khw1566/ARD/docs/3d-models.md

# ARD 3D 모델 자료 안내

[프로젝트 소개로 돌아가기](../README.md)

## 먼저 열 자료

- **조립·형상 확인:** [ARD_Model_v2.stl](<../영상제작용 CAD파일/ARD_Model_v2.stl>)
- **Inventor 편집:** [ARD_Model_v2.iam](../ARD_Model_v2.iam), 관련 부품은 [ARD_hardware](../ARD_hardware)에 보관
- **전체 조립 이미지:** [완전 조립품](<../영상제작용 CAD파일/완전 조립품.png>)
- **기구학 설명:** [README의 3D 모델링과 기계 구조](../README.md#3d-모델링과-기계-구조)

STL의 단위는 사용자가 확인한 **mm**입니다. STL에는 단위 메타데이터가 없으므로 가져오기 설정에서 mm를 지정합니다. 전체 조립 STL은 391,246개 삼각형으로 이루어지며 좌표축별 외곽 크기는 약 502.47 × 440.00 × 594.50 mm입니다.

`.iam`은 Inventor 조립체이며 참조하는 `.ipt`·하위 `.iam`이 필요할 수 있습니다. 현재 자료는 독립 실행이 보장된 Pack and Go 패키지가 아니므로 참조 누락 시 저장소 안의 부품 경로를 지정합니다. STL은 형상 교환용 메쉬로, 원래의 피처 이력·조립 구속조건·재질 정보를 모두 보존하지 않습니다.

## 전체 구조와 레일

| 파일 | 확인할 내용 |
|---|---|
| [전체 조립 STL](<../영상제작용 CAD파일/ARD_Model_v2.stl>) | 카메라 지지대·플레이트·구동부·레일·분류함 배치 |
| [박스 제거](<../영상제작용 CAD파일/박스제거.stl>) | 분류함을 제외한 기계 구조 |
| [비전캠 제거 모델](<../영상제작용 CAD파일/비전캠 제거 모델.stl>) | 카메라 구조를 제외한 분류장치 |
| [비전 캠 장치](<../영상제작용 CAD파일/비전 캠 장치.stl>) | 카메라 측 별도 구조 |
| [상부 이송 구조](<../영상제작용 CAD파일/상부이송구조.stl>) | 레일 위에서 이동하는 분류 구조 |
| [하부 이송 구조](<../영상제작용 CAD파일/하부이송구조.stl>) | 하부 레일·지지 구조 |
| [베벨기어 구조 제외 모델](<../영상제작용 CAD파일/베벨기어 구조가 제거된 나머지 부분들.stl>) | 중앙 차동 구동부 주변 구조 |

## 차동 베벨기어

| 파일 | 확인할 내용 |
|---|---|
| [베벨기어 조립체](<../영상제작용 CAD파일/베벨기어 조립체.stl>) | 중앙 기어의 조립 관계 |
| [베벨기어만](<../영상제작용 CAD파일/베벨기어만.stl>) | 기어 구조 형상 |
| [베벨기어와 플레이트](<../영상제작용 CAD파일/베벨 기어 및 플레이트.stl>) | 출력 기어와 플레이트의 연결 |
| [구동축·베벨기어·접시](<../영상제작용 CAD파일/구동축 베벨기어와 접시만.stl>) | 축에서 플레이트까지의 형상 |
| [중심 십자 조인트](<../영상제작용 CAD파일/베벨기어 중심 십자조인.stl>) | 기울임을 따르는 중앙 지지부 |
| [양측 베벨기어](<../영상제작용 CAD파일/양측 베벨기어만.stl>) | 마주 보는 두 입력 기어 |
| [A측 베벨기어](<../영상제작용 CAD파일/한방향 베벨기어만(A).stl>) | 입력 A측 형상 |
| [B측 베벨기어](<../영상제작용 CAD파일/한방향 베벨기어만(B).stl>) | 입력 B측 형상 |
| [단일 베벨기어](<../영상제작용 CAD파일/단일 베벨기어.stl>) | 개별 기어 형상 |
| [상단부](<../영상제작용 CAD파일/베벨기어 상단부.stl>) | 상부 기어 형상 |
| [하단부](<../영상제작용 CAD파일/베벨기어 하단부.stl>) | 하부 기어 형상 |

기구학 리그는 십자 조인트가 캐리어의 기울임을 따르고, 플레이트 출력부는 그 안에서 별도로 선회하도록 구성했습니다. 메쉬를 합쳐 볼 때는 이 부품들의 원래 좌표를 유지해야 조립 위치가 맞습니다. 서로 겹치는 범위의 내보내기 파일도 있으므로 모든 STL을 동시에 불러오면 중복 형상이 생길 수 있습니다.

## 유성감속기

| 파일 | 확인할 내용 |
|---|---|
| [유성기어 감속기](<../영상제작용 CAD파일/유성기어 감속기.stl>) | 감속기 전체 형상 |
| [커버·베어링 제거](<../영상제작용 CAD파일/커버와 베어링이 제거된 감속기.stl>) | 내부 기어와 캐리어 배치 |
| [조립품에서 가져온 감속기](<../영상제작용 CAD파일/조립품에서 가져온 원점유지 감속기.stl>) | 전체 조립 좌표를 유지한 감속기 |

잇수 16/16/48, 링 고정·태양 입력·캐리어 출력에서 감속비는 4:1입니다. STL 자체에는 운동 관계가 들어 있지 않습니다. 브라우저 시각화의 운동 계산은 [planetary_rig.js](../output/ard-cg/planetary_rig.js)와 [differential_rig.js](../output/ard-cg/differential_rig.js)에 분리돼 있습니다.

## 도면 이미지와 단면

| 자료 | 용도 |
|---|---|
| [평면도](<../영상제작용 CAD파일/평면도.png>) | 레일과 분류함 배치 확인 |
| [좌측면도](<../영상제작용 CAD파일/좌측면도.png>) | 측면 높이·구조 확인 |
| [조립품 측면도](<../영상제작용 CAD파일/조립품 측면도.png>) | 전체 측면 배치 |
| [측면 상세](<../영상제작용 CAD파일/조립품 측면도 상세.png>) | 양측 감속기와 중앙 조인트 확인 |
| [전도 자세](<../영상제작용 CAD파일/전도 과정 작동모습.png>) | 플레이트 기울임 자세 확인 |
| [CAD 기반 단면 시각화](../output/ard-cg/cinematic_section.jpg) | 감속기에서 차동부로 이어지는 전달 경로 |

브라우저에서 보는 방법은 [README의 실행 안내](../README.md#cad-기반-3d-시각화)를 따릅니다. CG의 색·단면·화살표는 설명을 위한 시각화이며 제조 도면의 재질·가공 지시가 아닙니다. 실제 제작 공차, 기어 접촉, 부품 간 간섭과 하중 검증은 별도 확인 대상입니다.
