khw1566/ARD/output/ard-cg/제작현황_기구학_추가자료.md

# AI기반 자동화 분류장치 — CG 제작 현황

2026-10-26. 사용자 지정 CAD는 `ARD_Model_v2.iam`이며, 제공 STL 단위는 mm로 확인됐다. CG 2분 15초를 먼저 제작한 뒤, 최신 요청으로 자기소개와 제공 실물 시연을 연결한 3분 발표 영상까지 출력했다.

## 결과물

- **최신 v2:** `final/ARD_FullPresentation_1080p_v2.mp4`, 180초·1080p/30fps. 재생: http://127.0.0.1:5187/review_v2.html . 화면 자막을 나레이션의 표기형 대본으로 통일하고 임베디드 자막은 제거했다. PC 모니터의 이메일·채팅 화면을 가리고 크레딧은 마무리에 한 번만 표시한다.
- 종이색 정보판·IBM Plex 서체로 개편하고 영어 키커·페이지 카운터·진행 바·리더선을 제거했다. 레일 30mm 이송 → 선회 → 기울임 → 중립 → 레일 복귀를 분리했다. 기존의 4:1 감속비와 차동 관계는 보존했다. 자세한 기록은 `HANDOFF.md` 상단과 `results/261026_발표영상_v2_피드백반영.md`를 읽는다.

- 새 미리보기: http://127.0.0.1:5187/cinematic.html
- 유성기어 자전·공전: http://127.0.0.1:5187/cinematic.html?t=38&still=1
- 차동 기어 확대: http://127.0.0.1:5187/cinematic.html?t=68&still=1
- 135초·15장면 CG 타임라인. 감속기 설명은 27–57초의 30초다. myTTS 합성 목소리·BGM·효과음이 들어간 `final/ARD_CG_MyVoice_1080p.mp4`를 별도 보존한다. CG 실제 음성 대본은 `CG_개인TTS대본_v4.txt`다.
- 최신 전체 결과: `final/ARD_FullPresentation_1080p.mp4`, 180초·1080p·30fps. 소개 13초, 기존 CG 8–129초 구간 121초, 보정 실물 42.267초, 마무리 3.733초다. 재생 페이지는 http://127.0.0.1:5187/review_full.html 이다.
- 실물만의 결과: `final/ARD_LiveDemo_Stabilized_1080p.mp4`, 약 42.3초. 자막은 손·터치 화면·중앙 기어를 가리지 않는 상단에 표시했다. 소개 및 실물 설명은 같은 로컬 myTTS 모델로 추가 합성했다.
- 흔들림 보정은 FFmpeg vidstab 2회 처리와 고정 확대 약 1.8%를 적용했다. 고정 배경 추적에서 좌우 이동 경로의 미세 흔들림 RMS는 약 49.9% 감소했다. 회전 흔들림은 비슷한 수준으로 남아 있으므로 완전한 고정 시점으로 설명하지 않는다.
- 두 완성본 모두 전체 디코딩, 프레임 수, 해상도, 음량, 한국어 자막 시간, 원본 해시 검사를 통과했다. `final/presentation_quality_report.json`에 수치를 보존한다. 원본 영상은 변경하지 않았다. 자세한 편집 기록은 `results/261026_실물영상_보정_자기소개_통합.md`를 읽는다.
- 완성 영상 재생: http://127.0.0.1:5187/review.html
- 장면 선택 메뉴로 각 장면의 설명 자세를 확인할 수 있다. 재생하면 각 입력각과 출력 자세가 시간에 따라 변한다.
- 원본 CAD·STL·펌웨어는 수정하지 않았다. 별도의 미리보기용 메쉬와 코드를 `output/ard-cg`에 작성했다.
- 빌드·펌웨어 실행 없이 STL 분석, 일반 JavaScript와 브라우저 렌더링으로 작업했다.

## 이번 스타일 수정

### 2026-10-26 후속: 중앙 십자 조인트 분리

사용자가 십자 조인트까지 출력부와 통으로 회전하는 문제를 제보했다. 새로 제공된 `베벨기어 중심 십자조인.stl`, `베벨기어 상단부.stl`, `베벨기어 하단부.stl`을 기존 조립체의 면과 정확히 대조해 중앙 조인트·상부 출력·하부 기어를 분리했다. 연결된 메쉬 섬의 위치만으로 구동 부품을 추정하던 방식은 사용하지 않는다.

- 중앙 십자 조인트: 4,646면. 캐리어에 고정되어 `R_X(φ)` 기울임만 따른다.
- 상부 출력: 21,102면. 캐리어 안에서 `R_Y(ψ)` 선회하며 플레이트도 함께 선회한다.
- 하부 기어: 21,102면. 캐리어 안에서 `R_Y(-ψ)`로 회전한다.
- A/B 입력: 각 21,904면. 기존 조립체의 입력축 면을 유지한다. 별도 A/B STL은 치형의 초기 위상이 달라 직접 섞지 않는다.
- 다섯 부품의 합은 기존 조립체 90,658면 전체와 일치하며 중복 면은 없다. 원본 CAD/STL을 수정하지 않았다.

구조는 `root → carrier(기울임) → cross / output(선회) → plate`이며, `bottom`도 carrier의 자식이다. `differential_rig.js`를 실제 장면과 Node 검사에서 함께 사용한다. 검사 명령은 `node output/ard-cg/verify_differential.cjs`이며 C/C++ 컴파일이나 앱 빌드를 하지 않는다. 유성감속기의 감속비는 아래 후속 답변으로 확인됐으며, 베벨 축 부호·기어 접촉에 관한 미확정 사항은 유지한다.

### 2026-10-26 후속: 유성감속 설명과 카메라 개편

사용자가 태양기어 16 / 행성기어 16 / 링기어 48, 링 고정, 태양 입력, 캐리어 출력을 직접 확인했다. 감속비는 `i = 1 + 48/16 = 4`다. 기존 감속기 단일 정적 메쉬를 실제 CAD의 12개 역할 묶음으로 분리하고, 태양기어·행성기어 자전·캐리어 공전을 각자 구동한다. 원본 80,230면의 좌표·면과 초기 치형 위상은 보존한다.

- 27–34초: 부품 분해 사선 구도, 색상·지시선으로 고정/입력/출력 식별.
- 34–43초: 축 정면 고정 구도, 자전 표시점과 공전 궤적으로 두 운동 구분.
- 43–51초: 같은 정면 구도에서 입력·출력 회전수와 바늘을 함께 비교.
- 51–57초: 사선 출력축 구도로 전환하고 입력 4.00회전·출력 1.00회전 및 감속식 표시.
- A/B 단독은 같은 고정 시점, 선회는 상부 고정 시점, 기울임은 낮은 측면 고정 시점으로 변경했다. 도입부 크레인, 시스템/레일 트래킹, 복합 입력의 짧은 사선 이동을 구분하고 반복적인 장면별 후진 줌을 없앴다.
- 시스템 역할·동력 경로·십자 조인트·분류 순서를 별도 보조 패널과 단계 강조로 보강했다. 점·궤적·캐리어 연결선은 설명용 오버레이다.

`node output/ard-cg/verify_planetary.cjs`는 실제 STL 면 보존과 10개 운동 사례, 15개 장면에 걸친 541개 시간 표본의 유한한 카메라·자세 값을 검사한다. 이 시간 표본 검사는 렌더링 프레임 검사가 아니다. 브라우저에서는 15개 장면의 대표 시점을 별도로 확인했다. 실제 치합·백래시·효율·하중은 미검증이다.

사용자는 Blue Paw Print에서 배경·재질·단면 표현을 참고하되 그대로 따라 하지 말라고 지정했다. 참고 채널과 `Inside the King Tiger`의 공개 재생 화면을 확인했다. 이번 구성은 장치에 맞춘 별도의 스튜디오 배경, 조명, 금속·수지 재질과 입력축 색상 체계를 사용한다. 참고 영상의 모델·텍스처·로고·음원은 가져오지 않았다.

- 밝은 문서형 화면을 대신해 깊이가 보이는 스튜디오 바닥·배경과 따뜻한 주광·차가운 보조광을 적용했다.
- 브러시드 금속, 수지 표면의 절차적 질감, 표면 반사와 그림자를 추가했다.
- STL 곡면의 음영을 보완하되 기어 치형과 테두리의 날카로운 경계는 유지했다. 실제 삼각형의 위치·크기는 바꾸지 않았다.
- 외피 단면으로 감속기·차동 기어를 드러내고, 기어 맞물림을 확대하는 구도로 전환한다.
- 외피를 절단한 면에는 별도의 단면 해칭을 적용한다. 내부 기어는 절단하지 않아 입력·출력의 맞물림을 계속 볼 수 있다.
- 모터 A 입력 계열은 황동색, B 입력 계열은 청색으로 구분한다. 설명을 위한 색상이며 실물 재질·색상의 측정 결과는 아니다.
- 기어 상세 설명 때에는 접시를 숨겼다가 카메라를 뒤로 빼며 다시 표시한다. 내부 전달과 최종 자세를 이어서 볼 수 있다.
- 원형 접시는 회전해도 외형이 같아 보일 수 있어, 확대 장면에 선회 방향을 보여주는 설명용 화살표를 겹쳐 표시한다. CAD에 실제 부품을 추가한 것은 아니다.

## 새 CG 구성

| 시간 | 장면 | 설명 |
|---|---|---|
| 0:00–0:08 | 전체 장치 | 크레인 구도, 장치 도입 |
| 0:08–0:17 | 시스템 역할 | 카메라 → PC 분석 → DriveMCU → 모터 |
| 0:17–0:27 | 외피 단면 | 고정 사선 시점에서 전달 경로 노출 |
| 0:27–0:34 | 감속기 네 요소 | 분해도, 입력·고정·출력 구분 |
| 0:34–0:43 | 자전과 공전 | 정면 고정, 표시점과 공전 궤적 |
| 0:43–0:51 | 입력·출력 비교 | 바늘과 회전수 계기로 4:1 비교 |
| 0:51–0:57 | 감속비 | 입력 네 바퀴·출력 한 바퀴, 감속식 |
| 0:57–1:04 | 차동 기구 확대 | 십자 조인트와 출력축의 역할 |
| 1:04–1:13 | A만 구동 | 동일한 고정 시점에서 선회·기울임 확인 |
| 1:13–1:22 | B만 구동 | A 단독과 같은 고정 시점에서 부호 비교 |
| 1:22–1:32 | 같은 입력 | 상부 시점에서 선회 확인 |
| 1:32–1:42 | 반대 입력 | 낮은 측면 시점에서 기울임 확인 |
| 1:42–1:55 | 복합 입력 | 목표 자세에서 입력각 계산 |
| 1:55–2:09 | 레일과 선별 순서 | 이송·선회·전도·복귀 |
| 2:09–2:15 | 전체 장치 복귀 | 실제 시연에 이어 붙일 전환 장면 |

## 기구학 모델의 정의

현재 PC 코드의 `gearAngleX = yawAngle + rollAngle`, `gearAngleY = yawAngle - rollAngle` 관계와 CAD의 마주 보는 입력축 구조를 기준으로 한다.

- `θA`, `θB`: 모터 각도. 실물 축의 양의 방향을 확인해 같은 제어 기준으로 정규화한다.
- `iA`, `iB`: 각 감속기의 입력각/출력각 비.
- `a = θA / iA`, `b = θB / iB`: 감속 후 베벨 입력축의 정규화된 각도.
- `ψ`: 플레이트의 자기 축 주위 선회각.
- `φ`: 공통 입력축 주위 기울임각.

동일한 베벨기어비를 갖는 이상적인 기구 모델은 다음과 같다.

```text
ψ = (a + b) / 2
φ = (a - b) / 2

역기구학:
a = ψ + φ
b = ψ - φ

모터 목표각:
θA = iA × (ψ + φ)
θB = iB × (ψ - φ)
```

| 정규화된 입력 | 출력 |
|---|---|
| a=q, b=0 | ψ=q/2, φ=q/2 |
| a=0, b=q | ψ=q/2, φ=-q/2 |
| a=q, b=q | ψ=q, φ=0 |
| a=q, b=-q | ψ=0, φ=q |

두 모터는 마주 보므로 각 모터를 정면에서 보았을 때의 시계·반시계 방향을 단순히 ‘같은 방향’이라고 부르지 않는다. 영상의 A/B 입력은 정규화된 제어 부호를 뜻한다. 현재 CG의 고정 좌표 X는 입력축, Y는 중립 상태의 출력축이다. 출력 자세는 입력축 기울임 뒤 출력축 자체 선회를 표현하는 `R_X(φ) R_Y(ψ)`로 구성했다.

시각화는 강체·동일 베벨기어비·이상적인 전달을 가정한다. 유성감속기의 4:1 구성은 사용자 확인값이며, 실제 설치된 베벨 축 부호, 치형의 접촉·백래시·하중·탈조는 이번 미리보기로 검증하지 않았다. 애니메이션의 예시 각도를 실제 운전 범위나 측정 성능으로 주장하지 않는다.

## 첨부 자료 확인과 활용

- 전체 조립품·박스 제거·비전캠 제거·상하부 이송부 STL을 확인했다.
- 추가된 `한방향 베벨기어만(A).stl`, `한방향 베벨기어만(B).stl`, `양측 베벨기어만.stl`, `구동축 베벨기어와 접시만.stl`로 입력·출력 부품의 역할을 확인했다.
- 기존 전체 조립 상태와 좌표·면이 일치하는 메쉬를 분리해 A/B 입력, 출력축·중앙 연결부, 반대편 기어, 접시를 각각 구동한다. 별도 내보내기 사이에 미세한 자세 차이가 있어 한 조립 상태의 면 집합을 기준으로 맞췄다.
- `조립품에서 가져온 원점유지 감속기.stl`이 추가된 것을 확인했다. 별도 유성기어 감속기 파일은 원점이 달라 전체 조립체에 그대로 중복 배치하지 않는다.
- 감속기 참고 영상 두 개와 `리니어 스크류 구동.mp4`의 재생 정보와 프레임을 확인했다. 이들은 구조 참고 자료이며 완성 영상에 그대로 삽입한 촬영본은 아니다.
- 상세 목록·경계 좌표·파일 유효성은 `cad_inventory.json`, 영상 정보는 `video_inventory.json`에 기록했다.

## 추가로 필요한 정보

추가 CAD는 지금 바로 필요하지 않다. 다음 정보가 있으면 기구학 설명의 실제 축 부호·수치를 확정할 수 있다.

1. **모터 방향 확인:** A만 양의 명령, B만 양의 명령, 두 축 같은 부호, 두 축 반대 부호일 때 플레이트가 움직이는 방향. 짧은 CAD 구동 영상이나 화살표를 그린 그림으로도 충분하다.
2. **베벨기어비:** 유성감속기의 잇수 16/16/48과 4:1 구성은 확인 완료. 차동 베벨기어의 잇수·기어비와 각 축 설치 부호는 추가 확인 대상이다.
3. **개인 TTS:** 로컬 myTTS 모델로 15컷의 합성과 음량·길이 맞춤을 완료했다. 발음과 편집 수정 시 최신 v4 대본 및 `narration/manifest.json`을 기준으로 한다.

## 설치된 제작 스킬

- `remotion-best-practices`: Remotion 제작사 공식 스킬. https://github.com/remotion-dev/skills
- `3dmodel`: 3D 메쉬·재질·분해도·단면·화면 검수를 위한 스킬. https://github.com/fletcherholt/3dmodel-skill

설치 경로와 확인 해시는 `skill_install_manifest.json`에 있다. 이번 미리보기는 프로젝트의 빌드 금지 지침을 지키기 위해 별도 앱 빌드가 필요 없는 JavaScript로 구성했다.

## 로컬 미리보기 다시 열기

서버가 종료된 경우 프로젝트 폴더에서 다음 명령으로 미리보기를 열 수 있다. 이 명령은 빌드나 장치 제어를 하지 않는다.

```powershell
python output/ard-cg/prepare_cad.py
python output/ard-cg/serve.py
```

주소: http://127.0.0.1:5187/cinematic.html

참고 원본: https://www.youtube.com/@BluePawPrint / https://www.youtube.com/watch?v=vCgdYHatDqw
