khw1566/ARD/results/260914_AwardWinning_Comparison_Report.md

# 작년 수상작 심층 분석 및 중간보고서 개선 전략 비교 보고서
작성일자: 2026-09-14
작성자: 김형우

## 1. 개요 및 분석 배경
대한기계학회 전국학생설계경진대회 최종보고서 작성을 위해, 전년도(제15회) 대학부 주요 수상작 3편의 구성 및 서술 방식을 정밀 분석하였다. 이를 현행 작성된 중간보고서(`중간보고서_울과대 그린머신_김형우.pdf`)와 비교하여 최종보고서 양식(규격) 충족 여부, 기술적 완성도, 정량적 데이터 검증 측면에서의 개선점을 도출하였다.

## 2. 작년 수상작 3편의 핵심 특징 분석

### 2.1 수상작 기본 개요
- **대학-01 (30쪽)**: `3D 프린팅 서포트 감축을 위한 다층적 지지 시스템`
  - 특징: 래칫(Ratchet) 메커니즘 기반 기구학적 설계와 Fusion 360 타당성 평가, 서포트 절감량(%) 정량 비교.
- **대학-02 (57쪽)**: `그리핑-반전 메커니즘 기반 컵라면 용기 전처리 및 자동 분류 시스템`
  - 특징: 베벨 기어/유성 기어 유닛 기반 기구학적 수식 전개, 전단응력 계산 및 Ansys 구조 해석, 3단계 송풍 세척 정량 실험, 용기 크기별(Small/Middle/Big) 분류 테스트.
- **대학-03 (27쪽)**: `엣지 AI 기반 유아용 카시트 시스템 개발: 상지 이탈 감지 및 스마트 제어`
  - 특징: 선행 특허 정밀 비교표(Table), 로드셀 하네스 응력 해석(FEA), 경계조건($2828\text{ N}$) 기반 안전계수 도출, AI 모델 파이프라인(YuNet + MobileFaceNet) 학습 곡선 및 재현율($97\%$) 제시.

### 2.2 공통적으로 나타나는 수상작의 5대 핵심 강점
1. **철저한 선행 특허 및 기존 제품 조사 (Patent Survey & Differentiation)**:
   - 단순히 시장 상황을 언급하는 것에 그치지 않고, `특허 출원/등록 번호`, `기존 해결책의 물리적 한계`, `본 설계의 기술적 회피 및 독창성`을 표(Table)로 명확히 대조.
2. **이론적 기구학 수식 전개와 CAE 구조해석의 유기적 결합**:
   - 모터 선정 토크 수식($\tau_{req} \le \tau_{out}$), 전단응력 수식, 운동방정식 등 기계공학적 수식을 체계적으로 유도.
   - Ansys 또는 Fusion 360을 활용한 Von-Mises 응력 분포, 변위량(Deformation), 안전율(Safety Factor) 해석 데이터를 컬러 컨투어로 제시.
3. **정량적 실험 설계 및 성능 지표(KPI) 입증**:
   - 실험군과 대조군을 설정하고, 반복 측정 오차율, 분류 성공률, 반응 속도(ms)를 표와 그래프로 제시.
4. **엄격한 학술대회 규격 준수**:
   - 캡션 표기 원칙(모든 `Table`, `Figure` 캡션은 완전한 영문 작성).
   - 참고문헌 상첨자 인용($^{(1)}$, $^{(2\sim4)}$) 표기.
5. **경제성 및 상용화 타당성 분석**:
   - 시제품 제작 단가(BOM: Bill of Materials) 분석 및 기존 상용 장비 대비 원가 절감 효과 기술.

---

## 3. 현행 중간보고서 현황 및 한계점 분석

| 평가 항목 | 현행 중간보고서 수준 | 취약점 및 개선 필요 사항 |
| :--- | :--- | :--- |
| **분량 및 구조** | 총 21쪽 (본문 내용 압축적) | 수상작 대비 상세 기구 도면, 분해 조립도, 부품 리스트의 서술 비중 부족 |
| **선행 특허 분석** | 2개 상용 제품(Fig 1, 2) 단순 인용 | 키프리스(KIPRIS) 기반 유사 특허 번호 명시 및 세부 청구항 비교 분석 부재 |
| **기구학 및 구조해석** | 차동 베벨 기어 토크 기본 수식 기재 | 유한요소해석(FEA) 응력/변형 해석 데이터 부재, 기어 치형 접촉 강도 해석 미비 |
| **소프트웨어/AI 서술** | Gemini 멀티모달 개념적 설명 위주 | 실제 5개 MCU 분산 네트워크, UDP 분할 패킷 구조, Three.js 트윈 등 고도화된 기술 미반영 |
| **실험 및 검증** | 완성 시제품 사진 및 동작 결과 부재 | 크기/재질별(PET, 캔, 유리 등) 정량적 분류 성공률, 인식 지연시간(Latency) 데이터 부재 |
| **양식 규격 준수** | 일부 국문/영문 혼용 캡션 존재 | 최종보고서 필수 요건인 영문 캡션(Fig. / Table) 통일화 및 상첨자 인용 보완 필요 |

---

## 4. 최종보고서 작성을 위한 핵심 개선 전략

### 4.1 1단계: 선행 기술 및 특허 조사 보강 (설계핵심내용 2.1)
- 국내외 자동 분리수거 및 그리핑 특허 3~4건을 조사하여 `Table 1. Patent survey and technological differentiation` 작성.
- 기존 바코드/광학 센서 방식 대비 멀티모달 AI(Gemini)와 차동 턴테이블의 경제성/범용성 우위 부각.

### 4.2 2단계: 기구학 수식 전개 및 CAE 구조 해석 데이터 탑재 (설계핵심내용 2.2~2.3)
- **차동 베벨 기어 기구학 전개**:
  - 두 모터의 각속도($\omega_1, \omega_2$)에 따른 디스크의 합성 틸트 각속도($\dot{\theta}_{roll}$) 및 요 각속도($\dot{\theta}_{yaw}$) 수식화.
- **구조 안정성 유한요소해석(FEA)**:
  - 폐기물 최대 적재 하중($1.5\text{ kg}$) 조건에서 메인 프레임 및 베벨 기어 축의 최대 휨 응력과 안전율 도출.

### 4.3 3단계: 임베디드 분산 제어 및 3D 디지털 트윈 체계 전면 수록 (설계핵심내용 2.4)
- 요약파일에 정리된 5대 MCU(ImageSender, Drive, HMI, Control, Robot3Axis) 펌웨어 아키텍처와 TCP/UDP/SSE 통신 파이프라인 수록.
- Three.js WebGL 기반 디지털 트윈 텔레포테이션 기술을 수록하여 소프트웨어 완성도 극대화.

### 4.4 4단계: 정량적 실험 결과 및 토의 체계화 (3. 결과 및 토의)
- **객체 인식 및 분류 실험**:
  - 알루미늄 캔, 투명 페트, 찌그러진 캔, 종이 등 비정형 물체에 대한 인식 성공률($\%$) 및 추론 시간(ms) 데이터 표 수록.
- **위치 추적 및 제어 정밀도**:
  - A-GPS(AssistNow) 적용 전/후의 위성 수신 시간(TTFF) 비교 그래프(수 분 $\rightarrow$ 수십 초 단축).
- **제작 비용 및 경제성 분석**:
  - 시스템 제작 원가표(BOM) 및 상용 장비 대비 도입 비용 비교.

### 4.5 5단계: 양식 가이드라인 100% 준수
- 모든 그림/표 캡션을 완전한 영문 표기(`Fig. X. ...`, `Table X. ...`)로 전환.
- 본문 참고문헌 인용 표기 상첨자화($^{(1)}$, $^{(2\sim4)}$) 적용.
