khw1566/ARD/results/260914_Report_Execution_Plan.md

# 보고서 작성 종합 실행 계획서
작성일자: 2026-09-14
작성자: Antigravity

## 1. 개요
본 계획서는 경진대회 및 학술대회 제출용 최종 보고서 작성을 위해 수립된 8단계 순환 및 점검 프로세스 가이드라인입니다.

## 2. 세부 단계별 실행 계획

### 1단계: 내부 기술 자료 및 데이터 정리
- **목적:** 하드웨어, 제어 펌웨어, PC 관제 소프트웨어(Three.js 디지털 트윈 등)의 핵심 스펙과 구현 내용 취합
- **주요 작업:**
  - `대한기계학술회 보고서/요약파일/` 내 모듈별 기술 문서(펌웨어, 3축 제어, 3D 디지털 트윈 등) 데이터 검토 및 정량 수치 정리
  - 시스템 구성도 블록도, 회로도, 실측 계측 데이터 셋 확보

### 2단계: 보고서 공식 양식 및 기수상작 분석 학습
- **목적:** 평가 기준, 필수 목차, 수상작 서술 패턴 및 시각화 기법 벤치마킹
- **주요 작업:**
  - 대회 지정 서식(페이지 제한, 폰트, 여백 규정 등) 준수 항목 파악
  - 기존 기수상작 비교 보고서([260914_AwardWinning_Comparison_Report.md](file:///c:/Users/khw/Desktop/ARD_v1/results/260914_AwardWinning_Comparison_Report.md)) 내용 반영 및 논리 전개 패턴 차용

### 3단계: 특허 선행기술 조사 및 기술적 차별성 정리
- **목적:** 독창성 증명 및 선행 특허 대비 개선점 명확화
- **주요 작업:**
  - 기존 특허 분석 보고서([260914_Patent_Analysis_and_Differentiation.md](file:///c:/Users/khw/Desktop/ARD_v1/results/260914_Patent_Analysis_and_Differentiation.md)) 데이터 검증
  - 기존 특허들의 구조적/제어적 한계점 대비 본 프로젝트 시스템의 우위 요소(정밀도, 비용, 관제 효율성 등) 비교표 구체화

### 4단계: 보고서 목차 및 초안 프레임워크 작성
- **목적:** 보고서의 전체 뼈대 구성 및 시각화 배치 계획 수립
- **주요 작업:**
  - 대목차/중목차/소목차 구조 확정
  - 시각 자료 배치 레이아웃 정의 (회로도, 블록도, 3D 디지털 트윈 화면 캡처, 그래프, 실물 사진 등 위치 결정)
  - 본문 각 장별 핵심 서술 방향 가이드라인 수립

### 5단계: 세부 내용 작성(사용자) 및 실시간 피드백·교정(에이전트)
- **목적:** 초안 완성도 제고 및 논리적 완결성 확보
- **주요 작업:**
  - 사용자의 목차별 세부 내용 기술
  - 에이전트의 실시간 기술 검토: 문맥 매끄러움, 학술적/기술적 표현 교정, 용어 표준화, 논리적 비약 구간 보강 제시

### 6단계: 중간 점검 및 결손 데이터/자료 보완
- **목적:** 누락된 실험 결과치, 도면, 결함 데이터 파악 및 추가 작성
- **주요 작업:**
  - 정량적 성능 지표(오차율, 응답속도, 처리량 등) 누락 여부 확인
  - 추가 필요한 다이어그램 및 보충 설명 보완

### 7단계: 4단계 피드백 루프(목차 및 프레임워크 재조정)
- **목적:** 작성된 실 데이터를 바탕으로 전체 문서 흐름과 이미지 재배치
- **주요 작업:**
  - 서술 분량 밸런스 점검 및 목차/소제목 재편
  - 강조해야 할 핵심 성과와 도식의 위치 재최적화

### 8단계: 최종 점검 및 완성
- **목적:** 최종 제출용 문서 결함 제거 및 제출 형태 확정
- **주요 작업:**
  - 규격 준수 여부(페이지 수, 도표 캡션 번호, 참고문헌 양식 등) 확인
  - 오탈자, 단위 표기 오류, 정렬 상태 최종 검수
  - 최종본 산출물 패키징

## 3. 진행 현황 체크리스트
- [ ] 1. 자료 정리
- [ ] 2. 보고서 양식 및 작년 수상작 학습
- [ ] 3. 특허 관련 자료조사 및 비교점 정리
- [ ] 4. 보고서 목차 및 초안틀 작성(이미지 삽입 결정)
- [ ] 5. 보고서 세부작성(사용자) 및 피드백/교정(에이전트)
- [ ] 6. 점검 및 부족한 자료 작성
- [ ] 7. 목차/틀 재보완(루프)
- [ ] 8. 최종 점검 및 완성
