khw1566/ARD/AGENT_HANDOFF.md

# 에이전트 인수인계 — ARD 작업 환경 이전

작성일: 2026-10-26, 한국 시간 기준.

## 먼저 지킬 사항

1. 루트 `AGENTS.md`를 먼저 읽는다. **에이전트는 펌웨어·앱·시뮬레이터·C/C++ 호스트 테스트를 빌드하지 않는다.** 다른 스크립트나 에이전트로 우회하지 않는다. 필요한 빌드 명령은 사용자에게 주고 사용자가 반환한 결과를 진단한다.
2. 현재 작업은 **AI기반 자동화 분류장치의 기술 원리 설명 CG 제작**이다. 그리퍼·3축 로봇은 이번 영상에 사용하지 않는다.
3. 이전 시 사용자는 **“문제가 있는데 일단 작업환경을 옮길 것”**이라고 했다. 2026-10-26 후속 작업에서 **십자 조인트가 별도 부품으로 분리되지 않아 출력부와 함께 선회하는 문제**로 확인됐다. 제공된 추가 STL로 분리하고 캐리어 기울임과 출력축 선회를 나눴다. 아래 CG를 최종 승인·완성·실물 검증된 결과로 취급하지 않는다. 후속 변경은 `results/261026_CG_십자조인트_분리수정.md`를 읽는다.
4. 이 스냅샷에는 다른 작업에서 진행한 펌웨어·PC·기구 CAD 변경도 포함한다. 영상 작업 중 에이전트가 만든 변경으로 혼동하거나 임의로 되돌리지 않는다.
5. 최신 사용자 작업 정책: 일반 파일·코드·로컬 설정 작업은 사전 확인 없이 수행한다. 프로덕션·외부 배포, 극단적 대규모 병합·대량 삭제에는 확인을 받는다. 시스템의 도구 권한 절차와 위 빌드 금지는 계속 적용한다.
6. 후속 피드백으로 반복적인 카메라와 부족한 감속기 설명을 보강했다. 사용자가 **태양/행성/링 잇수 16/16/48, 링 고정, 태양 입력, 캐리어 출력**을 확인했다. 현재 CG는 **135초·15장면**, 감속기 설명은 **27–57초의 30초**다. 상세 내용은 `results/261026_CG_유성감속원리_카메라개편.md`를 읽는다.
7. 이후 사용자가 `C:\Users\work\Desktop\myTTS`의 학습 음성으로 영상 제작을 요청하고 **“빌드 허용할게”**라고 직접 승인했다. 이 대화에서는 기존 빌드 금지보다 해당 최신 승인이 우선한다. 로컬 myTTS 합성·브라우저 프레임 렌더·FFmpeg 인코딩을 수행했다. 최신 음성 대본은 v4, 실제 MP4는 `output/ard-cg/final/ARD_CG_MyVoice_1080p.mp4`다. 개인 음성·다운로드 음원·영상 중간 결과와 최종 출력은 Git 제외 경로에 보존한다.
8. 최신 요청으로 `영상제작용 CAD파일/20261026_195051.mp4`의 흔들림을 보정하고 사용자 목소리 설명·한국어 자막을 넣었다. **현재 최신 완성본은 `output/ard-cg/final/ARD_FullPresentation_1080p.mp4`(정확히 180초)**다. 자기소개 13초 → 기존 CG 8–129초 구간 121초 → 실물 42.267초 → 마무리 3.733초로 연결했다. 실물만의 완성본은 `ARD_LiveDemo_Stabilized_1080p.mp4`다. `/review_full.html`에서 두 영상을 재생한다. 상세 기록은 `results/261026_실물영상_보정_자기소개_통합.md`를 읽는다. 원본 촬영본과 기존 135초 CG는 보존했다.
9. 이후 사용자가 `output/ard-cg/HANDOFF.md`의 새 피드백 작업을 이어 달라고 요청했다. 현재 최신 결과는 **`output/ard-cg/final/ARD_FullPresentation_1080p_v2.mp4`**이며 `/review_v2.html`에서 재생한다. 자막 중복·문장 불일치, 모니터 개인정보 노출, 중복 크레딧, 레일/자세 동시 동작, 템플릿형 화면 요소를 수정했다. v1을 덮어쓰지 않았다. 최신 세부 인수인계는 위 HANDOFF.md 상단 PC 완료 기록과 `results/261026_발표영상_v2_피드백반영.md`가 우선한다.

## 저장소와 이전 범위

- 원격: `https://github.com/khw1566/ARD`.
- 작업 브랜치: **`ard-v1`**. `main`으로 변경하거나 강제 푸시하지 않는다.
- 이전 시작 시 HEAD: `715f720`. 원격 추적 브랜치보다 3개 앞선 커밋이 있었다. 이번 이전 커밋과 함께 `origin/ard-v1`에 보존한다.
- `ARD_Model_v2.iam`이 사용자가 지정한 기준 조립체다.
- `영상제작용 CAD파일/`에는 사용자가 추가한 STL·PNG·MP4 원본을 포함한다. 현재 확인한 원본 묶음은 약 119 MiB이며 개별 파일은 GitHub 100 MiB 제한보다 작다. 원본 CAD를 재생성 가능한 중간 결과물로 취급하지 않는다.

### 기존 경량화·비공개 제외 규칙 유지

`ARD_software/`, `ARD/`, `tmp/`, `build/`, `managed_components/`, `OldVersions/`, `AIP/`, Python 캐시, 로컬 설정·비밀값, 다운로드 음원 등은 기존 `.gitignore`에 따라 제외한다. `git add -f`로 포함하지 않는다.

- `ARD_MAIN/.remote-access/`: 비밀번호·세션 키·터널 인증 등. 원격 접속 구성은 `ARD_MAIN/REMOTE_ACCESS.md`를 읽고 새 환경에서 별도 설정한다. 인증 파일·비밀값은 GitHub로 이전하지 않는다.
- `.env*`, `ARD_MAIN/backend/board_settings.json`: 새 환경에서 별도 복원·설정해야 한다.
- `.vscode/`, `.vs/`, `.playwright-cli/`, `output/playwright/`: 개인 도구 상태·캐시.
- `output/ard-cg/assets/`: 원본 STL에서 자동으로 생성하는 중간 메쉬.
- `output/ard-cg/preview_*.png`, `output/ard-cg/video_[0-9]_*.png`: 이전 시안·영상 프레임 검사 이미지.

CG 코드·대본·기구학 문서·기록 JSON·최신 JPG 검수 이미지·Three.js 의존 파일은 보존한다. 이 과정에서 로컬 제외 파일을 삭제하지 않았다. 기존에 스테이징돼 있던 변경도 스냅샷에 보존하며, 임의의 기능 정리는 하지 않았다.

## 사용자의 영상 요구 사항

- 정식 이름: **AI기반 자동화 분류장치**.
- 전체 목표 3분. CG 2분~2분 30초, 나머지 실제 작동. 최신 결과는 **자기소개 13초 + CG 121초 + 실물 42.267초 + 마무리 3.733초**로 총 180초다.
- 초기 CG 우선 제작 이후 사용자가 제공한 촬영본을 합쳤다. 개인 TTS는 사용자가 제작한 엔진·음원을 사용한다. 기존 135초 CG는 별도 보존하며, 최신 전체 발표 영상과 혼동하지 않는다.
- 비전 카메라 분석 결과를 PC가 받아 **DriveMCU로 분류**한다. 그리퍼는 없다.
- 초기의 밝은 문서·제품 소개형 화면을 사용자가 “투박하다”고 평가했다.
- **Blue Paw Print를 참고**하되 완전히 따라 하지 않는다. 사용자가 강조한 것은 **배경·텍스처·단면 활용**이다. 참고 영상의 로고·모델·텍스처·음원은 복사하지 않았다.
- 특히 **차동 베벨기어를 확대**해 각 모터 입력축 제어가 플레이트의 선회·기울임으로 어떻게 이어지는지 기구학적으로 설명해야 한다.

## 현재 CG의 주요 파일

| 경로 | 역할 |
|---|---|
| `output/ard-cg/cinematic.html` | 현재 135초·15장면 미리보기 진입점 |
| `output/ard-cg/cinematic.js` | STL 로더, 재질·조명·단면, 기구학 리그, 카메라·타임라인 |
| `output/ard-cg/differential_rig.js` | 중앙 십자 조인트의 기울임과 상하 기어 선회를 분리하는 공통 리그 |
| `output/ard-cg/verify_differential.cjs` | CAD 면 분할과 8개 자세·십자 조인트의 선회 독립성 검사. 빌드 없음 |
| `output/ard-cg/planetary_rig.js` | 고정 링·태양 입력·캐리어 출력의 실제 CAD 리그와 4:1 이상적 운동 |
| `output/ard-cg/planetary_inventory.json` | 80,230면의 역할 분리, 기준 좌표, 사용자 확인 잇수와 연결 구성 |
| `output/ard-cg/cinematic_plan.js` | 15개 장면의 시간·기구 자세·고정 시점·크레인·트래킹 카메라 계획 |
| `output/ard-cg/verify_planetary.cjs` | CAD 보존, 기어 운동식, 541개 시간 표본의 카메라·자세 수치 검사. 빌드 없음 |
| `output/ard-cg/cinematic.css` | 자막·제목·각도 표시·재생 컨트롤 |
| `output/ard-cg/prepare_cad.py` | STL 유효성·경계 검사, 면 집합 비교와 연결 요소 분리, 미리보기 메쉬 생성 |
| `output/ard-cg/serve.py` | 로컬 전용 정적 서버. 기본 `127.0.0.1:5187` |
| `output/ard-cg/requirements.txt` | 메쉬 처리용 NumPy 의존성 |
| `output/ard-cg/vendor/three.min.js` | Three.js r160. 제외된 `tmp/` 대신 이 파일을 사용 |
| `output/ard-cg/vendor/LICENSE.threejs.txt` | Three.js MIT 라이선스 |
| `output/ard-cg/제작현황_기구학_추가자료.md` | 타임라인, 기구학 정의, 자료 상태, 미확정 사항 |
| `output/ard-cg/CG_개인TTS대본_v4.txt` | 현재 실제 합성에 사용한 15장면 대본. v3는 이전 초안, v2는 이전 12장면 기록 |
| `output/ard-cg/final/ARD_CG_MyVoice_1080p.mp4` | myTTS 목소리·음악·효과음을 포함한 135초 1080p/30fps CG. 로컬 Git 제외 결과 |
| `output/ard-cg/final/quality_report.json` | 최종 디코딩·프레임 수·해상도·음량 검사 결과 |
| `output/ard-cg/review.html` | 완성 MP4 로컬 재생 화면 |
| `output/ard-cg/review_full.html` | 최신 3분 전체 발표 및 보정된 실물 시연 재생 화면 |
| `output/ard-cg/make_presentation.py` | 소개·기존 CG·실물 시연 조립, 자막 및 음원 믹싱 |
| `output/ard-cg/verify_presentation.py` | 두 완성본의 전체 디코딩·프레임·음량·자막 시간·원본 해시 검사 |
| `output/ard-cg/final/presentation_quality_report.json` | 180초 5400프레임 및 실물 시연 1268프레임 검사 결과 |
| `output/ard-cg/cad_inventory.json` | 원본 STL 17개 검사 결과. 단위 mm는 사용자 확인 |
| `output/ard-cg/video_inventory.json` | 감속기 참고 영상 2개와 리니어 스크류 영상 정보 |
| `output/ard-cg/cinematic_*.jpg` | 이전 PC에서 검수한 화면. 진단 시 실제 실행 화면과 비교 |
| `results/261026_ARD_3분영상_컷구성_대본.md` | 초기 전체 3분 기획. 현재 CG는 제작현황 문서와 v4 TTS가 우선 |

**주의:** `output/ard-cg/index.html`은 예전 36초 시안이다. 루트 URL만 열고 최신 영상으로 착각하지 말고 `/cinematic.html`을 연다. `verify_preview.cjs`도 이 예전 시안을 검사하는 보조 도구다.

## 새 환경에서 CG 복원

Python 3.10 이상과 WebGL이 가능한 브라우저를 사용한다. Python 3.12에서 작업했다. 저장소 루트에서 실행한다.

```powershell
python -m pip install --only-binary=:all: -r output/ard-cg/requirements.txt
python output/ard-cg/prepare_cad.py
python output/ard-cg/serve.py
```

첫 명령은 사전 빌드된 NumPy 패키지만 허용한다. 호환 패키지가 없으면 소스 컴파일로 우회하지 않는다. 뒤의 두 명령은 Python 스크립트 실행이며 앱·펌웨어 빌드를 하지 않는다.

- 전체: `http://127.0.0.1:5187/cinematic.html`
- 유성기어 자전·공전: `http://127.0.0.1:5187/cinematic.html?t=38&still=1`
- 4:1 감속비: `http://127.0.0.1:5187/cinematic.html?t=54&still=1`
- 차동 베벨기어 확대: `http://127.0.0.1:5187/cinematic.html?t=68&still=1`
- 새 환경에서는 기존 PC의 서버 프로세스·포트·브라우저 탭이 이어지지 않는다.
- `assets/`가 없다는 오류가 나오면 원본 `영상제작용 CAD파일/`이 있는지 확인하고 `prepare_cad.py`를 실행한다.
- Three.js는 저장소에 포함해 네트워크 없이 불러온다. 의존 파일의 해시는 `vendor/README.md`에 있다.
- 선택적인 Node 검수 스크립트는 `playwright` 모듈이 필요하다. 모듈이 다른 위치에 있으면 `ARD_PLAYWRIGHT_MODULE`로 경로를 지정할 수 있다. 이 도구들은 일반 미리보기 실행에 필요하지 않다.
- 기존 `제작현황_기구학_추가자료.md`의 과거 `C:/Users/khw/.cache/...` 명령은 이전 PC 기록이다. 새 환경에서는 위의 일반 `python` 명령을 사용한다.

## 기구학 구현과 아직 확인하지 않은 점

현재 PC 코드의 합·차 관계와 동일 베벨기어비를 갖는 이상적 강체 모델을 사용한다.

```text
a = θA / iA
b = θB / iB
선회 ψ = (a + b) / 2
기울임 φ = (a - b) / 2

역변환: a = ψ + φ, b = ψ - φ
```

여기서 a·b는 **감속 후 베벨 입력축 각도**이며 마주 보는 모터의 부호를 정규화했다. 두 모터를 각자 정면에서 볼 때의 시계·반시계 방향을 무조건 같은 의미로 취급하면 안 된다. 각도는 실제 운전 제한이나 실측 성능이 아니다.

- CAD 좌표의 공통 입력축: X. 중립 상태의 출력축: Y.
- 리그 피벗: 약 `(-217.8659, 83.9029, 88.32)` mm.
- A/B 입력 회전은 각각 `+a`, `-b`를 공통 X축에 적용한다.
- 출력 자세는 `R_X(φ) R_Y(ψ)`, 반대편 베벨기어는 `R_X(φ) R_Y(-ψ)`로 표현한다.
- 원형 접시의 선회를 보이게 하는 황색 화살표는 설명용 오버레이다.
- 플레이트를 숨겨 내부를 확대한 뒤 다시 표시한다. A 단독·B 단독·같은 입력·반대 입력·복합 입력의 다섯 단계를 확인한다.
- 유성감속기의 **16/16/48, 링 고정, 태양 입력, 캐리어 출력과 4:1 감속비**는 후속 사용자 답변으로 확인됐다. **베벨기어 잇수·기어비, 설치된 각 축의 양의 회전 방향**은 여전히 미확정이다. PC·펌웨어의 스텝 변환 상수까지 이번 CG에서 검증하거나 수정한 것은 아니다.
- 기어 접촉·백래시·하중·탈조·실제 분류 성공은 검증하지 않았다. 장치 제어 API와 CG를 연결하지 않는다.
- PC의 3D 상태는 스텝 기반 상태 표시이며, 실제 엔코더 피드백으로 설명하지 않는다. 자동 선별이 ToF 폐루프 보정을 사용한다고 설명하지 않는다.

## 현재까지 수행한 확인

- 원본 STL 17개의 바이너리 크기와 유한 좌표 확인.
- 기존 조립체에서 면 집합을 비교해 원본을 수정하지 않고 메쉬 분리.
- JavaScript 구문 확인, 주요 장면 브라우저 검수. 최신 단면 장면에서 외피 절단면 해칭 확인.
- 브라우저 실행 오류 기록이 비어 있는 것을 확인.
- 후속 작업에서 기존 135초 CG와 최신 180초 전체 발표 영상을 출력하고 전체 디코딩·프레임 수·음량을 검사했다. 최신 결과는 `final/presentation_quality_report.json`과 후속 보고서가 우선한다. 실물 영상은 제공된 수동 조작 시연이며, 자동 분류 성공·하중·엔코더 피드백을 검증한 것은 아니다.

사용자가 제보한 십자 조인트 문제는 후속 수정에서 다루었다. 기존 검수 기록만으로 전체 영상에 문제가 없다고 결론 내리지 않는다.

## 함께 이전하는 기존 개발 변경

이번 CG 대화 이전부터 다른 작업에서 수정된 다음 내용을 보존한다. 이 인수인계 작업에서 해당 펌웨어를 빌드하지 않았다.

- JC1060: Wi-Fi 진단·MAC/DHCP 관련 소스, 게임패드 제거, 마이크 상태·시간 동기화·터치 조이스틱, 스크롤 제거·카메라 전체 이미지 배치.
- PC: 원격 접속 게이트웨이, JC1060 명령 경로·시각 동기화, 관련 Python 검사 소스.
- 기구 CAD: `ARD_Model_v2.iam`, 감속기 조립체, M4 스탠드, 레일 부품 이동·수정.
- 자세한 범위와 미검증 항목은 `results/261026_JC1060_*.md`, `ARD_MAIN/REMOTE_ACCESS.md`와 커밋 차이를 읽는다. 보고서의 과거 테스트 결과를 이번 이전 작업에서 재실행한 결과로 주장하지 않는다.
- 기존 스테이징에 포함돼 있던 `ard_network(1).h`도 보존했다. 실제 API 헤더는 `ard_network.h`이며 중복 파일의 정리는 별도 작업으로 판단한다.

### JC1060 포함 여부 재확인

사용자가 이전 중에 JC1060 펌웨어 포함 여부를 별도로 확인해 달라고 요청했다. 최신 `main/`·`components/ard_net/` 소스, `sdkconfig.defaults`, `dependencies.lock`, `build.ps1`, 검사 소스와 관련 보고서는 Git에 포함한다. 최근 구동 탭 개편·비선형 조이스틱 보고서도 함께 보존한다. `c6_firmware/network_adapter.bin`은 기존부터 추적하는 C6 보조 펌웨어다.

로컬에서 발견한 앱 바이너리의 기록은 다음과 같다. 파일과 ESP 앱 설명자를 읽었으며 빌드는 실행하지 않았다.

| 제외된 로컬 바이너리 | 파일 수정 시각 | 포함된 버전 |
|---|---|---|
| `build/ard_jc1060p470c.bin` | 2026-10-26 15:48:08 | `715f720-dirty`, ESP-IDF v5.5.5 |
| `build/wifi_debug/ard_jc1060p470c.bin` | 2026-10-26 13:31:22 | `715f720-dirty`, ESP-IDF v5.5.5 |

`main/ui.cpp`는 16:50:15까지 수정돼 위 바이너리보다 새롭다. 따라서 이 바이너리를 최신 소스와 일치하는 배포본이라고 보장하지 않고 `build/` 제외를 유지한다. 사용자가 별도 최신 배포 묶음을 제공하면 그 경로와 생성 정보를 확인해 별도 보존한다. 새 환경에서 최신 소스로 펌웨어를 만들 때에도 빌드는 사용자가 직접 수행한다.

## 스킬 이전

이전 PC에 `remotion-best-practices`와 `3dmodel`을 설치했다. 사용자 전역 스킬 폴더는 Git에 포함하지 않는다. 새 환경에 없으면 `skill-installer`로 다음 원본에서 설치한다.

- `remotion-dev/skills`, 경로 `skills/remotion-best-practices`.
- `fletcherholt/3dmodel-skill`, 경로 `.`, 설치 이름 `3dmodel`.

기존 설치 기록은 `output/ard-cg/skill_install_manifest.json`에 있다. 기록의 절대 경로는 이전 PC의 위치이지 새 환경의 필수 경로가 아니다. 현재 미리보기는 Remotion 앱이 아니라 빌드 없이 실행하는 JavaScript다. 빌드 금지 지침을 무시하고 Remotion 앱 빌드나 렌더 래퍼를 시작하지 않는다.

## 이번 이전 작업의 점검

- 최신 원격 상태를 가져온 뒤 기존 미푸시 커밋 3개와 현재 스냅샷을 같은 브랜치에 보존하도록 준비했다.
- 커밋 대상에 기존 비공개·경량화 제외 폴더, Visual Studio 캐시, 재생성 메쉬·검수 프레임이 포함되지 않았는지 확인했다.
- 개별 파일의 GitHub 100 MiB 제한을 점검했다. 이번 신규·변경 파일 중 최대 크기는 약 18.7 MiB다.
- 신규·변경 텍스트에서 주요 API 키·개인키·토큰 패턴을 점검했으며 일치 항목은 없었다. 모든 형태의 비밀값을 보장하는 검사는 아니다.
- `git diff --cached --check` 통과. 메쉬 생성기·서버의 Python 구문을 확인했다.
- 새 서버 코드를 별도 임시 포트에서 불러와 `/vendor/three.min.js`, `/cinematic.html`의 HTTP 200 응답과 의존 파일 해시를 확인했다.
- **앱·펌웨어·C/C++ 빌드와 실물 검증은 실행하지 않았다.**
