khw1566/ARD/ARD_hardware/RA_Project/RA_v1 ([1차]).pdf

setPageBoxes("Crop", 0, 0, [0,2000,2000,0]);

제목부품 번호 | RA_v1 리비전 설계자 | work 엔지니어

이 문서의 정보 및/또는 자료는 해당 작성자의 자산이며 작성자의 제한을 받는 정보 및/또는 자료입니다. 이러한 정보는 서면 허가 없이 사용, 복제, 게시하거나 다른 사람 에게 공개할 수 없습니다. 또한 문서에 명시된 항목을 제조하는 용도로만 사용되어야 합니다.
