khw1566/ARD/ARD_hardware/ARD_Model_v1/1/a/설계 1/시나리오 1/thumbnail.jpg

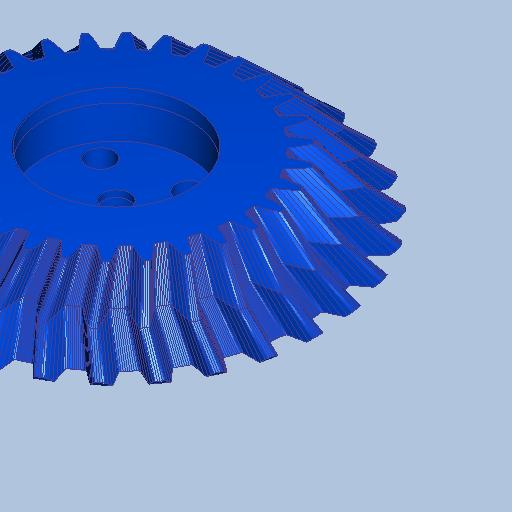
ARD_hardware/ARD_Model_v1/1/a/설계 1/시나리오 1/thumbnail.jpg
