khw1566/ARD/ARD_hardware/ARD_Model_v1/gif와 영상/녹음 2026-03-19 173838.gif

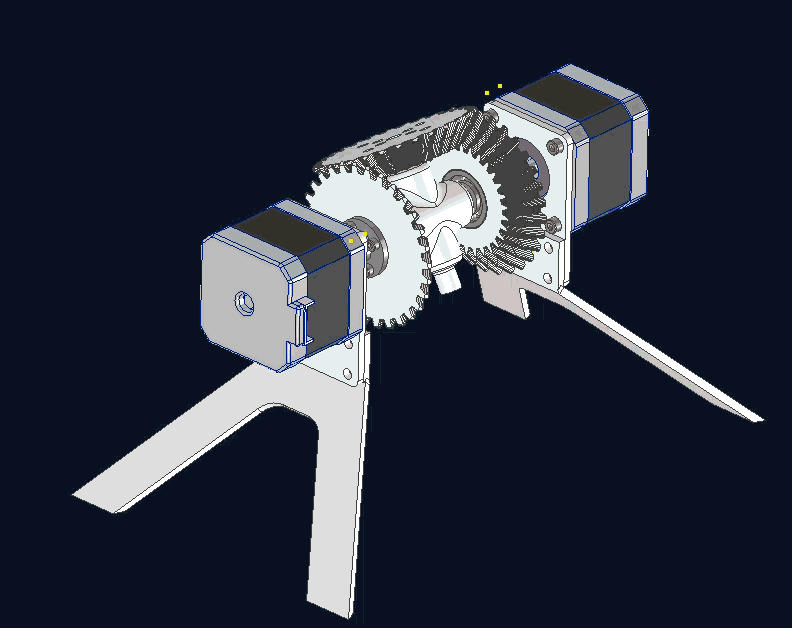
ARD_hardware/ARD_Model_v1/gif와 영상/녹음 2026-03-19 173838.gif
