khw1566/ARD/ARD_hardware/PL121248Drive_v1/스크린샷 2026-03-28 165627.png

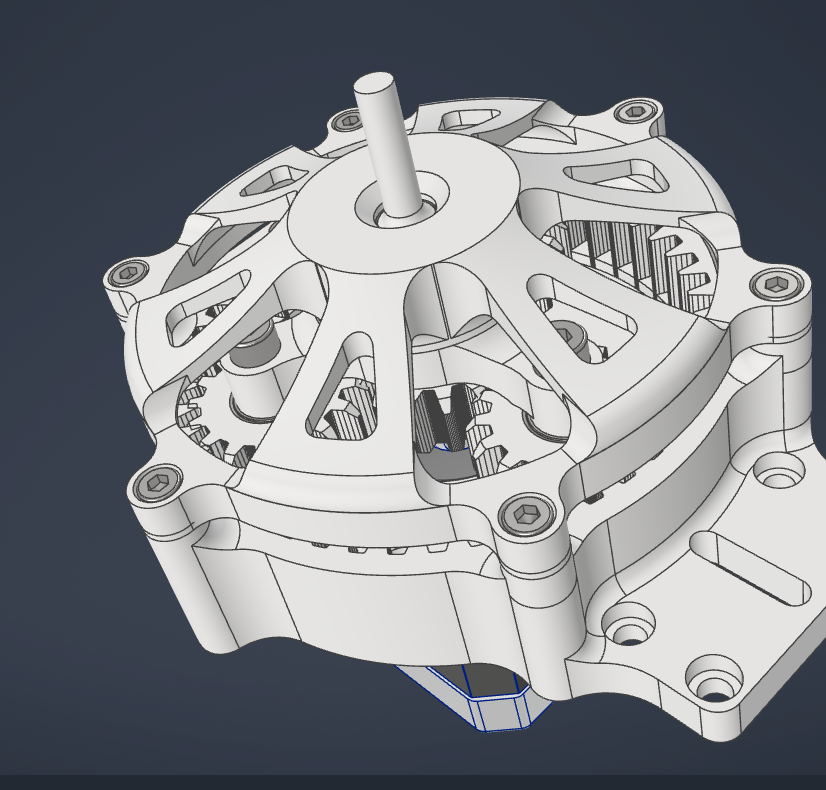
ARD_hardware/PL121248Drive_v1/스크린샷 2026-03-28 165627.png
