khw1566/ARD/ARD_hardware/PL121248m2Drive_v2/pl_v2_page-0001.jpg

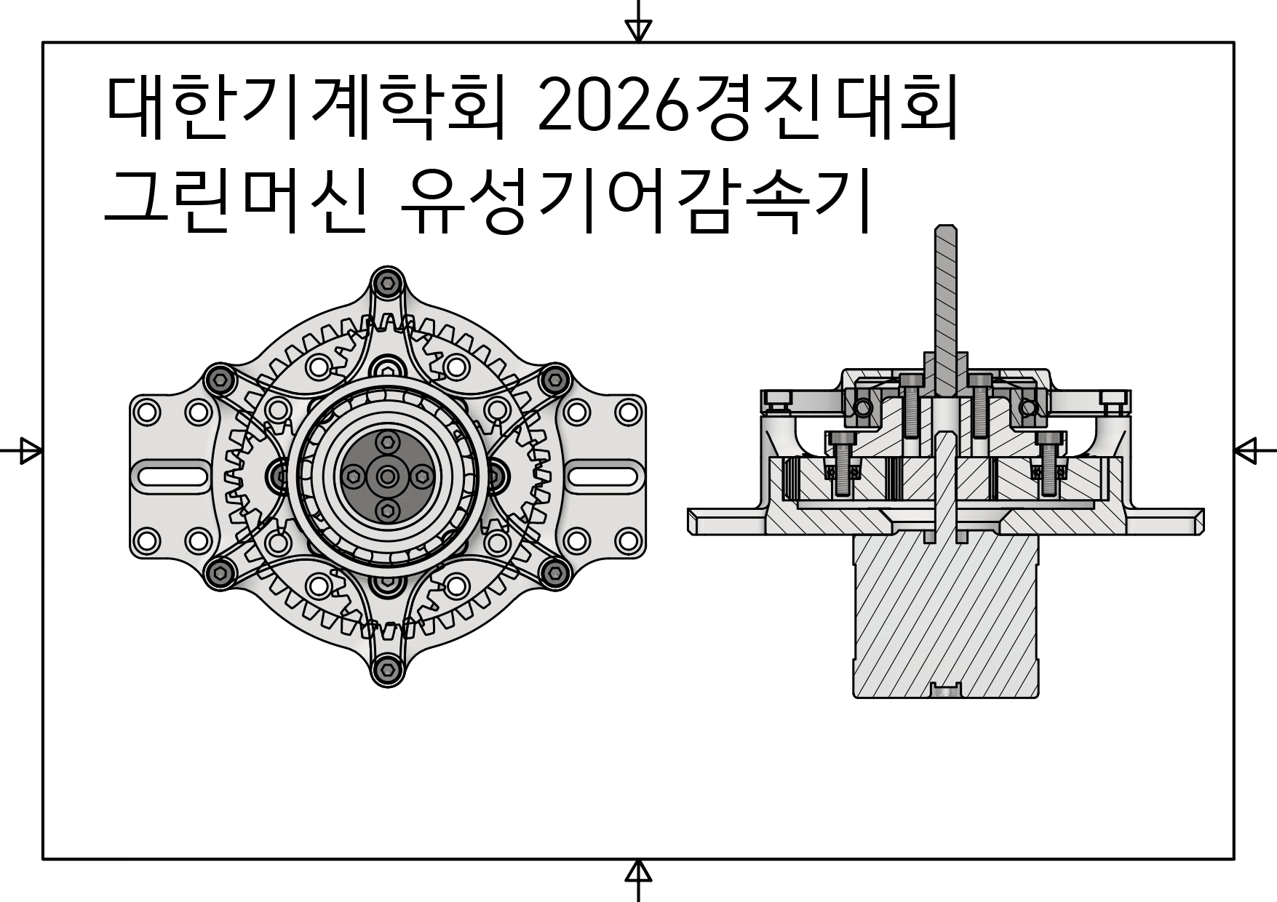
ARD_hardware/PL121248m2Drive_v2/pl_v2_page-0001.jpg
