khw1566/ARD/ARD_hardware/PneumaticGripper_v2/PneumaticGripper_v1-1.png

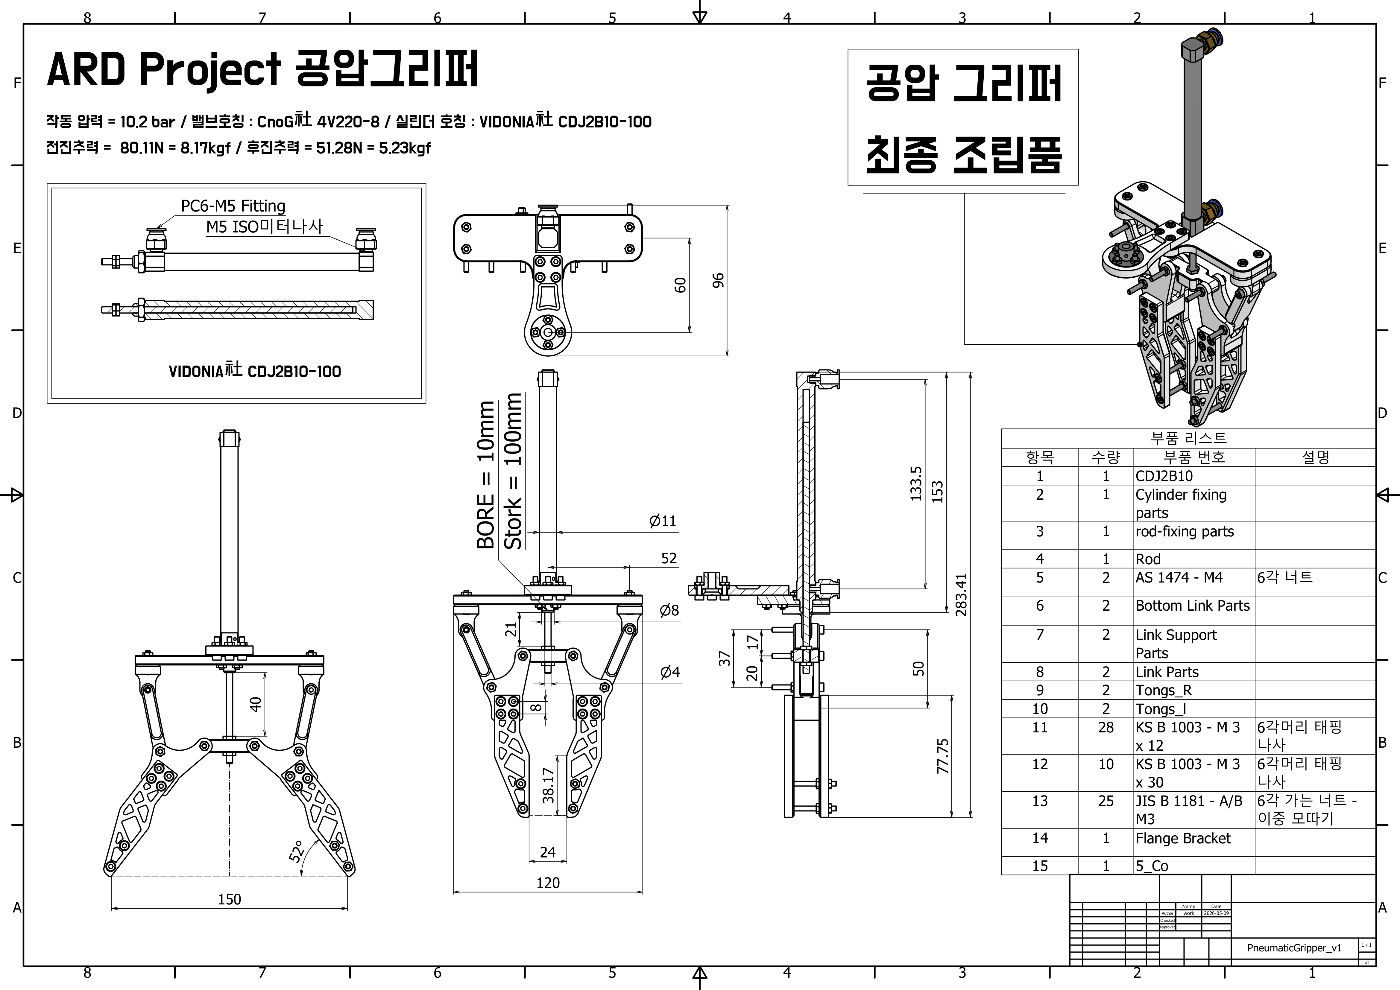
ARD_hardware/PneumaticGripper_v2/PneumaticGripper_v1-1.png
