khw1566/ARD/ARD_hardware/RA_Project/RA_v1.png

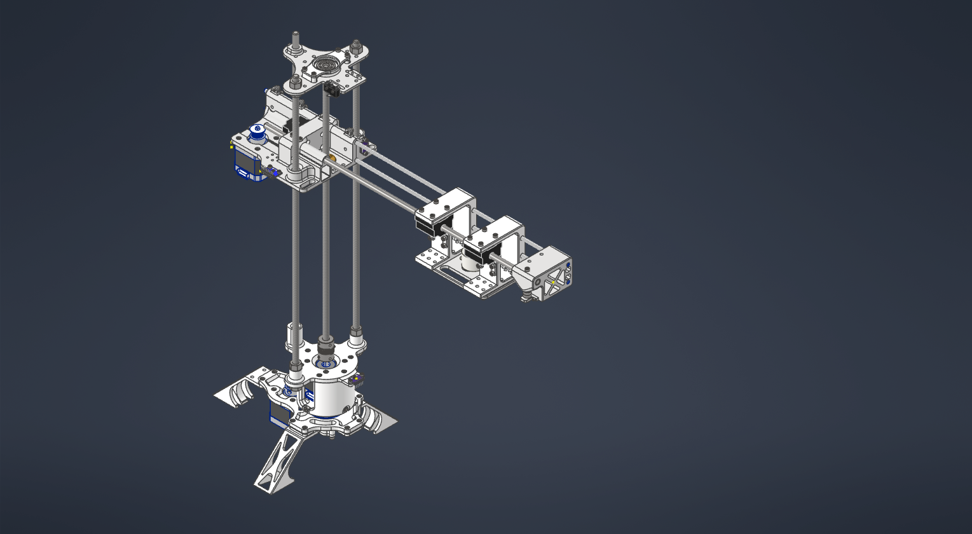
ARD_hardware/RA_Project/RA_v1.png
