khw1566/ARD/output/ard-cg/cinematic_section.jpg

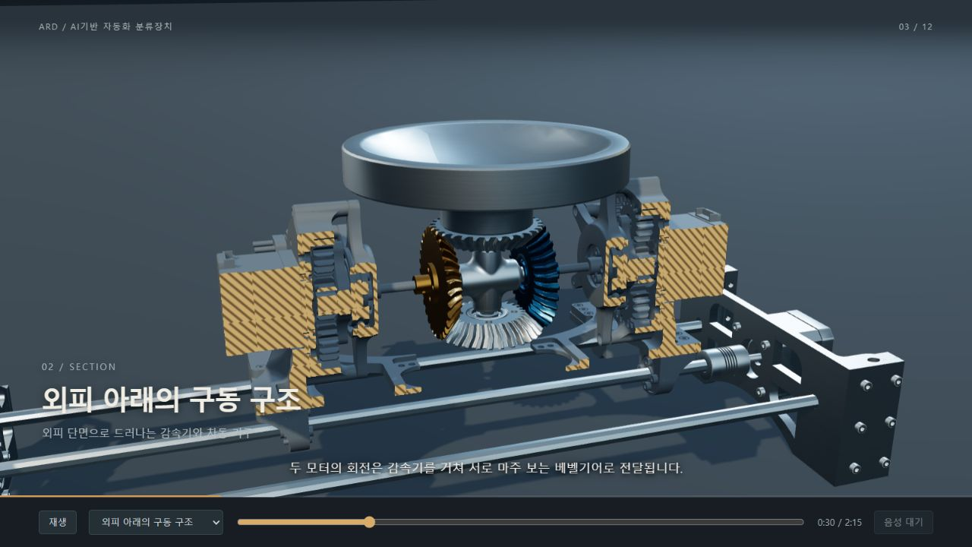
output/ard-cg/cinematic_section.jpg
