khw1566/ARD/output/ard-cg/cinematic_tilt.jpg

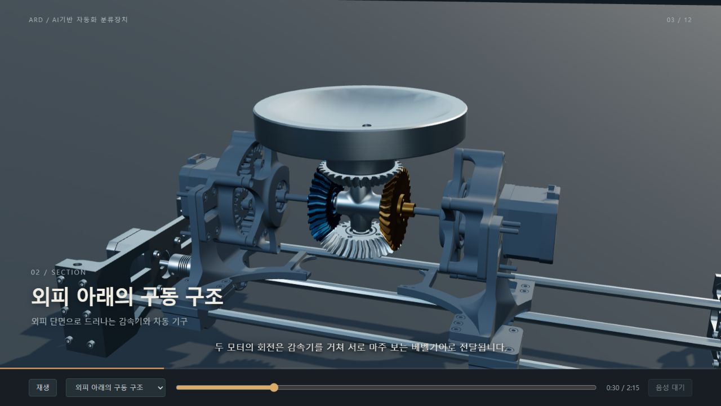
output/ard-cg/cinematic_tilt.jpg
