khw1566/ARD/output/ard-cg/cinematic_yaw.jpg

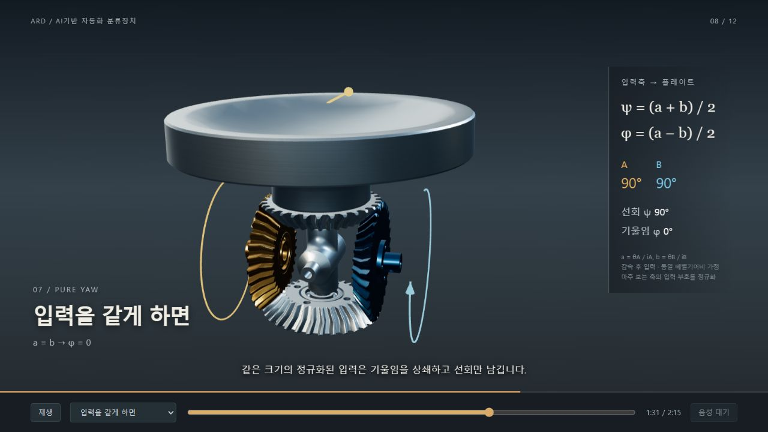
output/ard-cg/cinematic_yaw.jpg
