khw1566/ARD/output/ard-cg/final/ARD_FullPresentation_1080p_contact.jpg

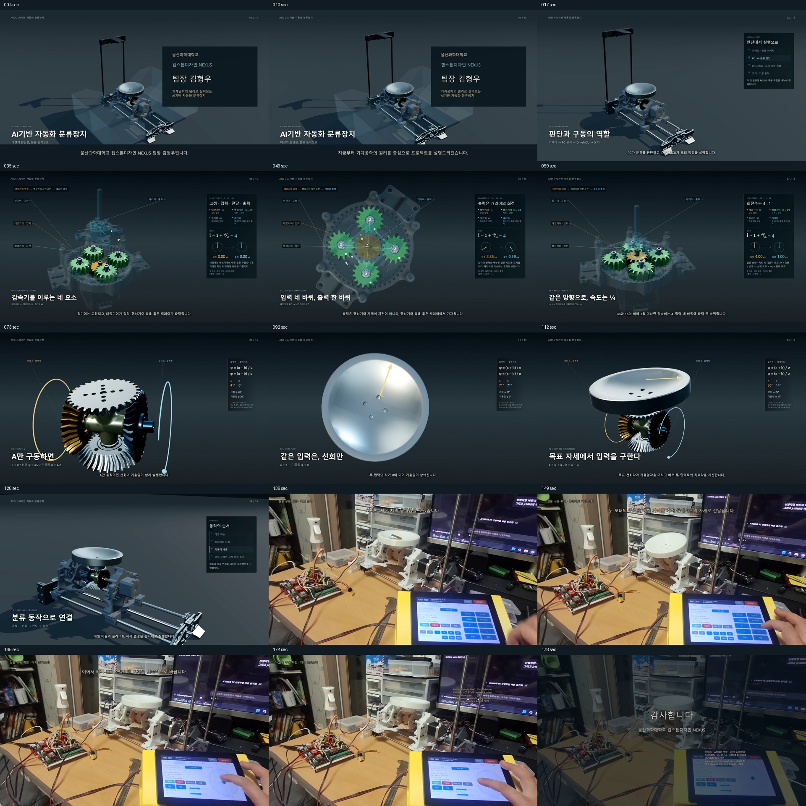
output/ard-cg/final/ARD_FullPresentation_1080p_contact.jpg
