khw1566/ARD/output/ard-cg/final/ARD_FullPresentation_1080p_v2_contact.jpg

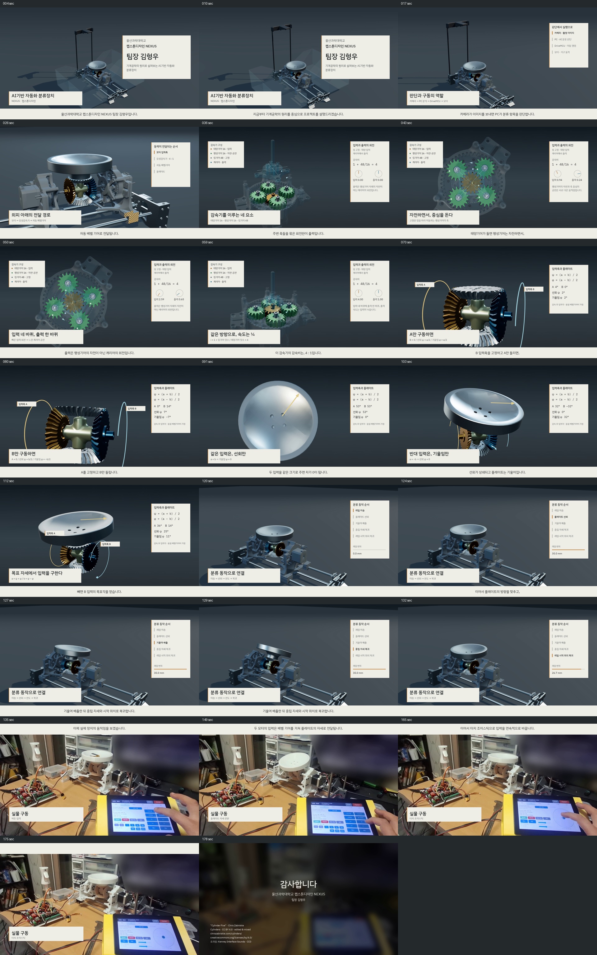
output/ard-cg/final/ARD_FullPresentation_1080p_v2_contact.jpg
