khw1566/ARD/output/ard-cg/final/ARD_LiveDemo_Stabilized_1080p_contact.jpg

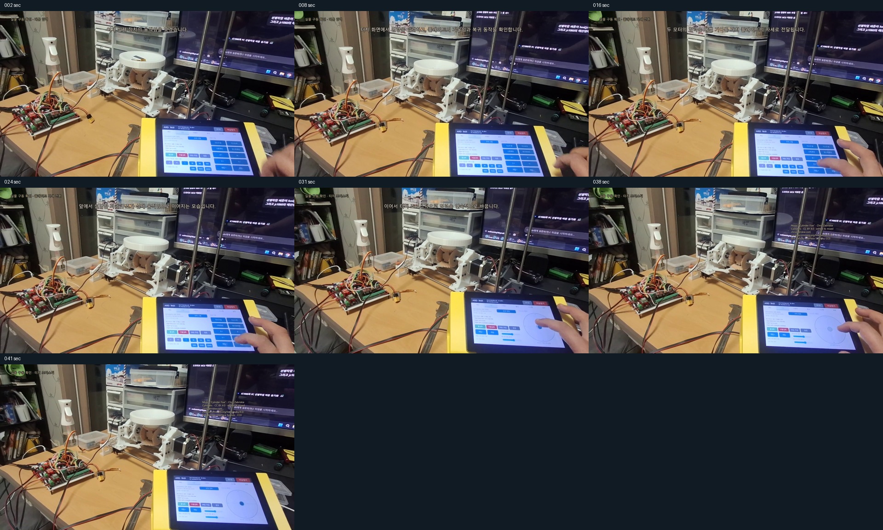
output/ard-cg/final/ARD_LiveDemo_Stabilized_1080p_contact.jpg
