khw1566/ARD/output/ard-cg/final/contact_sheet.jpg

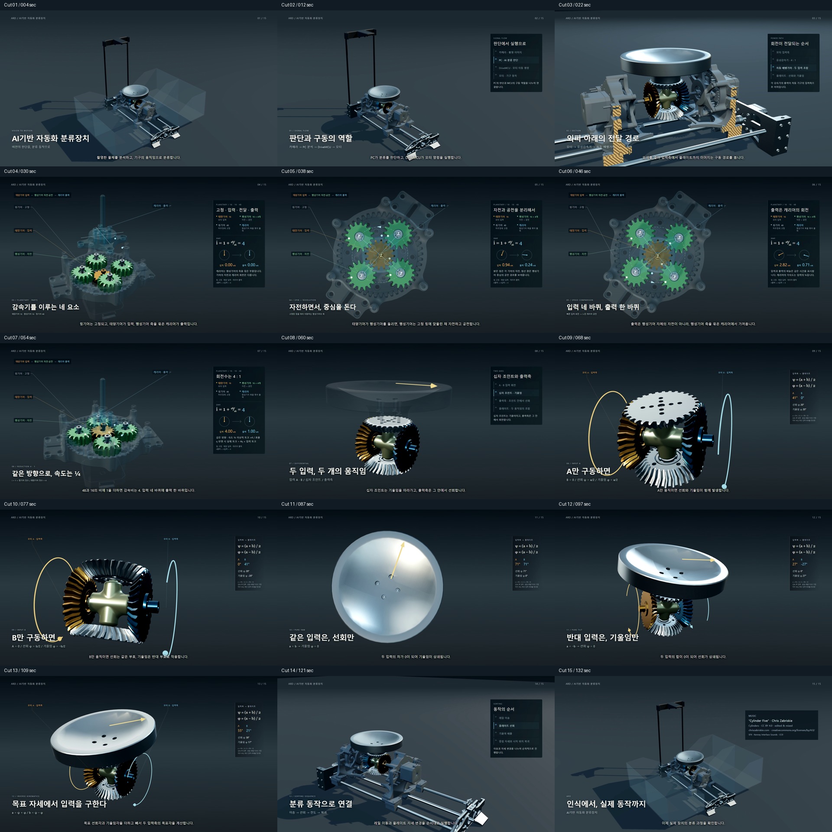
output/ard-cg/final/contact_sheet.jpg
