khw1566/ARD/output/ard-cg/final/live_poster.jpg

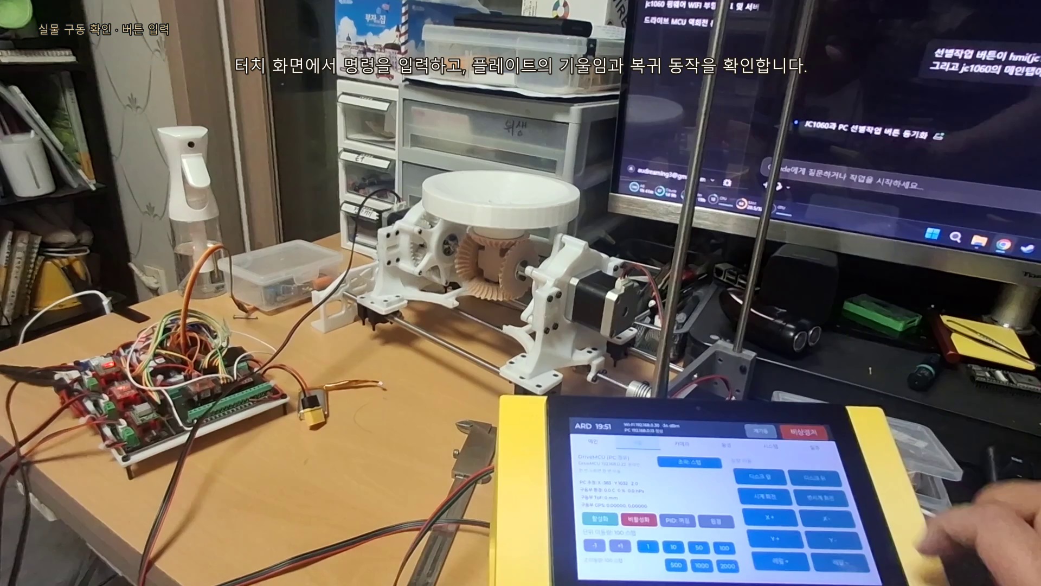
output/ard-cg/final/live_poster.jpg
