khw1566/ARD/output/ard-cg/final/live_v2_poster.jpg

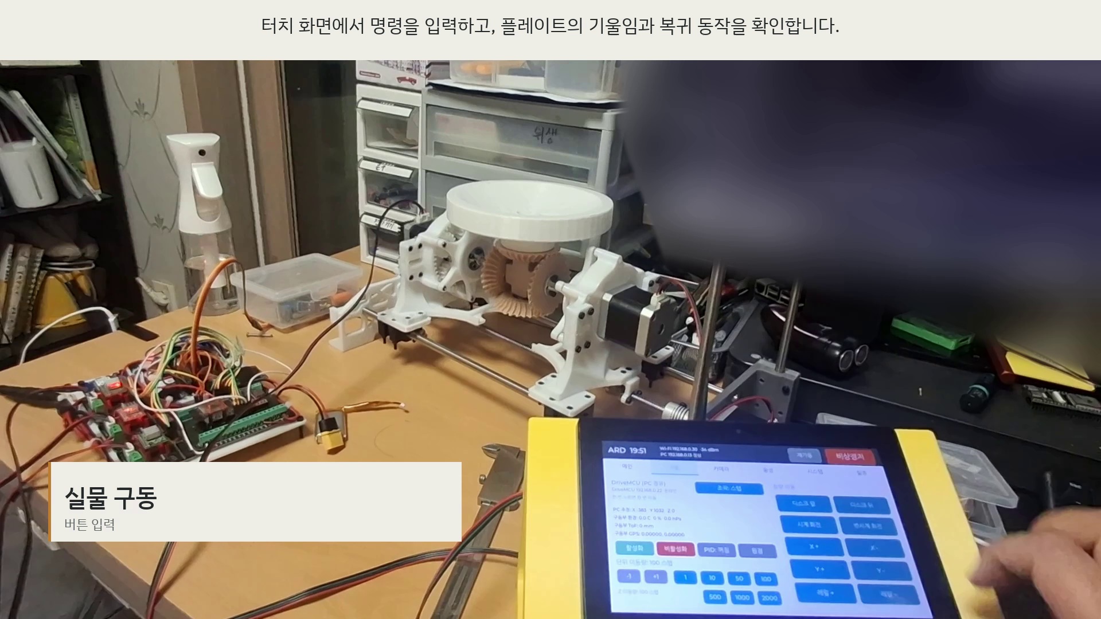
output/ard-cg/final/live_v2_poster.jpg
