khw1566/ARD/output/ard-cg/final/poster.jpg

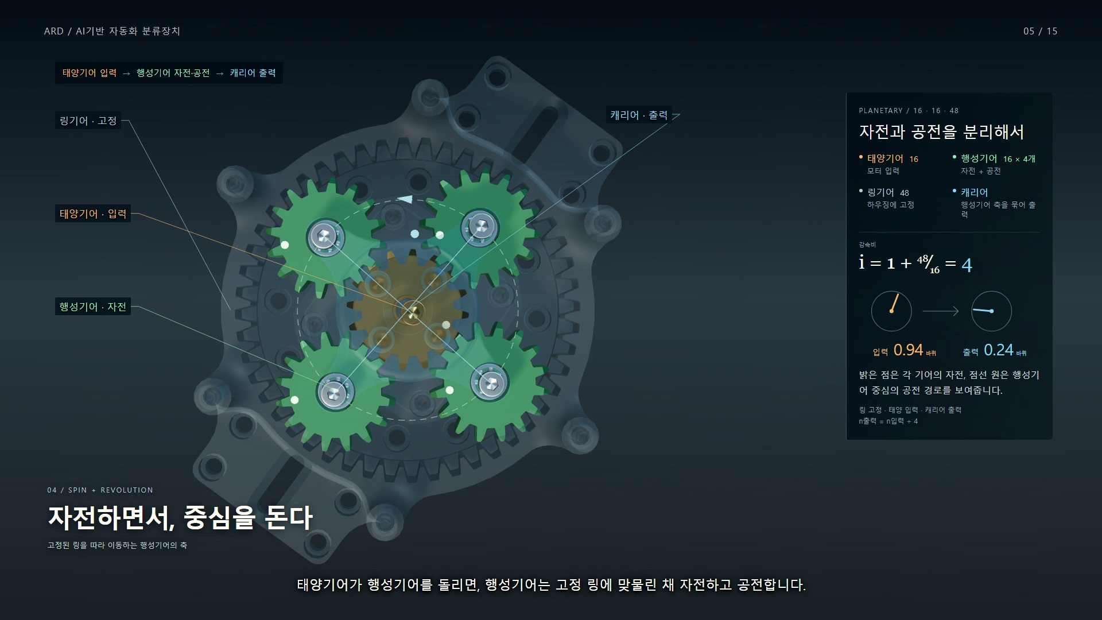
output/ard-cg/final/poster.jpg
