khw1566/ARD/output/ard-cg/final/presentation_poster.jpg

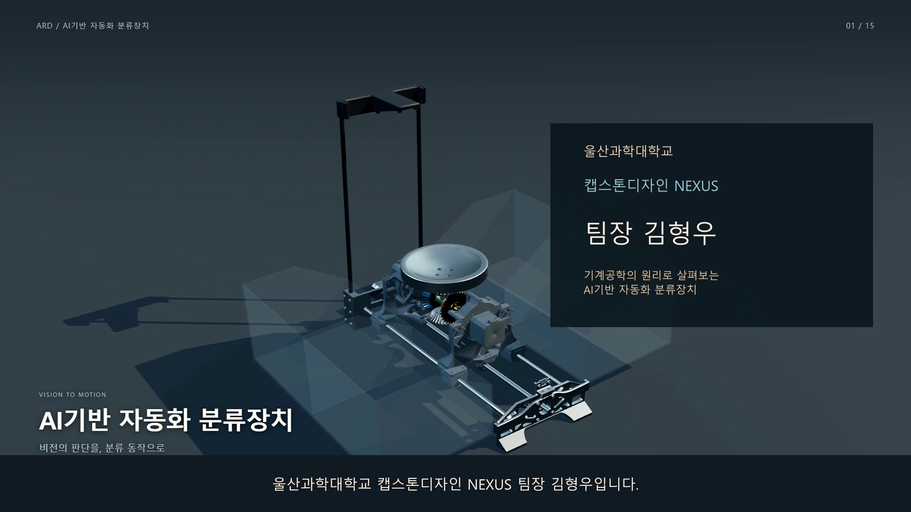
output/ard-cg/final/presentation_poster.jpg
