khw1566/ARD/output/pdf/ard_system_2p/page_02.png

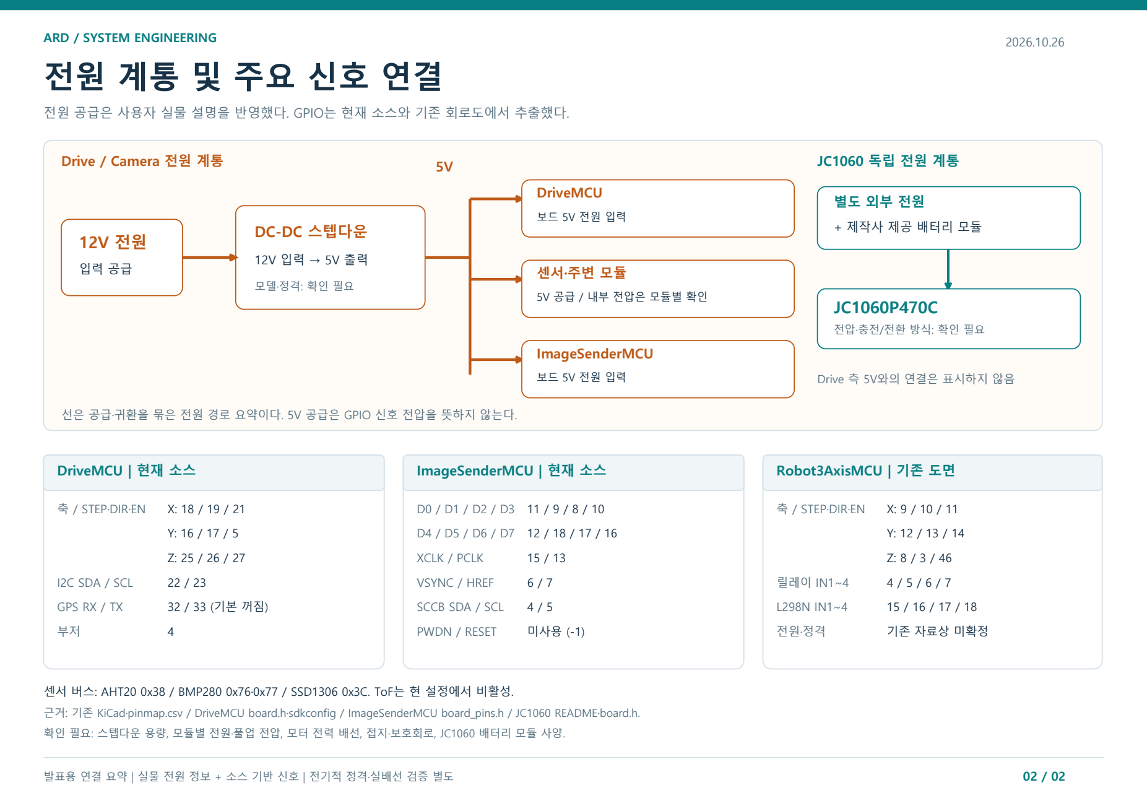
output/pdf/ard_system_2p/page_02.png
