khw1566/ARD/output/screensaver_preview/contact_sheet.png

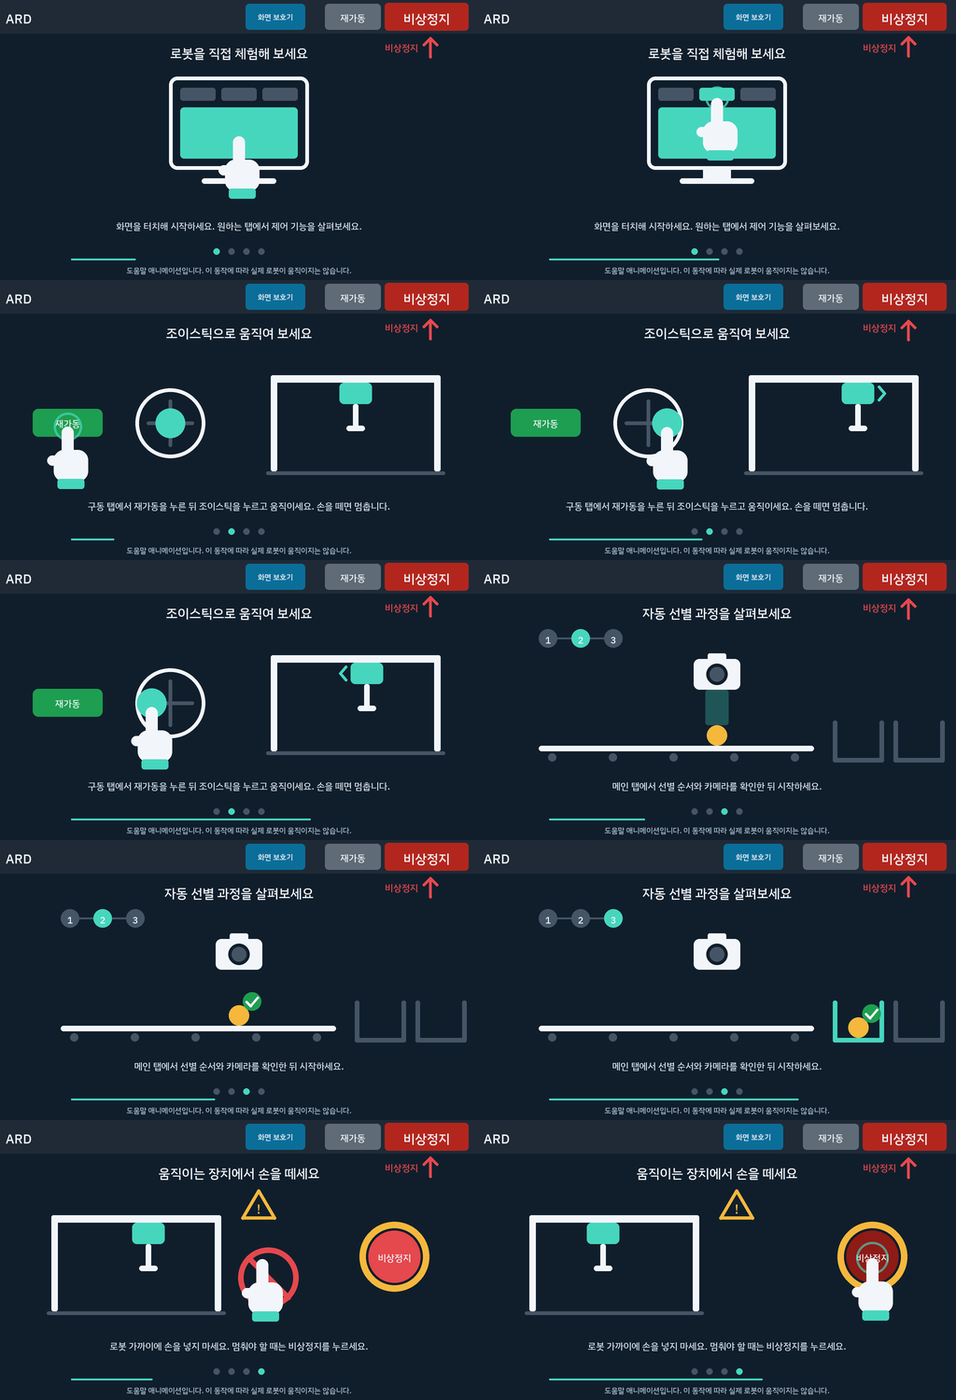
output/screensaver_preview/contact_sheet.png
