khw1566/ARD/output/screensaver_preview/screensaver_preview.gif

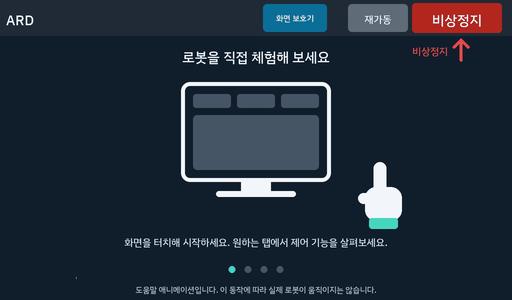
output/screensaver_preview/screensaver_preview.gif
