khw1566/ARD/영상제작용 CAD파일/전도 과정 작동모습.png

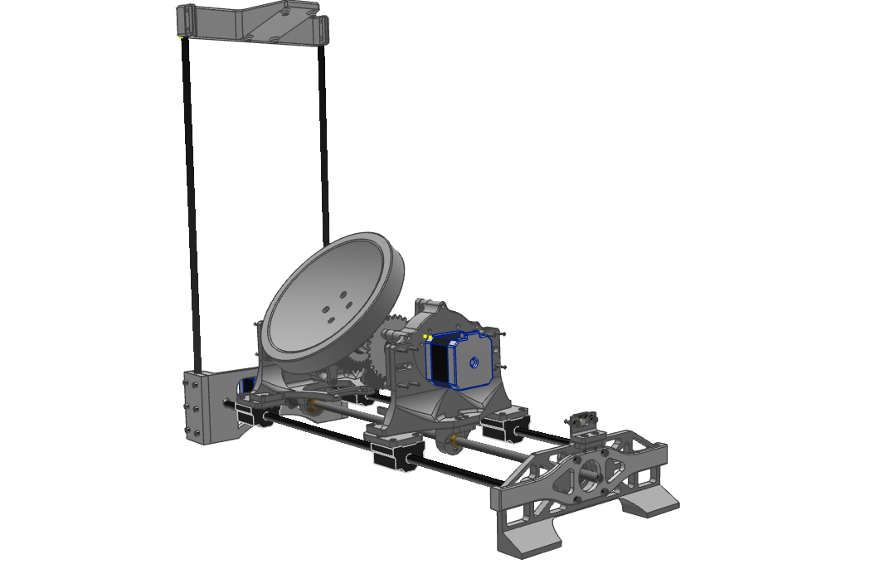
영상제작용 CAD파일/전도 과정 작동모습.png
