khw1566/ARD/영상제작용 CAD파일/평면도.png

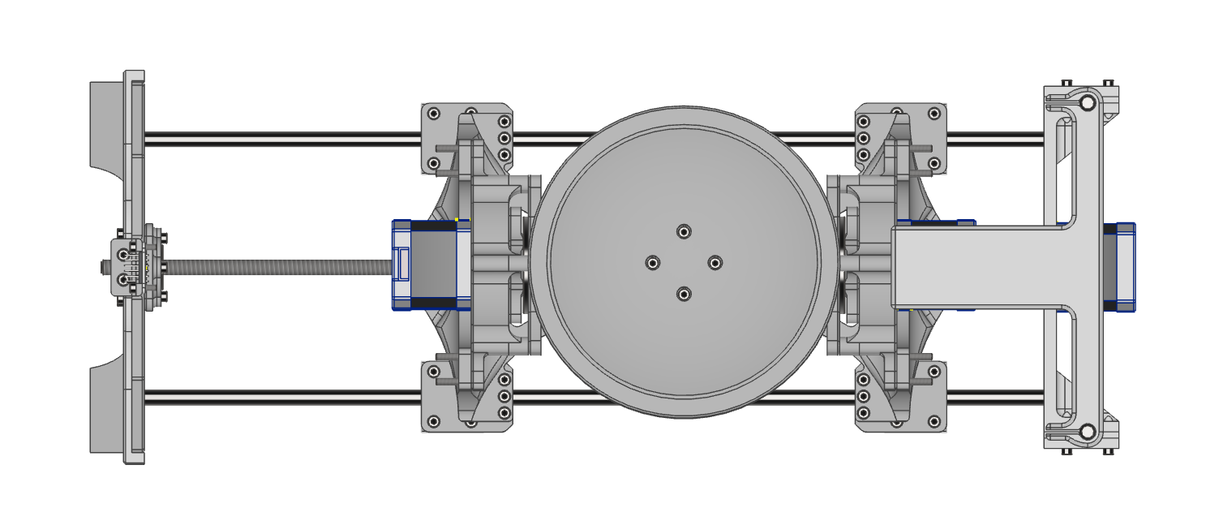
영상제작용 CAD파일/평면도.png
