khw1566/ARD/ARD_hardware/TRCR_Project/BaseDATA/사이클로이드 감속기 엑셀문서.xlsx

Sheet: 메인
호칭 품명 | 이름 | 수량 | 단위갯수 | 배수 | 상세정보1 | 상세정보2
스텐 볼 | S6 베어링용 스텐볼 | 16 | 4 | 4 | 6파이 | 디스크-하우징간 마찰을 방지하고 편심운동을 보조
출력롤러 핀 | M3-50 롤러핀 | 10 | 10 | 1 | M3-25/M3-50 | 1차 시제품상 회전하지 아니하며 결속되어 정회전
대구경 베어링(출력축) | ABEC-6706ZZ | 2 | 2 | 1 | 30*42*7
대구경 베어링(입력축1) | ABEC-6705ZZ | 2 | 2 | 1 | 20*32*7
대구경 베어링(입력축2) | ABEC-6705ZZ | 2 | 2 | 1 | 20*32*7
입력 편심축 지지 핀 | M2-100 | 4 | 2 | 2 | 절단예정
출력축 축 | M5-XXX | 1 | 1 | 1 | 절단예정
입력축 동력전달 플랜지 | M5-220플랜지 | 2 | 1 | 2 | M3미터나사 체결
출력품 호칭 | 이름 | 수량 | 크기 | 상세정보
디스크 1상(120) | DISK-1P | 1 |  | 120도의 위상을 가지는 편심운동하는 디스크
디스크 2상(240) | DISK-2P | 1 |  | 240도의 위상을 가지는 편심운동하는 디스크
디스크 3상(360) | DISK-3P | 1 |  | 360도의 위상을 가지는 편심운동하는 디스크
편심축 1상(120) | SHAFT-1P | 2 |  | 입력축으로 동력을 받아 120도의 위상을 출력하는 편심축
편심축 1상(240) | SHAFT-2P | 2 |  | 입력축으로 동력을 받아 240도의 위상을 출력하는 편심축
편심축 1상(360) | SHAFT-3P | 2 |  | 입력축으로 동력을 받아 360도의 위상을 출력하는 편심축
입력축 커버링 | INPUT-COVER | 2 |  | 입력축의 동력을 전달하는 플랜지겸 커플러
하우징 상 | HOUSING-U | 1 |  | 노출형태의 디스크로 제작, 입력축의 동력분배장치가 있어야함
하우징 하 | HOUSING-D | 1 |  | 상부과 거의 동일
출력축-롤러핀 홀더 상 | OUTPUT-U | 1 |  | 핀을 결속시키며 출력축과 체결되어있는 원형모양의 홀더
출력축-롤러핀 홀더 하 | OUTPUT-D | 1 |  | 상동하나, 플랜지구조 대신 베어링 지지구조를 포함하여야함

Sheet: 사이클로이드
R | 18.5 | 각도 | 라디안 | x좌표 | y좌표
E | 1 | 0 | 0 | 15.5 | 0 | 18.5 | 0
Rr | 2 | 1 | 0.01745329252 | 16.32313509 | -1.637562682 | 18.49718236 | 0.3228695191
N | 16 | 2 | 0.03490658504 | 16.57690977 | -1.809353087 | 18.4887303 | 0.645640689
인벤터 복붙용수식 |  | 3 | 0.05235987756 | 16.64629691 | -1.854859184 | 18.47464639 | 0.9682151905
X축 수식 | (18.5 * cos(t * 1 rad) - 2 * cos(t * 1 rad + atan(sin(-15 * t * 1 rad) / ((18.5 / (1 * 16)) - cos(-15 * t * 1 rad)))) - 1 * cos(16 * t * 1 rad)) * 1 mm | 4 | 0.06981317008 | 16.70039769 | -1.897591427 | 18.45493493 | 1.290494764
Y축 수식 | (-18.5 * sin(t * 1 rad) + 2 * sin(t * 1 rad + atan(sin(-15 * t * 1 rad) / ((18.5 / (1 * 16)) - cos(-15 * t * 1 rad)))) + 1 * sin(16 * t * 1 rad)) * 1 mm | 5 | 0.0872664626 | 16.77212328 | -1.968560874 | 18.42960191 | 1.612381241
tmin | 0 | 6 | 0.1047197551 | 16.86198906 | -2.082268555 | 18.39865506 | 1.93377657
tmax | 2*PI | 7 | 0.1221730476 | 16.95975518 | -2.245238929 | 18.36210381 | 2.254582853
하이포사이클로이드 곡선 |  | 8 | 0.1396263402 | 17.05155637 | -2.457736644 | 18.31995927 | 2.574702368
X축 수식 | (18.5 * cos(t * 1 rad) - 1 * cos(16 * t * 1 rad) + 2 * (18.5 * cos(t * 1 rad) + 16 * cos(16 * t * 1 rad)) / sqrt(598.25 + 592 * cos(17 * t * 1 rad))) * 1 mm | 9 | 0.1570796327 | 17.12337926 | -2.714586889 | 18.2722343 | 2.894037603
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
 |  | 353 | 6.16101226 | 16.95975518 | 2.245238929 | 18.36210381 | -2.254582853
 |  | 354 | 6.178465552 | 16.86198906 | 2.082268555 | 18.39865506 | -1.93377657
 |  | 355 | 6.195918845 | 16.77212328 | 1.968560874 | 18.42960191 | -1.612381241
 |  | 356 | 6.213372137 | 16.70039769 | 1.897591427 | 18.45493493 | -1.290494764
 |  | 357 | 6.23082543 | 16.64629691 | 1.854859184 | 18.47464639 | -0.9682151905
 |  | 358 | 6.248278722 | 16.57690977 | 1.809353087 | 18.4887303 | -0.645640689
 |  | 359 | 6.265732015 | 16.32313509 | 1.637562682 | 18.49718236 | -0.3228695191
 |  | 360 | 6.283185307 | 15.5 | 1.386783483e-13 | 18.5 | -4.533049283e-15

Sheet: 다이어프램 펌프
호칭 품명 | 이름 | 수량 | 단위갯수 | 배수 | 상세정보1
동력축 고정 베어링 |  | 2
수직운동 링크 베어링 |  | 2
편심운동 동력전달 베어링 |  | 2
다이어프램 |  | 2
체크밸브 |  | 4 |  |  | 입력배관, 출력배관 2개씩 필요
동력입력 타이밍 벨트 풀리 |  | 1
샤프트
출력품 호칭 | 이름 | 수량 | 크기 | 상세정보
하우징 상 |  | 1
하우징 하 |  | 1
다이어 프램 고정 부 |  | 2
축 고정부 상 |  | 1
축 고정부 하 |  | 1
편심운동 전달축1 |  | 1
편심운동 전달축2 |  | 1
편심운동 전달링크 |  | 2
수직운동 변환 홀더 |  | 2
수직운동 전달 링크 |  | 2

Sheet: 치형연구
0 | 0 | = $r_h * SIN(A10) - $e * SIN($B * A10) | = $r_h * COS(A10) - $e * COS($B * A10) | = $r_h * COS(A10) - $e * $B * COS($B * A10) | = -$r_h * SIN(A10) + $e * $B * SIN($B * A10) | 0.1570796327 | = B10 + $r_p * (E10 / F10) | = C10 - $r_p * (D10 / F10) | Zp | 10
1 | 0.01745329252 |  |  |  |  |  |  |  | Zg | 9
2 | 0.03490658504 |  |  |  |  |  |  |  | rh | 24
3 | 0.05235987756 |  |  |  |  |  |  |  | rp | 1.5
4 | 0.06981317008 |  |  |  |  |  |  |  | x | 0.2
5 | 0.0872664626
6 | 0.1047197551
7 | 0.1221730476
8 | 0.1396263402
9 | 0.1570796327
10 | 0.1745329252
11 | 0.1919862177
12 | 0.2094395102
13 | 0.2268928028
14 | 0.2443460953
15 | 0.2617993878
16 | 0.2792526803
17 | 0.2967059728
18 | 0.3141592654
19 | 0.3316125579
20 | 0.3490658504
21 | 0.3665191429
22 | 0.3839724354
23 | 0.401425728
24 | 0.4188790205
25 | 0.436332313
26 | 0.4537856055
27 | 0.471238898
28 | 0.4886921906
29 | 0.5061454831
30 | 0.5235987756
31 | 0.5410520681
32 | 0.5585053606
33 | 0.5759586532
34 | 0.5934119457
35 | 0.6108652382
36 | 0.6283185307
37 | 0.6457718232
38 | 0.6632251158
39 | 0.6806784083
40 | 0.6981317008
41 | 0.7155849933
42 | 0.7330382858
43 | 0.7504915784
44 | 0.7679448709
45 | 0.7853981634
46 | 0.8028514559
47 | 0.8203047484
48 | 0.837758041
49 | 0.8552113335
50 | 0.872664626
51 | 0.8901179185
52 | 0.907571211
53 | 0.9250245036
54 | 0.9424777961
55 | 0.9599310886
56 | 0.9773843811
57 | 0.9948376736
58 | 1.012290966
59 | 1.029744259
60 | 1.047197551
61 | 1.064650844
62 | 1.082104136
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
300 | 5.235987756
301 | 5.253441049
302 | 5.270894341
303 | 5.288347634
304 | 5.305800926
305 | 5.323254219
306 | 5.340707511
307 | 5.358160804
308 | 5.375614096
309 | 5.393067389
310 | 5.410520681
311 | 5.427973974
312 | 5.445427266
313 | 5.462880559
314 | 5.480333851
315 | 5.497787144
316 | 5.515240436
317 | 5.532693729
318 | 5.550147021
319 | 5.567600314
320 | 5.585053606
321 | 5.602506899
322 | 5.619960191
323 | 5.637413484
324 | 5.654866776
325 | 5.672320069
326 | 5.689773362
327 | 5.707226654
328 | 5.724679947
329 | 5.742133239
330 | 5.759586532
331 | 5.777039824
332 | 5.794493117
333 | 5.811946409
334 | 5.829399702
335 | 5.846852994
336 | 5.864306287
337 | 5.881759579
338 | 5.899212872
339 | 5.916666164
340 | 5.934119457
341 | 5.951572749
342 | 5.969026042
343 | 5.986479334
344 | 6.003932627
345 | 6.021385919
346 | 6.038839212
347 | 6.056292504
348 | 6.073745797
349 | 6.091199089
350 | 6.108652382
351 | 6.126105675
352 | 6.143558967
353 | 6.16101226
354 | 6.178465552
355 | 6.195918845
356 | 6.213372137
357 | 6.23082543
358 | 6.248278722
359 | 6.265732015
360 | 6.283185307

Sheet: 에피,하이포
R | 10 | t | radian | x_e | y_e | x_h | y_h
r | 2 | 0 | 0 | 10 | 0 | 10 | 0 | 10 | 0
d | 2 | 1 | 0.01745329252 | 10.00912855 | 0.0003719507121 | 9.993909662 | 0.00010630401 | 9.998476952 | 0.1745240644
 |  | 2 | 0.03490658504 | 10.03639472 | 0.002970578794 | 9.975662754 | 0.0008497716999 | 9.99390827 | 0.348994967
 |  | 3 | 0.05235987756 | 10.08144138 | 0.009997486165 | 9.94533148 | 0.002864268308 | 9.986295348 | 0.5233595624
 |  | 4 | 0.06981317008 | 10.14367769 | 0.02360439878 | 9.903035794 | 0.006777078319 | 9.975640503 | 0.6975647374
 |  | 5 | 0.0872664626 | 10.22228557 | 0.04586891297 | 9.848942826 | 0.01320565533 | 9.961946981 | 0.8715574275
 |  | 6 | 0.1047197551 | 10.31622876 | 0.07877105463 | 9.783266078 | 0.02275441999 | 9.945218954 | 1.045284633
 |  | 7 | 0.1221730476 | 10.42426417 | 0.1241709081 | 9.706264399 | 0.03601162167 | 9.925461516 | 1.218693434
 |  | 8 | 0.1396263402 | 10.54495561 | 0.1837875606 | 9.618240742 | 0.05354627921 | 9.902680687 | 1.39173101
 |  | 9 | 0.1570796327 | 10.67668958 | 0.2591795917 | 9.519540714 | 0.07590521574 | 9.876883406 | 1.56434465
 |  | 10 | 0.1745329252 | 10.81769304 | 0.3517273244 | 9.41055091 | 0.103610202 | 9.84807753 | 1.736481777
 |  | 11 | 0.1919862177 | 10.96605292 | 0.4626170292 | 9.291697068 | 0.1371552221 | 9.816271834 | 1.908089954
 |  | 12 | 0.2094395102 | 11.11973722 | 0.5928272572 | 9.163442019 | 0.1770038756 | 9.781476007 | 2.079116908
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
 |  | 359 | 6.265732015 | 10.00912855 | -0.0003719507121 | 9.993909662 | -0.00010630401 | 9.998476952 | -0.1745240644
 |  | 360 | 6.283185307 | 10 | 0 | 10 | 0 | 10 | -2.45029691e-15

Sheet: 기계요소
기계요소 제고 정리리스트
분류 | 이름 | 수량 | 길이 | 높이/두께 | 내경 | 외경
플랜지 | 5mm샤프트 플랜지 | 5 |  | 10 | 5

Sheet: Sheet3
*기계요소분류 데이터 | *전자부품분류테이터
볼트
너트
와셔
베어링
핀
샤프트
타이밍벨트
플랜지
