khw1566/ARD/ARD_hardware/ARD_Model_v1/1/B.stl

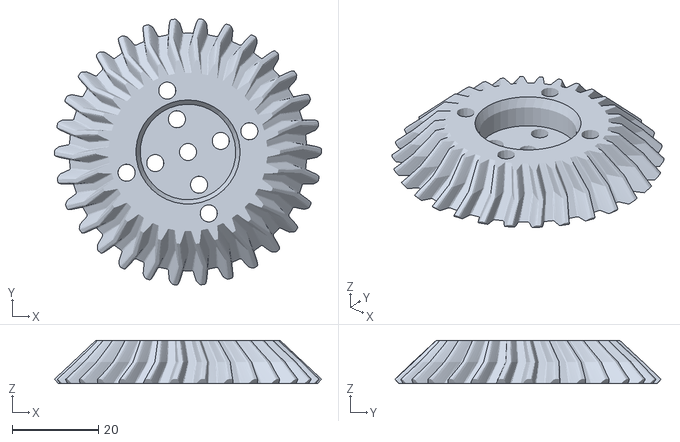
[picture p34: CAD file, 2026-10-17]
ARD_hardware/ARD_Model_v1/1/B.stl
61.8 x 61.6 x 10.0
