khw1566/ARD/ARD_hardware/ARD_Model_v1/coupler/c2.stl

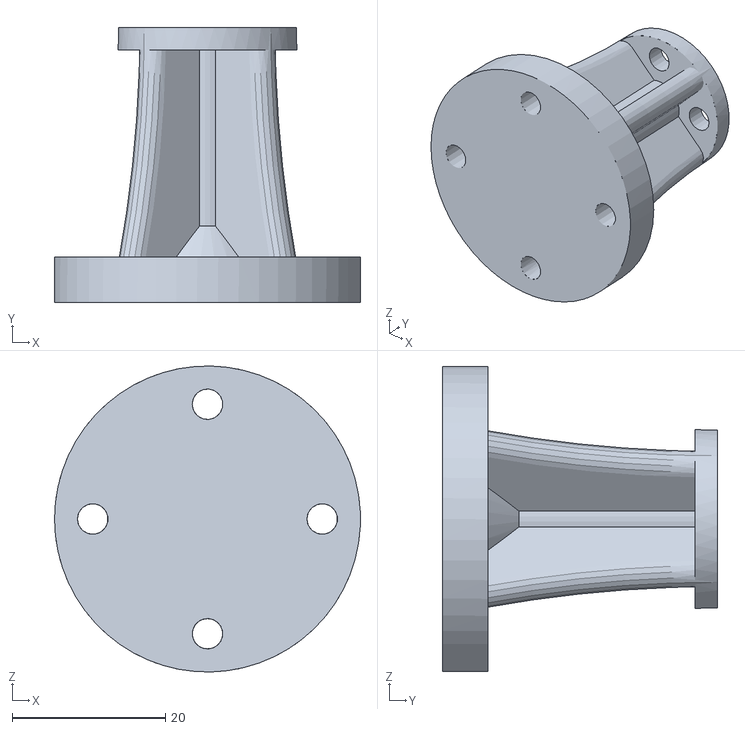
[picture p35: CAD file, 2026-10-17]
ARD_hardware/ARD_Model_v1/coupler/c2.stl
40.0 x 36.0 x 40.0
