khw1566/ARD/ARD_hardware/ARD_Model_v1/M/a.stl

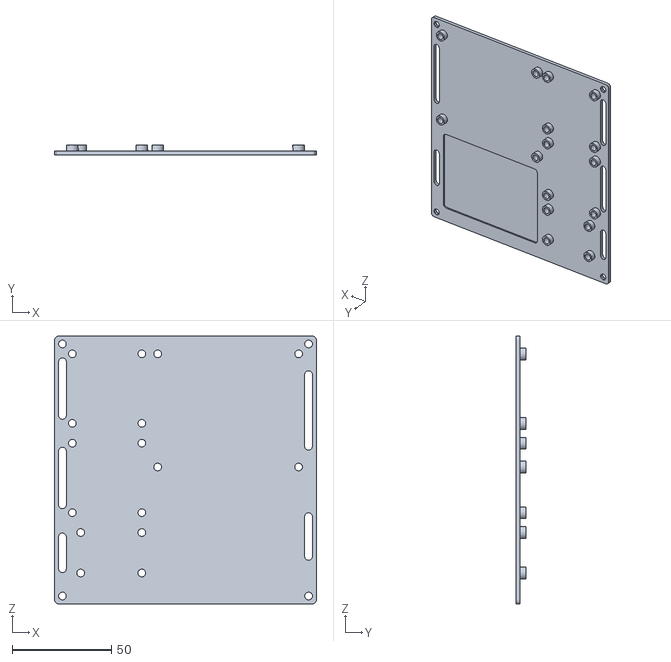
[picture p36: CAD file, 2026-10-17]
ARD_hardware/ARD_Model_v1/M/a.stl
132.0 x 5.00 x 135.0
