khw1566/ARD/ARD_hardware/ARD_Model_v1/RALI1.stl

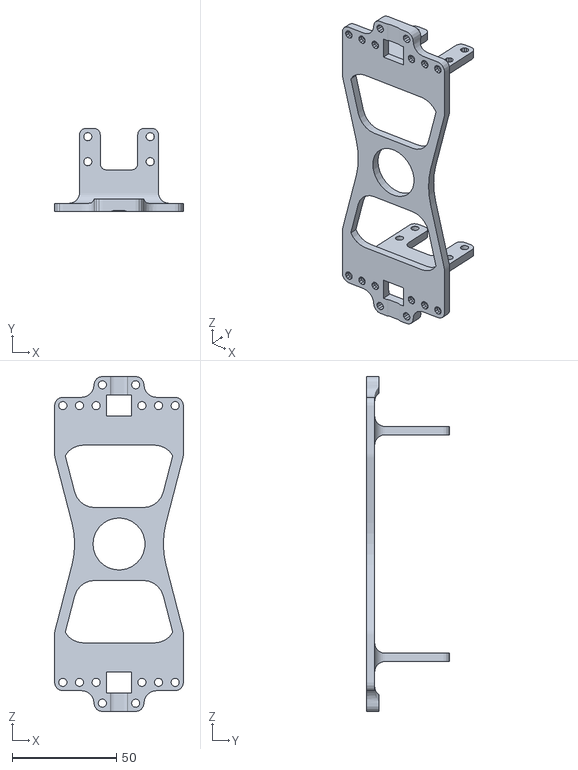
[picture p37: CAD file, 2026-10-17]
ARD_hardware/ARD_Model_v1/RALI1.stl
62.0 x 40.0 x 161.0
