khw1566/ARD/ARD_hardware/Control Box_v1/top.stl

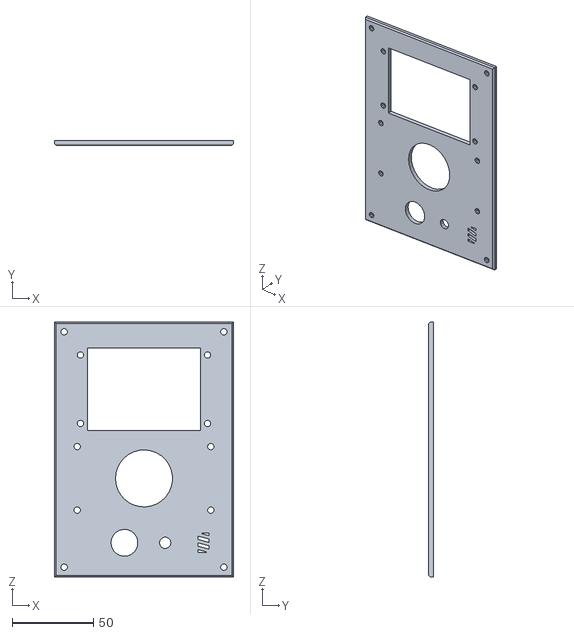
[picture p38: CAD file, 2026-10-17]
ARD_hardware/Control Box_v1/top.stl
110.0 x 3.00 x 156.5
