khw1566/ARD/ARD_hardware/CY300208M4_v1/hou.stl

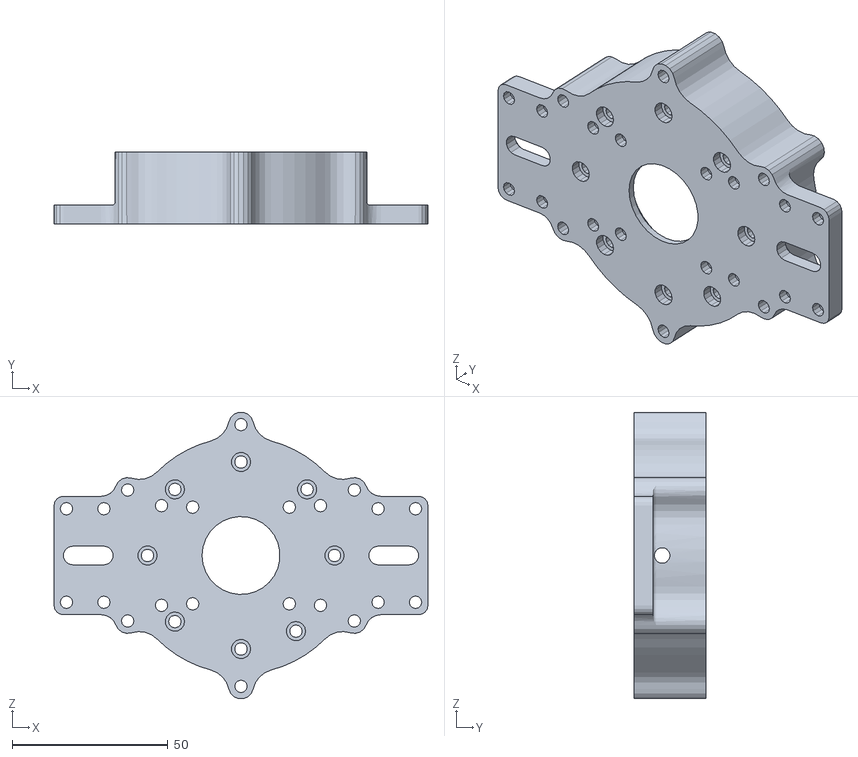
[picture p39: CAD file, 2026-10-17]
ARD_hardware/CY300208M4_v1/hou.stl
120.0 x 23.0 x 91.8
