khw1566/ARD/ARD_hardware/CY300210_v1/s1_v2.stl

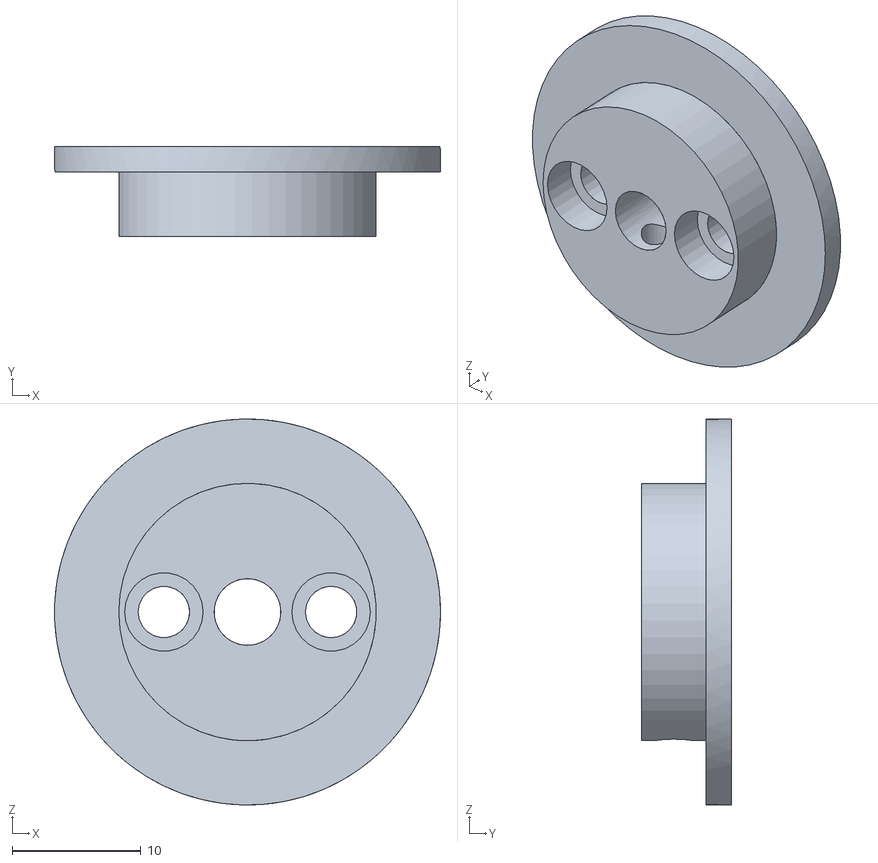
[picture p40: CAD file, 2026-10-17]
ARD_hardware/CY300210_v1/s1_v2.stl
30.0 x 7.00 x 30.0
