khw1566/ARD/ARD_hardware/CY300210M4_v1/s2.stl

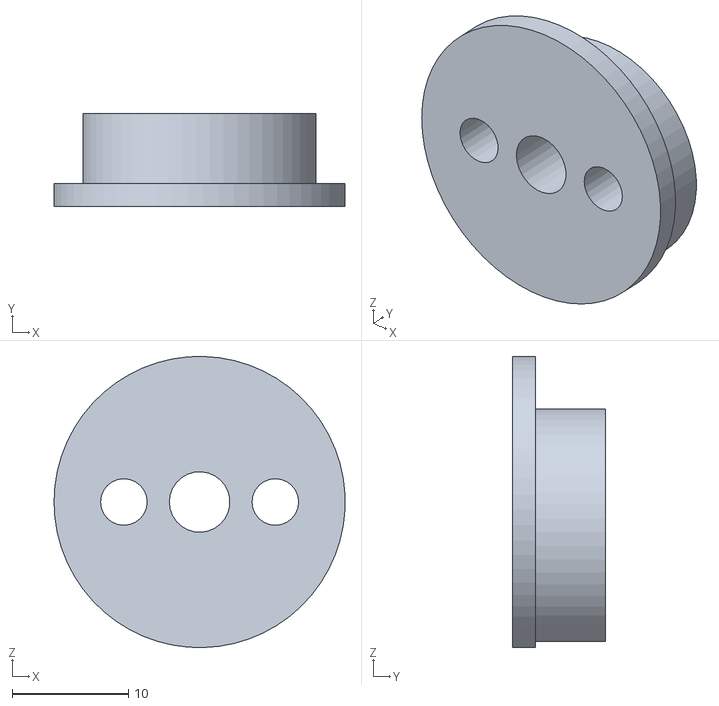
[picture p41: CAD file, 2026-10-17]
ARD_hardware/CY300210M4_v1/s2.stl
25.0 x 8.00 x 25.0
