khw1566/ARD/ARD_hardware/HMI_v1/bor.stl

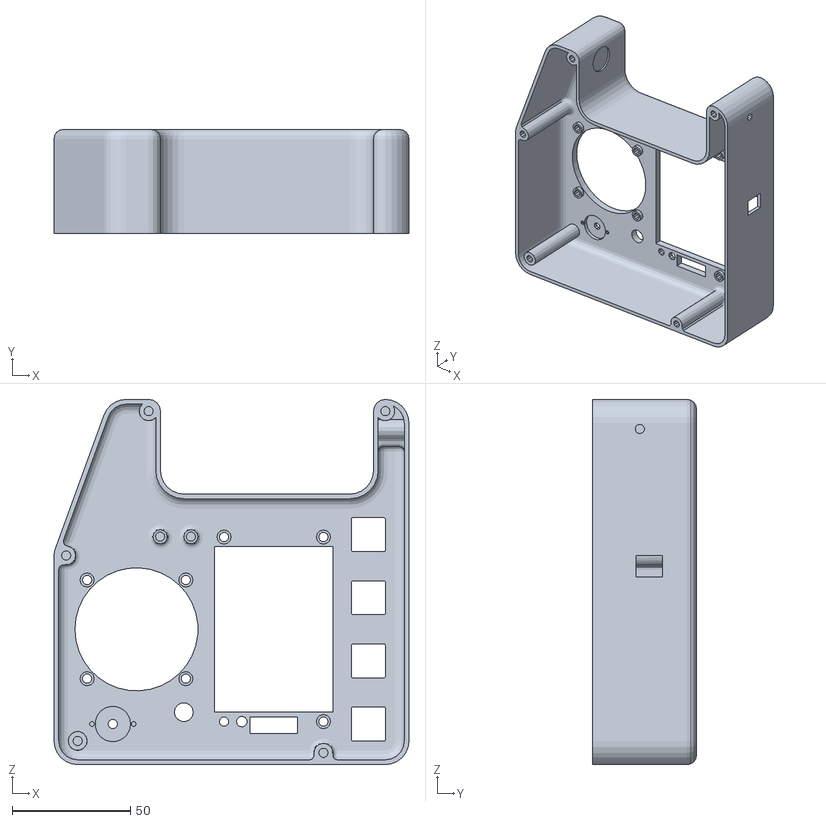
[picture p42: CAD file, 2026-10-17]
ARD_hardware/HMI_v1/bor.stl
150.0 x 44.0 x 154.3
