khw1566/ARD/ARD_hardware/PL121248Drive_v1/R2-v2.stl

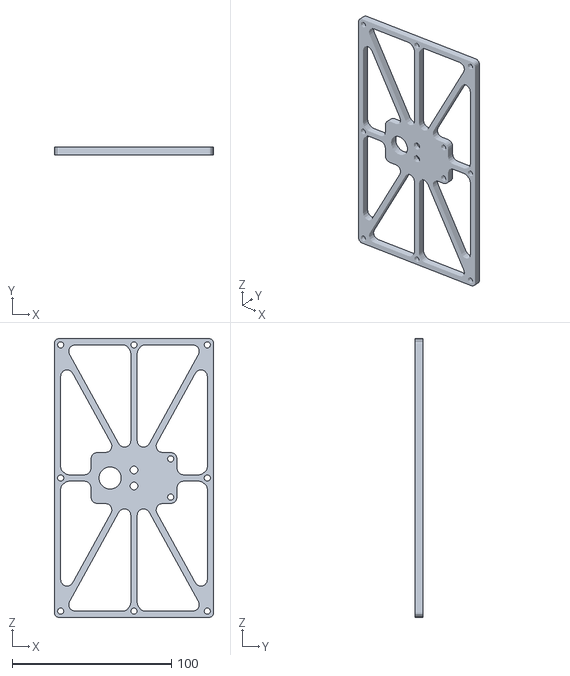
[picture p44: CAD file, 2026-10-17]
ARD_hardware/PL121248Drive_v1/R2-v2.stl
100.0 x 5.00 x 175.0
