khw1566/ARD/ARD_hardware/PL121248m2Drive_v2/roter.stl

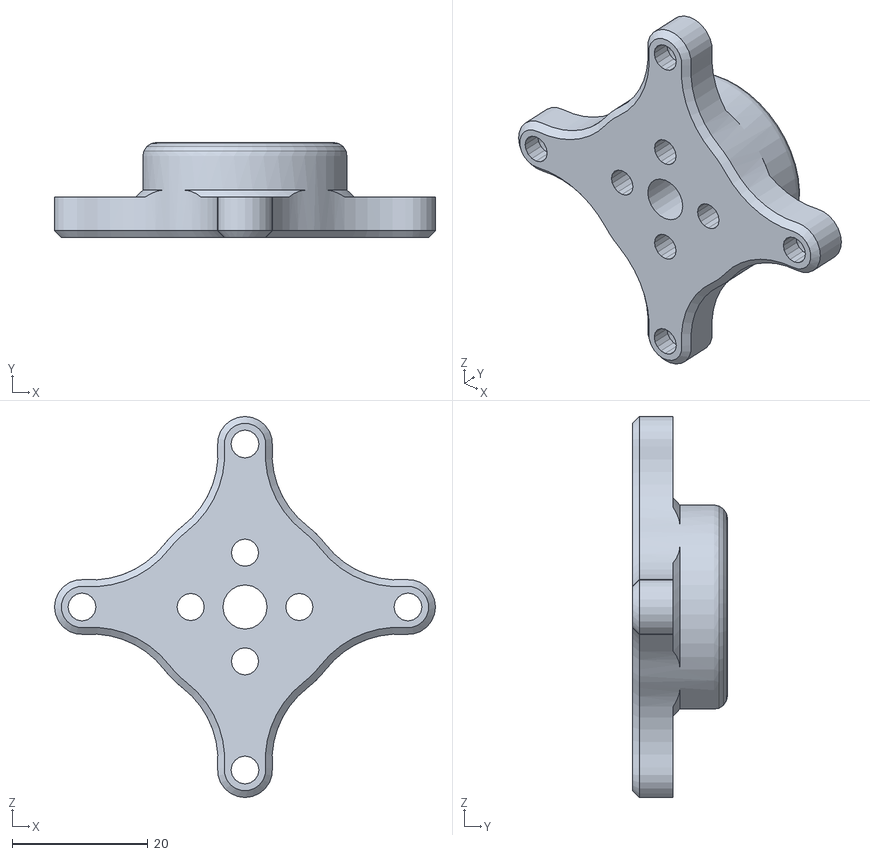
[picture p45: CAD file, 2026-10-17]
ARD_hardware/PL121248m2Drive_v2/roter.stl
56.1 x 14.0 x 56.1
