khw1566/ARD/ARD_hardware/PneumaticGripper_v2/rod-fixing parts.stl

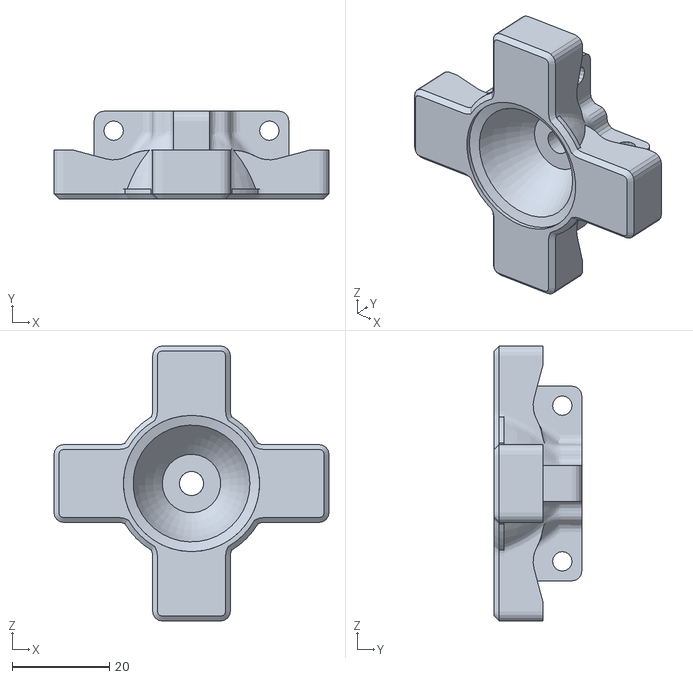
[picture p46: CAD file, 2026-10-17]
ARD_hardware/PneumaticGripper_v2/rod-fixing parts.stl
56.5 x 18.0 x 56.5
