khw1566/ARD/ARD_hardware/PneumaticGripper_v2/TONGS SE/O-RING_L.stl

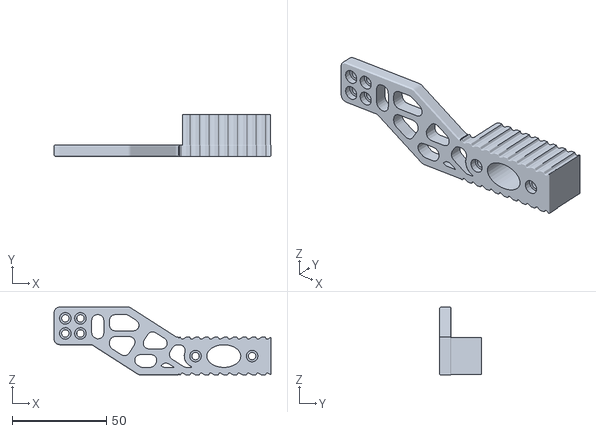
[picture p47: CAD file, 2026-10-17]
ARD_hardware/PneumaticGripper_v2/TONGS SE/O-RING_L.stl
115.0 x 22.0 x 36.0
