khw1566/ARD/ARD_hardware/RA_Project/clap/Tongs_L.stl

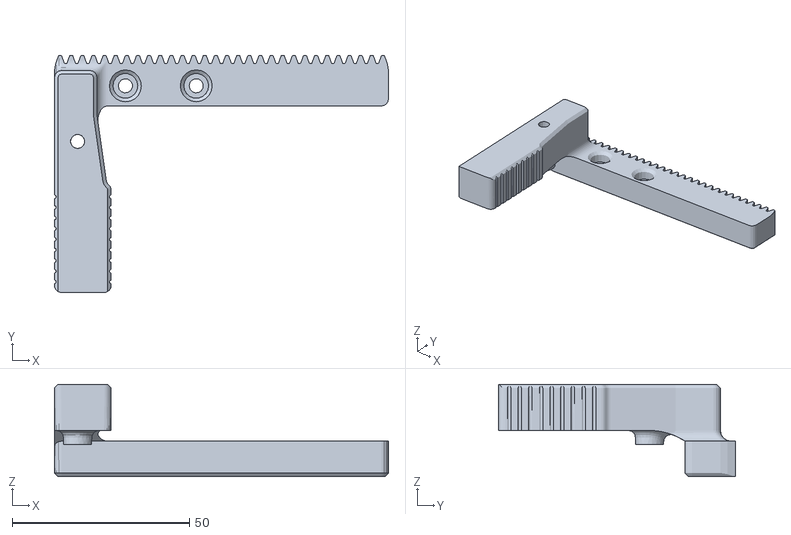
[picture p48: CAD file, 2026-10-17]
ARD_hardware/RA_Project/clap/Tongs_L.stl
94.2 x 66.9 x 26.0
