khw1566/ARD/ARD_hardware/RA_Project/Head/GT2 Timing Belt Fixation.stl

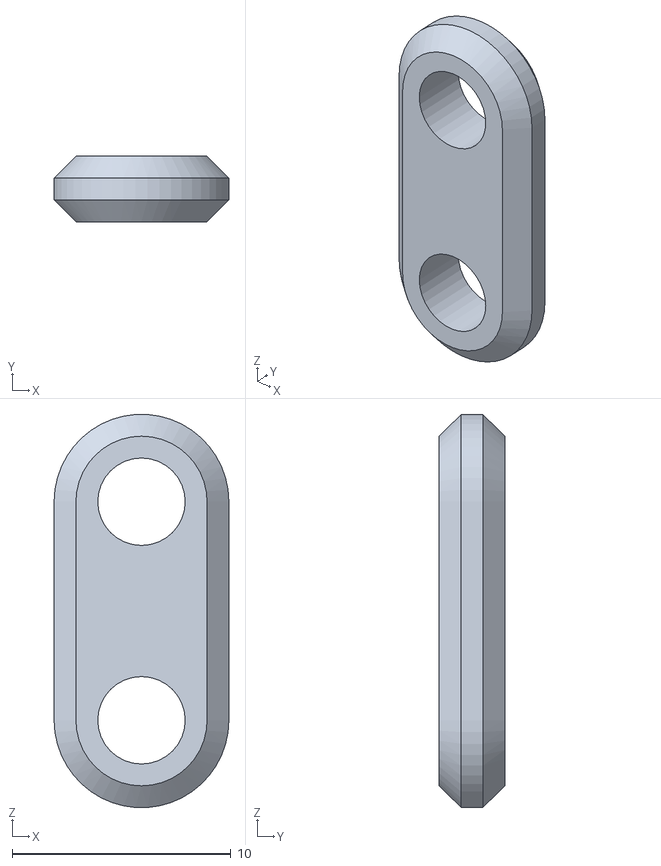
[picture p49: CAD file, 2026-10-17]
ARD_hardware/RA_Project/Head/GT2 Timing Belt Fixation.stl
8.00 x 3.00 x 18.0
