khw1566/ARD/ARD_hardware/RA_Project/Substrate/TOP Board.stl

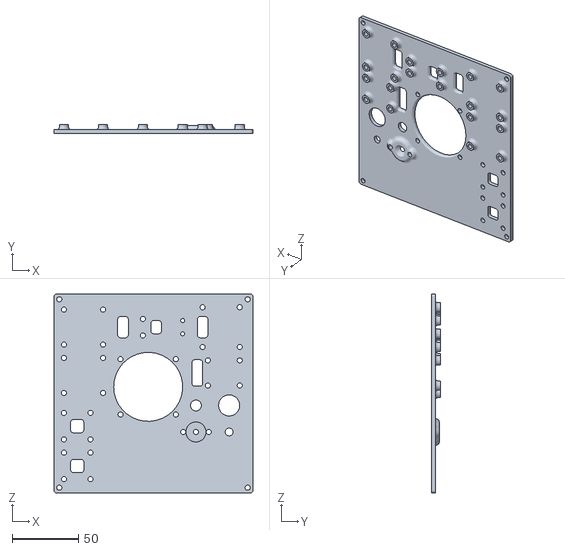
[picture p50: CAD file, 2026-10-17]
ARD_hardware/RA_Project/Substrate/TOP Board.stl
150.0 x 7.00 x 150.0
