khw1566/ARD/ARD_hardware/RA_Project/Y-axis - pulley support plate.stl

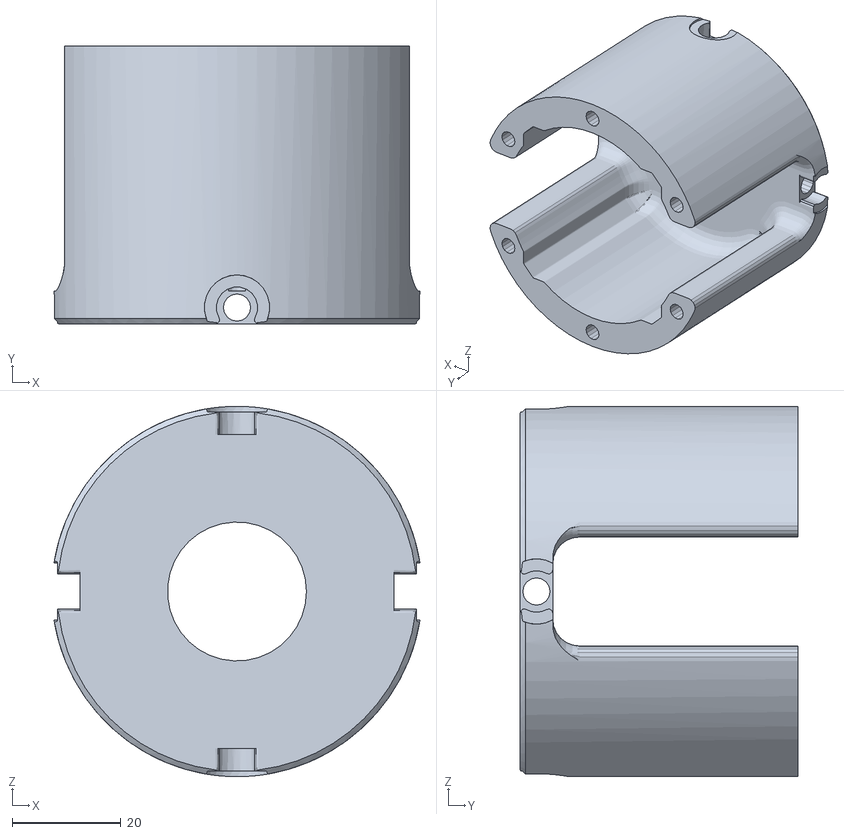
[picture p51: CAD file, 2026-10-17]
ARD_hardware/RA_Project/Y-axis - pulley support plate.stl
67.2 x 51.0 x 68.0
