khw1566/ARD/ARD_hardware/RA_Project/Z-axis mover parts/Z-axis mover 2.stl

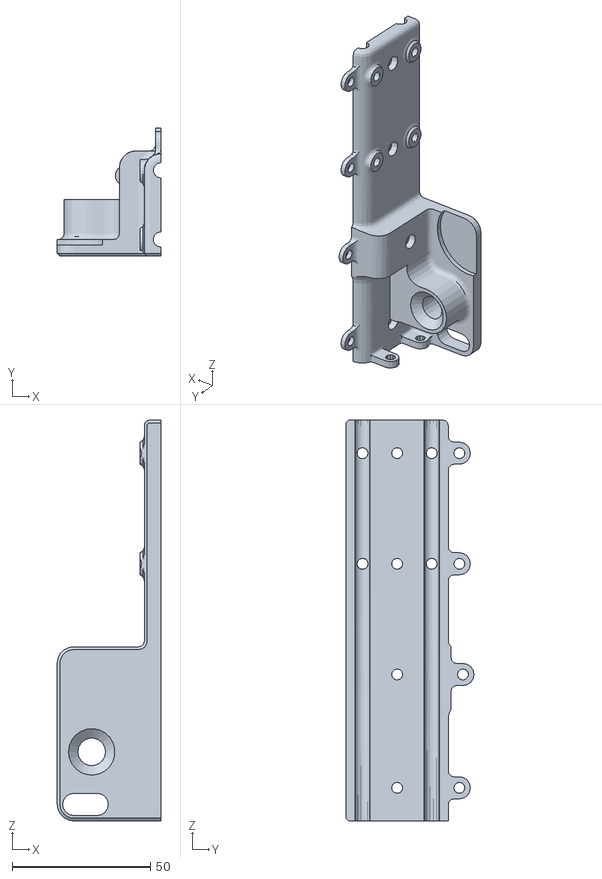
[picture p52: CAD file, 2026-10-17]
ARD_hardware/RA_Project/Z-axis mover parts/Z-axis mover 2.stl
37.5 x 46.3 x 145.0
