khw1566/ARD/ARD_hardware/Rali_v2/stand118_v3.stl

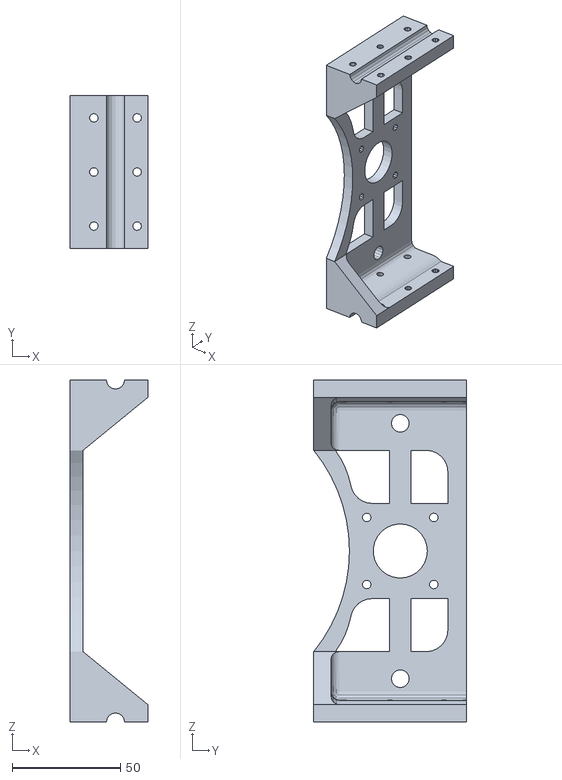
[picture p53: CAD file, 2026-10-26]
ARD_hardware/Rali_v2/stand118_v3.stl
36.0 x 70.5 x 158.0
