khw1566/ARD/ARD_hardware/SCARA_v1/Front-Wheel Bracket.stl

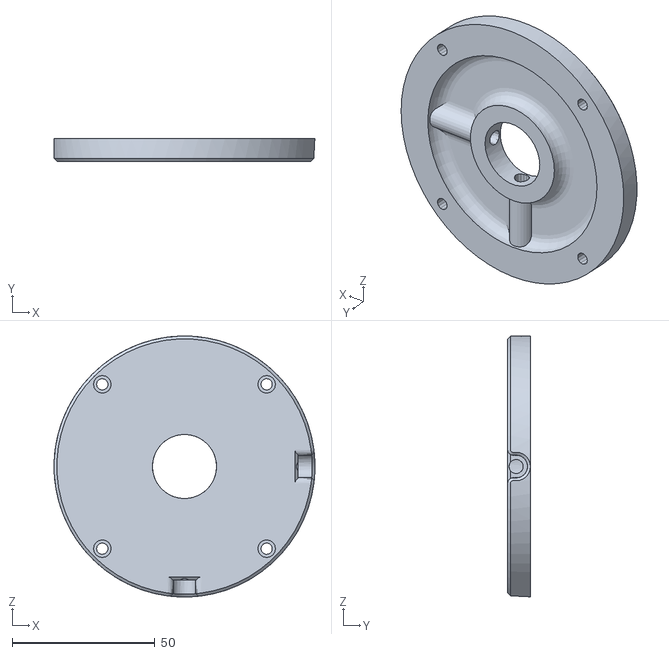
[picture p54: CAD file, 2026-10-17]
ARD_hardware/SCARA_v1/Front-Wheel Bracket.stl
91.5 x 8.00 x 91.5
