khw1566/ARD/ARD_hardware/TRCR_Project/TRCRv1/disk_v4/dick3_v3.stl

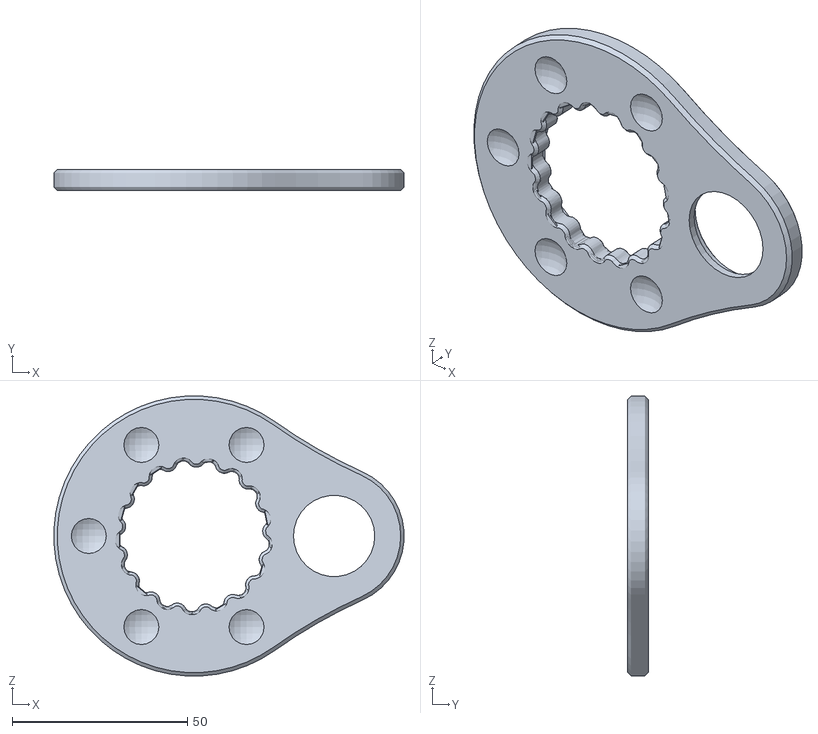
[picture p55: CAD file, 2026-10-17]
ARD_hardware/TRCR_Project/TRCRv1/disk_v4/dick3_v3.stl
99.9 x 6.00 x 79.9
