khw1566/ARD/ARD_hardware/TRCR_Project/TRCRv1/s3.stl

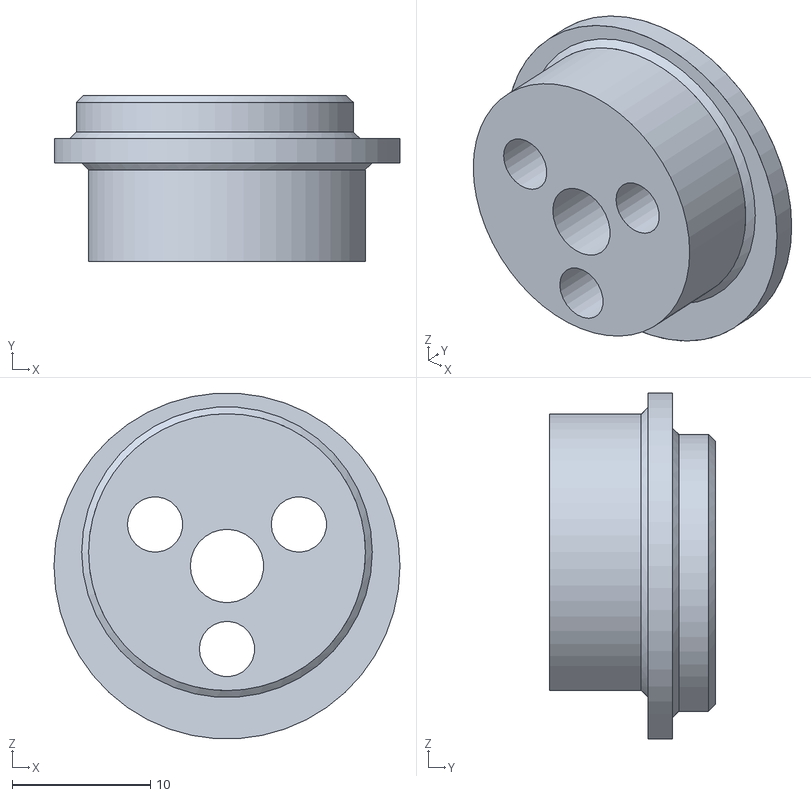
[picture p56: CAD file, 2026-10-17]
ARD_hardware/TRCR_Project/TRCRv1/s3.stl
25.0 x 12.0 x 25.0
