khw1566/ARD/영상제작용 CAD파일/베벨기어 구조가 제거된 나머지 부분들.stl

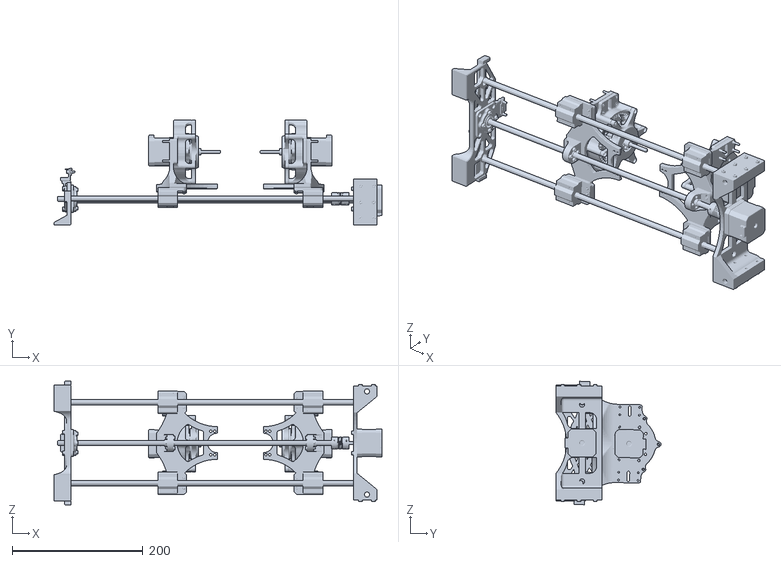
[picture p57: CAD file, 2026-10-26]
영상제작용 CAD파일/베벨기어 구조가 제거된 나머지 부분들.stl
502.5 x 160.9 x 189.3
