khw1566/ARD/ARD_hardware/ARD_Model_v1/1/A.stl

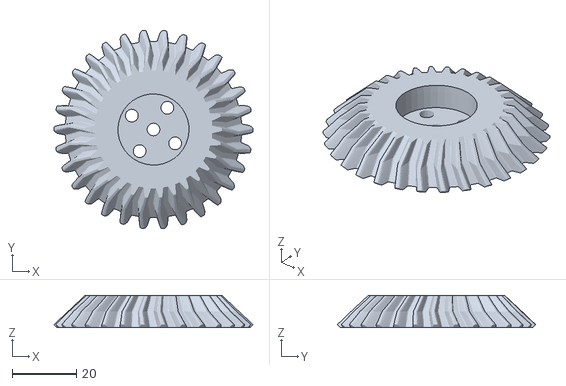
[picture p58: CAD file, 2026-10-17]
ARD_hardware/ARD_Model_v1/1/A.stl
61.9 x 61.7 x 10.0
