khw1566/ARD/ARD_hardware/ARD_Model_v1/coupler/c1ipt.stl

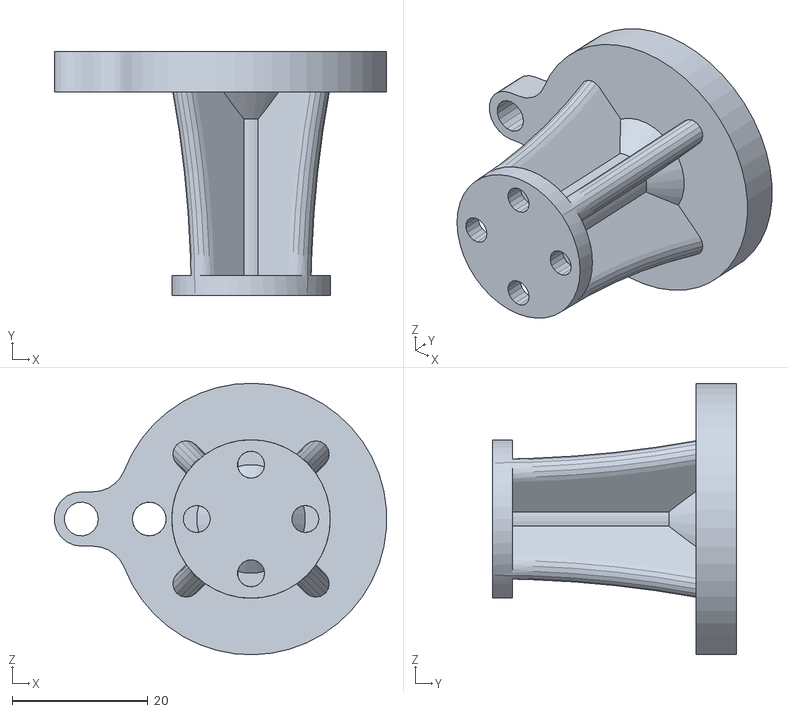
[picture p59: CAD file, 2026-10-17]
ARD_hardware/ARD_Model_v1/coupler/c1ipt.stl
48.9 x 36.0 x 40.0
