khw1566/ARD/ARD_hardware/ARD_Model_v1/e1.stl

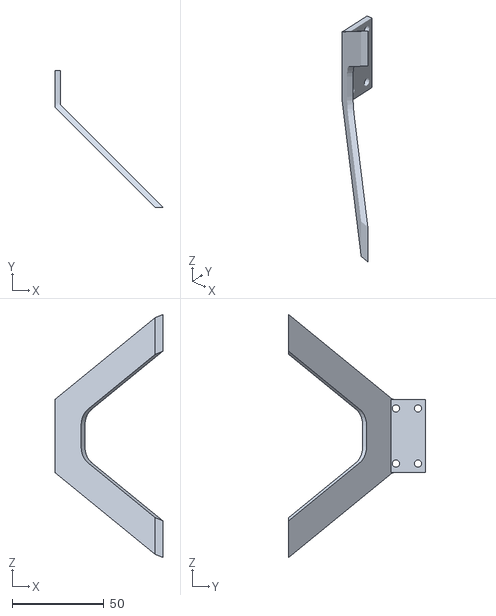
[picture p60: CAD file, 2026-10-17]
ARD_hardware/ARD_Model_v1/e1.stl
58.7 x 74.4 x 132.4
