khw1566/ARD/ARD_hardware/Control Box_v1/side.stl

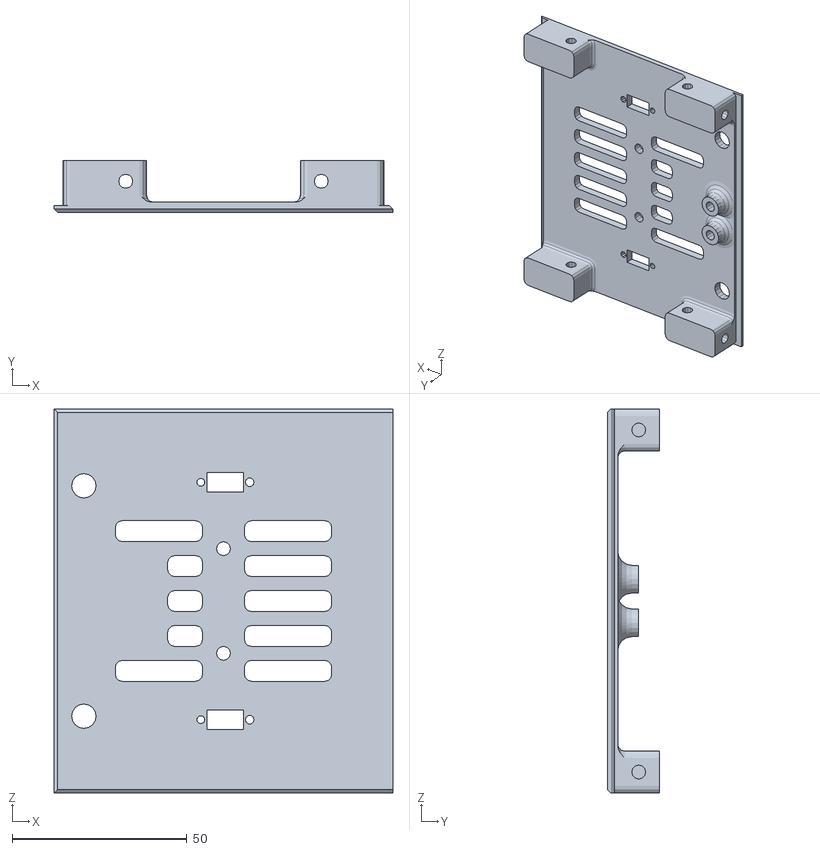
[picture p61: CAD file, 2026-10-17]
ARD_hardware/Control Box_v1/side.stl
97.0 x 15.0 x 110.0
