khw1566/ARD/ARD_hardware/CY300210_v1/s1.stl

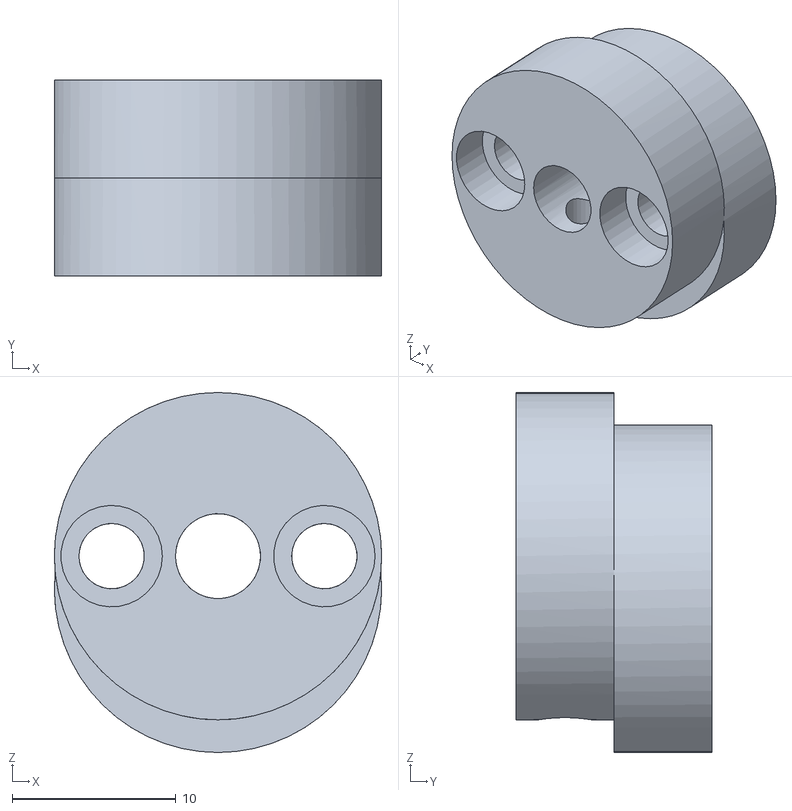
[picture p63: CAD file, 2026-10-17]
ARD_hardware/CY300210_v1/s1.stl
20.0 x 12.0 x 22.0
