khw1566/ARD/ARD_hardware/CY300210M4_v1/gear.stl

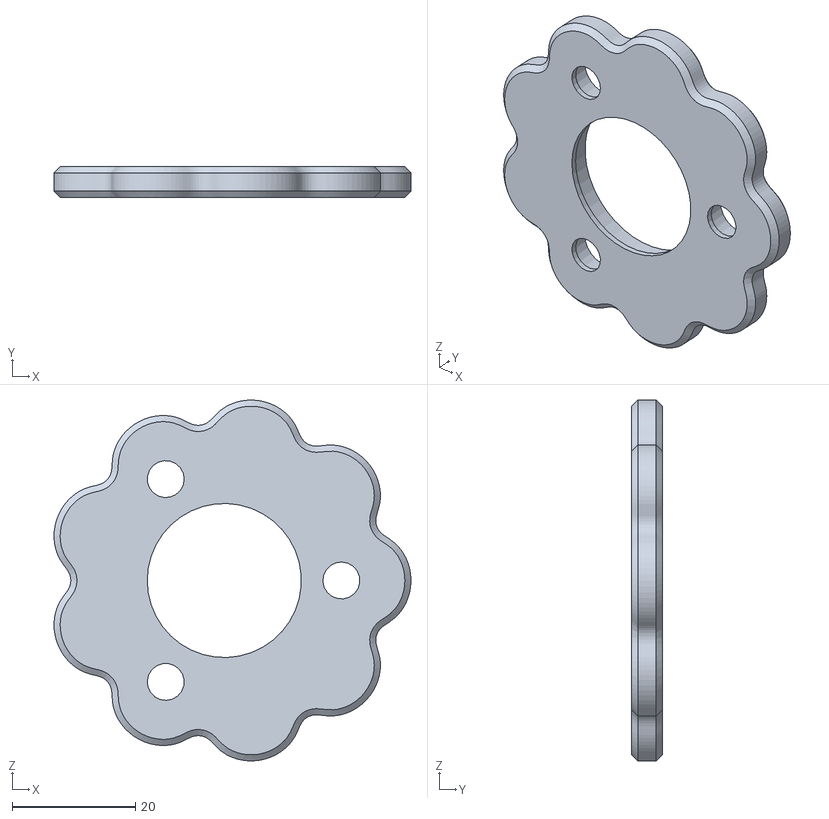
[picture p64: CAD file, 2026-10-17]
ARD_hardware/CY300210M4_v1/gear.stl
57.9 x 5.00 x 58.5
