khw1566/ARD/ARD_hardware/CY300210M8_v1/casing.stl

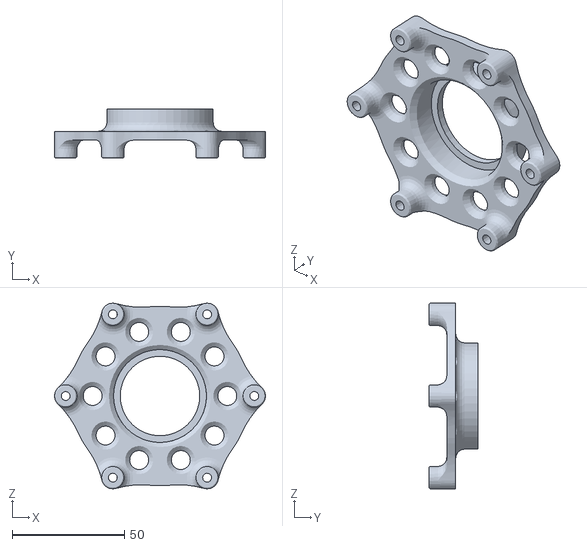
[picture p65: CAD file, 2026-10-17]
ARD_hardware/CY300210M8_v1/casing.stl
94.0 x 22.0 x 82.7
