khw1566/ARD/ARD_hardware/M4 stand/m4 stand.stl

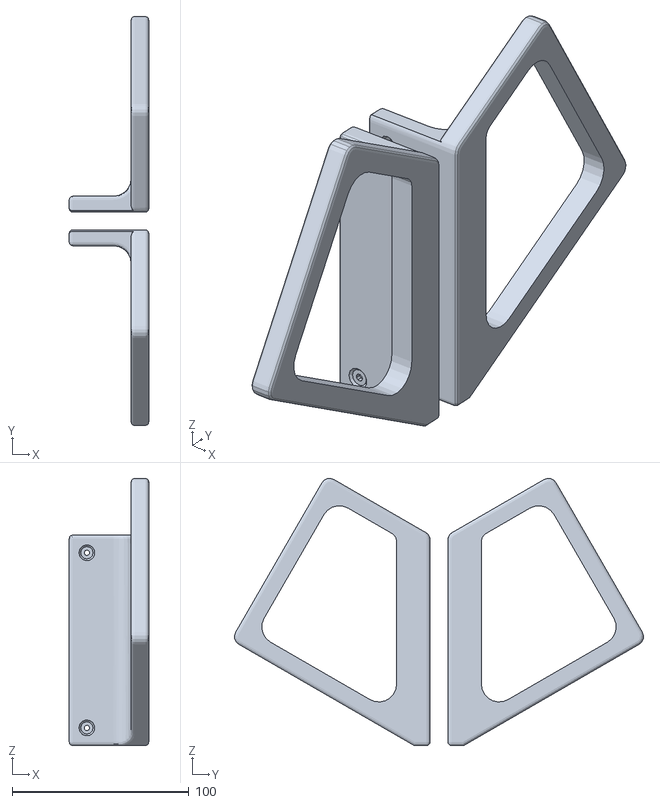
[picture p66: CAD file, 2026-10-26]
ARD_hardware/M4 stand/m4 stand.stl
45.0 x 231.2 x 151.0
