khw1566/ARD/ARD_hardware/PL121248Drive_v1/pl_v1.stl

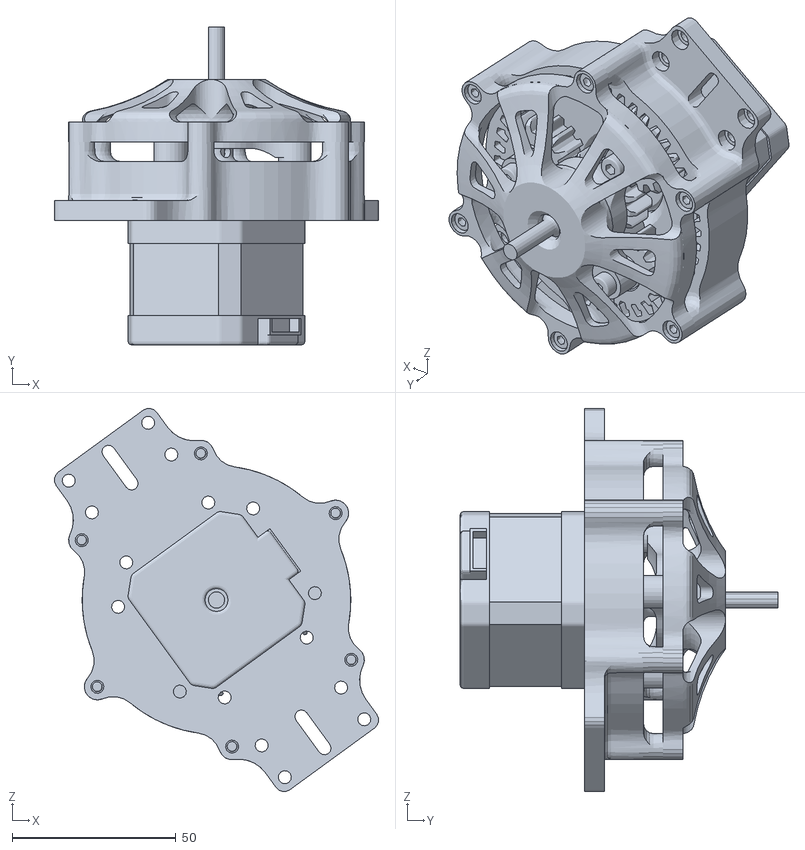
[picture p67: CAD file, 2026-10-17]
ARD_hardware/PL121248Drive_v1/pl_v1.stl
98.9 x 97.0 x 116.9
