khw1566/ARD/ARD_hardware/PL121248m2Drive_v2/pl_v2.stl

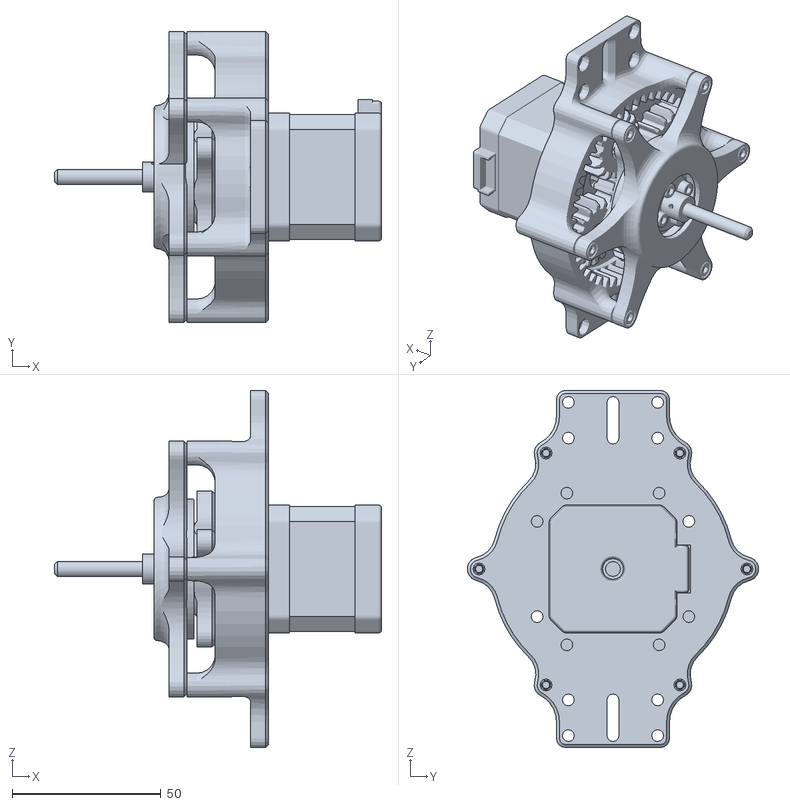
[picture p68: CAD file, 2026-10-17]
ARD_hardware/PL121248m2Drive_v2/pl_v2.stl
110.0 x 97.9 x 120.0
