khw1566/ARD/ARD_hardware/PneumaticGripper_v2/PneumaticGripper_v2.stl

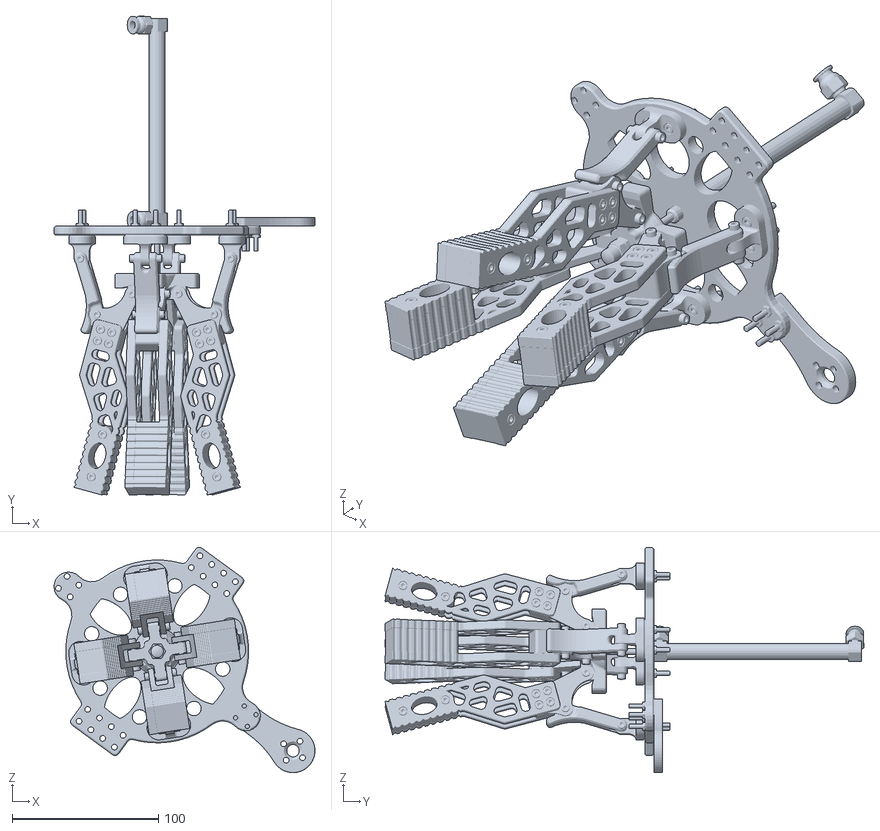
[picture p69: CAD file, 2026-10-17]
ARD_hardware/PneumaticGripper_v2/PneumaticGripper_v2.stl
178.4 x 327.0 x 154.0
