khw1566/ARD/ARD_hardware/PneumaticGripper_v2/TONGS SE/O-RING_R.stl

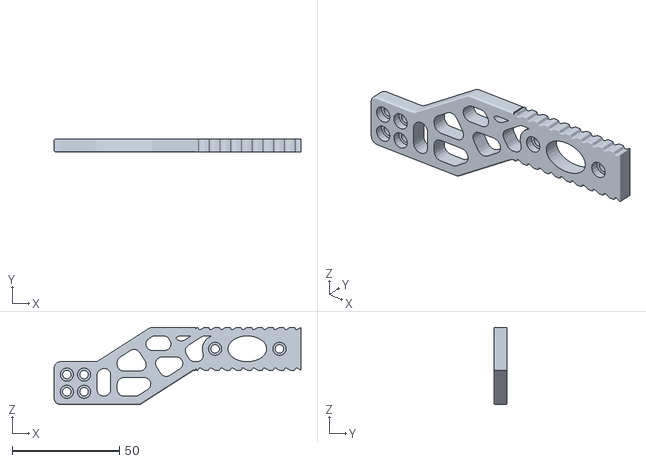
[picture p70: CAD file, 2026-10-17]
ARD_hardware/PneumaticGripper_v2/TONGS SE/O-RING_R.stl
115.0 x 6.00 x 36.0
