khw1566/ARD/ARD_hardware/RA_Project/clap/weight gasket.stl

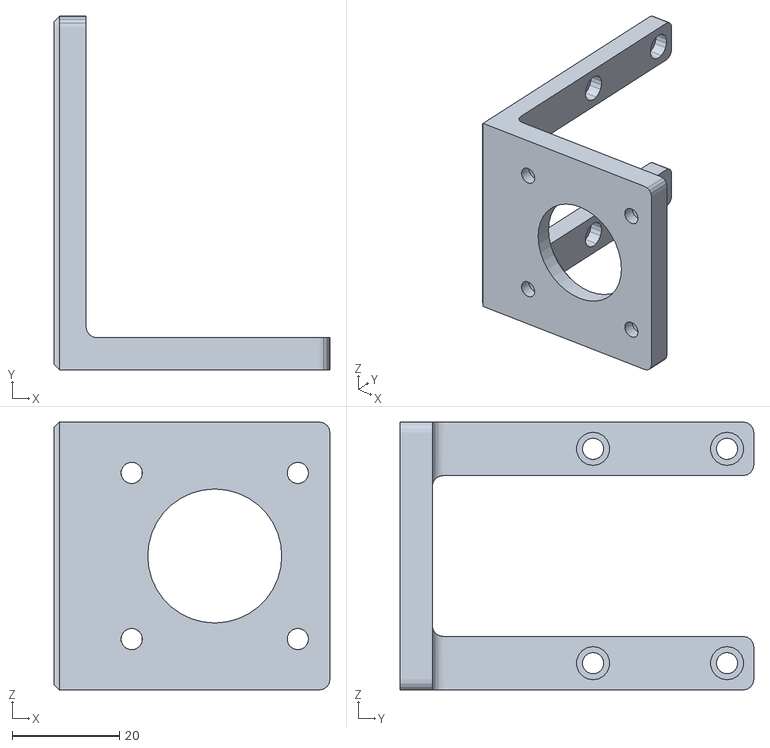
[picture p71: CAD file, 2026-10-17]
ARD_hardware/RA_Project/clap/weight gasket.stl
51.5 x 66.0 x 50.0
