khw1566/ARD/ARD_hardware/RA_Project/Head/Head connection and motor stator.stl

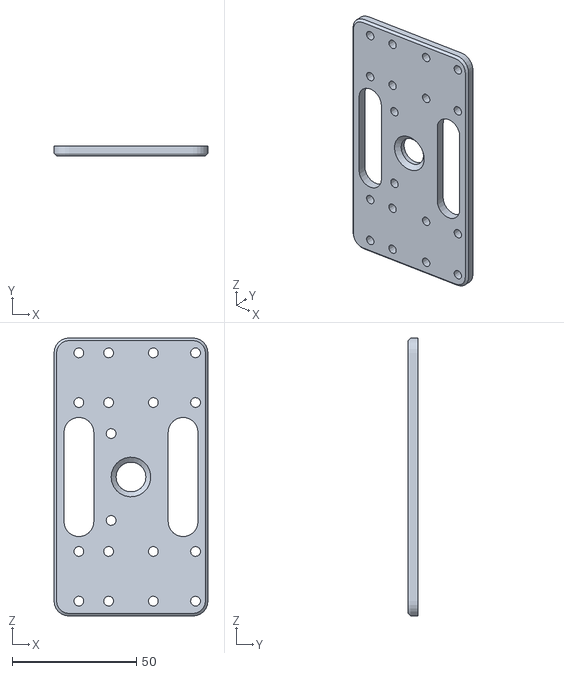
[picture p72: CAD file, 2026-10-17]
ARD_hardware/RA_Project/Head/Head connection and motor stator.stl
62.0 x 4.00 x 112.0
