khw1566/ARD/ARD_hardware/RA_Project/Substrate/Power board.stl

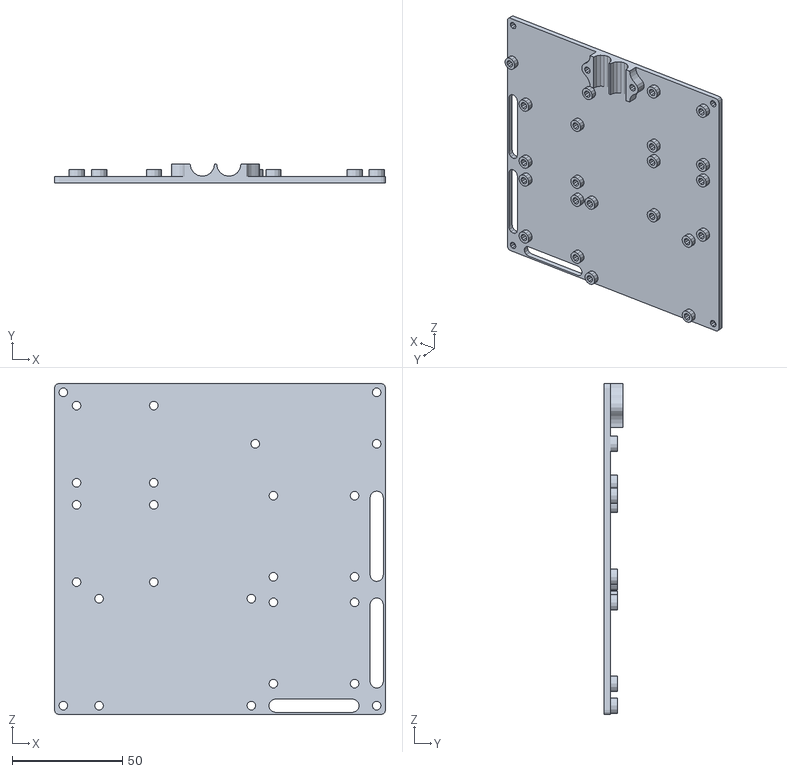
[picture p73: CAD file, 2026-10-17]
ARD_hardware/RA_Project/Substrate/Power board.stl
150.0 x 8.50 x 150.0
