khw1566/ARD/ARD_hardware/RA_Project/Support fixing.stl

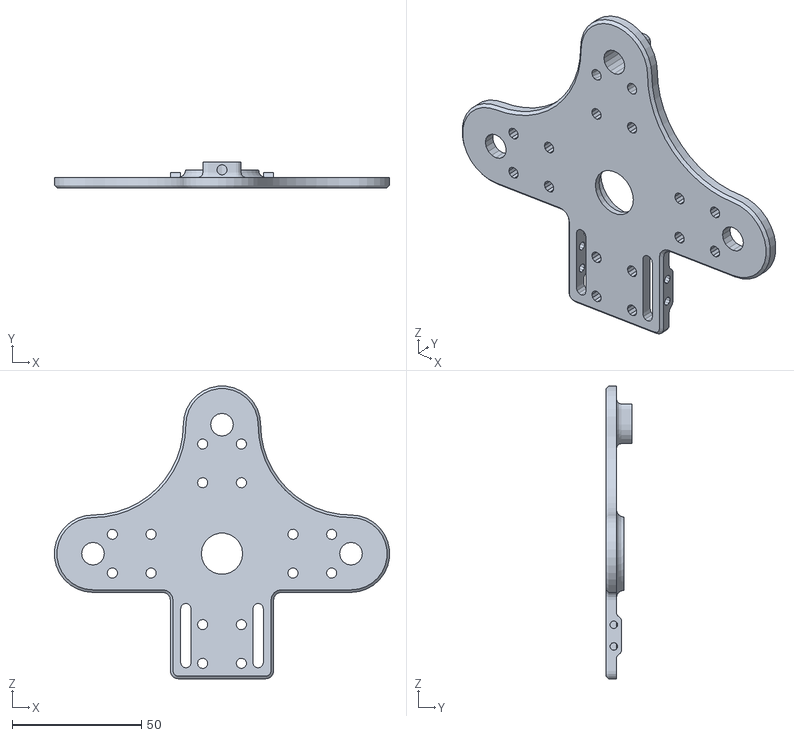
[picture p74: CAD file, 2026-10-17]
ARD_hardware/RA_Project/Support fixing.stl
129.8 x 10.0 x 113.4
