khw1566/ARD/ARD_hardware/RA_Project/Z-axis mover parts/Z-axis mover 1.stl

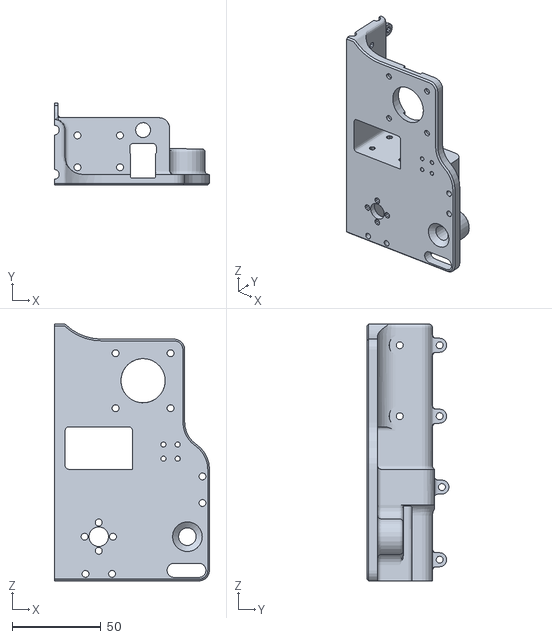
[picture p75: CAD file, 2026-10-17]
ARD_hardware/RA_Project/Z-axis mover parts/Z-axis mover 1.stl
87.5 x 46.3 x 145.0
