khw1566/ARD/영상제작용 CAD파일/베벨기어 하단부.stl

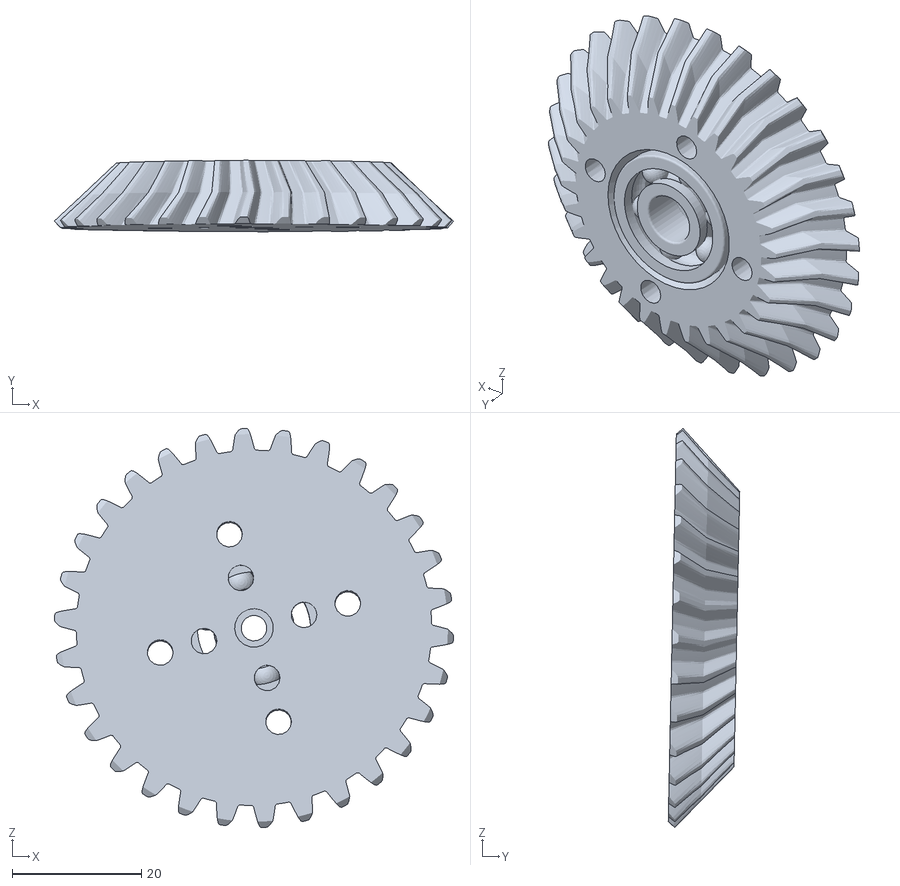
[picture p77: CAD file, 2026-10-26]
영상제작용 CAD파일/베벨기어 하단부.stl
61.7 x 11.1 x 61.8
