khw1566/ARD/ARD_hardware/ARD_Model_v1/0402.stl

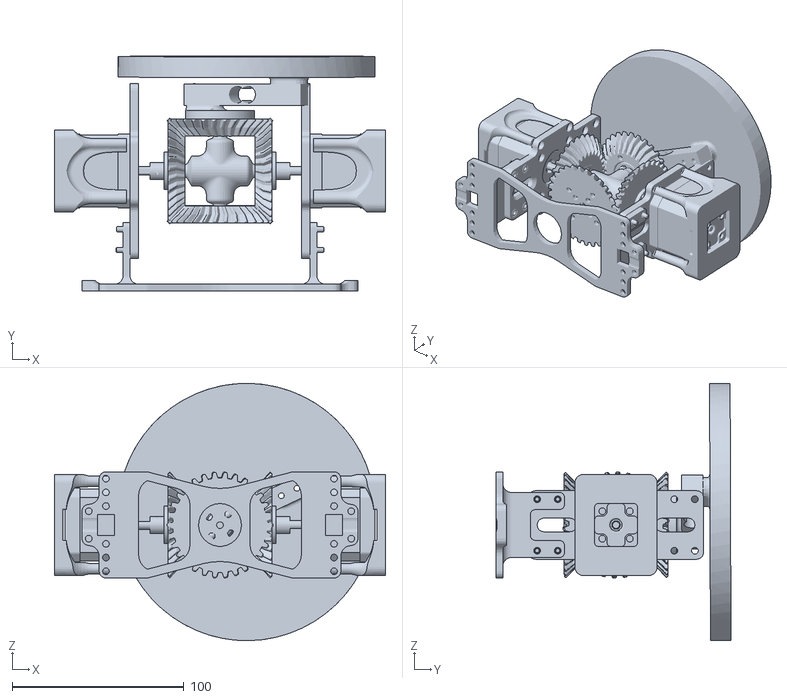
[picture p78: CAD file, 2026-10-17]
ARD_hardware/ARD_Model_v1/0402.stl
193.0 x 137.0 x 150.0
