khw1566/ARD/ARD_hardware/ARD_Model_v1/1/B_v2.stl

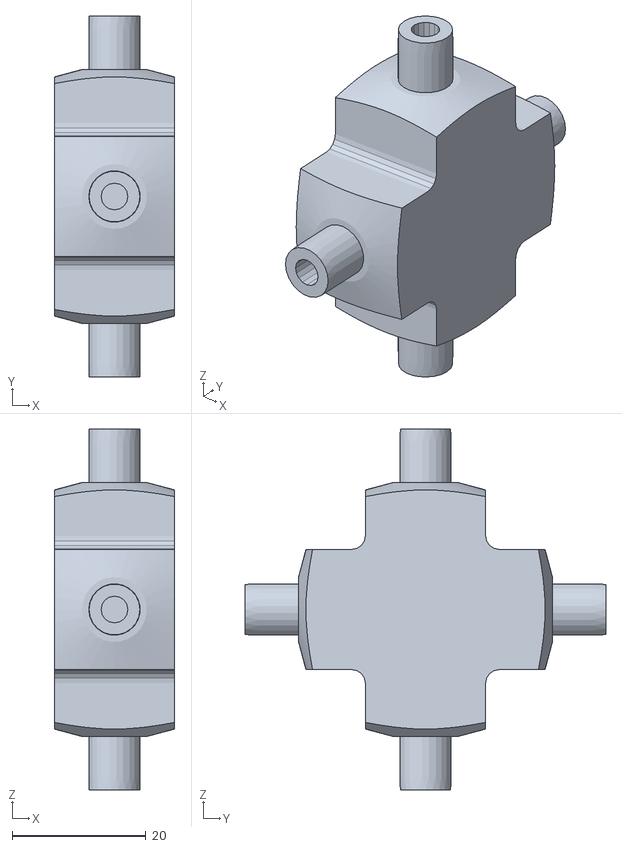
[picture p79: CAD file, 2026-10-17]
ARD_hardware/ARD_Model_v1/1/B_v2.stl
18.0 x 54.0 x 54.0
