khw1566/ARD/ARD_hardware/Control Box_v1/BACK.stl

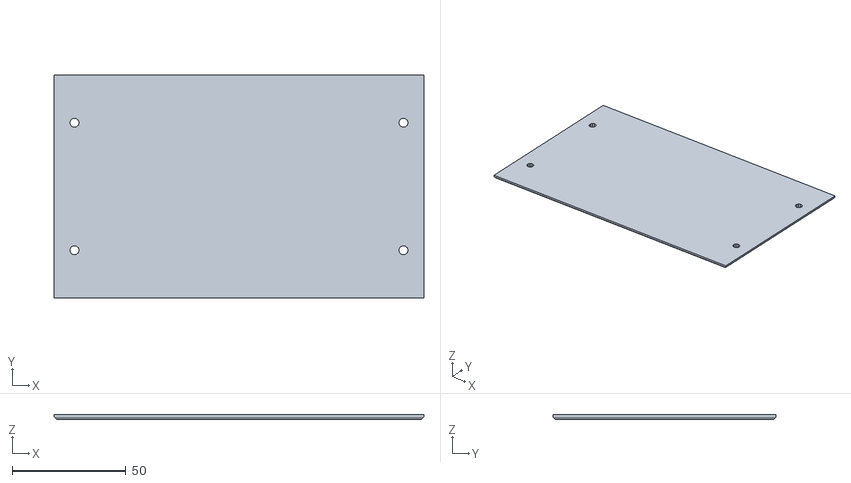
[picture p80: CAD file, 2026-10-17]
ARD_hardware/Control Box_v1/BACK.stl
162.5 x 98.0 x 2.00
