khw1566/ARD/ARD_hardware/CY300208M4_v1/disk.stl

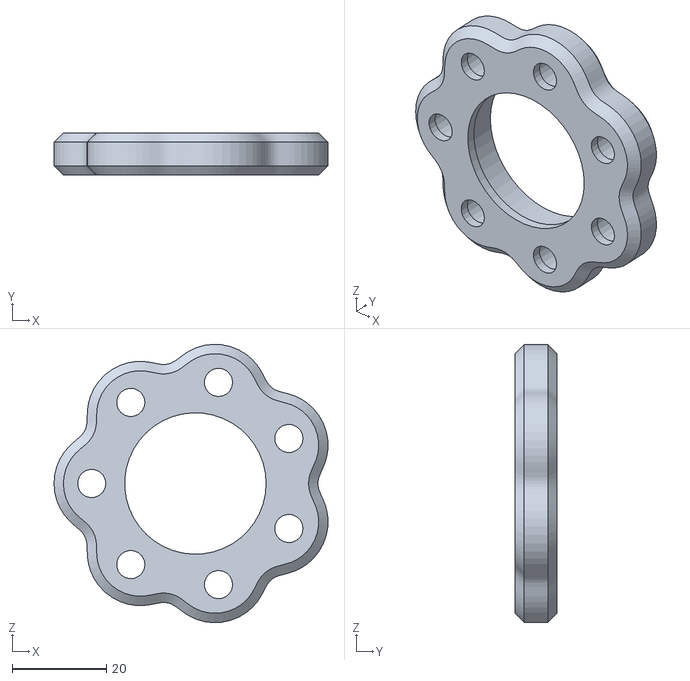
[picture p81: CAD file, 2026-10-17]
ARD_hardware/CY300208M4_v1/disk.stl
58.1 x 9.00 x 59.0
