khw1566/ARD/ARD_hardware/CY300210M4_v1/s2_v2.stl

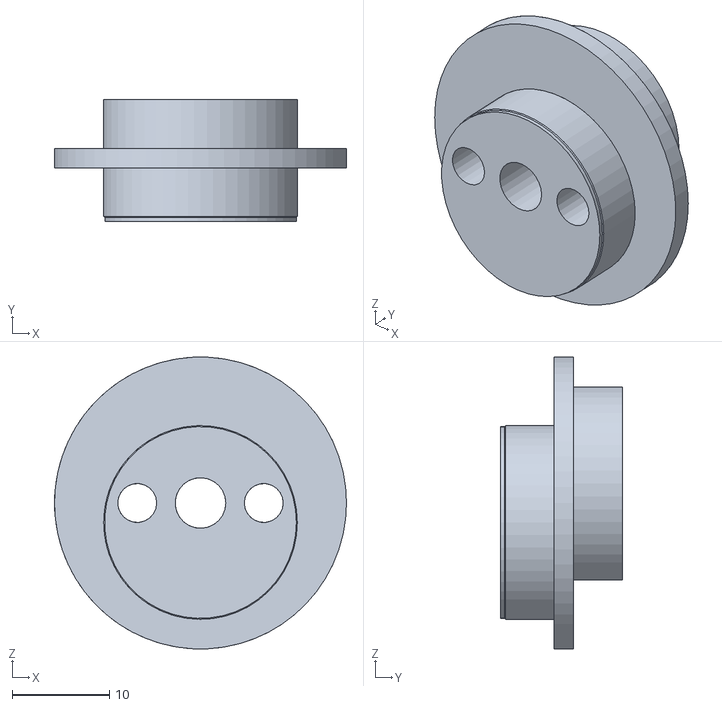
[picture p82: CAD file, 2026-10-17]
ARD_hardware/CY300210M4_v1/s2_v2.stl
30.0 x 12.5 x 30.0
