khw1566/ARD/ARD_hardware/CY300210M8_v1/roter.stl

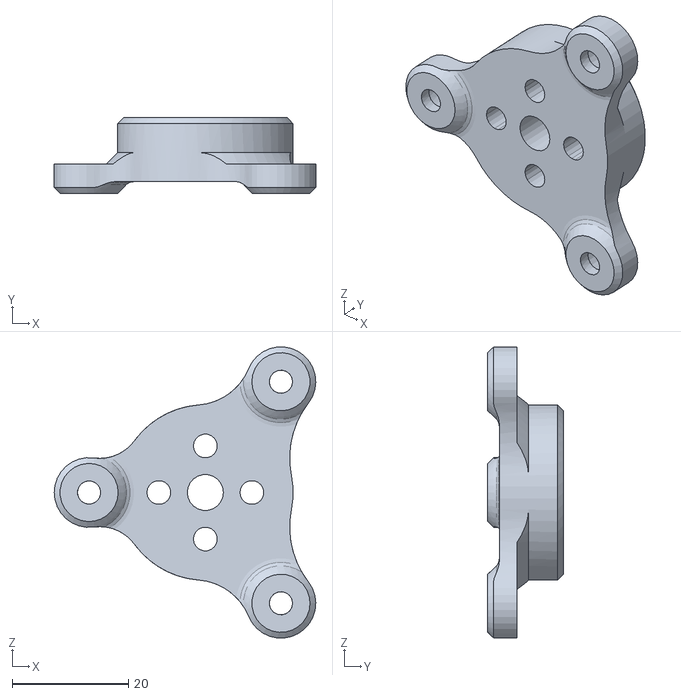
[picture p83: CAD file, 2026-10-17]
ARD_hardware/CY300210M8_v1/roter.stl
45.0 x 13.0 x 50.0
