khw1566/ARD/ARD_hardware/M4 stand/육망성 볼트.stl

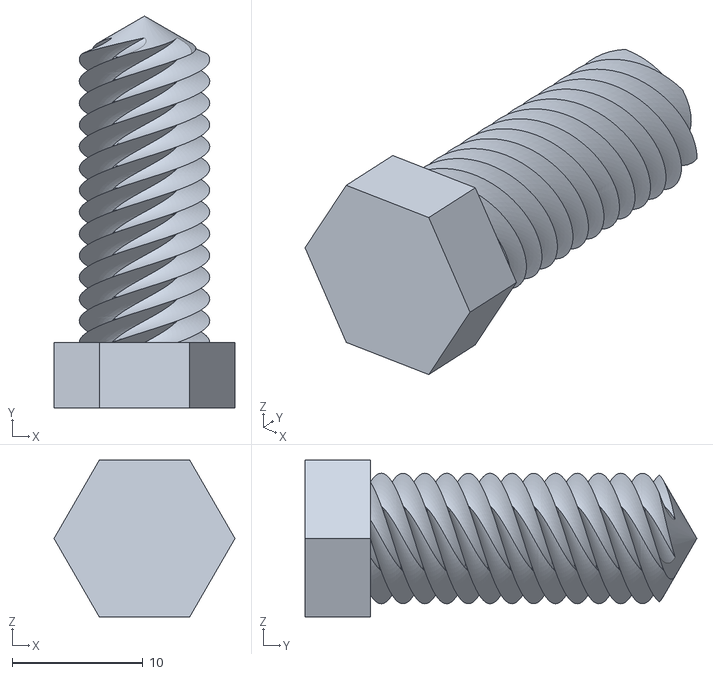
[picture p84: CAD file, 2026-10-26]
ARD_hardware/M4 stand/육망성 볼트.stl
13.9 x 30.0 x 12.0
