khw1566/ARD/ARD_hardware/PL121248Drive_v1/case.stl

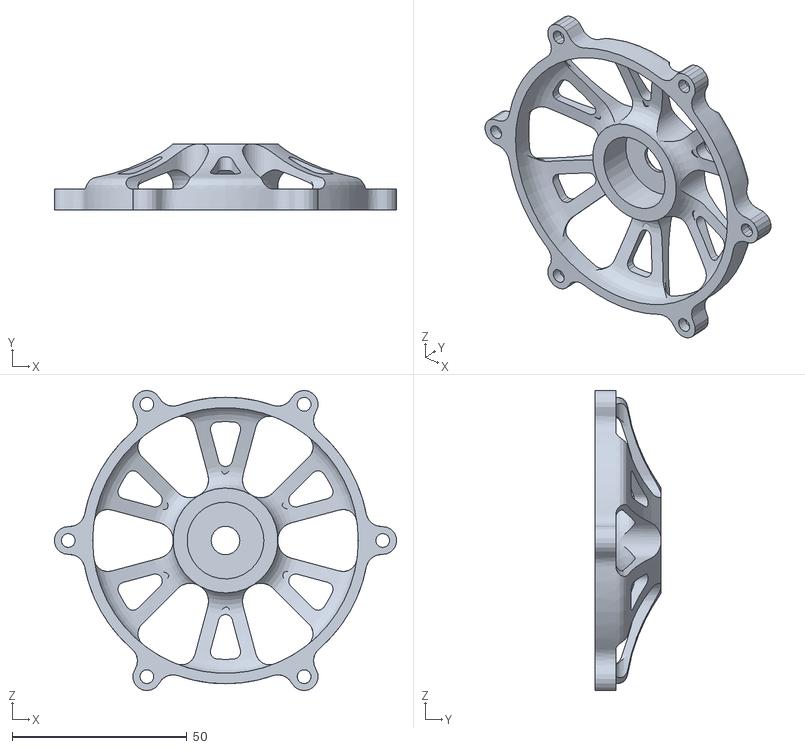
[picture p85: CAD file, 2026-10-17]
ARD_hardware/PL121248Drive_v1/case.stl
97.9 x 19.0 x 85.9
