khw1566/ARD/ARD_hardware/PL121248m2Drive_v2/gear_M1.5_Z48_H10.0_spur.stl

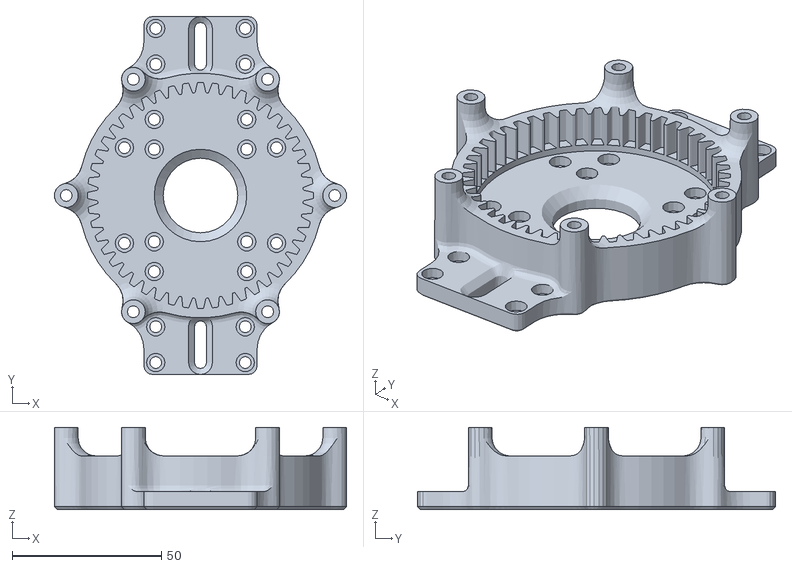
[picture p86: CAD file, 2026-10-17]
ARD_hardware/PL121248m2Drive_v2/gear_M1.5_Z48_H10.0_spur.stl
97.9 x 120.0 x 27.5
