khw1566/ARD/ARD_hardware/PneumaticGripper_v2/Link Parts.stl

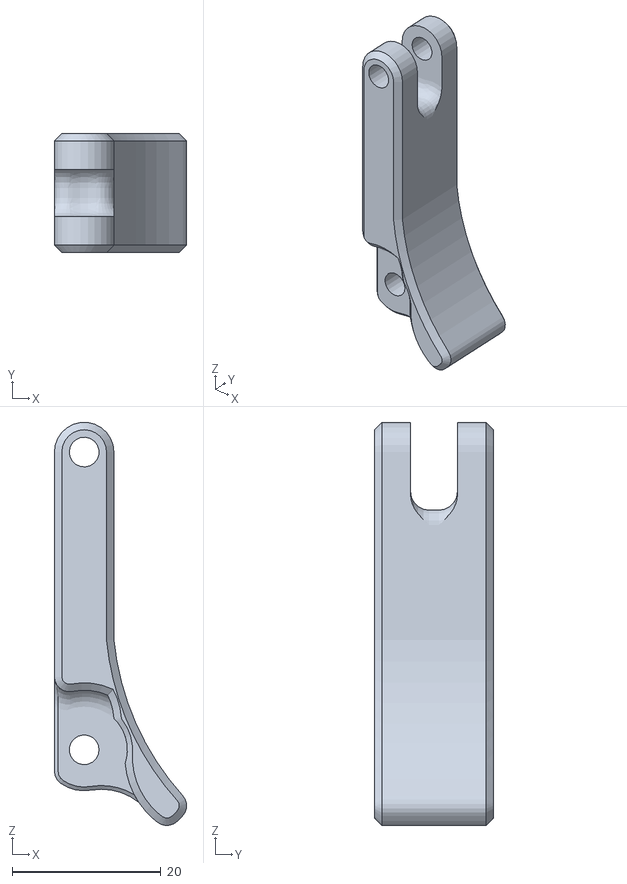
[picture p87: CAD file, 2026-10-17]
ARD_hardware/PneumaticGripper_v2/Link Parts.stl
17.8 x 16.0 x 54.1
