khw1566/ARD/ARD_hardware/RA_Project/clap/Tongs_R.stl

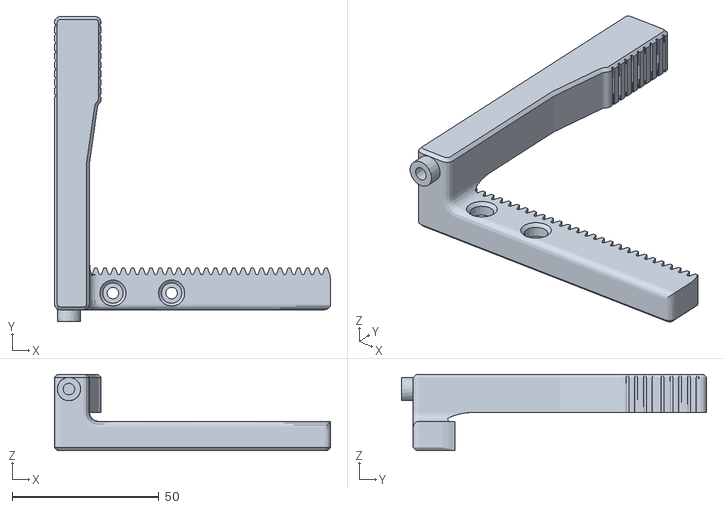
[picture p88: CAD file, 2026-10-17]
ARD_hardware/RA_Project/clap/Tongs_R.stl
94.2 x 104.0 x 26.0
