khw1566/ARD/ARD_hardware/RA_Project/Head/head stator.stl

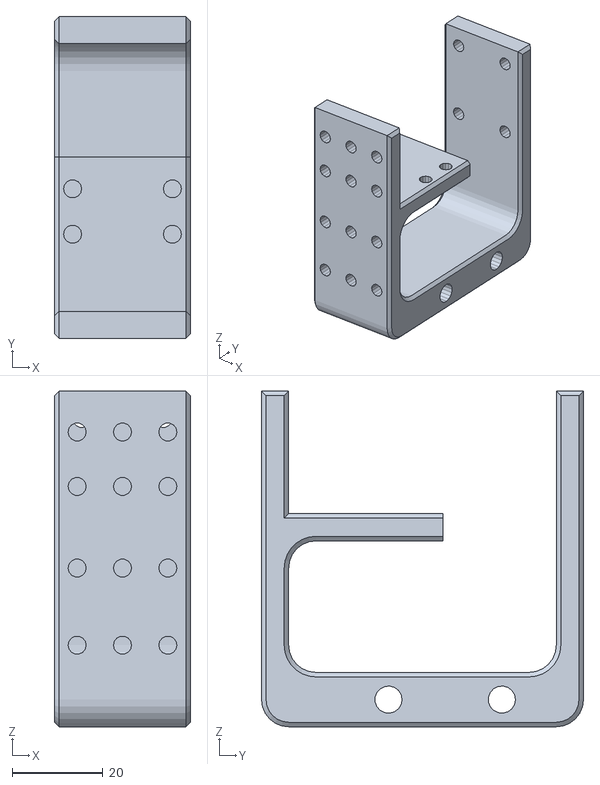
[picture p89: CAD file, 2026-10-17]
ARD_hardware/RA_Project/Head/head stator.stl
30.0 x 71.0 x 74.0
