khw1566/ARD/ARD_hardware/RA_Project/RA_v1.stl

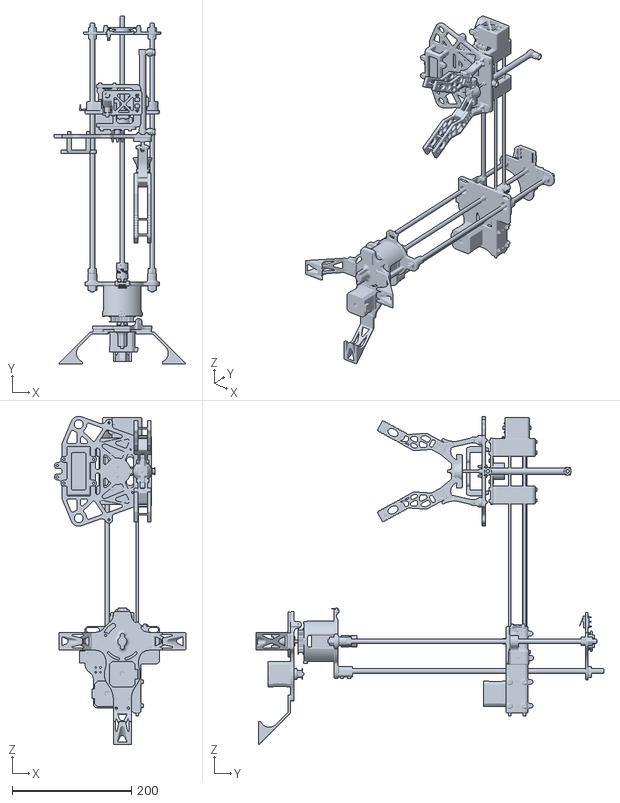
[picture p90: CAD file, 2026-10-17]
ARD_hardware/RA_Project/RA_v1.stl
220.3 x 583.0 x 550.2
