khw1566/ARD/ARD_hardware/RA_Project/Substrate/signal machine.stl

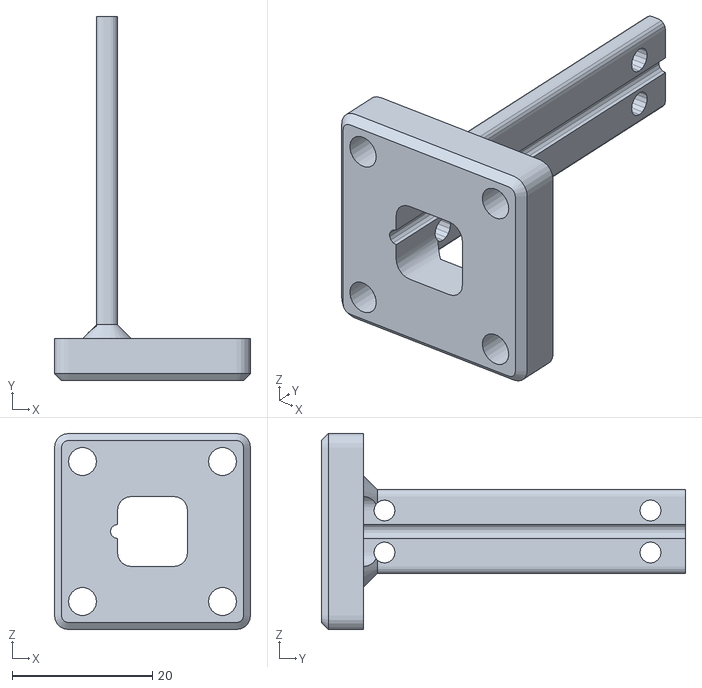
[picture p91: CAD file, 2026-10-17]
ARD_hardware/RA_Project/Substrate/signal machine.stl
28.0 x 52.0 x 28.0
