khw1566/ARD/ARD_hardware/Rali_v2/cam holder.stl

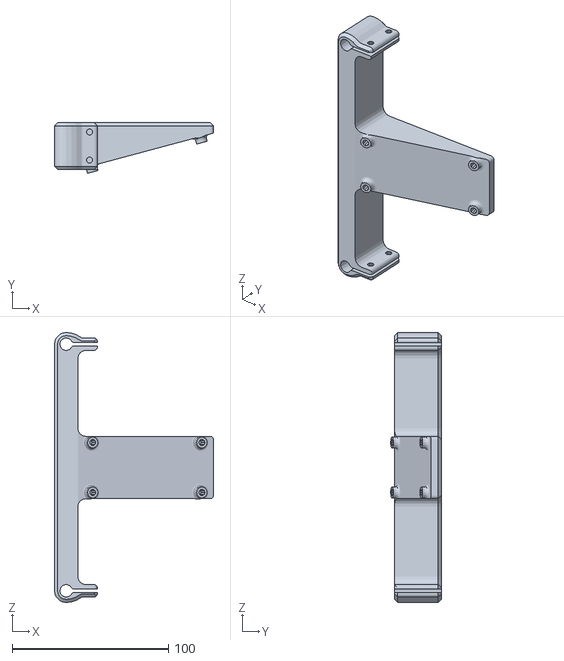
[picture p92: CAD file, 2026-10-26]
ARD_hardware/Rali_v2/cam holder.stl
101.9 x 32.5 x 173.0
