khw1566/ARD/영상제작용 CAD파일/베벨기어 중심 십자조인.stl

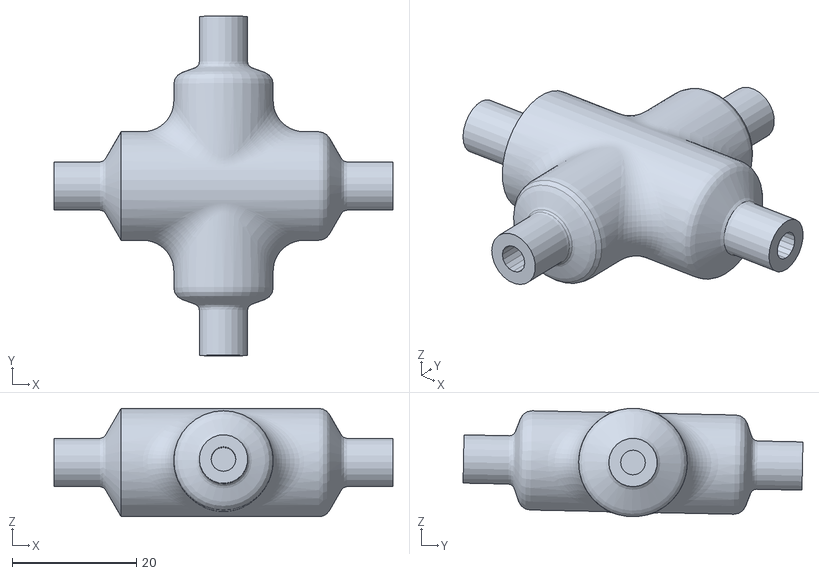
[picture p93: CAD file, 2026-10-26]
영상제작용 CAD파일/베벨기어 중심 십자조인.stl
54.6 x 54.8 x 17.5
