khw1566/ARD/ARD_hardware/ARD_Model_v1/as5600_holder.stl

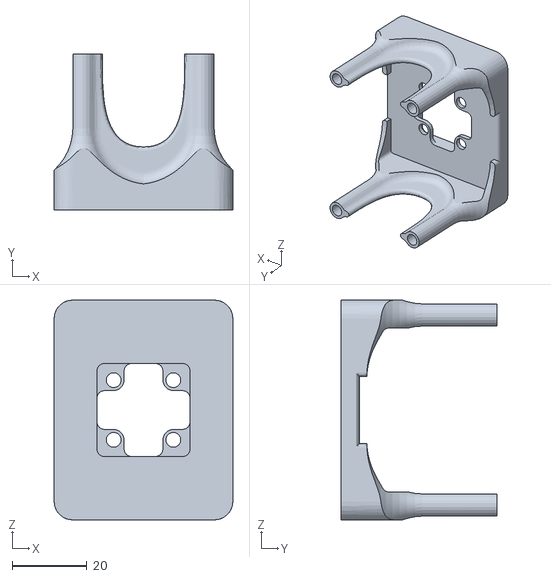
[picture p94: CAD file, 2026-10-17]
ARD_hardware/ARD_Model_v1/as5600_holder.stl
48.0 x 42.0 x 59.0
