khw1566/ARD/ARD_hardware/Control Box_v1/bottom.stl

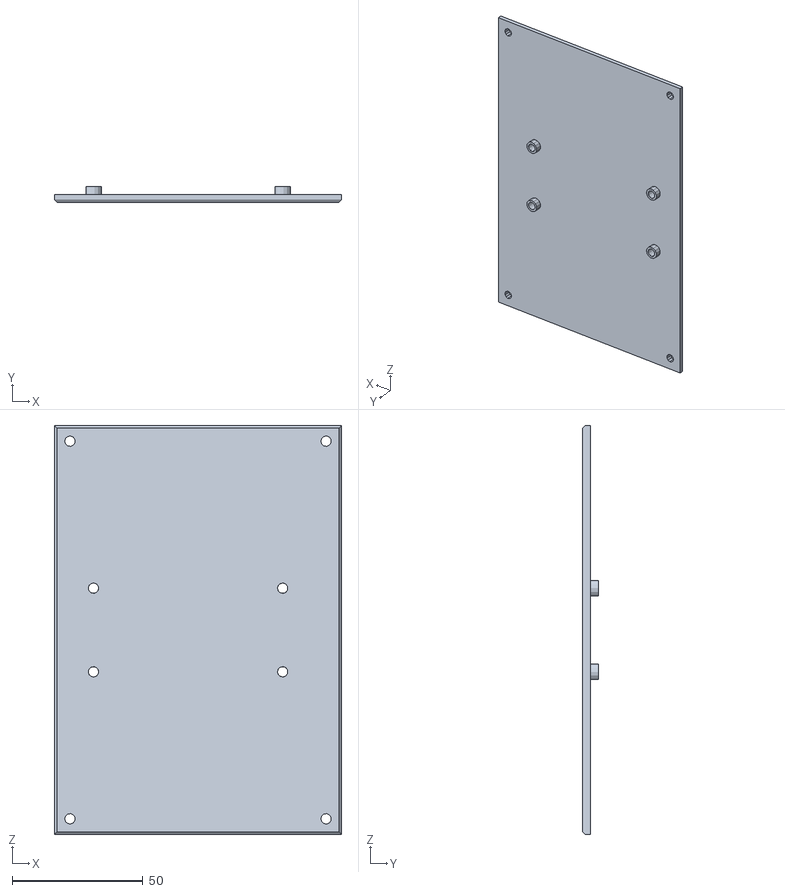
[picture p95: CAD file, 2026-10-17]
ARD_hardware/Control Box_v1/bottom.stl
110.0 x 6.00 x 156.5
