khw1566/ARD/ARD_hardware/CY300210_v1/gear.stl

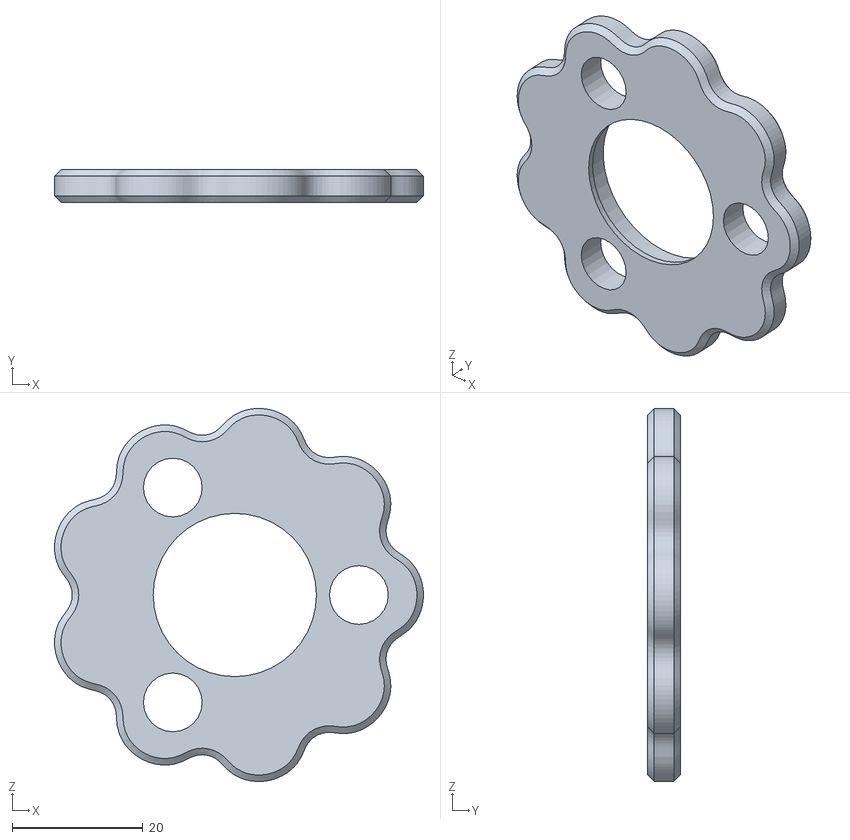
[picture p96: CAD file, 2026-10-17]
ARD_hardware/CY300210_v1/gear.stl
56.5 x 5.00 x 57.1
