khw1566/ARD/ARD_hardware/CY300210M4_v1/roter.stl

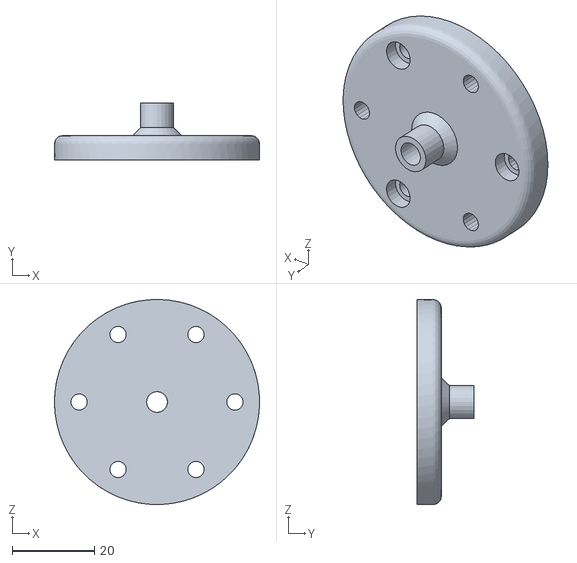
[picture p97: CAD file, 2026-10-17]
ARD_hardware/CY300210M4_v1/roter.stl
50.0 x 14.0 x 50.0
