khw1566/ARD/ARD_hardware/CY300210M8_v1/hou.stl

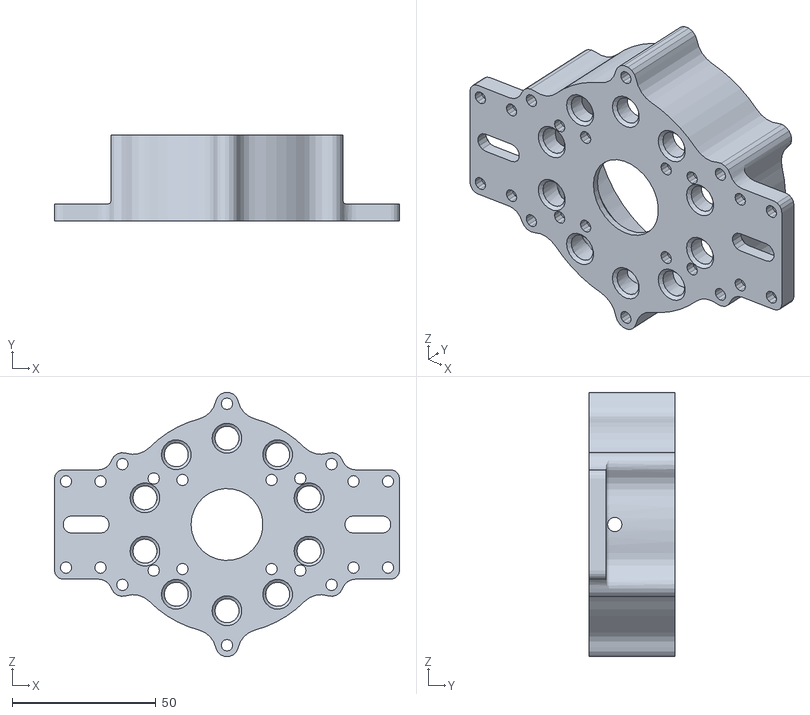
[picture p98: CAD file, 2026-10-17]
ARD_hardware/CY300210M8_v1/hou.stl
120.0 x 30.0 x 91.8
