khw1566/ARD/ARD_hardware/M4 stand/육망성 너트.stl

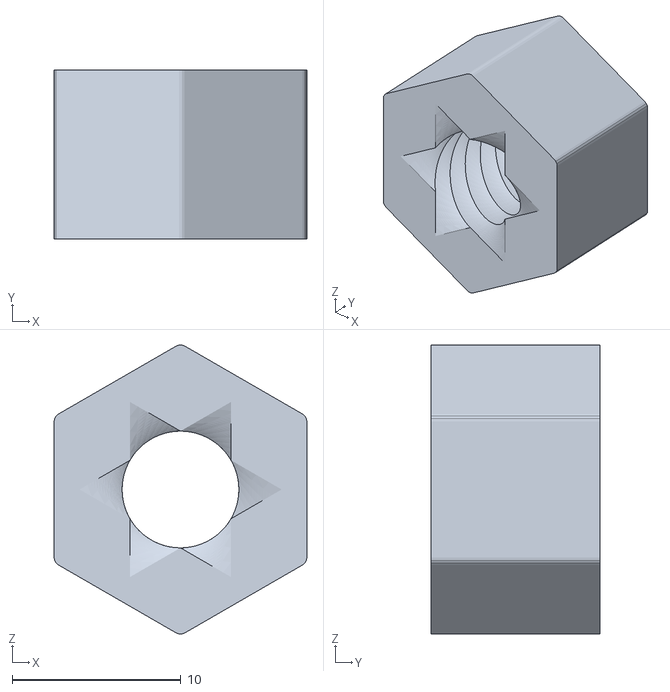
[picture p99: CAD file, 2026-10-26]
ARD_hardware/M4 stand/육망성 너트.stl
15.0 x 10.0 x 17.2
