khw1566/ARD/ARD_hardware/PL121248m2Drive_v2/gear_M1.5_Z16_H10.0_spur.stl

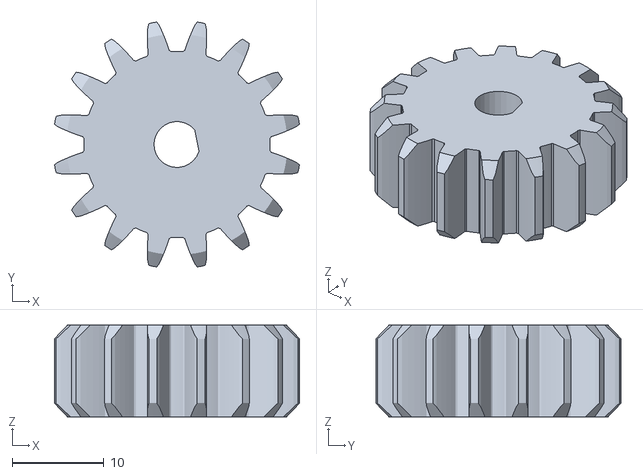
[picture p100: CAD file, 2026-10-17]
ARD_hardware/PL121248m2Drive_v2/gear_M1.5_Z16_H10.0_spur.stl
26.6 x 26.6 x 10.0
