khw1566/ARD/ARD_hardware/PneumaticGripper_v2/Cylinder fixing parts.stl

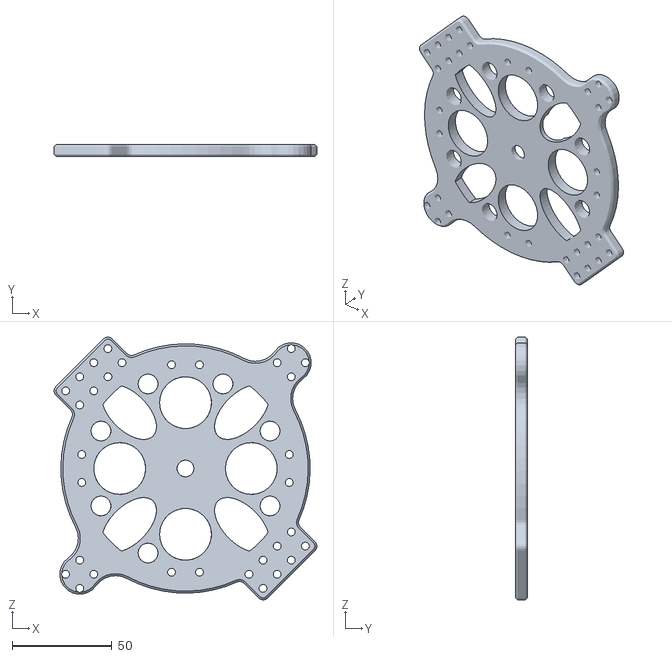
[picture p101: CAD file, 2026-10-17]
ARD_hardware/PneumaticGripper_v2/Cylinder fixing parts.stl
131.9 x 6.00 x 131.9
