khw1566/ARD/ARD_hardware/RA_Project/Substrate/Pillar-tyA.stl

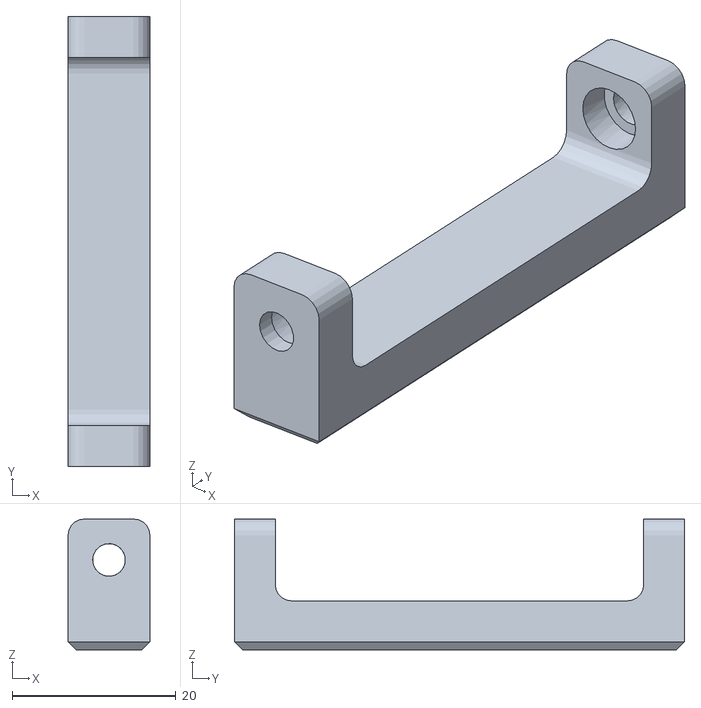
[picture p103: CAD file, 2026-10-17]
ARD_hardware/RA_Project/Substrate/Pillar-tyA.stl
10.0 x 55.0 x 16.0
