khw1566/ARD/ARD_hardware/RA_Project/X-axis disc support.stl

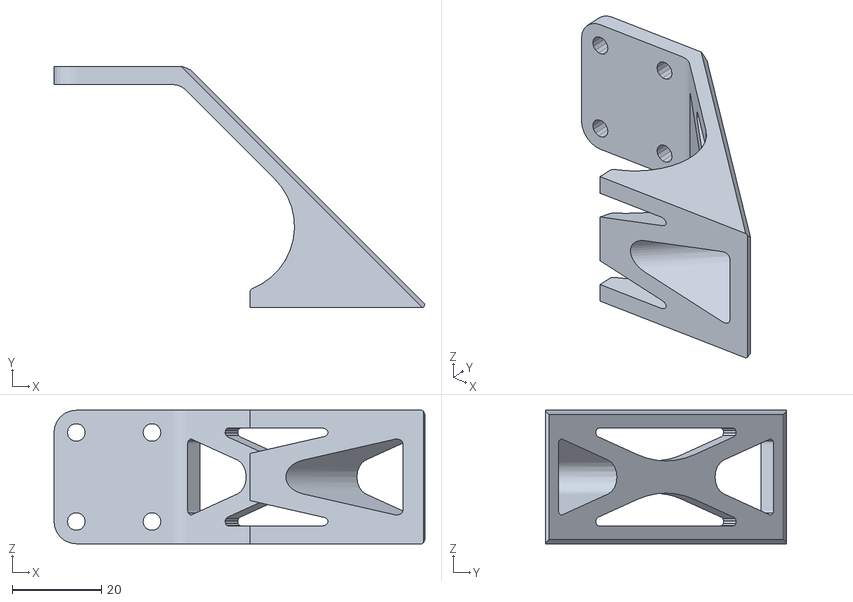
[picture p104: CAD file, 2026-10-17]
ARD_hardware/RA_Project/X-axis disc support.stl
83.3 x 54.0 x 30.0
