khw1566/ARD/ARD_hardware/TRCR_Project/TRCRv1/top_test.stl

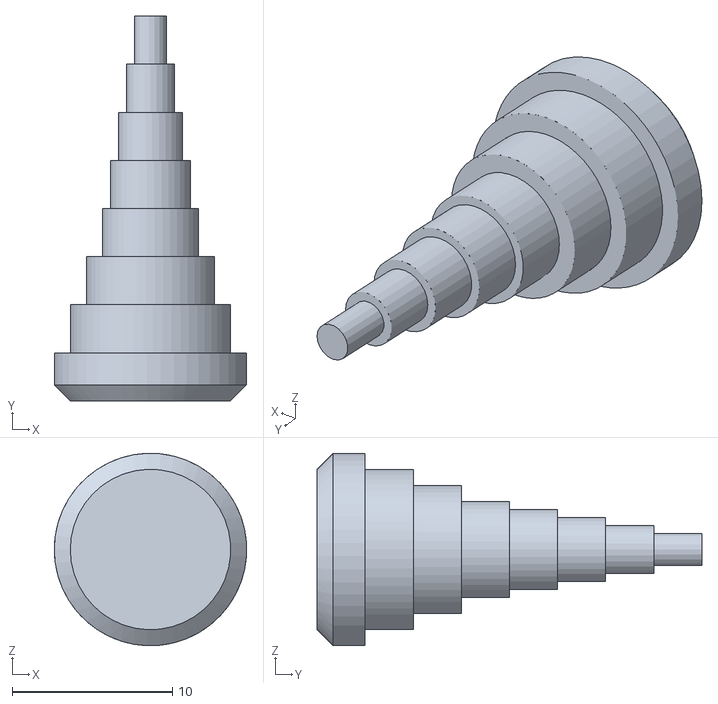
[picture p106: CAD file, 2026-10-17]
ARD_hardware/TRCR_Project/TRCRv1/top_test.stl
12.0 x 24.0 x 12.0
