khw1566/ARD/ARD_hardware/Control Box_v1/U-volt.stl

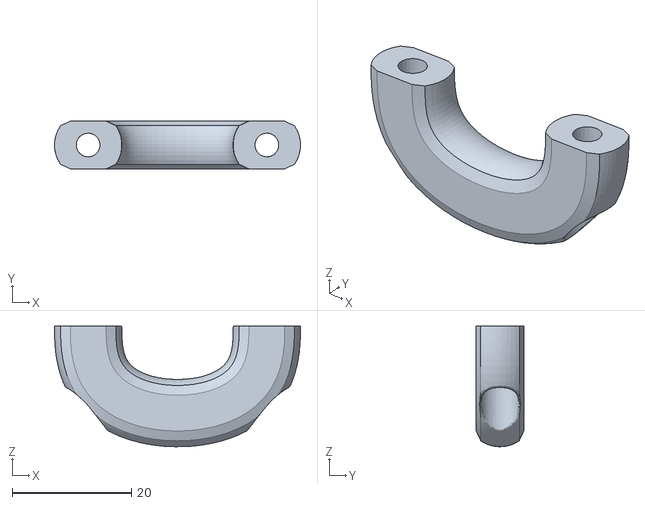
[picture p107: CAD file, 2026-10-17]
ARD_hardware/Control Box_v1/U-volt.stl
41.3 x 8.00 x 20.2
