khw1566/ARD/ARD_hardware/CY300210M8_v1/roter_v2.stl

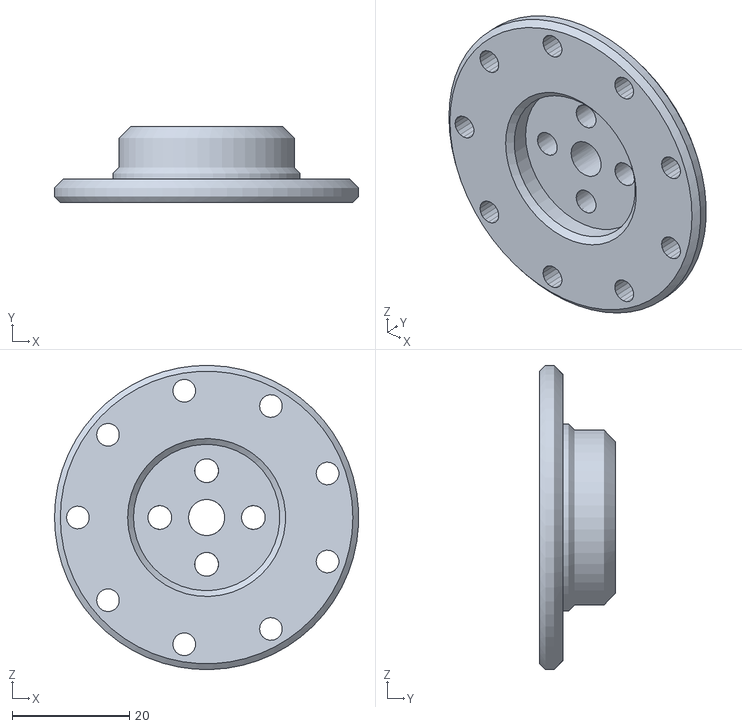
[picture p108: CAD file, 2026-10-17]
ARD_hardware/CY300210M8_v1/roter_v2.stl
52.0 x 13.0 x 52.0
