khw1566/ARD/ARD_hardware/M4 stand/삼각형 볼트.stl

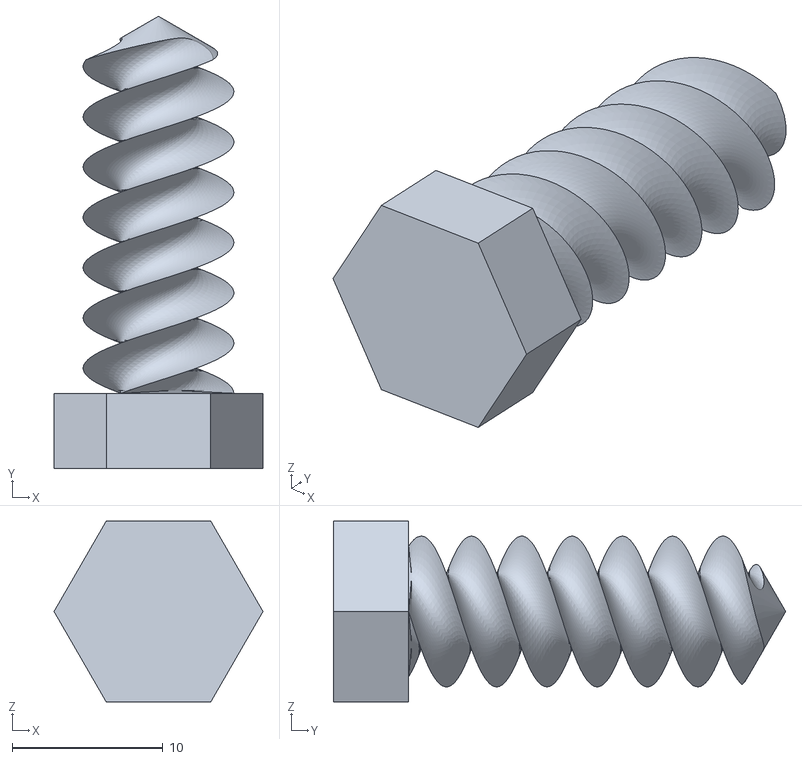
[picture p109: CAD file, 2026-10-26]
ARD_hardware/M4 stand/삼각형 볼트.stl
13.9 x 30.0 x 12.0
