khw1566/ARD/ARD_hardware/PL121248m2Drive_v2/case.stl

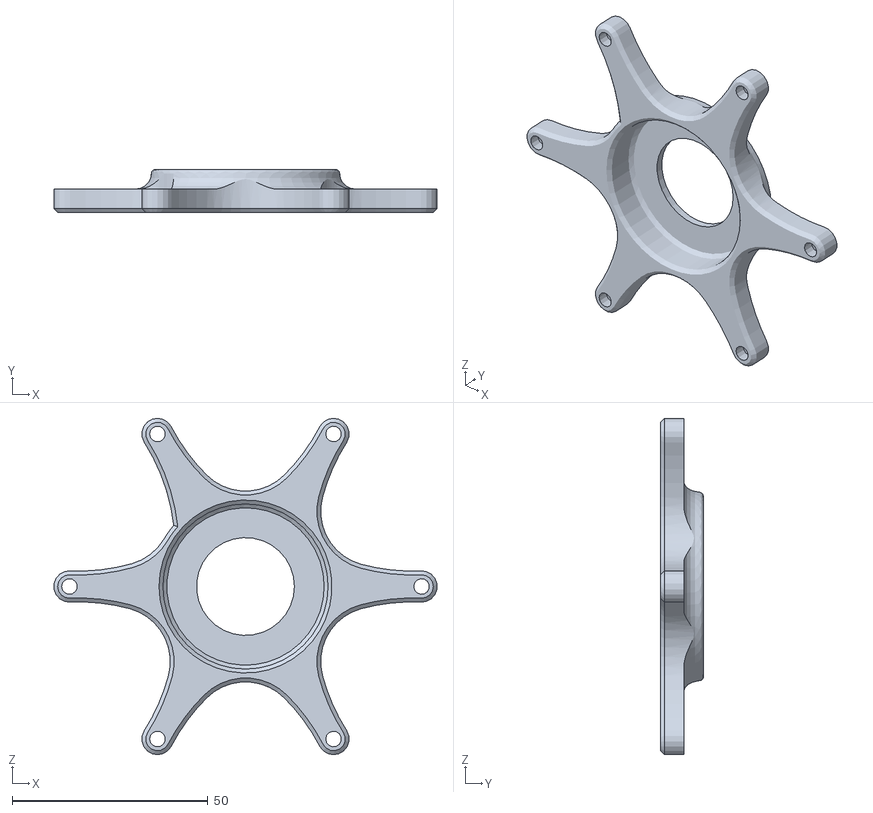
[picture p110: CAD file, 2026-10-17]
ARD_hardware/PL121248m2Drive_v2/case.stl
97.9 x 11.0 x 85.9
