khw1566/ARD/ARD_hardware/PneumaticGripper_v2/Tongs_l.stl

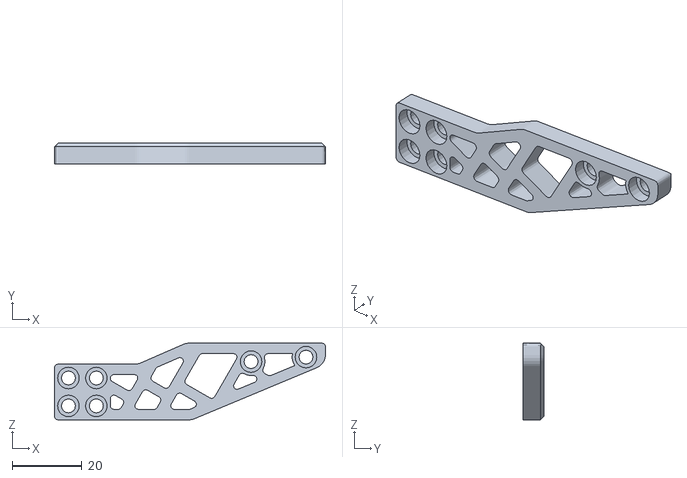
[picture p111: CAD file, 2026-10-17]
ARD_hardware/PneumaticGripper_v2/Tongs_l.stl
77.7 x 6.00 x 22.0
