khw1566/ARD/ARD_hardware/RA_Project/clap/moter_holder.stl

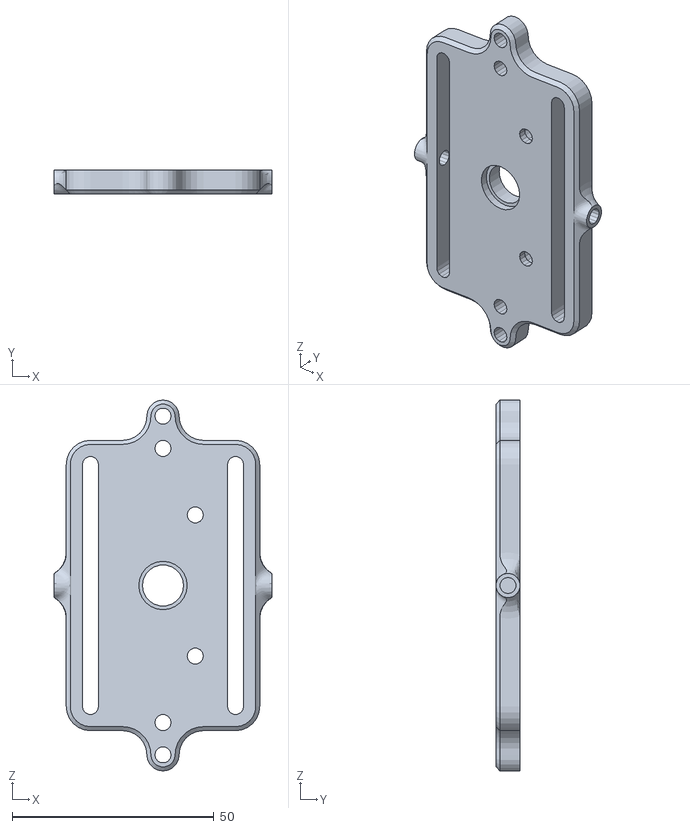
[picture p112: CAD file, 2026-10-17]
ARD_hardware/RA_Project/clap/moter_holder.stl
54.0 x 6.00 x 92.0
