khw1566/ARD/ARD_hardware/RA_Project/Substrate/signal machine-st.stl

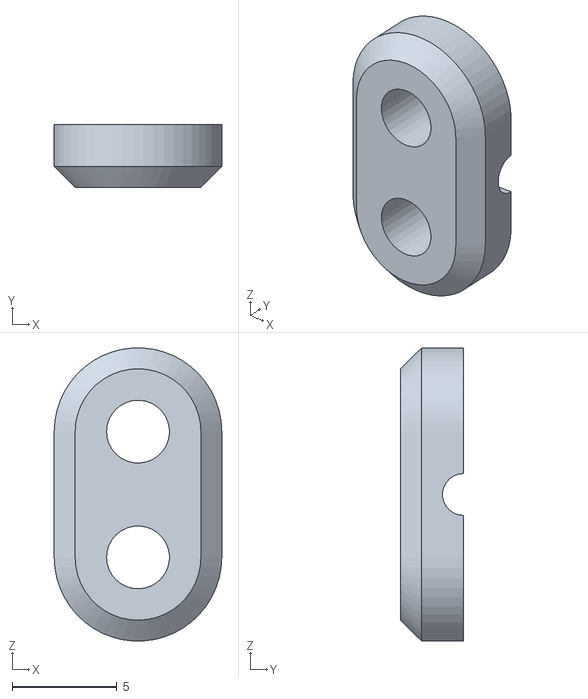
[picture p113: CAD file, 2026-10-17]
ARD_hardware/RA_Project/Substrate/signal machine-st.stl
8.00 x 3.00 x 14.0
