khw1566/ARD/ARD_hardware/RA_Project/Y-axis rotation plate.stl

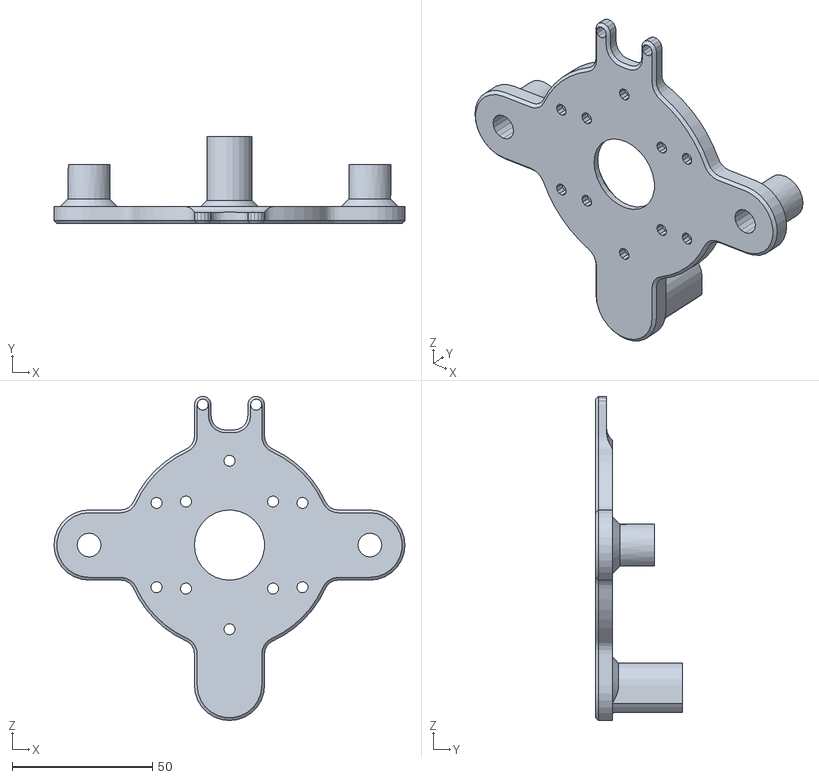
[picture p114: CAD file, 2026-10-17]
ARD_hardware/RA_Project/Y-axis rotation plate.stl
125.0 x 31.0 x 115.4
