khw1566/ARD/ARD_hardware/TRCR_Project/TRCRv1/OUTPUT_D.stl

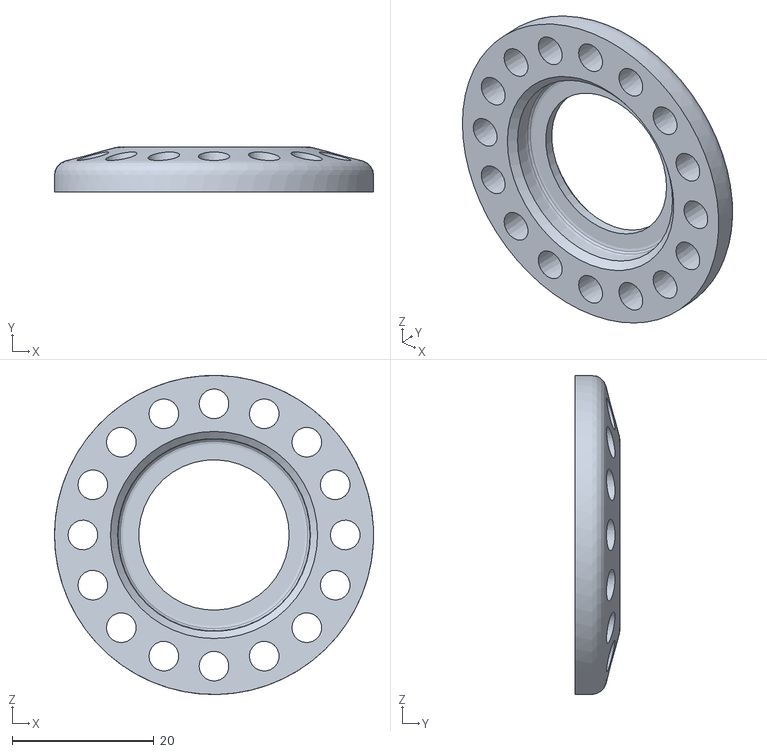
[picture p115: CAD file, 2026-10-17]
ARD_hardware/TRCR_Project/TRCRv1/OUTPUT_D.stl
45.0 x 6.36 x 45.0
