khw1566/ARD/영상제작용 CAD파일/조립품에서 가져온 원점유지 감속기.stl

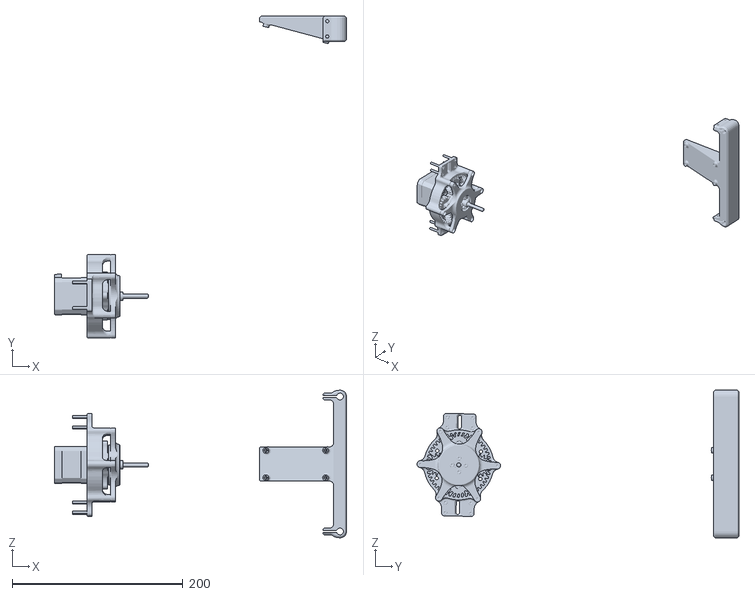
[picture p116: CAD file, 2026-10-26]
영상제작용 CAD파일/조립품에서 가져온 원점유지 감속기.stl
341.8 x 376.9 x 173.0
