khw1566/ARD/ARD_hardware/ARD_Model_v1/hol.stl

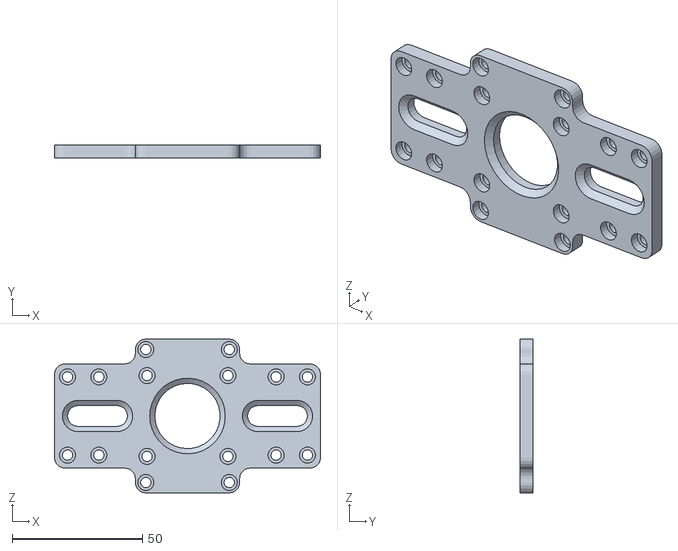
[picture p117: CAD file, 2026-10-17]
ARD_hardware/ARD_Model_v1/hol.stl
102.0 x 5.00 x 59.0
