khw1566/ARD/ARD_hardware/CY300210M8_v1/disk.stl

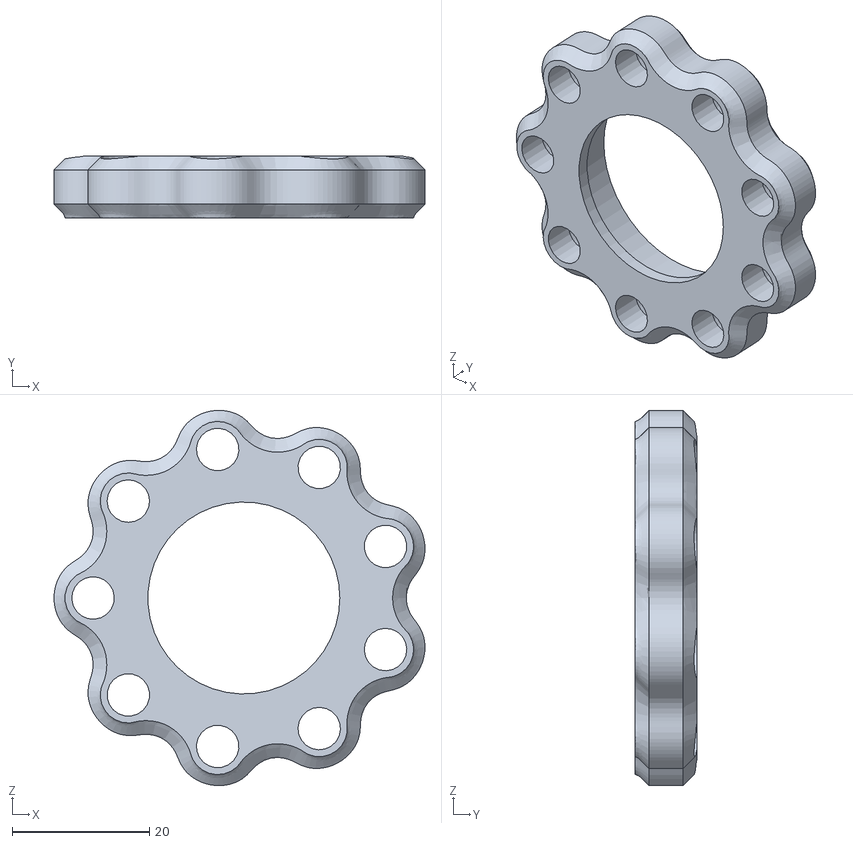
[picture p118: CAD file, 2026-10-17]
ARD_hardware/CY300210M8_v1/disk.stl
54.1 x 9.00 x 54.7
