khw1566/ARD/ARD_hardware/RA_Project/clap/gear_M1.0_Z20_H10.0_O-0.10_spur.stl

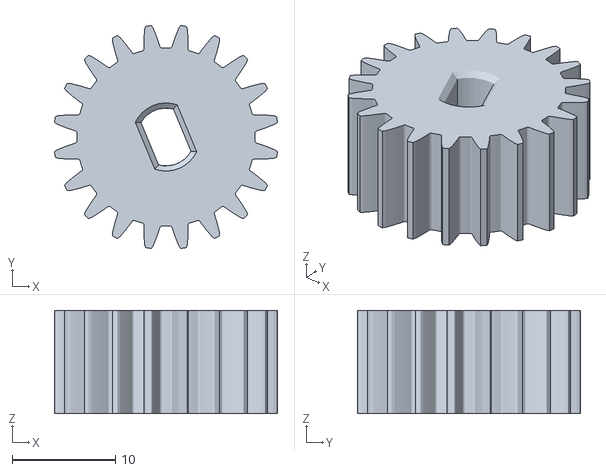
[picture p119: CAD file, 2026-10-17]
ARD_hardware/RA_Project/clap/gear_M1.0_Z20_H10.0_O-0.10_spur.stl
21.6 x 21.6 x 10.0
