khw1566/ARD/ARD_hardware/RA_Project/Substrate/Pillar.stl

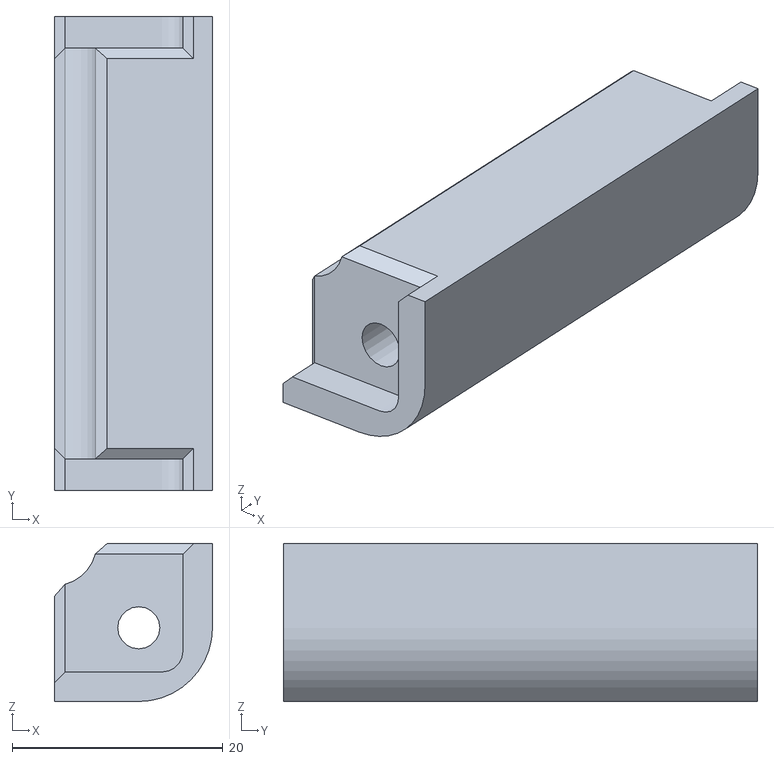
[picture p120: CAD file, 2026-10-17]
ARD_hardware/RA_Project/Substrate/Pillar.stl
15.0 x 45.0 x 15.0
