khw1566/ARD/ARD_hardware/RA_Project/Z-axis mover.stl

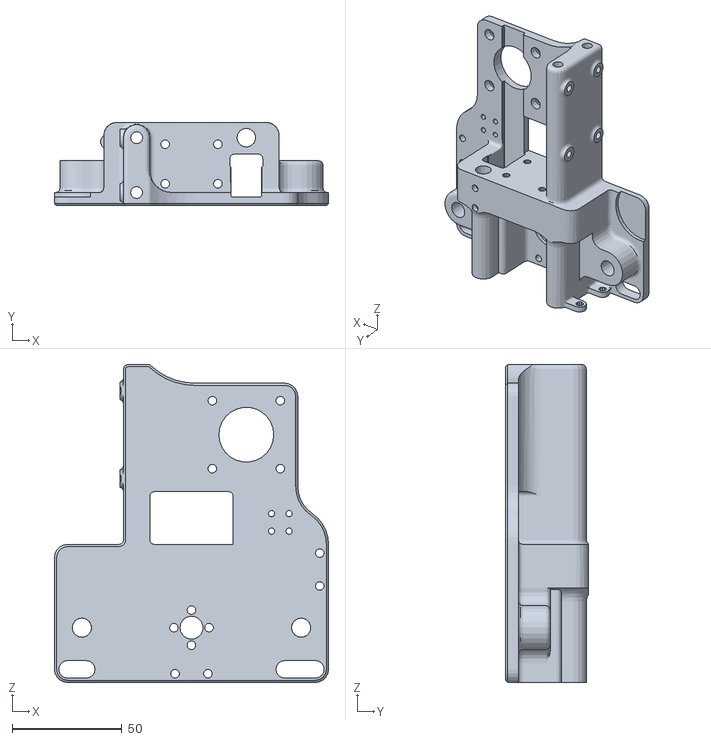
[picture p121: CAD file, 2026-10-17]
ARD_hardware/RA_Project/Z-axis mover.stl
125.0 x 38.0 x 145.0
