khw1566/ARD/ARD_hardware/TRCR_Project/TRCRv1/hole_test.stl

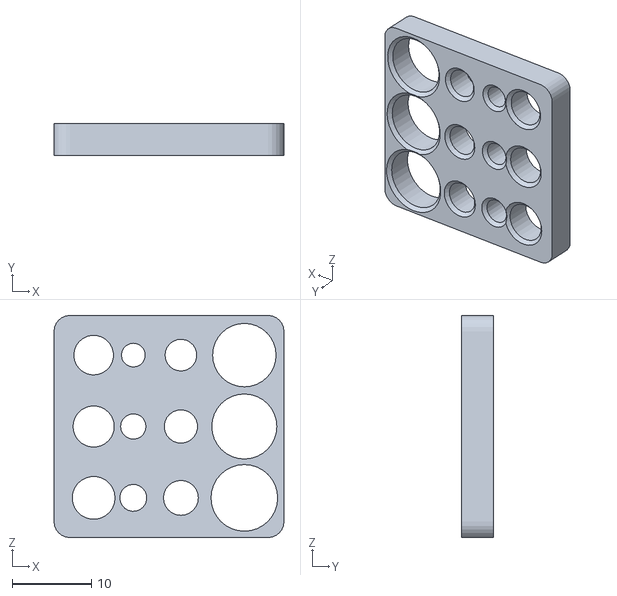
[picture p122: CAD file, 2026-10-17]
ARD_hardware/TRCR_Project/TRCRv1/hole_test.stl
29.0 x 4.00 x 28.0
