khw1566/ARD/영상제작용 CAD파일/양측 베벨기어만.stl

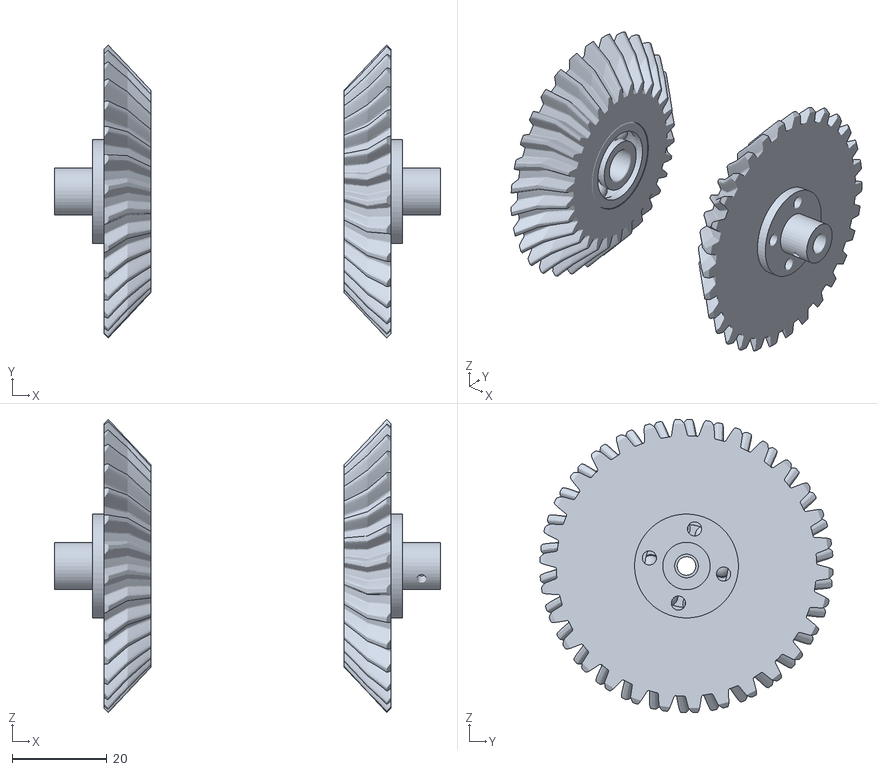
[picture p123: CAD file, 2026-10-26]
영상제작용 CAD파일/양측 베벨기어만.stl
81.4 x 61.9 x 61.9
