khw1566/ARD/ARD_hardware/ARD_Model_v1/2.stl

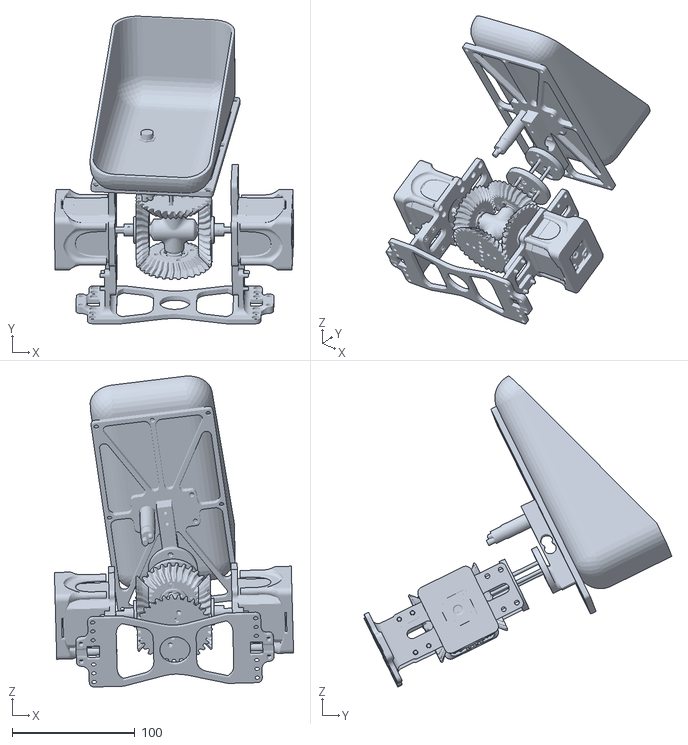
[picture p124: CAD file, 2026-10-17]
ARD_hardware/ARD_Model_v1/2.stl
194.8 x 250.5 x 253.3
