khw1566/ARD/ARD_hardware/RA_Project/Substrate/Pillar-tyB.stl

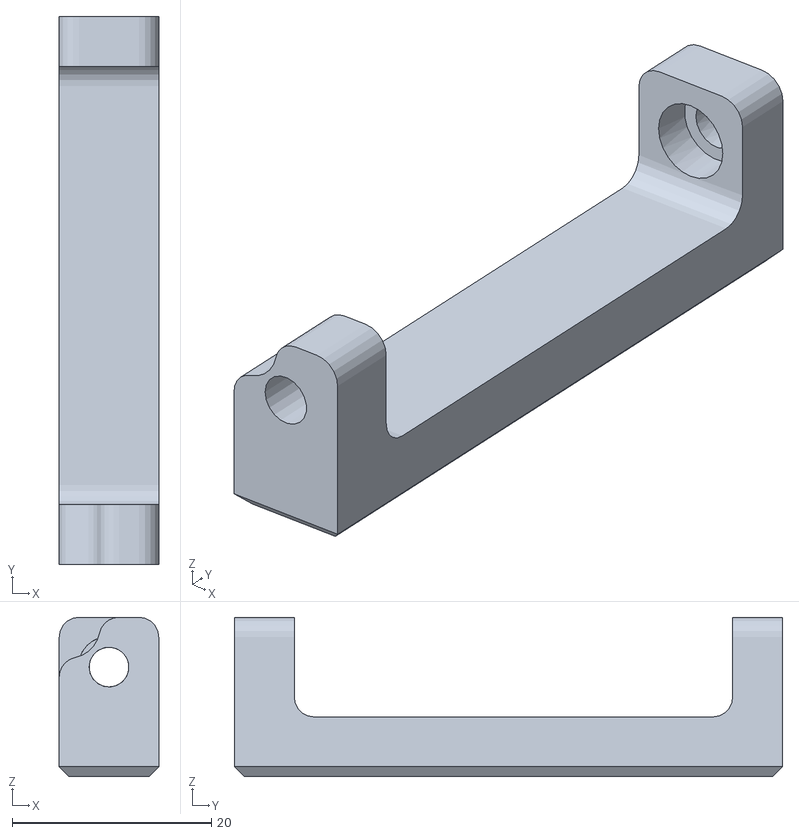
[picture p125: CAD file, 2026-10-17]
ARD_hardware/RA_Project/Substrate/Pillar-tyB.stl
10.0 x 55.0 x 16.0
