khw1566/ARD/ARD_hardware/RA_Project/Y-axis end.stl

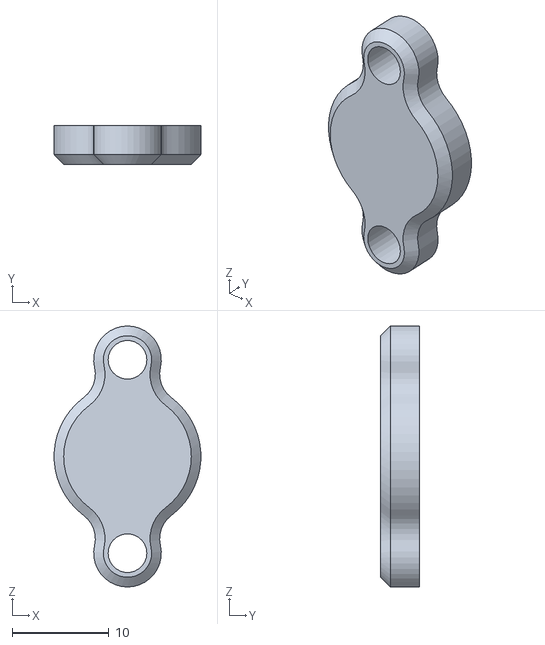
[picture p126: CAD file, 2026-10-17]
ARD_hardware/RA_Project/Y-axis end.stl
15.2 x 4.00 x 27.0
