khw1566/ARD/ARD_hardware/TRCR_Project/TRCRv1/OUTPUT.stl

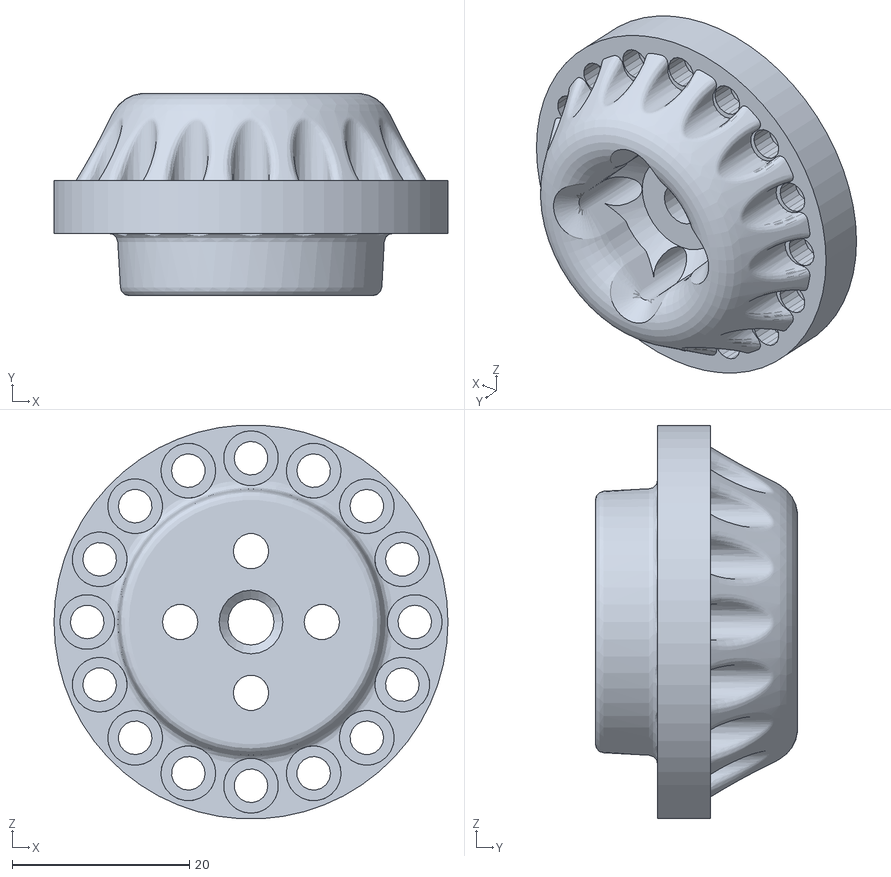
[picture p127: CAD file, 2026-10-17]
ARD_hardware/TRCR_Project/TRCRv1/OUTPUT.stl
44.5 x 22.9 x 44.4
