khw1566/ARD/영상제작용 CAD파일/비전 캠 장치.stl

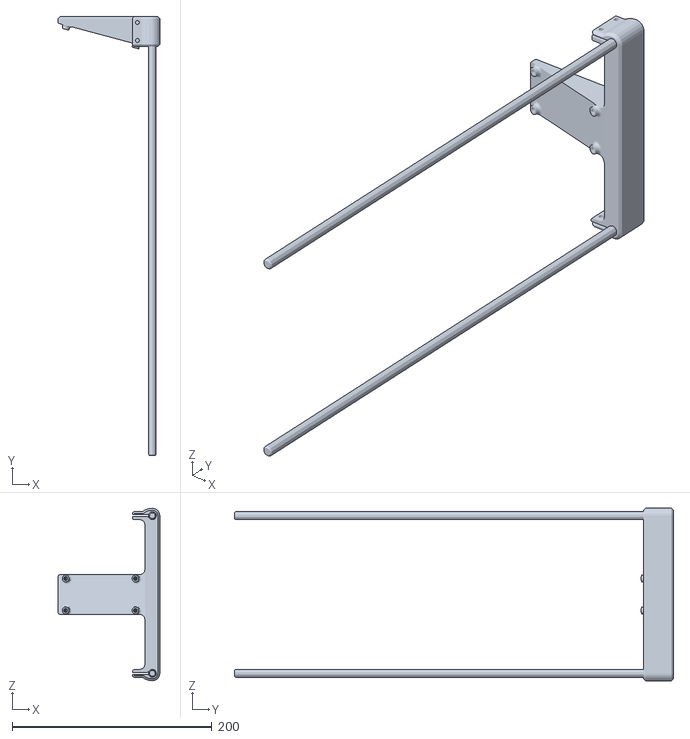
[picture p128: CAD file, 2026-10-26]
영상제작용 CAD파일/비전 캠 장치.stl
101.9 x 440.0 x 173.0
