khw1566/ARD/ARD_hardware/ARD_Model_v1/접시.stl

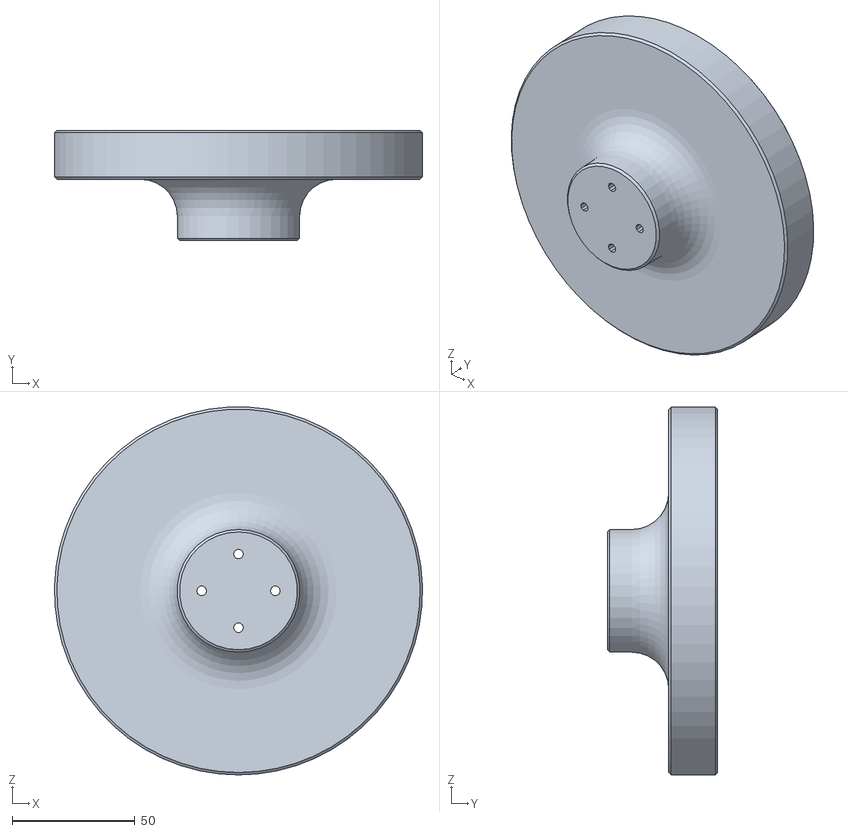
[picture p129: CAD file, 2026-10-17]
ARD_hardware/ARD_Model_v1/접시.stl
149.9 x 45.0 x 149.9
