khw1566/ARD/ARD_hardware/RA_Project/Substrate/Control Board.stl

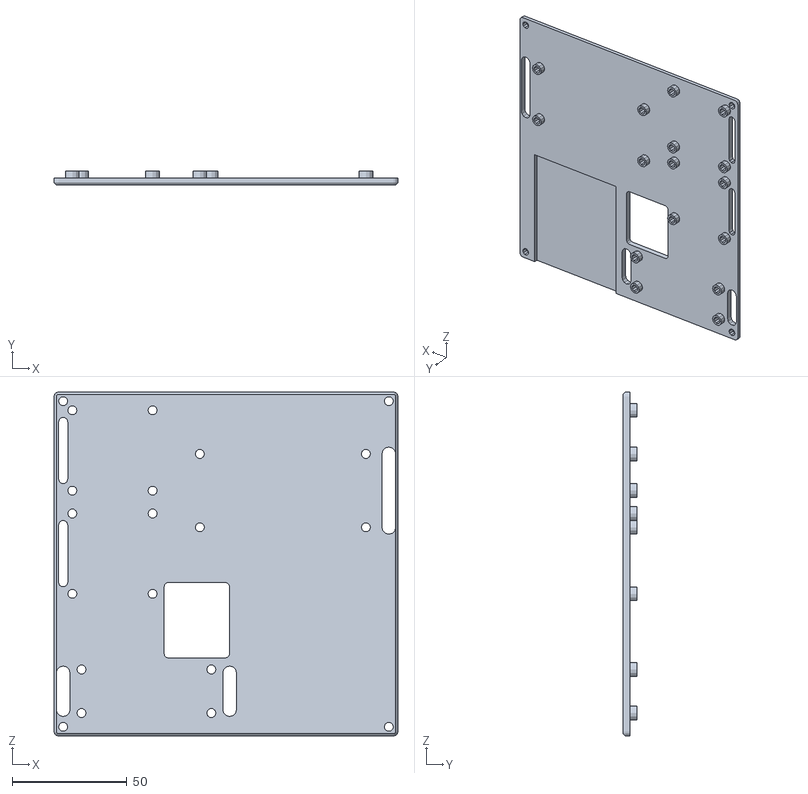
[picture p130: CAD file, 2026-10-17]
ARD_hardware/RA_Project/Substrate/Control Board.stl
150.0 x 6.00 x 150.0
