khw1566/ARD/ARD_hardware/RA_Project/z-axis bearing puller support.stl

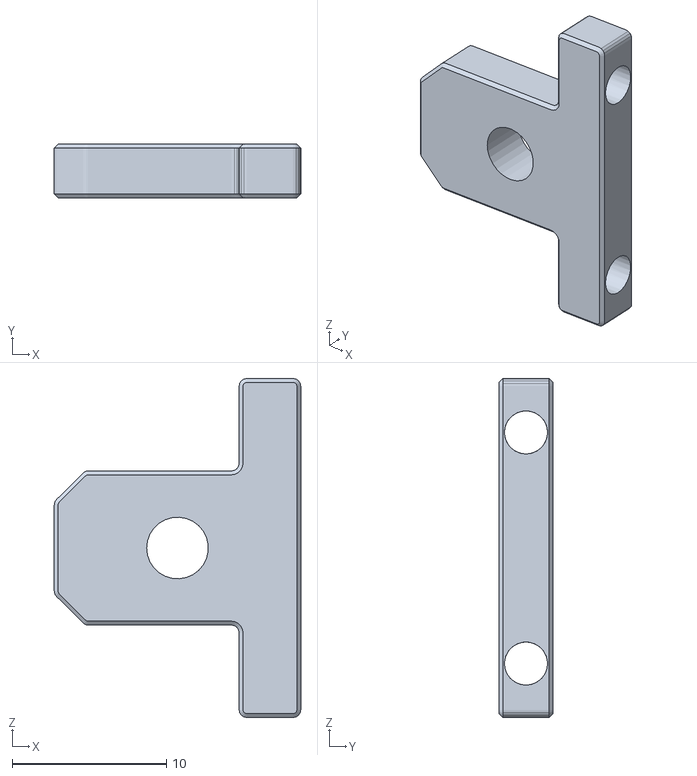
[picture p131: CAD file, 2026-10-17]
ARD_hardware/RA_Project/z-axis bearing puller support.stl
16.0 x 3.50 x 22.0
