khw1566/ARD/ARD_hardware/TRCR_Project/TRCRv1/case_s.stl

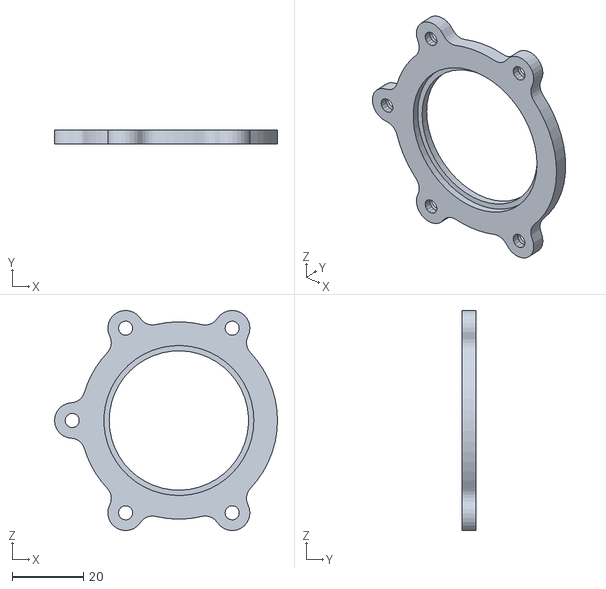
[picture p132: CAD file, 2026-10-17]
ARD_hardware/TRCR_Project/TRCRv1/case_s.stl
62.8 x 4.00 x 62.0
