khw1566/ARD/영상제작용 CAD파일/상부이송구조.stl

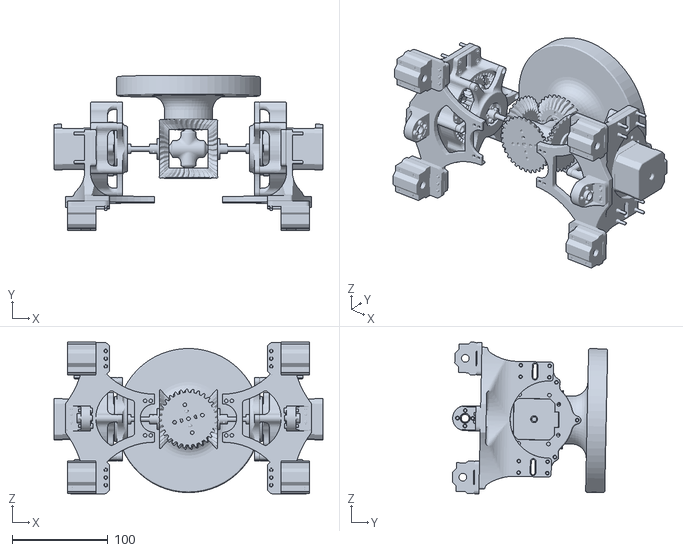
[picture p133: CAD file, 2026-10-26]
영상제작용 CAD파일/상부이송구조.stl
280.6 x 162.2 x 158.2
