khw1566/ARD/ARD_hardware/ARD_Model_v1/2B_set_rali.stl

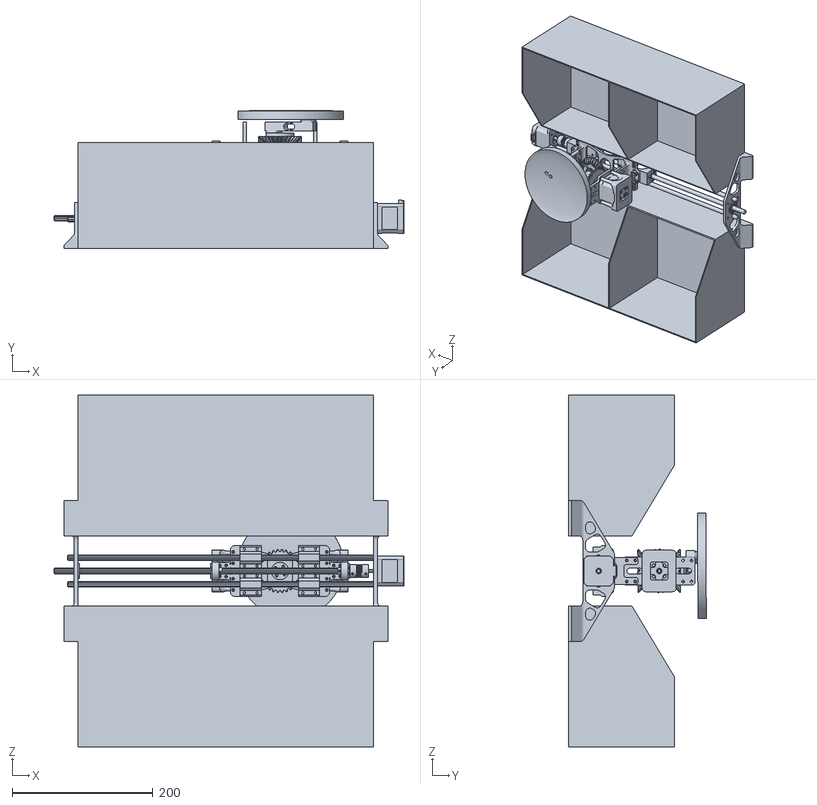
[picture p134: CAD file, 2026-10-17]
ARD_hardware/ARD_Model_v1/2B_set_rali.stl
497.2 x 195.5 x 500.0
