khw1566/ARD/ARD_hardware/RA_Project/Y-axis End Leveler Mount.stl

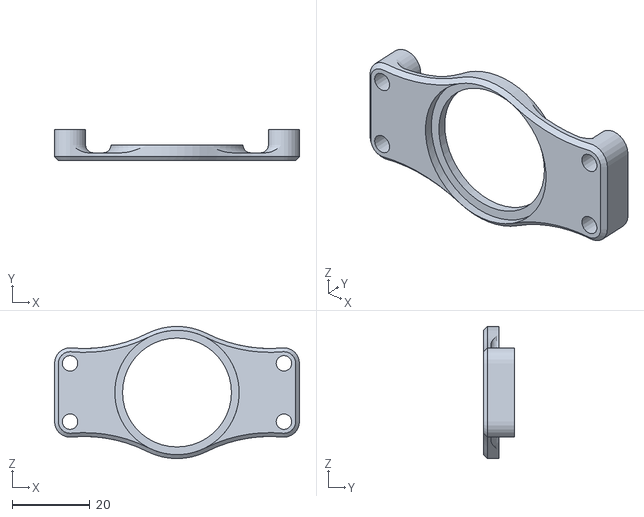
[picture p135: CAD file, 2026-10-17]
ARD_hardware/RA_Project/Y-axis End Leveler Mount.stl
63.0 x 8.00 x 34.0
