khw1566/ARD/ARD_hardware/TRCR_Project/TRCRv1/side.stl

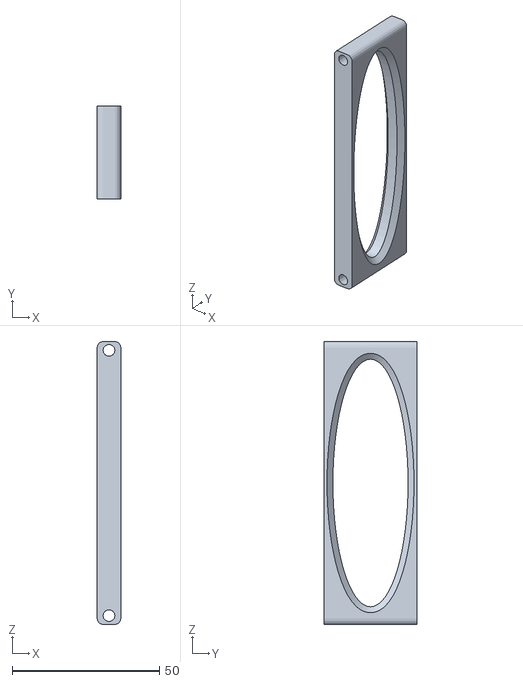
[picture p136: CAD file, 2026-10-17]
ARD_hardware/TRCR_Project/TRCRv1/side.stl
8.00 x 31.5 x 96.0
