khw1566/ARD/영상제작용 CAD파일/한방향 베벨기어만(A).stl

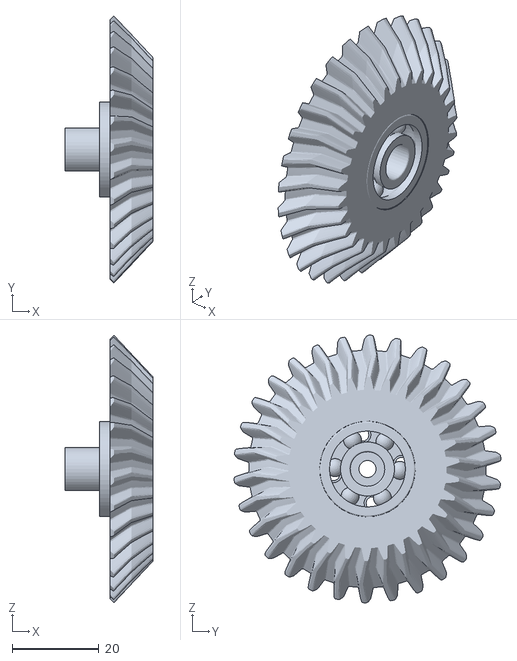
[picture p137: CAD file, 2026-10-26]
영상제작용 CAD파일/한방향 베벨기어만(A).stl
20.4 x 61.7 x 61.9
