khw1566/ARD/ARD_hardware/ARD_Model_v1/new.stl

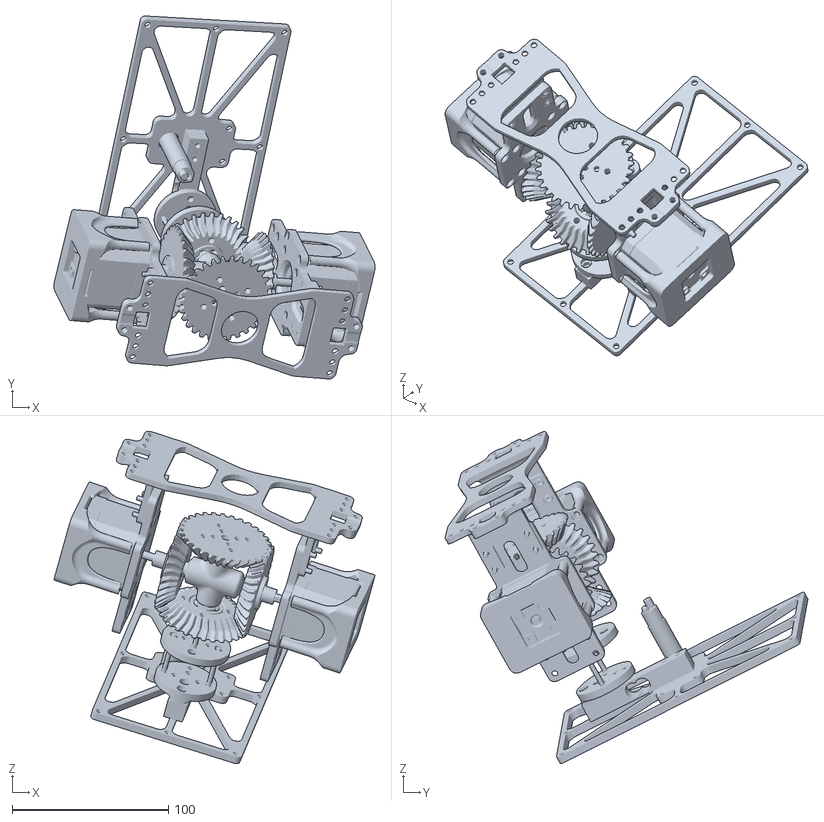
[picture p138: CAD file, 2026-10-17]
ARD_hardware/ARD_Model_v1/new.stl
205.6 x 232.4 x 212.8
