khw1566/ARD/ARD_hardware/RA_Project/rali-x support.stl

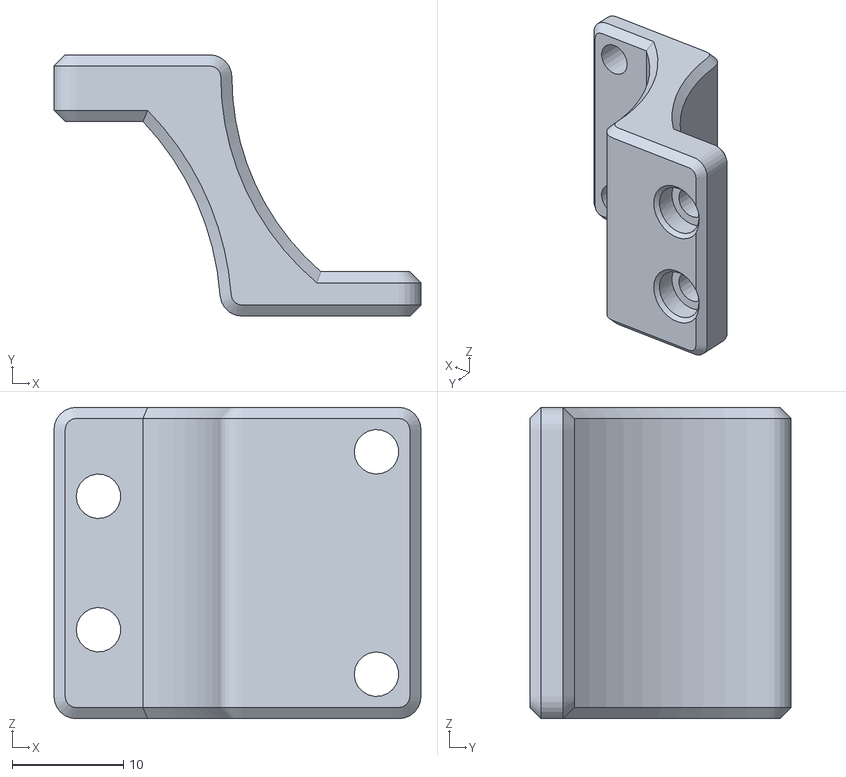
[picture p139: CAD file, 2026-10-17]
ARD_hardware/RA_Project/rali-x support.stl
33.0 x 23.5 x 28.0
