khw1566/ARD/ARD_hardware/TRCR_Project/TRCRv1/shafts.stl

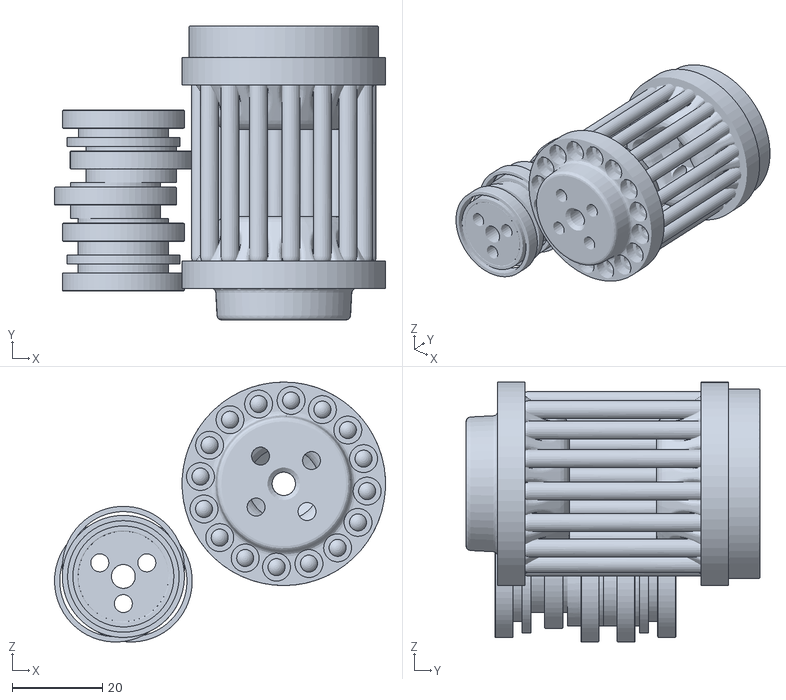
[picture p140: CAD file, 2026-10-17]
ARD_hardware/TRCR_Project/TRCRv1/shafts.stl
73.2 x 65.0 x 57.5
