khw1566/ARD/ARD_hardware/ARD_Model_v1/R-2.stl

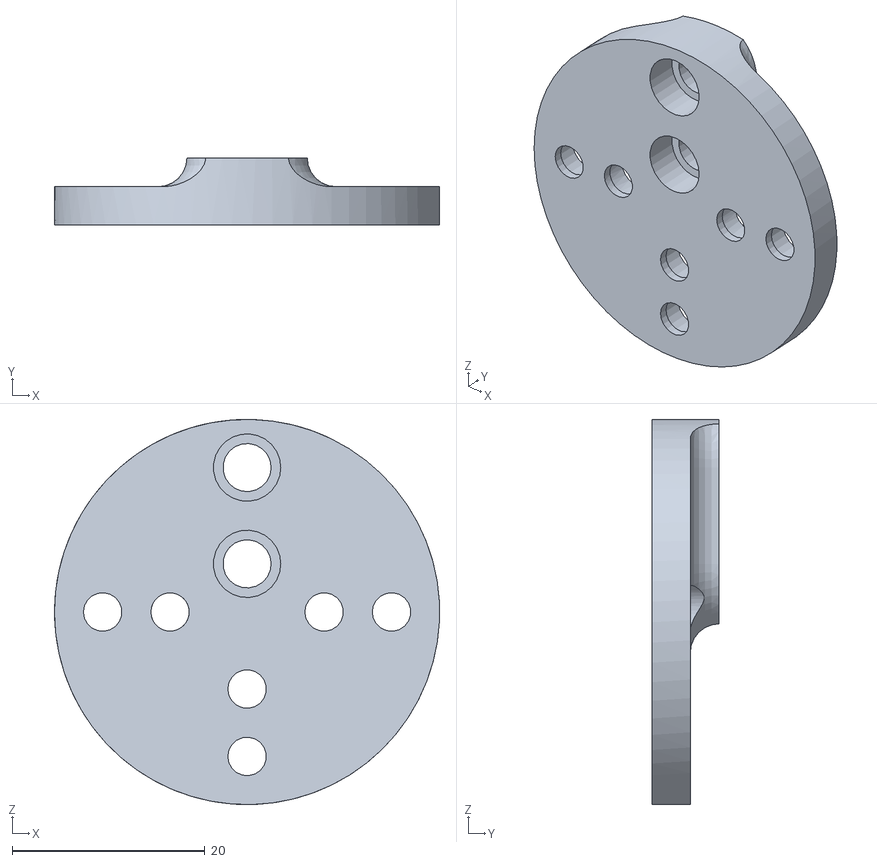
[picture p141: CAD file, 2026-10-17]
ARD_hardware/ARD_Model_v1/R-2.stl
40.0 x 7.00 x 40.0
