khw1566/ARD/ARD_hardware/RA_Project/end of the z-axis.stl

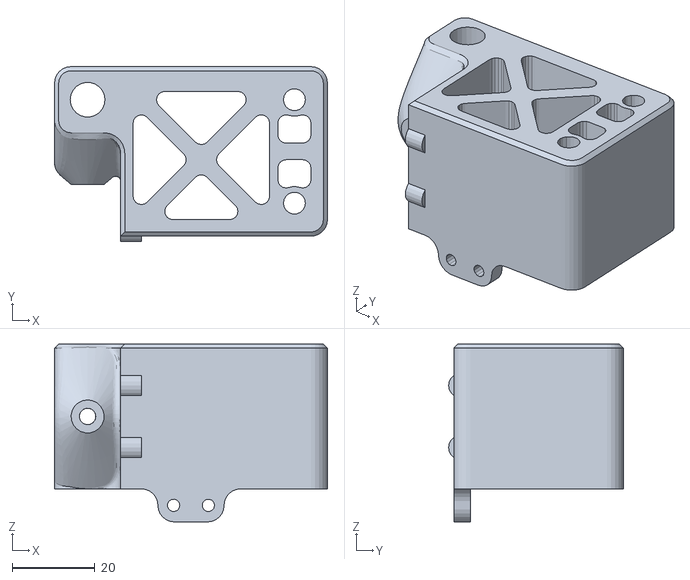
[picture p142: CAD file, 2026-10-17]
ARD_hardware/RA_Project/end of the z-axis.stl
66.0 x 42.2 x 43.0
