khw1566/ARD/ARD_hardware/TRCR_Project/TRCRv1/CASE_T.stl

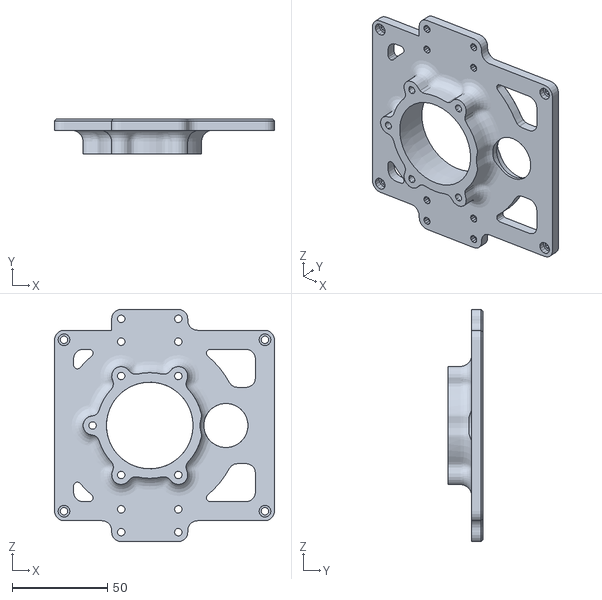
[picture p143: CAD file, 2026-10-17]
ARD_hardware/TRCR_Project/TRCRv1/CASE_T.stl
115.5 x 18.5 x 122.0
