khw1566/ARD/영상제작용 CAD파일/유성기어 감속기.stl

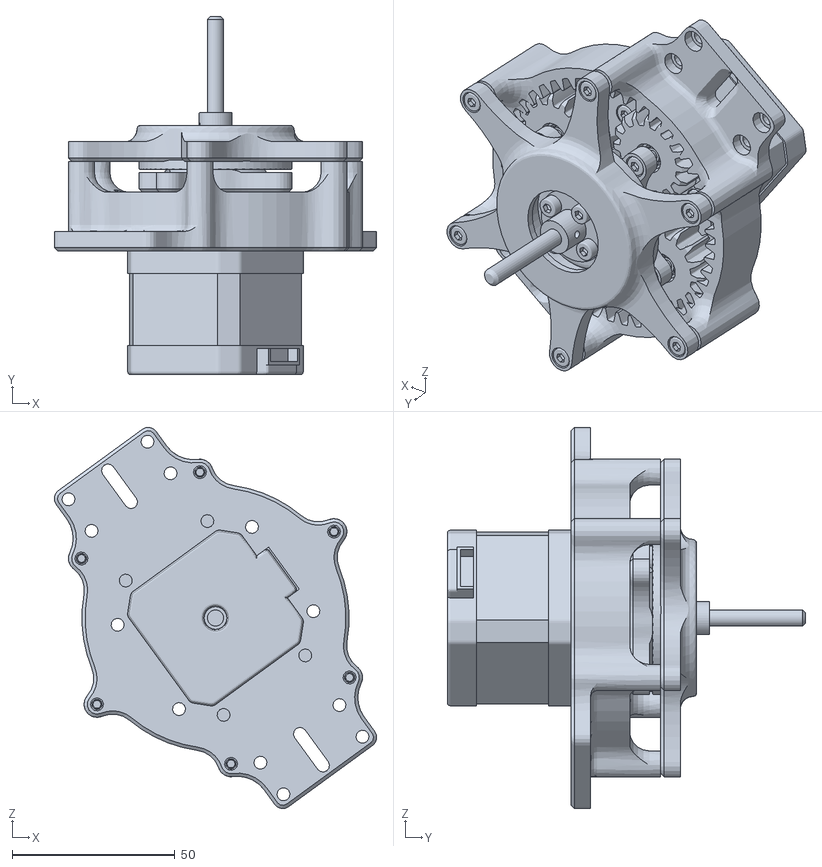
[picture p144: CAD file, 2026-10-26]
영상제작용 CAD파일/유성기어 감속기.stl
98.9 x 110.0 x 116.9
