khw1566/ARD/ARD_hardware/ARD_Model_v1/D.stl

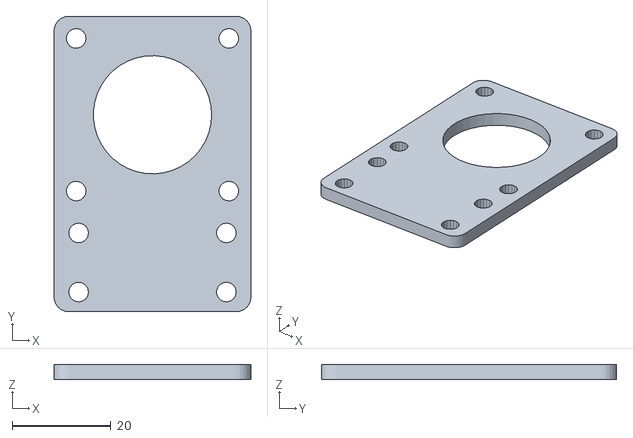
[picture p145: CAD file, 2026-10-17]
ARD_hardware/ARD_Model_v1/D.stl
40.0 x 60.0 x 3.00
