khw1566/ARD/ARD_hardware/RA_Project/Module Integrated Substrate.stl

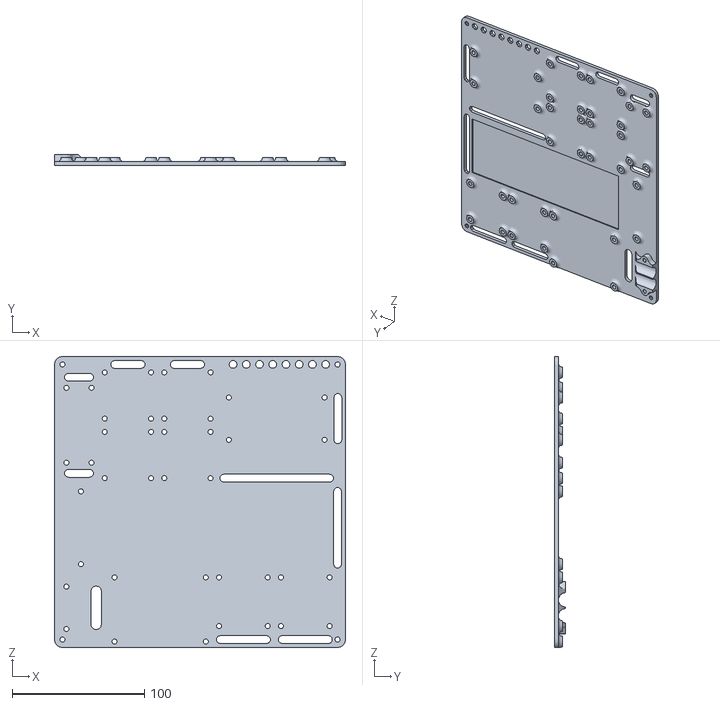
[picture p146: CAD file, 2026-10-17]
ARD_hardware/RA_Project/Module Integrated Substrate.stl
220.0 x 8.50 x 220.0
