khw1566/ARD/ARD_hardware/TRCR_Project/TRCRv1/s4.stl

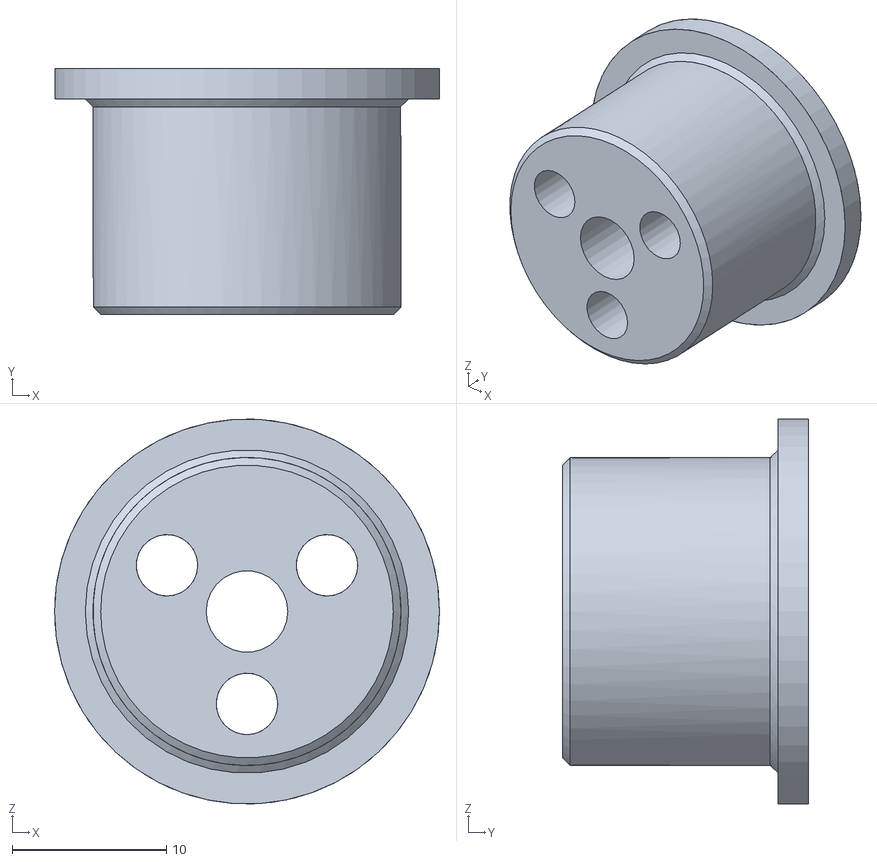
[picture p147: CAD file, 2026-10-17]
ARD_hardware/TRCR_Project/TRCRv1/s4.stl
25.0 x 16.0 x 25.0
