khw1566/ARD/영상제작용 CAD파일/베벨 기어 및 플레이트.stl

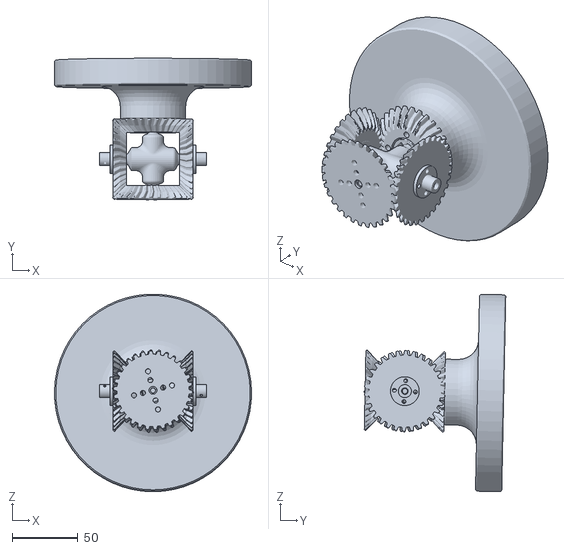
[picture p148: CAD file, 2026-10-26]
영상제작용 CAD파일/베벨 기어 및 플레이트.stl
149.9 x 107.8 x 150.2
