khw1566/ARD/ARD_hardware/ARD_Model_v1/R-1.stl

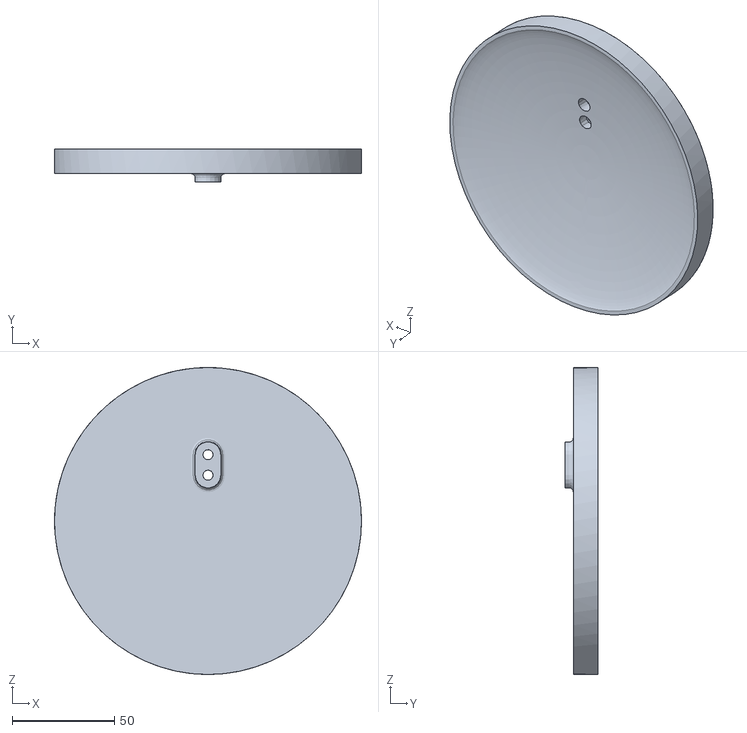
[picture p149: CAD file, 2026-10-17]
ARD_hardware/ARD_Model_v1/R-1.stl
150.0 x 16.0 x 150.0
