khw1566/ARD/ARD_hardware/RA_Project/Y-axis fixture.stl

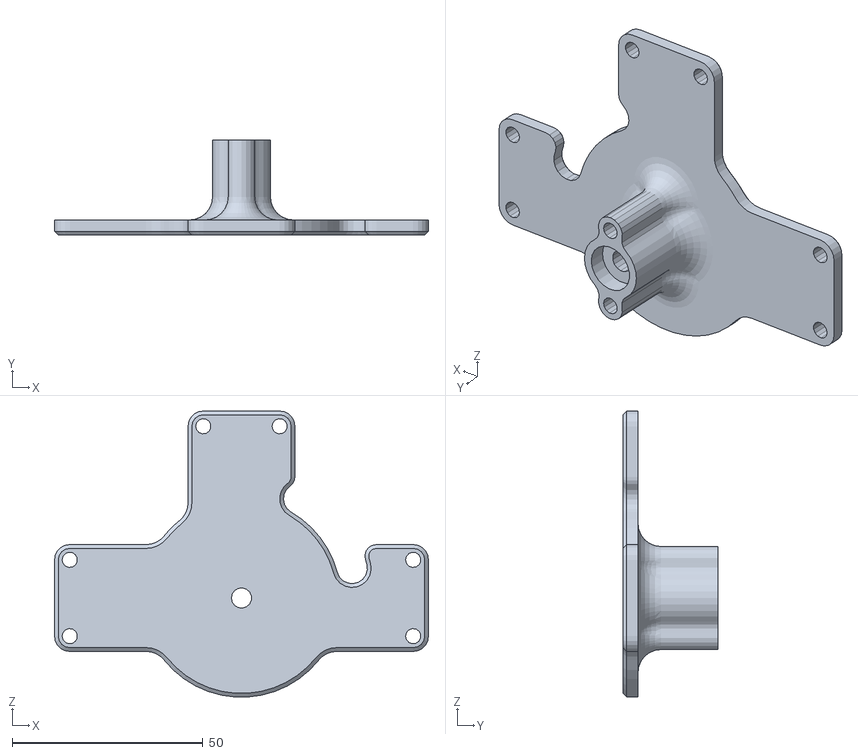
[picture p150: CAD file, 2026-10-17]
ARD_hardware/RA_Project/Y-axis fixture.stl
98.0 x 25.0 x 74.9
