khw1566/ARD/ARD_hardware/TRCR_Project/TRCRv1/TRCR_V1.stl

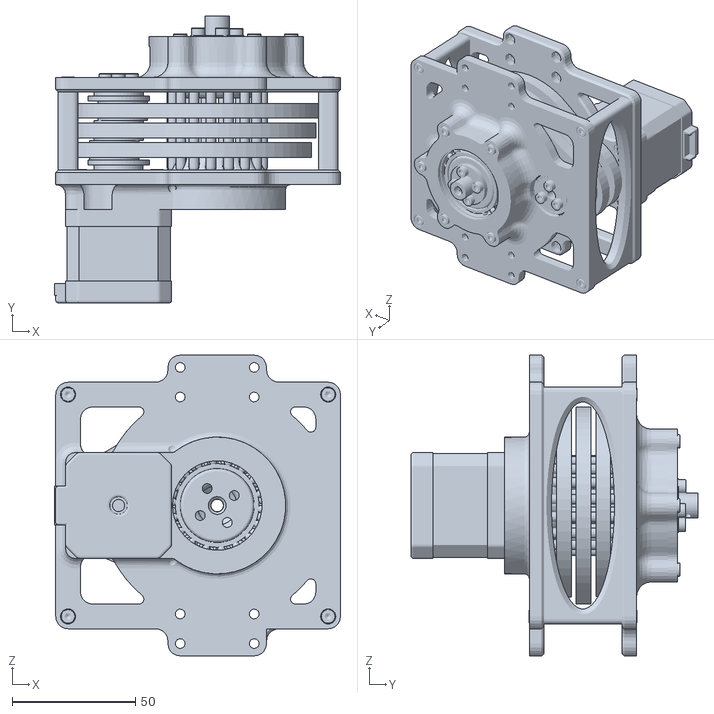
[picture p151: CAD file, 2026-10-17]
ARD_hardware/TRCR_Project/TRCRv1/TRCR_V1.stl
116.0 x 116.4 x 122.0
