khw1566/ARD/영상제작용 CAD파일/박스제거.stl

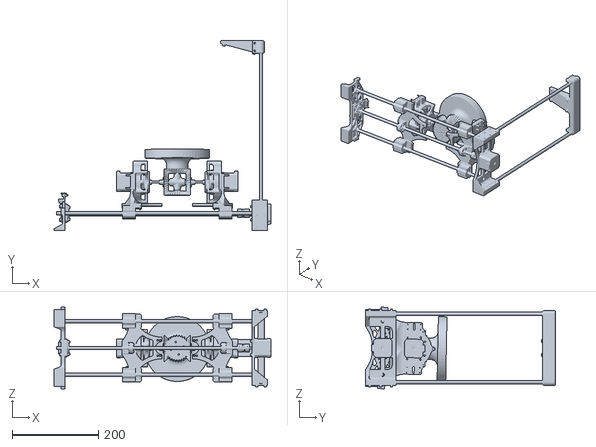
[picture p152: CAD file, 2026-10-26]
영상제작용 CAD파일/박스제거.stl
502.5 x 440.0 x 189.3
