khw1566/ARD/ARD_hardware/ARD_Model_v1/coupler.stl

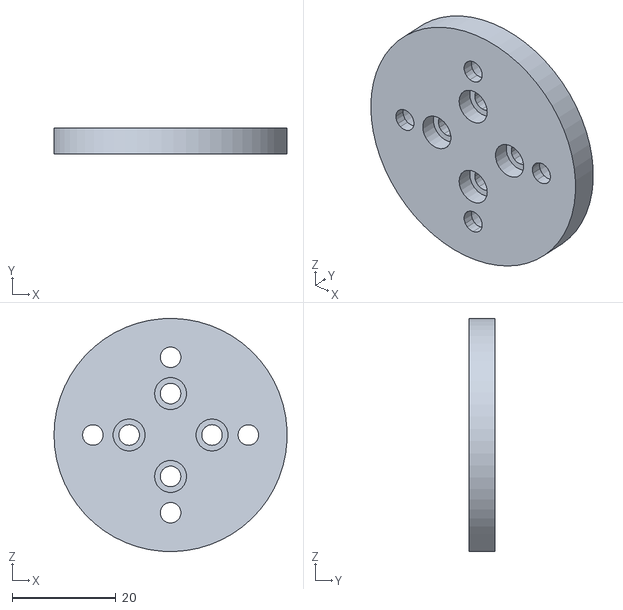
[picture p153: CAD file, 2026-10-17]
ARD_hardware/ARD_Model_v1/coupler.stl
45.0 x 5.00 x 45.0
