khw1566/ARD/ARD_hardware/RA_Project/X-axis fixing plate.stl

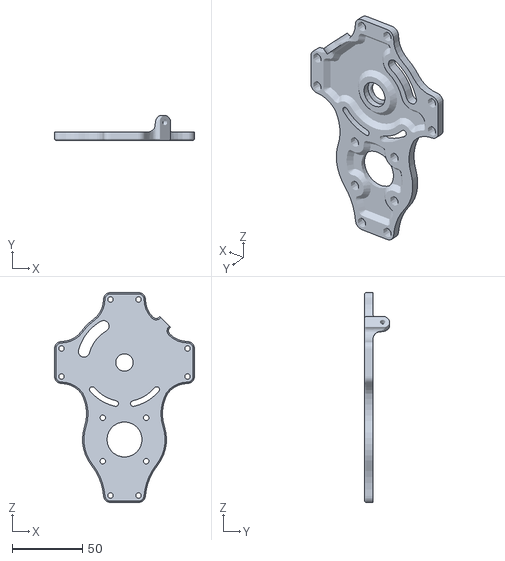
[picture p154: CAD file, 2026-10-17]
ARD_hardware/RA_Project/X-axis fixing plate.stl
100.0 x 18.0 x 150.0
