khw1566/ARD/ARD_hardware/TRCR_Project/TRCRv1/CASE.stl

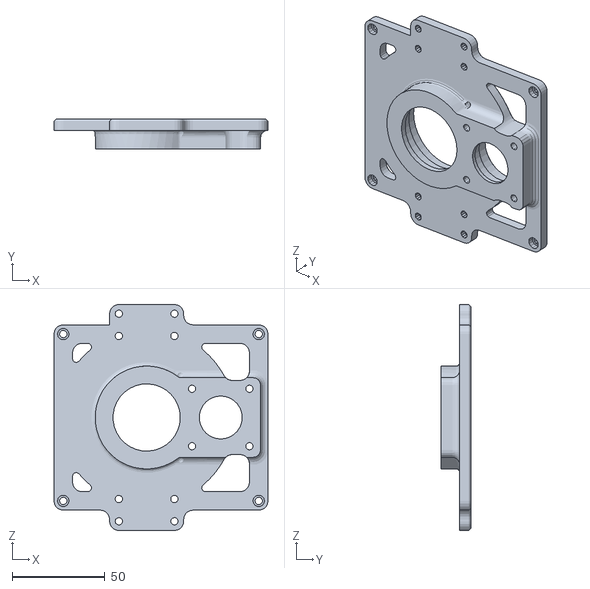
[picture p155: CAD file, 2026-10-17]
ARD_hardware/TRCR_Project/TRCRv1/CASE.stl
115.5 x 16.0 x 122.0
