khw1566/ARD/영상제작용 CAD파일/ARD_Model_v2.stl

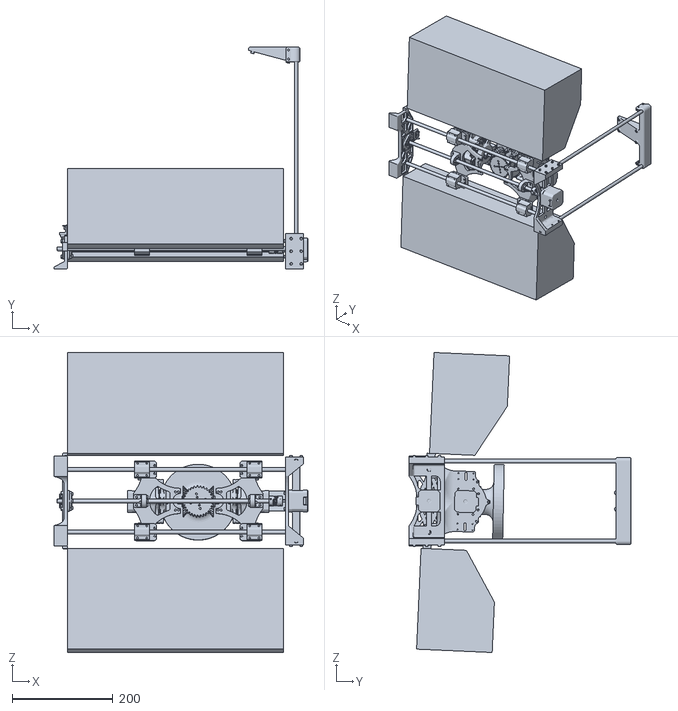
[picture p156: CAD file, 2026-10-26]
영상제작용 CAD파일/ARD_Model_v2.stl
502.5 x 440.0 x 594.5
