khw1566/ARD/ARD_hardware/ARD_Model_v1/R-1_v2.stl

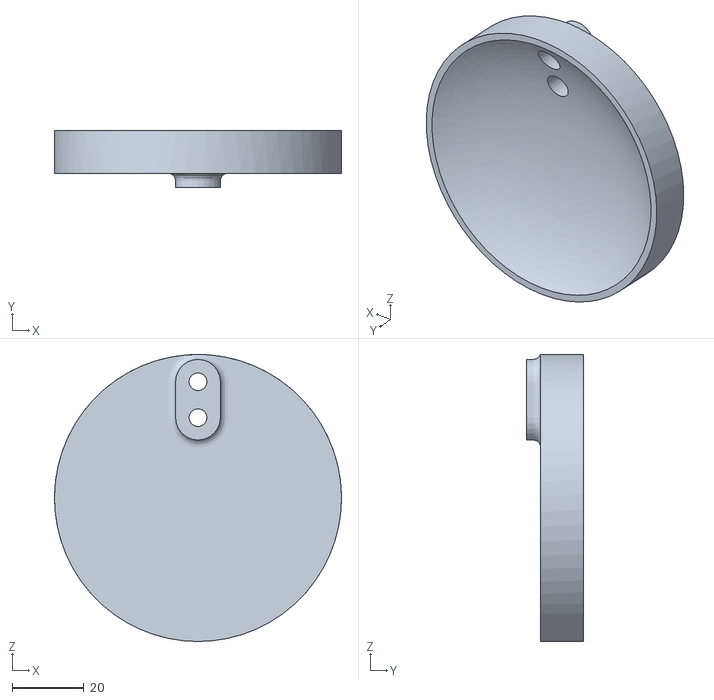
[picture p157: CAD file, 2026-10-17]
ARD_hardware/ARD_Model_v1/R-1_v2.stl
80.0 x 16.0 x 80.0
