khw1566/ARD/ARD_hardware/RA_Project/Substrate_DC jack hoder.stl

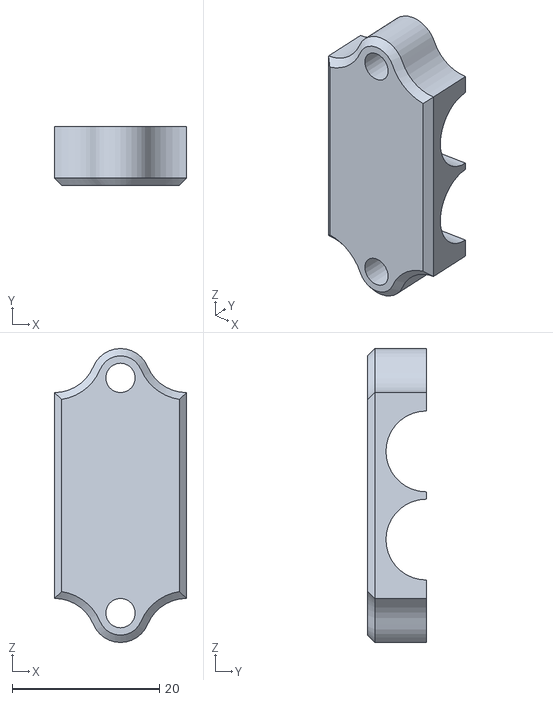
[picture p158: CAD file, 2026-10-17]
ARD_hardware/RA_Project/Substrate_DC jack hoder.stl
18.0 x 8.00 x 40.0
