khw1566/ARD/영상제작용 CAD파일/비전캠 제거 모델.stl

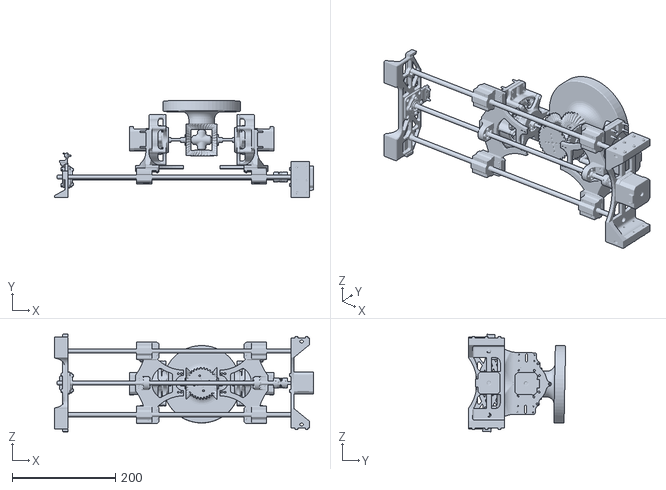
[picture p159: CAD file, 2026-10-26]
영상제작용 CAD파일/비전캠 제거 모델.stl
502.5 x 188.8 x 189.3
