khw1566/ARD/ARD_hardware/ARD_Model_v1/C_v2.stl

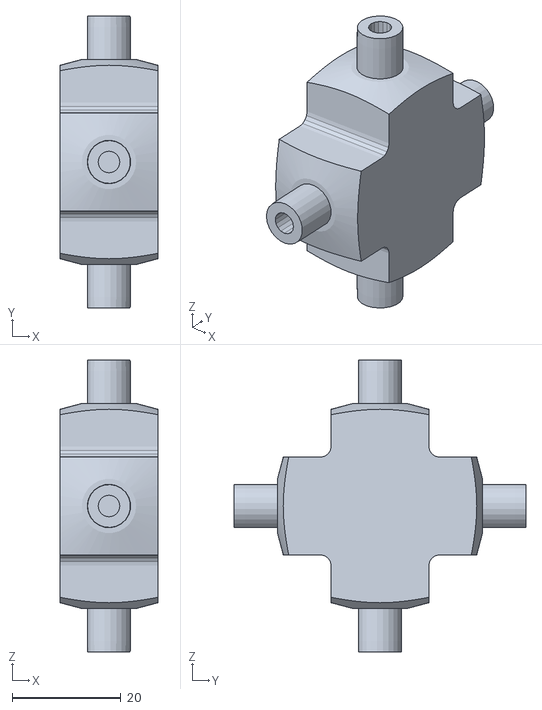
[picture p160: CAD file, 2026-10-17]
ARD_hardware/ARD_Model_v1/C_v2.stl
18.0 x 53.8 x 53.8
