khw1566/ARD/영상제작용 CAD파일/베벨기어 조립체.stl

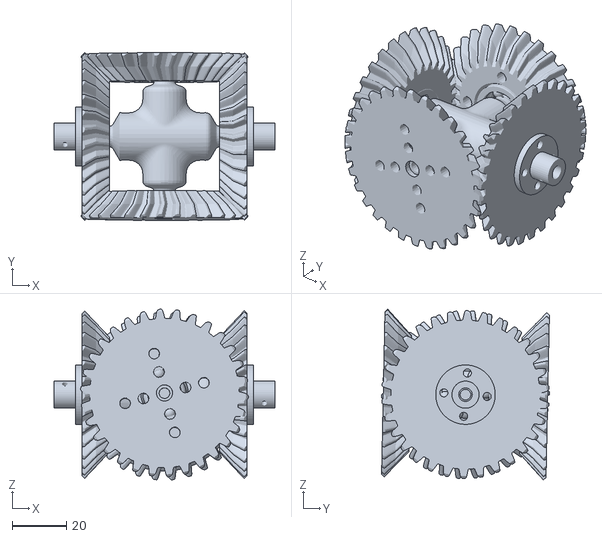
[picture p161: CAD file, 2026-10-26]
영상제작용 CAD파일/베벨기어 조립체.stl
81.4 x 61.9 x 62.9
