khw1566/ARD/ARD_hardware/ARD_Model_v1/2B_set_rali_v2.stl

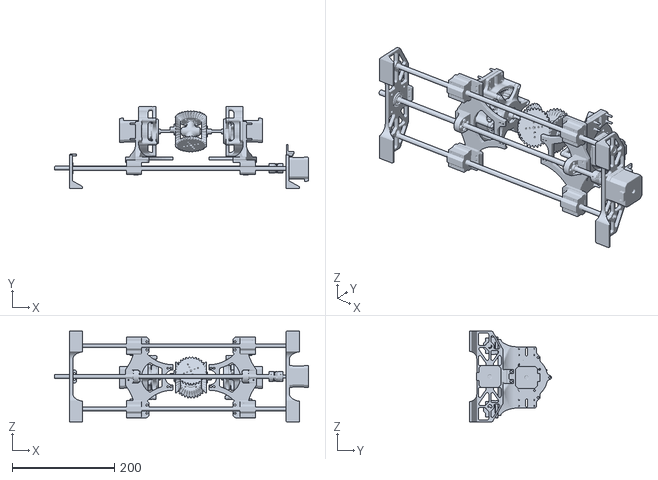
[picture p162: CAD file, 2026-10-17]
ARD_hardware/ARD_Model_v1/2B_set_rali_v2.stl
497.2 x 160.9 x 178.0
