khw1566/ARD/영상제작용 CAD파일/커버와 베어링이 제거된 감속기.stl

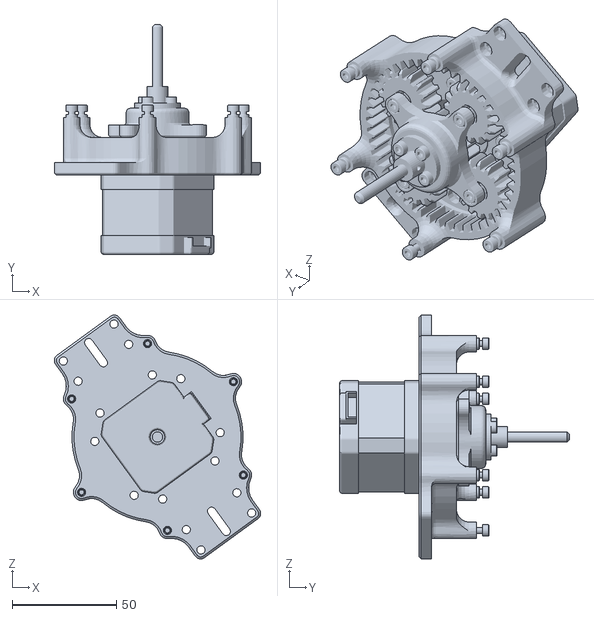
[picture p163: CAD file, 2026-10-26]
영상제작용 CAD파일/커버와 베어링이 제거된 감속기.stl
98.9 x 110.0 x 116.9
