khw1566/ARD/영상제작용 CAD파일/구동축 베벨기어와 접시만.stl

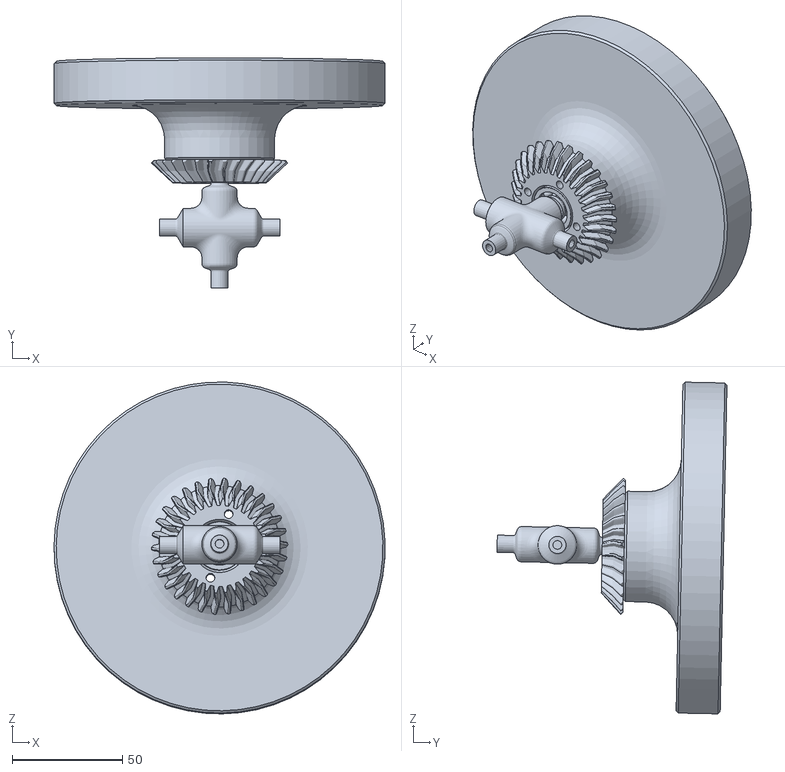
[picture p164: CAD file, 2026-10-26]
영상제작용 CAD파일/구동축 베벨기어와 접시만.stl
149.9 x 104.2 x 150.3
