khw1566/ARD/영상제작용 CAD파일/하부이송구조.stl

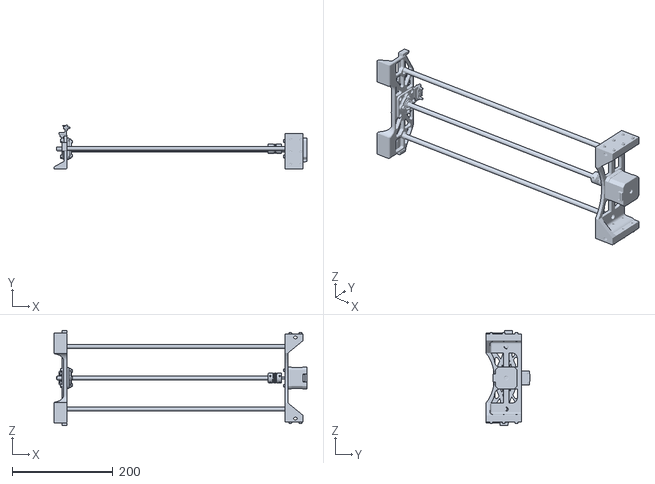
[picture p165: CAD file, 2026-10-26]
영상제작용 CAD파일/하부이송구조.stl
502.5 x 87.0 x 189.3
