khw1566/ARD/(list of files, cad)

Other CAD files:
ARD_hardware/TRCR_Project/TRCRv1/disk_v4/dick_v3.stl
ARD_hardware/TRCR_Project/TRCRv1/shaft.stl
ARD_hardware/CY300210_v1/hou.stl
ARD_hardware/TRCR_Project/TRCRv1/disk_v4/dick2_v3.stl
ARD_hardware/TRCR_Project/TRCRv1/s2.stl
영상제작용 CAD파일/베벨기어 상단부.stl
ARD_hardware/ARD_Model_v1/C.stl
ARD_hardware/Rali_v2/stand R_v3.stl
영상제작용 CAD파일/한방향 베벨기어만(B).stl
영상제작용 CAD파일/단일 베벨기어.stl
영상제작용 CAD파일/베벨기어만.stl
3축직교로봇 및 그리퍼.iam
ARD_Model_v1.iam
ARD_Model_v2.iam
ARD_hardware/3-axis parallel link robot/Object/120PI Turntable.ipt
ARD_hardware/3축직교로봇.idw
ARD_hardware/ARD_Model_v1/0325.idw
ARD_hardware/ARD_Model_v1/0402.iam
ARD_hardware/ARD_Model_v1/1/A.ipt
ARD_hardware/ARD_Model_v1/1/B.ipt
ARD_hardware/ARD_Model_v1/2.iam
ARD_hardware/ARD_Model_v1/2B_set.iam
ARD_hardware/ARD_Model_v1/2B_set_rali.iam
ARD_hardware/ARD_Model_v1/2B_set_rali_v2.iam
ARD_hardware/ARD_Model_v1/5_v2.ipt
ARD_hardware/ARD_Model_v1/C.ipt
ARD_hardware/ARD_Model_v1/C_v2.ipt
ARD_hardware/ARD_Model_v1/D.ipt
ARD_hardware/ARD_Model_v1/IS 6761 - M3 x 20 - 0.5.ipt
ARD_hardware/ARD_Model_v1/JIS B 1111 (H) - M4x25 - CU2 - H(3).ipt
ARD_hardware/ARD_Model_v1/JIS B 1181 - A_B M3.ipt
ARD_hardware/ARD_Model_v1/KS B 1003 - M 3 x 10.ipt
ARD_hardware/ARD_Model_v1/KS B 1003 - M 3 x 12.ipt
ARD_hardware/ARD_Model_v1/KS B 1003 - M 3 x 30.ipt
ARD_hardware/ARD_Model_v1/KS B 1003 - M 4 x 10.ipt
ARD_hardware/ARD_Model_v1/KS B 1003 - M 4 x 16.ipt
ARD_hardware/ARD_Model_v1/KS B 2023 - 6004 - 20 x 42 x 12 - 9.36.ipt
ARD_hardware/ARD_Model_v1/KS B 2023 - 685 - 5 x 11 x 3 - 0.458.ipt
ARD_hardware/ARD_Model_v1/KS B 2023 - 6906 - 30 x 47 x 9 - 7.868.ipt
ARD_hardware/ARD_Model_v1/KS B 2023 - 693 - 3 x 8 x 3 - 0.293.ipt
ARD_hardware/ARD_Model_v1/Load cell support.ipt
ARD_hardware/ARD_Model_v1/M/a.ipt
ARD_hardware/ARD_Model_v1/NEMA17.ipt
ARD_hardware/ARD_Model_v1/Object/8T_ScrewShaft.ipt
ARD_hardware/ARD_Model_v1/Object/8T_Shaft.ipt
ARD_hardware/ARD_Model_v1/Object/8T_TimingBelt_Pulley.ipt
ARD_hardware/ARD_Model_v1/Object/JIS B 1521 SKF (B) - SKF 623-RS1.ipt
ARD_hardware/ARD_Model_v1/Object/KS B 1003 - M 3 x 10.ipt
ARD_hardware/ARD_Model_v1/Object/KS B 1023 - A M 2 x 5 - H(1).ipt
ARD_hardware/ARD_Model_v1/Object/KS B 1326 - 3x7 - 101.ipt
ARD_hardware/ARD_Model_v1/Object/LeadWay_MIR.ipt
ARD_hardware/ARD_Model_v1/Object/LimitedSwitch.ipt
ARD_hardware/ARD_Model_v1/Object/NEMA17.ipt
ARD_hardware/ARD_Model_v1/Object/box big.ipt
ARD_hardware/ARD_Model_v1/Object/box.ipt
ARD_hardware/ARD_Model_v1/Object/플랫폼.iam
ARD_hardware/ARD_Model_v1/R-1.ipt
ARD_hardware/ARD_Model_v1/R-1_v2.ipt
ARD_hardware/ARD_Model_v1/R-2.ipt
ARD_hardware/ARD_Model_v1/RALI1.ipt
ARD_hardware/ARD_Model_v1/Sensor unit.iam
ARD_hardware/ARD_Model_v1/UR_rail_LeadNutHolder_v1.ipt
ARD_hardware/ARD_Model_v1/UR_rail_R_LinearWayCopler_v3.ipt
ARD_hardware/ARD_Model_v1/a.iam
ARD_hardware/ARD_Model_v1/as5600_holder.ipt
ARD_hardware/ARD_Model_v1/box.ipt
ARD_hardware/ARD_Model_v1/coupler.ipt
ARD_hardware/ARD_Model_v1/coupler/c1ipt.ipt
ARD_hardware/ARD_Model_v1/coupler/c2.ipt
ARD_hardware/ARD_Model_v1/e1.ipt
ARD_hardware/ARD_Model_v1/e2.ipt
ARD_hardware/ARD_Model_v1/f.ipt
ARD_hardware/ARD_Model_v1/hol.ipt
ARD_hardware/ARD_Model_v1/lj12.ipt
ARD_hardware/ARD_Model_v1/magnet_as5600.ipt
ARD_hardware/ARD_Model_v1/stand.ipt
ARD_hardware/ARD_Model_v1/stand_side.ipt
ARD_hardware/ARD_Model_v1/로드셀 정적분석.iam
ARD_hardware/ARD_Model_v1/접시.ipt
ARD_hardware/CY300208M4_v1/disk.ipt
ARD_hardware/CY300208M4_v1/hou.ipt
ARD_hardware/CY300208M4_v1/s1_v2.ipt
ARD_hardware/CY300208M4_v1/s2_v2.ipt
ARD_hardware/CY300210M4_v1/gear.ipt
ARD_hardware/CY300210M4_v1/hou.ipt
ARD_hardware/CY300210M8_v1/CY300210M8.iam
ARD_hardware/CY300210M8_v1/CY300210M8.stl
ARD_hardware/CY300210M8_v1/JIS B 1354 - B - 8 x 40.ipt
ARD_hardware/CY300210M8_v1/JIS B 1521 - 6804 20x32x7x4.ipt
ARD_hardware/CY300210M8_v1/JIS B 1521 - 6806 30x42x7x4.7.ipt
ARD_hardware/CY300210M8_v1/KS B 1003 - M 3 x 16.ipt
ARD_hardware/CY300210M8_v1/KS B 2023 - 693 - 3 x 8 x 3 - 0.293.ipt
ARD_hardware/CY300210M8_v1/casing.ipt
ARD_hardware/CY300210M8_v1/disk.ipt
ARD_hardware/CY300210M8_v1/hou.ipt
ARD_hardware/CY300210M8_v1/roter.ipt
ARD_hardware/CY300210M8_v1/roter_v2.ipt
ARD_hardware/CY300210_v1/gear.ipt
ARD_hardware/CY300210_v1/roter.ipt
ARD_hardware/CY300210_v1/s1.ipt
ARD_hardware/CY300210_v1/s2.ipt
ARD_hardware/CY300210_v1/s2_v2.ipt
ARD_hardware/CY300210_v1/s_v2.ipt
ARD_hardware/Common Objects/Bolt Nut/ANSI B18.2.4.5M - M6 x 1.ipt
ARD_hardware/Common Objects/Bolt Nut/ISO 4762 - M5 x 10ISO.ipt
ARD_hardware/Common Objects/Bolt Nut/JIS B 1176 - M4 x 12 - 0.7.ipt
ARD_hardware/Common Objects/Bolt Nut/JIS B 1176 - M4 x 6 - 0.7.ipt
ARD_hardware/Common Objects/Bolt Nut/JIS B 1181 - M4(7).ipt
ARD_hardware/Common Objects/Bolt Nut/KS B 1003 - M 2 x 16.ipt
ARD_hardware/Common Objects/Bolt Nut/KS B 1012 - B M 2.ipt
ARD_hardware/Common Objects/Motor and electronic components/16inch capacitive display.ipt
ARD_hardware/Common Objects/Motor and electronic components/HC-SR04.ipt
ARD_hardware/Common Objects/Motor and electronic components/IRremote_ReceivingSensor.ipt
ARD_hardware/Common Objects/Motor and electronic components/LimitedSwitch_MIR.ipt
ARD_hardware/Common Objects/Motor and electronic components/PIR_sensor.ipt
ARD_hardware/Common Objects/Motor and electronic components/SG90.ipt
ARD_hardware/Common Objects/Motor and electronic components/T8_BellowsCoulping.ipt
ARD_hardware/Common Objects/Motor and electronic components/로드셀 센서.ipt
ARD_hardware/Common Objects/Pneumatic fitting/J-CV-10/CV10_body.ipt
ARD_hardware/Common Objects/Pneumatic fitting/J-CV-10/J-CV-10.iam
ARD_hardware/Common Objects/Pneumatic fitting/J-CV-10/filter.ipt
ARD_hardware/Common Objects/Pneumatic fitting/VPC6-M5.ipt
ARD_hardware/Common Objects/Profile/2020 Angle Corner Brecket.ipt
ARD_hardware/Common Objects/Profile/2020 Panel Bracket.ipt
ARD_hardware/Common Objects/Profile/2020 Profile Pivot Joint/2020 Profile Pivot Joint.iam
ARD_hardware/Common Objects/Profile/2020 Profile Pivot Joint/2020 Profile Pivot Joint_하위.ipt
ARD_hardware/Common Objects/Profile/2020 Profile Pivot Joint/Cylinder fixing parts_A parts.ipt
ARD_hardware/Common Objects/Profile/2020 Profile Pivot Joint/Cylinder fixing parts_B parts.ipt
ARD_hardware/Common Objects/Profile/2020 Profile Series/2020Profile-100mm.ipt
ARD_hardware/Common Objects/Profile/2020 Profile Series/2020Profile-150mm.ipt
ARD_hardware/Common Objects/Profile/2020 Profile Series/2020Profile-200mm.ipt
ARD_hardware/Common Objects/Profile/2020 Profile Series/2020Profile-300mm.ipt
ARD_hardware/Common Objects/Profile/2020 Profile Series/2020Profile-500mm.ipt
ARD_hardware/Common Objects/Profile/2020 Profile Series/2020Profile-50mm.ipt
ARD_hardware/Common Objects/Profile/2020 Profile Series/2020Profile-800mm.ipt
ARD_hardware/Common Objects/Profile/2020FootEnd/2020 FootEnd.iam
ARD_hardware/Common Objects/Profile/2020FootEnd/2020 FootEnd.ipt
ARD_hardware/Common Objects/Profile/2020FootEnd/2020 FootEnd_FOOT.ipt
ARD_hardware/Common Objects/Profile/2020FootEnd/2020 FootEnd_t8.ipt
ARD_hardware/Common Objects/Profile/2020FootEnd/JIS B 1181 - M8(6).ipt
ARD_hardware/Common Objects/Shaft parts/JIS B 1521 SKF (D) - SKF 608-Z.ipt
ARD_hardware/Common Objects/Shaft parts/LeadWay_MIR1.ipt
ARD_hardware/Common Objects/Shaft parts/T8_LeadNut_MIR.ipt
ARD_hardware/Control Box_v1/BACK.ipt
ARD_hardware/Control Box_v1/CB_V1.iam
ARD_hardware/Control Box_v1/U-volt.ipt
ARD_hardware/Control Box_v1/bottom.ipt
ARD_hardware/Control Box_v1/side.ipt
ARD_hardware/Control Box_v1/top.ipt
ARD_hardware/HMI_v1/bor.ipt
ARD_hardware/M4 stand/m4 stand.ipt
ARD_hardware/M4 stand/삼각형 너트.ipt
ARD_hardware/M4 stand/삼각형 볼트.ipt
ARD_hardware/M4 stand/육망성 너트.ipt
ARD_hardware/M4 stand/육망성 볼트.ipt
ARD_hardware/PL121248Drive_v1/KS B 1003 - M 3 x 20.ipt
ARD_hardware/PL121248Drive_v1/KS B 1003 - M 3 x 25.ipt
ARD_hardware/PL121248Drive_v1/KS B 1003 - M 4 x 12.ipt
ARD_hardware/PL121248Drive_v1/KS B 1003 - M 4 x 16.ipt
ARD_hardware/PL121248Drive_v1/KS B 1012 - B M 3.ipt
ARD_hardware/PL121248Drive_v1/KS B 2023 - 608 - 8 x 22 x 7 - 3.25.ipt
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
