khw1566/ARD/output/ard-cg/cinematic_assembly.jpg

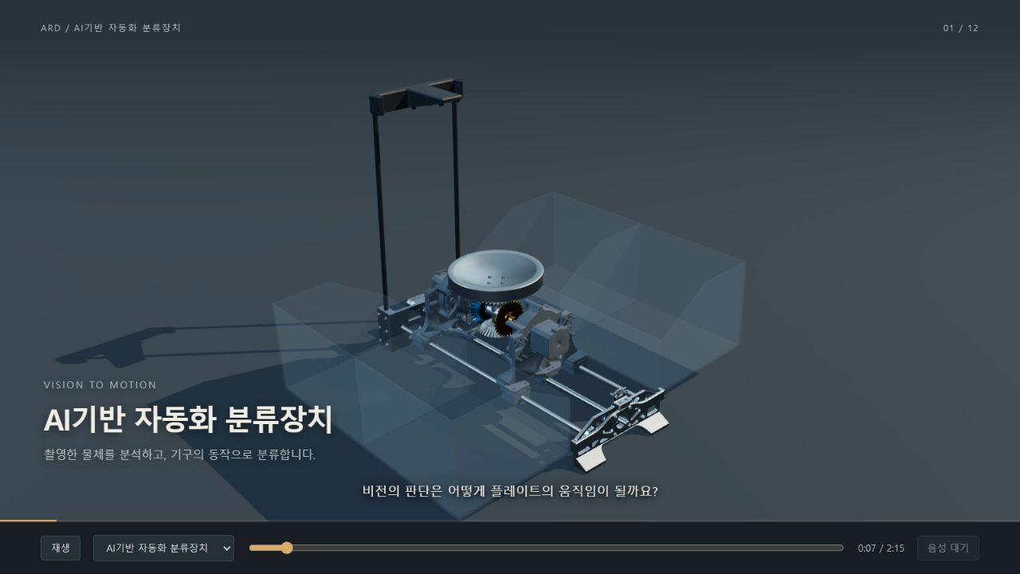
output/ard-cg/cinematic_assembly.jpg
