khw1566/ARD/results/261026_ToF_동기화지연.md

작성일: 2026-10-26
작성자: Claude

# DriveMCU ToF·레일 상태 동기화 지연

## 증상

DriveMCU의 TCP `status`(192.168.0.22:5002)는 0.5 s마다 바뀌는 `tof_mm`을 보고한다.
PC 화면(ARD_MAIN)과 JC1060 단말에는 ToF 거리와 레일 PID 상태가 늦게, 또는 틀리게 표시된다.

## 원인

1. PC가 ToF를 받는 경로는 DriveMCU 하트비트(HTTP POST `/api/heartbeat`) 하나였다. 기본 주기는 1000 ms(`mzh`)이다.
   하트비트에는 `tof_dist`만 있고 PID 상태, 레일 목표, 정착 여부는 없다.
2. JC1060은 `/api/status`(약 16 KB)를 3000 ms마다만 조회했다(`kPollMs`). 최대 4 s(하트비트 1 s + 조회 3 s) 늦게 표시되었다.
3. PC의 `drive_settings.pid_mode`와 `pid_target_tof`는 PC를 거친 명령의 기록일 뿐이었다.
   보드 실제값이 아니어서, 레일 도구·정렬 시퀀스·재부팅으로 바뀐 상태를 반영하지 못했다.
4. JC1060의 PID 버튼은 누르면 바로 ON이 되지만 다음 화면 갱신 때 PC의 옛 값으로 OFF로 돌아갔다. 목표(`railTarget`)는 보드 값과 다시 맞춰지지 않았다.
5. 브라우저는 `tof_status`를 읽지만 PC는 그 값을 저장하지 않았다. `drive_update` 이벤트는 `currentMotorState`를 덮어써 상태 표시를 지웠다.

## 수정

DriveMCU 펌웨어는 바꾸지 않았다. 보드의 TCP `status`가 이미 필요한 값을 모두 보고한다.

| 파일 | 변경 |
|---|---|
| `ARD_MAIN/backend/core/drive_live.py` (신규) | DriveMCU가 Online일 때 TCP `status`를 약 300 ms마다 읽는다. 값이 바뀌면 알린다. 조그·레일 도구가 읽은 `status`도 기록하고, 0.3 s 안의 새 값이 있으면 폴링을 건너뛴다. JC1060 조그 중에는 폴링하지 않는다(조그 경로가 0.5 s마다 읽음). `status`를 모르는 구 펌웨어에는 다시 보내지 않는다. 실패 시 간격을 늘린다. |
| `ARD_MAIN/backend/app.py` | `publish_drive_live`: ToF/상태를 `device_stats`, `motor_state`에 반영하고 SSE `drive_live`를 보낸다. PID/목표가 바뀌면 `drive_settings`를 보드 값으로 맞추고 `drive_update`를 보낸다. `/api/status`의 `drivemcu`에 `tof_status`, `live` 추가. `/api/hmi/updates`에 `drive` 추가. 하트비트의 `tof_status` 저장. 레일 도구와 JC1060 조그의 `status` 읽기를 `drive_request_line`으로 기록. 서버 시작 시 폴링 스레드 시작. |
| `ARD_MAIN/frontend/static/js/main.js` | SSE `drive_live` 처리(HUD ToF 값·상태). `drive_update` 후에도 `tof_status` 유지. |
| `ARD_MAIN/frontend/static/js/rail-tools.js` | 레일 실시간 표시가 `drive_live` 푸시로도 갱신된다. 1.5 s 조회는 대체 경로로 남겼다. |
| `ARD_ESP-IDF/JC1060P470C/main/pc_link.h/.cpp` | `/api/hmi/updates` 조회 간격 1000 → 500 ms(정렬 중 300 ms 유지). 응답의 `drive`에서 ToF, ToF 상태, PID, 레일 목표, 정착 여부를 읽는다. 구 PC 프로그램이면 기존 값을 그대로 쓴다. |
| `ARD_ESP-IDF/JC1060P470C/main/ui.cpp` | PID 버튼과 목표값이 보드 실제 상태를 따른다. 버튼을 누른 뒤 1.5 s 동안은 누른 값을 유지한다(깜빡임 방지). ToF 줄에 상태와 PID 정착 여부를 표시한다. CRLF 유지. |
| `ARD_MAIN/tests/test_drive_live.py` (신규), `tests/test_drive_command_route.py` | 폴링 테스트 5개 추가. 기존 실패(`rail_tools` 미정의) 테스트 환경 보완. |

호환성: 조그(`j<x>,<y>,<z>`, 400 ms 데드맨), `zero`, `/api/rail/*`, 음성 안내 제한은 바꾸지 않았다. 폴링은 TCP `status`만 보내고 음성 안내를 만들지 않는다.

## 예상 지연

- PC 브라우저: 보드 값 → 약 0.3 s 안에 SSE로 표시(이전 최대 1 s + 화면 갱신).
- JC1060: 약 0.3 s(PC 폴링) + 0.5 s(단말 조회) 이내(이전 최대 4 s). JC1060 펌웨어를 다시 빌드해야 적용된다. 빌드 전에도 PC가 `/api/status`의 값을 최신으로 유지하므로 3 s 주기 안에서는 최신 값이 보인다.

## 시험 (빌드 없음)

- `python -m unittest` (ARD_MAIN/tests): test_board_settings 17, test_camera_stream 3, test_drive_command_route 9, test_drive_live 5, test_drive_state 5, test_drive_transport 12, test_guidance_repeat 4, test_hmi_clock 1, test_image_protocol 8, test_jc1060_drive 56, test_jc1060_voice 13, test_rail_control 16, test_remote_gateway 8, test_sorting_integration 4, test_sorting_pipeline 13: 모두 OK.
- `node tests/*.cjs`: board_dashboard, drive_delivery, drive_simulation, sorting_dashboard OK. `test_drive_model_geometry.cjs`는 three.js 경로 인자가 필요해 인자 없이 실행되지 않는다(이번 변경과 무관).
- `node --check` main.js, rail-tools.js OK.
- 컴파일과 실기 확인은 하지 않았다.

## 사용자 작업

1. PC 프로그램(ARD_MAIN 서버) 재시작. 브라우저 새로고침.
2. JC1060 펌웨어 빌드·업로드(PowerShell, `ARD_ESP-IDF\JC1060P470C`에서):

```powershell
cd C:\Users\work\Desktop\ARD_v1\ARD_ESP-IDF\JC1060P470C
.\build.ps1
.\build.ps1 flash -Port COM9
```

포트 번호는 실제 연결된 COM 포트로 바꾼다. DriveMCU는 다시 빌드할 필요가 없다.
