khw1566/ARD/results/261026_Z축_안전한계_70_120mm.md

작성일: 2026-10-27
작성자: Claude

# Z축 안전 한계 ToF 70~120 mm

## 동작

### DriveMCU 펌웨어 (실제 안전 한계)

- 기본 한계는 ToF 70~120 mm이다. NVS `ard-rail`(`lim`, `lmin`, `lmax`)에 저장되고, 값이 바뀔 때만 기록한다.
- 명령:
  - `mzl<min>,<max>`: 한계 켜기·변경. 1~2000 mm, 최대 − 최소 ≥ 10.
  - `mzl0`: 한계 끄기. 센서를 달지 않은 벤치 시험용이며, 값은 그대로 남는다.
  - PC는 선별·배출 시험·보정 적용 전에 다른 레일 설정과 함께 `mzl`을 다시 보낸다. 끈 상태로 두어도 PC 작업을 시작하면 다시 켜진다.
- `mzt` 목표가 한계 밖이면 `ERR:REJECTED`(로그 남김). PID 목표가 한계 밖이면 `mzm1`도 거부한다.
- 1 kHz 모션 루프 감시: 모든 Z 이동(큐의 `mzr`, 조그 `j`의 Z, PID)이 대상이다.
  - 최신 ToF와 `rail_dir`로 이동이 거리를 늘리는지 줄이는지 판단한다.
  - 한계 쪽으로 가면서 남은 거리가 정지 여유 이하이면 Z 가속도로 감속 정지한다. 이미 한계를 넘었으면 즉시 멈춘다.
  - 정지 여유 = 제동 거리 v²/(2a)(mm 환산) + ToF 지연 0.3 s × 속도 + 1 mm.
  - 한계에 PID 데드밴드 2 mm를 허용한다. 그래서 목표 120 mm(원점)에 도달할 수 있다.
  - 한계에서 멀어지는 이동은 항상 허용한다(복구용).
  - 감속 목표는 한 번 정해 유지한다. Python 모델 시험에서, 매 틱 `stop()`을 다시 부르면 감속하지 않고 한계를 넘는 것을 확인해 이렇게 고쳤다.
- 한계가 켜져 있는데 최신 ToF가 없으면 새 Z 이동(`mzr`, Z 조그)을 거부하고, 진행 중인 Z는 멈춘다. X/Y는 영향이 없다.
- 정지·거부는 로그를 남긴다. 같은 사유의 반복 로그는 2초에 한 번만 남긴다.
- `status`에 추가한 항목:
  - `rail_limit_on`, `rail_min`, `rail_max`
  - `rail_limit_count`: 정지·거부 횟수
  - `rail_limit`: 마지막 사유
- 감시 계산 모델(최고 속도 접근 시 약 118.3 mm에서 정지, rail_dir ±1, 복구 허용): `python -m unittest discover -s ARD_ESP-IDF/DriveMCU/test/model`.

### PC 프로그램

- 레일 설정에 `rail_min_mm` = 70, `rail_max_mm` = 120을 추가했다(최대 − 최소 ≥ 10). 원점·중앙·+측·-측이 범위 밖이면 저장을 거부한다.
- 범위 검사 대상: 임의 목표 이동, 현재 위치 저장(원점 포함), PID 이동, 배출 위치 시험, 선별.
- 현재 저장값(중앙 95, +측 70, -측 120, 원점 120)은 모두 범위 안이다.
- 개루프 배출 이동: 더 이상 ±15 mm가 아니다. 원점에서 배출 위치 ToF까지 `(목표 − 원점) × steps/mm × rail_dir` 스텝으로 이동하고, 목표가 한계 밖이면 거부한다.
  - 예: 원점 120 → +측 70 = (70 − 120) × 43.48 × (−1) = +2174 스텝.
  - -측 120은 원점과 같아서 레일을 움직이지 않는다.
- 선별 중 보드가 한계로 Z를 멈추면 "Z축 안전 한계로 정지했습니다: …"로 바로 멈춘다. 이후 전도 동작은 하지 않는다.
- 화면:
  - 구동 보드 탭 PID 슬라이더·입력 범위를 70~120으로 바꿨다.
  - 레일 설정 행에 "Z축 안전 한계 (ToF mm)" 입력을 추가했다(설정 저장 시 반영).
  - drive_live가 보드의 한계 값을 HMI·JC1060에 전달한다.

### HMI_MCU · JC1060

- HMI_MCU와 PC HMI 시뮬레이터: PID 목표 70~120(5 mm 단위, 기본 120). PC가 보드 한계(`drivemcu.live.rail_min/rail_max`)를 보내면 그 값을 쓴다.
- JC1060: 레일 슬라이더·± 버튼 범위가 PC 레일 설정의 `rail_min_mm`~`rail_max_mm`(없으면 70~120)이다.

## 벤치 시험(센서 미장착)에서 한계 끄기

PC 프로그램 구동 보드 탭 명령 입력이나 시리얼 콘솔에서 `mzl0`을 보낸다. 다시 켜려면 `mzl70,120`을 보낸다.

PC의 선별·배출 시험·보정 적용은 시작할 때 `mzl70,120`을 다시 보낸다.

## 변경 파일

- DriveMCU: `main/motion.cpp`, `main/motion.h`, `main/commands.cpp`, `main/command_servers.cpp`(CRLF 유지), `main/CommandValidation.h`, `main/stepper_engine.h`, `README.md`, `test/model/test_rail_limit_model.py`(신규).
- PC: `backend/core/rail_control.py`, `backend/core/sorting_pipeline.py`, `backend/core/drive_live.py`, `backend/app.py`(mzl 음성 안내 제외), `frontend/templates/components/sidebar.html`, `frontend/static/js/rail-tools.js`, `frontend/static/js/hmi-simulator.js`.
- HMI_MCU: `main/hmi_ui.c`, `main/hmi_model.c`, `main/hmi_model.h`, `main/hmi_net.c`.
- JC1060: `main/pc_link.cpp`.
- 테스트: `tests/test_rail_control.py`(SafetyLimitTests 신규 등), `tests/test_sorting_pipeline.py`, `tests/test_pid_target_ranges.py`.

## 시험 (빌드 없음)

- `python -m unittest discover` (ARD_MAIN/tests): 240개 OK.
- DriveMCU 감시 모델: 6개 OK.
- `node tests/*.cjs`: 5개 OK(`test_drive_model_geometry.cjs`는 three.js 경로 인자가 필요해 제외).
- 컴파일·실기 확인은 하지 않았다. 실제 정지 위치는 속도·가속도·ToF 필터에 따라 다르므로, 첫 실기 시험은 낮은 속도에서 하고 비상정지를 준비한다.

## 사용자 작업 (PowerShell)

1. DriveMCU(필수):
   ```powershell
   cd C:\Users\work\Desktop\ARD_v1\ARD_ESP-IDF\DriveMCU
   .\build.ps1
   .\build.ps1 flash-monitor -Port COM5
   ```
2. JC1060:
   ```powershell
   cd C:\Users\work\Desktop\ARD_v1\ARD_ESP-IDF\JC1060P470C
   .\build.ps1
   .\build.ps1 flash -Port COM9
   ```
3. HMI_MCU(CYD)를 쓰는 경우:
   ```powershell
   cd C:\Users\work\Desktop\ARD_v1\ARD_ESP-IDF\HMI_MCU
   .\build.ps1
   .\build.ps1 flash COM5
   ```
4. PC 서버(ARD_MAIN) 재시작, 브라우저 새로고침.

COM 번호는 실제 포트로 바꾼다.
