khw1566/ARD/results/261026_선별시퀀스_초기화단계.md

작성일: 2026-10-27
작성자: Claude

# 선별 시퀀스 1단계 '초기화' 추가

## 변경 내용

선별 시퀀스가 5단계에서 6단계가 되었다.

| 단계 | step | phase | 내용 |
|---|---|---|---|
| 1 | initializing | init | 초기화 (신규) |
| 2 | capturing | capture | 촬영 및 수신 |
| 3 | inferring | analyze | AI 재질 분석 |
| 4 | rotating | rail_out, yaw_out | 레일 이송 및 선회 |
| 5 | dumping | roll_out, settle | 전도 덤핑 배출 |
| 6 | homing / complete | roll_back, yaw_back, rail_back, done | 원위치 복귀 |

1단계 초기화 순서 (`ARD_MAIN/backend/core/sorting_pipeline.py`):

1. DriveMCU 상태 확인. 동작 중(busy), PID ON, 조그 중, 정지 상태, `status` 미지원 펌웨어이면 아무것도 움직이지 않고 오류로 끝낸다.
2. 레일 PID 모드(`rail_calibration.json`의 `mode: pid`)이면 3개 위치 티칭 여부와 ToF를 확인한다. 레일 보정값을 보낸 뒤 ToF PID로 레일을 촬영 위치(`capture_mm`, 없으면 `center_mm`)에 맞추고 PID를 끈다. 표시: "레일 PID 원점(촬영 위치 ○mm) 복귀 중". 이전의 시작 전 "촬영 위치 정렬" 동작이 이 단계로 옮겨졌다.
3. 트레이 X/Y가 0이 아니면 `home`을 보내고, 보드가 정지(busy 아님)하고 x=0, y=0을 보고할 때까지 기다린다(45 s 제한, 재부팅·비상정지 감지 시 중단). 표시: "트레이 X/Y 원점 복귀 중". 예전에는 이 경우 "원점 복귀가 필요합니다" 오류로 멈췄다.
   - `home`이 거부되면 다른 명령 없이 오류로 끝난다(재시도 가능).
   - `home`을 받아들인 뒤 실패하면 `x`(정지)를 보내고 수동 초기화를 요구한다.
4. "초기화 완료" 표시 후 2단계(촬영)로 넘어간다.

개루프(open_loop) 모드는 3번만 수행한다. 레일은 현재 스텝 위치를 시작 위치로 쓴다(이전과 같음).

## 변경 파일

- `ARD_MAIN/backend/core/sorting_pipeline.py`: `home_xy()` 추가, 1단계 추가, step_num 2~6으로 이동, 진행률 조정.
- `ARD_MAIN/backend/app.py`: 시작 직후 표시를 `initializing`/`init`(1단계)로 변경.
- `ARD_MAIN/frontend/templates/index.html`: 단계 카드 6개(STEP 1 초기화), 6열 배치.
- `ARD_MAIN/frontend/static/js/main.js`: 단계 제목·색 6개, "STEP n/6" 표시.
- `ARD_MAIN/frontend/static/css/style.css`(초기화 색 `step-c0`), `mobile.css`(6열), `templates/components/sidebar.html`(STEP 0 / 6).
- `ARD_ESP-IDF/JC1060P470C/main/ui_main.cpp`(CRLF): 메인 탭 단계 카드 6개(1 INIT … 6 RETURN), `init` 단계 안내 문구, 애니메이션(레일 0 mm, 선회·기울기 0°).
- `ARD_ESP-IDF/JC1060P470C/main/ui_text.cpp`: 한글 번역(1 초기화 등). `main/ard_font_hangul.c`: `tools/gen_hangul_font.py`로 새 한글 글자를 다시 생성했다(304자).
- 테스트: `tests/test_sorting_pipeline.py`(원점 밖이면 home 후 계속, home 거부 시 다른 동작 없음, home 미도달 시 촬영 전 중단, 상태 조건, phase 순서), `tests/test_rail_control.py`(레일 PID 후 home 후 촬영, PID 실패 시 home·촬영 없음), `tests/test_sorting_dashboard.cjs`(6단계 표시).

조그, `zero`, 레일 도구(`/api/rail/*`), drive_live 폴링, 음성 안내 제한은 바꾸지 않았다.

## 시험 (빌드 없음)

- `python -m unittest discover` (ARD_MAIN/tests): 214개 OK.
- `node tests/*.cjs`: board_dashboard, drive_delivery, drive_simulation, rail_pid_ui, sorting_dashboard OK. (`test_drive_model_geometry.cjs`는 three.js 경로 인자가 필요해 제외)
- `python tools/check_ui_text.py`: 새 키는 모두 소스와 일치한다. 이전부터 있던 5개 불일치(PID: ON 등)는 그대로다.
- 컴파일, 실기 동작은 확인하지 않았다. 실제 모터 동작은 없었다.

## 사용자 작업

1. PC 서버(ARD_MAIN) 재시작, 브라우저 새로고침.
2. JC1060 펌웨어 빌드·업로드(PowerShell):

```powershell
cd C:\Users\work\Desktop\ARD_v1\ARD_ESP-IDF\JC1060P470C
.\build.ps1
.\build.ps1 flash -Port COM9
```

COM 번호는 실제 포트로 바꾼다. DriveMCU는 다시 빌드하지 않아도 된다(`home`, `status`, 레일 PID 명령은 기존 펌웨어에 있음).

3. 첫 실기 확인 때는 트레이를 원점에서 조금 돌려 둔 상태로 시작한다. 1단계에서 레일이 촬영 위치로, 트레이가 원점으로 돌아온 뒤 촬영이 시작되는지 확인한다. 이상하면 비상정지한다.
