khw1566/ARD/results/261026_시퀀스_원점복귀_120mm.md

작성일: 2026-10-27
작성자: Claude

# 선별 시퀀스 원점 복귀 (디스크 수평 · 레일 ToF 120mm)

## 정한 설정

- **원점 = 디스크 수평(X/Y = 0) + 레일 ToF `home_mm`**. 기본값은 120 mm이고 1~2000 mm에서 바꿀 수 있다. 사용자가 정한 값이므로 티칭이 필요 없다.
- 기존 `capture_mm`(촬영 위치, 120)은 같은 설정의 예전 이름으로 남겼다. 저장·응답 시 `capture_mm = home_mm`로 맞추므로 설정은 하나다. 원점이 곧 촬영 위치다. 예전 화면·JC1060 펌웨어도 계속 읽을 수 있다.
- 디스크 원점은 보드 X/Y 0이다. `home` 명령으로 맞추고 status로 확인한다. `zero`로 원점을 다시 정할 수 있다.

## 현재 저장값 (`ARD_MAIN/backend/rail_calibration.json`, 변경하지 않음)

```
"mode": "open_loop", "center_mm": 95.0, "plus_mm": 70.0, "minus_mm": 120.0, "capture_mm": 120.0,
"taught": {"center": true, "plus": true, "minus": true}, "rail_dir": -1, "steps_per_mm": 23.683,
"pid_p": 0.12, "pid_i": 0.0, "pid_d": 0.0, "settle_s": 0.3, "timeout_s": 15.0, "tilt_deg": 45.0
```

- 이 파일은 읽으면 `home_mm = 120`(capture_mm에서)이 된다.
- 구동 방식은 **open_loop**로 저장되어 있다. 그대로 두었다.
- minus 120 = 원점 120이어도 충돌이 없다. "+측과 -측은 중앙의 반대쪽" 검사는 center/plus/minus끼리만 한다. 원점은 이 검사와 무관하다.

## 동작

| 단계 | 내용 |
|---|---|
| 1 원점 복귀 | 상태 확인 → X/Y가 0이 아니면 `home` 후 확인(디스크 수평) → 레일 ToF PID로 `home_mm` 정착 후 PID 끔 |
| 4 레일 이송 | PID 모드: 티칭된 배출 위치 ToF. 개루프: 원점에서 ±15 mm 스텝 |
| 6 복귀 | 전도 복귀(수평) → 레일 ToF PID로 `home_mm` |
| 배출 위치 시험 | 레일 이동 → 전도 → 2 s → 전도 복귀 → 레일 ToF `home_mm` |

- 원점 이동은 두 모드 모두 ToF PID를 쓴다. 조건은 보드가 레일 PID 펌웨어이고 ToF가 정상인 것이다.
- 개루프에서 ToF/PID를 쓸 수 없으면 예전처럼 현재 레일 위치를 시작으로 쓴다. 이때 단계 설명에 "원점 ToF … 미적용" 경고를 표시하고, 복귀는 스텝으로 되돌린다. PID 모드에서는 오류로 멈춘다.
- 티칭: 원점은 필요 없다. PID 모드는 배출 위치 표에서 쓰는 레일 위치(기본 +측, -측)만 티칭되어 있으면 된다(이전에는 3개 모두).

## 화면

- PC 구동 보드 탭 레일 도구 ③ 표 맨 위에 **원점(홈)** 행을 추가했다: ToF 입력, [현재 위치를 원점으로 저장], [PID로 원점 이동]. [입력값으로 저장]도 원점값을 저장한다. 설정 행의 "촬영·시작 위치" 입력은 이 행으로 합쳤다.
- 선별 단계 1: "원점 복귀 / 디스크 수평 · 레일 ToF 120mm"(저장값 표시). JC1060 메인 탭: "1 원점 복귀 / 수평, 레일 120 mm". JC1060 레일 프리셋 "Camera" → "Home(원점)".
- PID 목표 범위: HMI_MCU `PID_MIN/MAX` 145~175 → **30~300 mm**(5 mm 단위, 기본 목표 120)와 PC HMI 시뮬레이터. PC 슬라이더 기본 30~300(티칭되면 티칭값·원점 ±10 mm). JC1060 슬라이더는 티칭값과 원점 ±10 mm, 30~300으로 제한한다.

## 변경 파일

- PC: `backend/core/rail_control.py`, `backend/core/sorting_pipeline.py`, `frontend/templates/components/sidebar.html`, `frontend/templates/index.html`, `frontend/static/js/rail-tools.js`, `frontend/static/js/main.js`, `frontend/static/js/hmi-simulator.js`.
- JC1060: `main/pc_link.cpp`, `main/ui.cpp`, `main/ui_main.cpp`(CRLF 유지), `main/ui_text.cpp`, `main/ard_font_hangul.c`(재생성).
- HMI_MCU: `main/hmi_ui.c`, `main/hmi_model.c`.
- 테스트: `tests/test_sorting_pipeline.py`, `tests/test_rail_control.py`, `tests/test_pid_target_ranges.py`(신규), `tests/test_rail_pid_ui.cjs`, `tests/test_sorting_dashboard.cjs`.

## 시험 (빌드 없음)

- `python -m unittest discover`: 234개 OK.
  - 추가: 티칭 없이 원점 120으로 이동, 복귀도 원점, 배출 시험 후 원점, 개루프 ToF 없을 때 경고와 스텝 복귀, 원점 별칭·범위 검증, 현재 위치를 원점으로 저장, 배출 위치만 티칭 요구, 범위 일치(HMI C ↔ 시뮬레이터, PC 슬라이더, JC1060).
- `node tests/*.cjs`: 5개 OK. 컴파일·실기 확인은 하지 않았다.

## 사용자 작업

1. PC 서버(ARD_MAIN) 재시작, 브라우저 새로고침.
2. JC1060 빌드·업로드(PowerShell):
   ```powershell
   cd C:\Users\work\Desktop\ARD_v1\ARD_ESP-IDF\JC1060P470C
   .\build.ps1
   .\build.ps1 flash -Port COM9
   ```
3. HMI_MCU(CYD)를 쓰는 경우 빌드·업로드:
   ```powershell
   cd C:\Users\work\Desktop\ARD_v1\ARD_ESP-IDF\HMI_MCU
   .\build.ps1
   .\build.ps1 flash COM5
   ```
   COM 번호는 실제 포트로 바꾼다. DriveMCU는 다시 빌드할 필요가 없다.
