khw1566/ARD/results/261027_Git_전체작업_게시점검.md

# 전체 작업 Git 게시 점검

2026-10-27. 사용자가 다른 에이전트 작업을 포함해 커밋·푸시를 요청했고,
추가 범위 확인에서 **CG·CAD 작업까지 모두 포함**을 선택했다.

- 저장소: `https://github.com/khw1566/ARD`, 브랜치 `ard-v1`.
- 시작 기준: `b546798`. 원격 fetch 결과 로컬/원격 차이 0/0이며 병합은 필요 없었다.
- 포함: DriveMCU 안전·조그·센서 변경, HMI 및 ImageSender 복구, PC 제어·선별·카메라,
  JC1060 화면 보호기·픽토그램·Cloud 음성·SD 웹 업로드·HP/LP 진단, CG 제작 소스·폰트·라이선스,
  CAD/STL·사용자 원본 촬영본, KiCad/PDF/미리보기·패키지, 관련 작업 기록.
- 기존 비공개/재생성 제외 규칙 유지: `.env`, 비공개 설정, 빌드·종속성, 개인 TTS 및 다운로드 음원,
  렌더 캐시·최종 영상 제외 경로. 임시 리뷰 이미지·화면 보호기 백업·Cloud 생성 캐시·KiCad 로컬 환경 파일도 제외했다.
  파일을 삭제하지 않았다.
- `ARD_MAIN/backend/config/config_manager.py`는 공백만 바뀌었으므로 해당 로컬 변경은 커밋하지 않고 남겼다.
- 원본 촬영본은 약 87.06 MiB. 후보 파일 모두 100 MiB 미만이며 Git LFS 전환이나 과거 이력 변경은 하지 않았다.

## 이번 게시 전 검사

- Python PC 회귀 검사 245개 통과.
- Node 검사 6개 통과: 보드 대시보드, 전송, 실제 Three.js r160 기하, 구동 시뮬레이션, 레일 PID UI, 선별 대시보드.
- DriveMCU 레일 안전 Python 모델 검사 6개 통과. C++ 펌웨어 실행 결과와 구분한다.
- 첫 제한 환경 실행은 localhost 소켓·임시 파일 rename 권한 때문에 실패했다.
  일반 로컬 환경에서 같은 PC 검사를 다시 실행해 245개가 통과했다. 소스를 수정해 테스트를 숨기지 않았다.
- 게시 후보의 실제 알려진 키 값·키 패턴·비공개 경로 및 ZIP 내부를 검사했다. 탐지 결과 없음.
- 커밋 전 staged diff 공백 검사와 staged 목록 재검사를 수행한다.

이번 커밋·푸시 작업에서는 펌웨어를 다시 빌드하거나 장치를 다시 플래시하지 않았다.
이전 JC1060 빌드·업로드 결과는 별도 기록을 따르며, 이후 다른 에이전트의 모든 소스 변경까지
장치에서 검증됐다는 뜻은 아니다. Git 게시 성공은 실물 전체 시스템 검증을 의미하지 않는다.
