khw1566/ARD/results/261022_복원병합결과.md

# 코드·CAD 복원 및 병합 결과

작성일: 2026-10-22 (KST)
작성자: Codex

- 복원 기준: GitHub `ard-v1` 커밋 `871f7765c52c63030560217e86b444dc1999c6f0`.
- GitHub `main` 비교 기준: `11c41835179a4d8c7c3db6e131866e593a78d55f`.
- 사용자가 최종 선택한 목표: 기본 브랜치를 `ard-v1`으로 변경. `main`의 이름이나 이력은 변경하지 않음.

## 복원

- 사라졌던 추적 파일 40개를 원래 커밋에서 복원함. 추적 파일의 경로 누락 0개.
- CAD 관련 복원: `ARD_hardware/ARD_Model_v1/1/a/설계 1/설계 1.cfdes`, `설계 1.tsl`, `ARD_hardware/TRCR_Project/TRCRv1/disk_v4/dick2_v3.stl`.
- CAD·하드웨어 추적 파일 741개, 총 558,019,965바이트 검사. Git 기준 내용 불일치 0개.
- 이 중 주요 설계 파일: IAM 42개, IPT 460개, IDW 9개, STL 177개.
- `design_studies.info`, `CE5_c1ipt.gcode`는 작업 폴더의 줄바꿈만 달라 Git 필터 적용 후 원격 내용과 일치함.
- `main`의 추적 파일에는 IAM/IPT/IDW/STL/STEP/STP/DWG/DXF/IPJ 파일이 없었음. CAD 복원 기준은 CAD가 포함된 `ard-v1`임.
- 상세 경로별 검증은 `261022_CAD_파일검증.json`에 기록함.
- Inventor에서 조립품을 열어 외부 참조와 형상을 검사한 결과는 아님. GitHub에 없는 외부 설계 파일의 존재 여부는 이 검사로 판정할 수 없음.

## 코드 병합

- PC 파일은 `main`의 직전 커밋을 공통 내용 기준으로 삼아 세 방향 내용 병합을 수행함. `ard-v1`에 이미 포함된 개선은 유지됨.
- 겹친 부분 3곳은 기존 헤더 배치·HMI 시뮬레이터·시뮬레이터 스타일을 유지해 해결함.
- `main`에만 있는 서버 시작 파일은 로컬 `ARD_software/pc_center/backend/app.py`에 더 최신 선별 기능이 있어 이 사본을 바탕으로 복구함.
- `ARD_MAIN/backend/app.py`에 이미지 전송 v2 수신기, 4MB 수신 버퍼, JPEG 전체 디코딩 검증, TCP 촬영 ACK 확인 및 구형 폴링 대체 경로를 연결함.
- 기존 ESP-IDF 로컬 수정 26개와 공용 Wi-Fi/HMI 추가 소스는 유지함.
- 내부 `ARD` 저장소와 `ARD_software`는 별도 보관된 기존 코드이며 중첩 저장소가 실수로 추가되지 않도록 제외함.
- 복원 전 수정·미추적 파일 백업: `tmp/restore-merge-20261022/before.zip`. 해당 백업은 원격 업로드 대상이 아님.

## 검증

- `python -m unittest discover -s ARD_MAIN/tests -p 'test_*.py'`: 29개 통과.
- `node ARD_MAIN/tests/test_drive_simulation.cjs`: 통과.
- `node ARD_MAIN/tests/test_sorting_dashboard.cjs`: 통과.
- PC 백엔드 Python 구문 검사, 프런트엔드 JavaScript 전체 구문 검사: 통과.
- HTML의 정적 파일 참조: 누락 0개.
- ESP-IDF 펌웨어 재빌드·플래시, 실제 서버 전체 기동 및 MCU 실기기 시험은 수행하지 않음.

## 원격 반영

- 복원·병합 커밋 `fac860f`를 GitHub `ard-v1`에 업로드 완료.
- GitHub API 응답에서 기본 브랜치 `ard-v1` 확인.
- 기존 `main` 커밋 `11c41835179a4d8c7c3db6e131866e593a78d55f` 보존.
- Wi-Fi 설정 페이지 JavaScript 회귀 검사도 통과.
- 로컬의 중복 헤더 `ard_network(1).h`와 별도 학회 보고서 폴더는 이번 업로드에 포함하지 않음.
