khw1566/ARD/results/261026_메인프로그램_원점설정_카메라_모델.md

작성일: 2026-10-26
작성자: Claude

# 메인 프로그램: 현재 위치 원점 설정, 카메라 탭 잘림, Gemini 기본 모델

## 1. 현재 위치를 원점으로 설정
DriveMCU에는 현재 위치를 0으로 바꾸는 명령이 없었습니다(`home`은 0으로 이동만 함). 새 명령 `zero`를 추가했습니다.

| 위치 | 내용 |
|---|---|
| DriveMCU `motion.*` | `motion_set_origin()`: 모든 축이 정지 상태일 때 X/Y/Z 현재 위치를 0으로 설정. 이동·조그·귀환·대기 큐가 있으면 거부 |
| DriveMCU `commands.cpp`, `CommandValidation.h` | `zero` 명령, 도움말, 검증 목록 |
| PC `backend/app.py` | `update_motor_state`가 `zero`를 `home`처럼 처리해 위치 추정을 0으로 초기화 |
| PC `sidebar.html`, `simulation-drive.js`, `translations.js` | 구동 탭(디스크 제어 카드)과 선별 탭 사이드 카드에 "현재 위치를 원점으로 설정" 버튼. 확인 창 후 `zero` 전송, 성공하면 3D 모델을 애니메이션 없이 0으로 맞춤 |

JC1060 조그와의 관계: PC 명령이 들어오면 JC1060 조그는 해제되고, 다시 RE-ARM할 때 보드 위치를 새 기준으로 읽으므로 위치 추정이 이중으로 빠지지 않습니다.

## 2. 카메라 탭 이미지 잘림
원인: `#latest-image`가 `height: 100%`였지만 컨테이너 높이가 정해지지 않아 이미지 원래 비율 높이로 컨테이너를 늘렸습니다. 1920×1080 화면에서 800×600 이미지가 1058px 높이가 되어 화면 아래가 잘렸습니다(1366×768, 2560×1440도 같음).
수정: 이미지를 `position: absolute; inset: 0` + `object-fit: contain`으로 바꿔 컨테이너(오른쪽 패널 높이)에 맞춥니다. 렌더링 비교에서 이미지 전체가 화면 안에 들어오는 것을 확인했습니다.

## 3. Gemini 2.5 Flash-Lite 기본값
코드 기본값은 이미 `gemini-2.5-flash-lite`였지만, `backend/.env`에 `GEMINI_MODEL=gemini-3.1-flash-lite`가 저장돼 있어 덮어쓰고 있었습니다(설정 화면에서 모델을 바꾸면 .env에 저장됨). .env 값을 `gemini-2.5-flash-lite`로 바꿨습니다.

## 검증
- `node --check`(JS 2개), Python 구문 검사 통과. `test_board_dashboard.cjs`, `test_drive_simulation.cjs`, `test_sorting_dashboard.cjs` 통과.
- Flask가 필요한 Python 시험은 이 작업 환경에 Flask가 없어 실행하지 못함.
- 펌웨어 빌드·실물 확인은 하지 않음 (AGENTS.md).

## 사용자 실행
```
cd C:\Users\work\Desktop\ARD_v1\ARD_ESP-IDF\DriveMCU
.\build.ps1 flash-monitor -Port COMx
```
PC 프로그램(ARD_MAIN)을 다시 시작합니다. 시리얼에서 `zero` 입력 후 `Current position set as origin`이 나오면 정상입니다.

# 추가: 선별 시퀀스 현재 단계 표시 (2026-10-26)
| 항목 | 내용 |
|---|---|
| 단계 블록 색상 | 단계마다 고유색(1 촬영 하늘색, 2 AI 보라, 3 레일·선회 노랑, 4 덤핑 주황, 5 복귀 청록). 진행 중 블록은 그 색으로 채워지고 깜빡임, 완료는 초록, 중단된 단계는 빨강 |
| 블록 상태 글자 | 각 블록 아래 `대기` / `▶ 진행 중` / `✓ 완료` / `✕ 중단` |
| 현재 작업 배너 | 단계 블록 아래 새 띠: `STEP 3/5 · 레일 이송 및 선회 진행 중`, 세부 동작 문구(예: 금속/캔 배출 위치로 레일 이송 중), 경과 시간, 진행률 막대. 색은 진행 중 단계 색 |
| 보완 | 대기 상태에서 STEP 1이 항상 "진행 중"처럼 보이던 문제 제거. 오류 시 몇 번째 단계에서 왜 멈췄는지 표시. 대기 상태 상단 설명이 `-`로 바뀌던 문제 수정. 움직임 줄이기 설정을 쓰는 PC에서는 깜빡임 끔 |

파일: `frontend/templates/index.html`, `frontend/static/css/style.css`, `frontend/static/js/main.js`, `tests/test_sorting_dashboard.cjs`(검사 추가). `test_sorting_dashboard.cjs`, `test_board_dashboard.cjs`, `test_drive_simulation.cjs` 통과. 브라우저 렌더링으로 대기·진행·중단·완료 4가지 화면 확인.
