khw1566/ARD/results/261026_발표영상_v2_피드백반영.md

# 발표 영상 v2 — 피드백 반영

2026-10-26. 사용자가 지정한 `output/ard-cg/HANDOFF.md`를 읽고 후속 작업을 완료했다. 문서에 적힌 클라우드 수정 소스는 PC에 없었으므로 명시된 사양을 현재 코드로 재구성했다. 영상은 로컬 GPU와 FFmpeg로 출력했으며 펌웨어·앱 컴파일은 하지 않았다.

## 결과

| 파일 (`output/ard-cg/final/`) | 결과 |
|---|---|
| `ARD_FullPresentation_1080p_v2.mp4` | 전체 발표 180.000초, 5400프레임, 1080p/30fps, 161,543,997바이트 |
| `ARD_LiveDemo_Stabilized_1080p_v2.mp4` | 실물 시연 약 42.3초, 영상 1268프레임, 1080p/30fps, 95,249,248바이트 |
| `ARD_FullPresentation_1080p_v2_Korean.srt/.vtt` | 전체 외부 대사 자막 |
| `ARD_LiveDemo_1080p_v2_Korean.srt/.vtt` | 실물 외부 대사 자막 |
| `presentation_v2_quality_report.json` | 전체 디코딩·프레임·음량·원본 해시 결과 |
| `PRESENTATION_v2_CREDITS.txt` | 음원·서체 출처 |

재생 페이지는 `http://127.0.0.1:5187/review_v2.html`이다. 기존 v1, 135초 CG, 촬영본은 보존했다. 수정 전 소스는 `render_jobs/v2-source-backup-20261026-213229/`에 복사했다.

## 다섯 가지 피드백 반영

1. **이중 자막·문장 불일치:** 최종 MP4에 mov_text를 포함하지 않는다. HTML에도 자동 자막 track을 넣지 않았다. `build_captions.py`가 측정된 음성 구간과 실제 나레이션 문장으로 `narration/cg_captions.json`을 만든다. PC·DriveMCU·A/B·0·4 : 1 같은 용어는 표기형으로 통일한다. 화면과 외부 SRT가 같은 큐를 사용한다. 문장/쉼표 단위의 시간 배분은 글자 수 비율이며 단어별 강제 정렬은 아니다.
2. **모니터 노출:** 두 PC 화면에 강한 블러와 프레임별 마스크를 적용했다. 플레이트가 화면 앞을 지날 때는 흰색 전경의 연결 영역·볼록 윤곽을 추적해 기구를 가림에서 제외한다. 이메일·AI 채팅 화면은 읽을 수 없도록 처리했다. 12개 실물 시점에서 확인했으며 모든 프레임의 수동 개인정보 검수를 주장하지 않는다. 최종 두 MP4의 촬영 위치 태그도 제거했다.
3. **크레딧 중복:** 실물 구간에 음악 크레딧을 넣지 않는다. 전체 발표의 마무리에서 한 번만 표시한다. 단독 시연은 별도 크레딧 파일과 재생 페이지에서 출처를 제공한다.
4. **동작과 대사 불일치:** 115–129초 CG 장면에서 레일 이송(30mm), 플레이트 선회, 기울여 배출, 중립 자세, 레일 복귀를 순서대로 수행한다. 카메라는 고정한다. 840개 구간 표본에서 레일 변화와 플레이트 입력 변화가 겹치지 않는지 검사했다. 30mm는 설명 애니메이션의 이동량이며 실측 장치 성능이나 실제 선별 위치 보정값이 아니다.
5. **디자인:** 종이색(#efede7), 먹색 글자, 주황 강조선(#c47f2c), IBM Plex Sans KR/Mono로 정리했다. 영어 키커·페이지 카운터·진행 바·리더선·음성 대기 버튼을 제거했다. 자막은 고정된 띠에 문장 단위로 표시하며, 기어 구성·회전수·차동 수식·동작 순서는 기능을 설명하는 정보판으로 남겼다. 각도 표시는 반올림한 두 입력값에서 출력을 계산하므로 합·차 수식과 표시값이 일치한다.

## 구현과 재출력

- `cinematic.html`, `cinematic.js`, `cinematic_plan.js`, `cinematic_v2.css`: 최신 미리보기. 기존 `cinematic.css`는 이전 스타일 기록으로 보존한다.
- `editorial_overlay.js`: 미리보기/출력의 공통 캔버스 그림. 외부 폰트를 SVG foreignObject에 다시 싣지 않아도 화면과 내보내기가 일치한다.
- `fonts/`: IBM 공식 및 Google Fonts 저장소에서 내려받은 서체, OFL, URL·SHA-256 기록. 시스템 서체를 설치하지 않았다.
- `export_v2.html`, `export_video_v2.js`: 소개 390프레임+CG 3630프레임을 WebGL/WebCodecs로 직접 인코딩한다. 총 4020프레임을 약 21.86초에 출력했다. 원래 3D 기구 리그와 CAD는 유지했다.
- `render_server.py`: 127.0.0.1 전용 수신기. 이번 정상 job은 `render_jobs/20261026-213804/`다. 권한 제한 환경의 5188 시도는 브라우저에서 연결할 수 없어 정상 수신기는 5189로 실행했다.
- `make_presentation_v2.py`: 실물 전경 마스크 영상, 자막 PNG 오버레이, 마무리, 기존 오디오 믹스를 연결한다. 소개/CG 134초+실물 42.267초+마무리 3.733초다. `--prepare-only`는 오버레이/검수 이미지만 만들고 `--reuse-renders`는 같은 job의 CG와 마스크 영상이 이미 있을 때만 사용한다.
- 원래 `export_video.js`도 새 공통 캔버스 오버레이를 읽도록 맞췄다. v2 전체 발표 출력의 진입점은 `export_v2.html`이다.

재출력 순서:

```powershell
python output/ard-cg/build_captions.py
$env:ARD_RENDER_PORT='5189'
python output/ard-cg/render_server.py
# 브라우저에서 http://127.0.0.1:5189/export_v2.html 을 열어 렌더링한다.
# 다음 명령은 다른 터미널에서 렌더 완료 후 실행한다.
python output/ard-cg/make_presentation_v2.py
node output/ard-cg/verify_v2_content.cjs
python output/ard-cg/verify_presentation_v2.py
```

원래 개인 음성·오디오 믹스·가공된 STL·FFmpeg가 필요하다. `apply_v2_source.py`는 이미 적용한 일회성 마이그레이션 기록이며 다시 실행하지 않는다. 프로젝트 메모리나 사용자 전역 설정을 수정하지 않았다.

## 검수 결과와 범위

- `verify_planetary.cjs`, `verify_differential.cjs`: 기존 CAD 보존과 이상적 운동식 검사 통과.
- `verify_v2_content.cjs`: 순차 동작 840개 표본·5단계, 자막 큐 순서, 삭제한 UI 요소 확인 통과.
- `verify_presentation_v2.py`: 두 완성본 전체 디코딩, 정확한 프레임 수·해상도·30fps, 48kHz 스테레오, 자막 스트림 0, 위치 태그 없음, SRT 시간, 원본/v1 해시 일치 통과.
- 전체: -16.21 LUFS / -1.46 dBTP. 실물: -16.32 LUFS / -1.64 dBTP. 0.5초 이상 검은 화면 검출 없음.
- 전체 23개 대표 시점과 실물 12개 시점을 추출했다. 소개 이름·학교, 수식, 자막, 동작 단계, 화면 가림, 마무리 크레딧을 눈으로 확인했다. 브라우저에서 두 파일의 180초/42.3초·1080p 로딩과 자막 트랙 0개·미디어 오류 없음도 확인했다.
- 처음 maskedmerge를 사용한 실물 합성에서는 마스크의 범위 변환으로 원본 글자가 옅게 남았다. **최종본은 alphamerge+overlay로 수정**해 255를 완전 불투명 알파로 사용하며, 세 입력의 시간 기준을 1/30으로 통일했다. 마지막 수정 이후 전체 디코딩을 다시 검사했다.

전체 v2 SHA-256: `7ca263bdb13a6606388315f06b4afb3db988046adca41aa664c5421854eb04f8`.
실물 v2 SHA-256: `764cfbc13490c0a6afbf3610a18b3d67e183c7dee08aa84676f7ce5e02630c3f`.

실물 촬영본은 수동 조작 시연이다. 자동 분류 성공·치합·부하·탈조·실측 제어 성능을 검증한 것은 아니다. `_review_tmp/`는 남겨 두었으며 Git 커밋·푸시·외부 업로드는 하지 않았다.
