khw1566/ARD/results/261026_선별버튼동기화_메인탭썸네일.md

# 선별작업 버튼 동기화 + JC1060 메인탭 캡처 썸네일 (2026-10-26)

빌드·실기 검증 전 상태. 에이전트는 빌드하지 않았다.

## 1. 선별작업 시작/정지 동기화

원인: PC 백엔드는 SSE 이벤트를 `{"type": "sorting_update", "sorting": {...}}`로 보내는데
PC 화면(`main.js`)은 `data.status`를 읽었다. 그래서 PC 화면은 페이지를 열 때 한 번만 상태를 받고,
그 뒤 변화(JC1060에서 시작/정지, 선별 완료 등)를 반영하지 못했다. PC에서 시작하면 시작 버튼이
비활성으로 남고, 중단/복귀 버튼은 그 비활성 여부로 "선별 중단"인지 판단했다.

수정:
- `ARD_MAIN/frontend/static/js/main.js`: SSE에서 `data.sorting || data.status` 사용.
  SSE (재)연결 시 `/api/sorting/status`로 다시 맞춤. 중단/복귀 버튼은 서버가 마지막으로 보낸
  `is_running`을 기준으로 판단.
- `ARD_MAIN/tests/test_sorting_dashboard.cjs`: 위 계약 검사 추가 (`node tests/test_sorting_dashboard.cjs` 통과).
- `JC1060P470C/main/pc_link.cpp`: 시작/정지 요청의 응답을 받으면 1초 대기 없이 바로 `/api/hmi/updates`를 조회.
- `ui_main.cpp` 대기 문구: "여기나 PC에서 선별을 시작하세요."

## 2. 메인탭 캡처 썸네일

- 정보 패널(분류 시퀀스) 물체 이름 아래에 128x90 썸네일, 오른쪽에 재질 배지와 배출함.
- 새 다운로드 없음: Cam 탭용으로 이미 받는 640x448 프레임(`pc_image_lock`)을 최근접 축소해
  PSRAM 23 KB 버퍼에 복사. LVGL이 큰 원본을 매번 축소하지 않는다.
- 이미지가 없으면 "이미지 없음"/오류 문구. 새 프레임이 실패하면 마지막 정상 썸네일 유지.
- "PC 갱신" 시각은 패널 제목 오른쪽(시각만)으로 옮겨 한 줄을 확보했다.

## 사용자 확인 필요

- JC1060 빌드: `ARD_ESP-IDF/JC1060P470C`에서 `idf.py build` 후 플래시.
- 화면 배치(썸네일·배출함 줄바꿈·활동 문구 2줄)를 실기에서 확인.
