khw1566/ARD/results/261026_실물영상_보정_자기소개_통합.md

# 실물 시연 보정·자기소개·3분 발표 영상

2026-10-26. 사용자가 CAD 참조 폴더에 넣은 영상을 보정하고 자막과 대사를 추가했다. 이전의 직접적인 “빌드 허용할게” 승인 범위에서 로컬 TTS 합성과 FFmpeg 편집을 수행했다. 원본 CAD·펌웨어·TTS 학습 모델은 수정하지 않았다.

## 완성본

| 파일 (`output/ard-cg/final/`) | 내용 |
|---|---|
| `ARD_FullPresentation_1080p.mp4` | 180초, 1920×1080, 30fps, H.264/AAC, 5400프레임 |
| `ARD_LiveDemo_Stabilized_1080p.mp4` | 실물 시연 약 42.3초, 1080p/30fps, 1268프레임, 보정·설명 음성·상단 자막 |
| `ARD_FullPresentation_Korean.srt` / `.vtt` | 전체 대사 자막 |
| `ARD_LiveDemo_Korean.srt` / `.vtt` | 실물 시연 대사 자막 |
| `ARD_Presentation_NarrationOnly.wav` | 전체 180초 대사만, 48kHz 스테레오 |
| `presentation_plan.json` | 정확한 편집 구간과 추가 음성 기록 |
| `presentation_quality_report.json` | 전체 디코딩·프레임·음량·원본 해시 확인 |
| `PRESENTATION_CREDITS.txt` | 음악·효과음 출처와 편집 내역 |

재생 페이지: `http://127.0.0.1:5187/review_full.html`. 기존 `/review.html`과 `ARD_CG_MyVoice_1080p.mp4`(135초 CG)는 보존했다. 최종 영상·개인 음성·중간 결과는 기존 제외 경로와 새 `/output/ard-cg/live/` 제외 규칙 아래에 저장했다. Git 커밋·푸시·외부 업로드는 수행하지 않았다.

## 소개 문장과 구성

> 안녕하세요. 울산과학대학교 캡스톤디자인 NEXUS 팀장 김형우입니다. 지금부터 기계공학의 원리를 중심으로 프로젝트를 설명드리겠습니다.

학교·팀·이름을 소개 카드에 표시했다. 발음용 대본에서는 학교명과 성함의 띄어쓰기를 나눴으며, 후보 3개 중 로컬 Whisper-small 인식에서 학교명·김형우가 정확히 나온 두 번째 후보를 선택했다. 자동 인식 확인이며 사람의 청취 평가를 대신하지 않는다. 같은 myTTS의 기존 학습 체크포인트로 합성했으며 새 학습은 하지 않았다.

| 전체 시간 | 편집 |
|---|---|
| 0:00–0:13 | 인사·자기소개, CG 전체 장치와 소개 카드 |
| 0:13–2:14 | 기존 CG 원본 0:08–2:09, 시스템·감속기·차동 기구·동작 순서 설명 |
| 2:14–2:56.267 | 보정된 실물 시연 전 구간 |
| 2:56.267–3:00 | 감사 인사 화면과 음원 크레딧 |

기존 CG의 앞 8초는 소개 배경으로 사용하고 13초까지 마지막 프레임을 유지했다. 중복 도입·기존 마무리 6초를 제외하여 기계 설명을 유지하면서 전체 3분을 맞췄다.

## 원본과 보정

- 원본: `영상제작용 CAD파일/20261026_195051.mp4`, 91,288,209바이트, 42.283초, 1920×1080, 가변 프레임률, AAC 스테레오.
- 원본 SHA-256: `b880d787654870746a72fbce5154761309add23927a181bdccf6cae49238fec9`. 편집 전후 일치.
- 원본을 덮어쓰지 않고 `live/live_stabilized_clean.mp4`에 vidstab 분석/변환 2회 처리했다. 분석은 30fps, smoothing 35, gaussian, 고정 확대 약 1.8%, NVENC CQ19다.
- tripod 및 별도 배경 등록 방식도 비교했으나 추적 측정에서 더 큰 미세 흔들림이 생겨 최종 선택에서 제외했다. 선택 파일과 수치는 `live/selected_stabilized.json`에 보존했다.
- 고정 배경 LK/RANSAC 추적, 640×360 분석 해상도에서 1080p 환산: 이동 경로 고주파 RMS 1.859→0.931px(49.9% 감소). 프레임 간 이동의 고주파 RMS 0.342→0.210px(38.5% 감소).
- 회전 경로 고주파 RMS는 0.0328→0.0349도이며, 모든 종류의 흔들림이 줄어든 것은 아니다. 미세한 회전·원근 변화는 남는다. 실물 기구의 움직임은 보존하며 국부 메쉬 변형은 적용하지 않았다.

## 실물 설명과 오디오

실물 기준 0.8초부터 버튼 명령과 기울임/복귀, 13.2초부터 두 모터와 베벨 기어의 자세 전달, 28.2초부터 터치 조이스틱 조작을 설명한다. 한국어 자막은 상단에 표시해 하단의 손과 터치 화면을 가리지 않는다. 원음은 필터와 감쇄를 거쳐 작게 유지했다.

기존 Cylinder Five 음악을 180초로 교차 연결하고 발화 중 자동 감쇄했다. 장면 전환에는 Kenney 효과음을 낮게 넣었다. 효과음은 편집 표시이며 실제 장치 소리를 흉내 낸 측정 자료가 아니다. 완성본에 출처와 라이선스 크레딧을 표시하고 별도 텍스트를 저장했다.

제공 영상은 사람이 터치 화면으로 조작하는 시연이다. 자동 분류 성공, 물체 인식 정확도, 실제 엔코더 피드백, 하중·백래시·탈조 성능을 검증했다고 설명하지 않는다.

## 검수

`python output/ard-cg/verify_presentation.py`로 두 영상 전체 디코딩, ffprobe 프레임·해상도·30fps·48kHz 스테레오, 한국어 자막 트랙·시간 순서, 원본 해시를 확인했다. 검은 화면 0.5초 이상 검출 없음.

- 전체: 180.000초 / 5400프레임 / 168,258,982바이트 / -16.21 LUFS / -1.46 dBTP.
- 실물: 컨테이너 약 42.3초 / 1268프레임(영상 42.267초) / 93,387,659바이트 / -16.32 LUFS / -1.64 dBTP.
- 전체 대표 15시점 및 실물 대표 7시점 이미지 확인. 소개 카드의 학교·이름, 실물 상단 자막과 기어/터치 화면의 비중첩 확인.
- 인앱 브라우저에서 두 파일의 1920×1080 로딩, 180초/42.3초 길이, 미디어 오류 없음 확인. 전체 영상 재생 시 시간이 증가하는 것을 확인했다.

주요 스크립트: `stabilize_live.py`, `check_live_stabilization.py`, `synthesize_additions.py`, `refine_intro.py`, `select_intro.py`, `make_presentation.py`, `verify_presentation.py`. `stabilize_background.py`는 비교용이며 최종 선택이 아니다. 로컬 TTS·음원·FFmpeg 경로와 중간 파일이 필요하므로 다른 PC에서는 기록만으로 개인 음성을 복원할 수 없다.
