khw1566/ARD/results/261027_디스크_속도하향_기울기60도한계.md

작성일: 2026-10-27
작성자: Claude

# 디스크 원점 오차 대책: 속도 하향, 기울기 ±60° 안전 한계

## 요청
디스크 원점 오차(오버슛, 탈조) 대책을 세운다. 먼저 최대 속도를 낮춘다. 기울기는 ±60°를 넘지 않게 제한하고, 디스크 회전은 예외로 둔다.

## 기구학
- 모터 1스텝 = 1.8°, 4:1 감속 후 0.45°.
- 기울기 φ = (X − Y)/2 × 0.45°, 회전 ψ = (X + Y)/2 × 0.45°. PC `tilt_steps` 기준으로 전진 전도는 +X/−Y입니다.
- ±60° 한계는 |X − Y| ≤ 266스텝(59.85°)입니다. 시퀀스의 45° 전도(X − Y = 200)는 한계 안입니다.

## DriveMCU 변경 (`ARD_ESP-IDF/DriveMCU/main`)
| 항목 | 내용 |
|---|---|
| 속도 | X/Y 기본 500 → 300 steps/s, 가속 500 → 300 steps/s². `mxs`/`mys` 상한 300. Z는 그대로 |
| 이동 검사 | `b`·`df`/`db`/`dr`/`dl`·`mxr`·`myr`의 끝 기울기를 계산합니다(실행 중인 이동과 큐 포함). 한계 밖이면 `ERR:REJECTED`. 큐에서 꺼낼 때 다시 검사하고, 거부되면 큐를 비웁니다 |
| 조그 | 한계 2스텝 안쪽 소프트 월. 상대 축의 정지 위치 기준으로 제한. 스틱 반전 시 제한된 정지점으로 먼저 감속 |
| 백스톱 | 한계를 넘어 더 벌어지면 X/Y 즉시 정지, 프로그램 삭제 |
| 상태 | `tilt_deg`, `tilt_limit_deg`, `tilt_limit_count`, `tilt_limit` |
| 설정 | menuconfig `ARD_DISK_MAX_SPEED`(300), `ARD_DISK_ACCEL`(300), `ARD_DISK_TILT_LIMIT_DEG`(60), `ARD_DISK_GEAR_RATIO`(4) |

파일: `motion.cpp`, `motion.h`, `board.h`, `Kconfig.projbuild`, `command_servers.cpp`, `commands.cpp`(도움말), `README.md`.
다른 스레드에서 진행 중인 Z 70~120 mm 한계, 조그, 시퀀스 변경은 그대로 두고 그 위에 덧붙였습니다.

## PC 변경 (`ARD_MAIN`)
- `core/rail_control.py`: `TILT_LIMIT_DEG = 60`. 시퀀스 전도 각도 설정 범위를 5~90°에서 5~60°로 바꿨습니다. `tilt_steps`는 60°를 넘으면 예외를 냅니다. `disc_tilt_error()`를 추가했습니다(펌웨어와 같은 규칙).
- `app.py` `/api/drivemcu/command`: 수동 디스크 명령을 보내기 전에 검사합니다. 한계를 넘으면 409와 사유를 돌려줍니다.
- `core/sorting_pipeline.py`: 이동 중 `tilt_limit_count`가 늘면 시퀀스를 오류로 멈춥니다.
- HMI와 JC1060은 PC를 거쳐 DriveMCU로 명령을 보냅니다. 따라서 펌웨어 한계가 그대로 적용됩니다. JC1060 조그(`j`)는 소프트 월에서 멈춥니다.

## 검증 (빌드 없음)
- PC 테스트: `test_disc_tilt_limit.py`(신규 4개), `test_rail_control` 39개, `test_sorting_pipeline` 19개, `test_drive_command_route` 10개, `test_jc1060_drive` 58개 모두 통과했습니다.
  `test_sorting_integration.py`의 1건은 `core` 모듈 import 경로 문제로 실패하는데, 이번 변경과는 관계없습니다.
- Python 2축 모델(ISR, 플래너, 조그 클램프, 백스톱)로 확인했습니다.
  - 순수 기울기, 단축, 기울인 뒤 회전: 최대 264스텝(59.4°).
  - 무작위 스틱 30회 × 20초: 최대 266스텝(59.85°), 백스톱 발동 0회.
- **펌웨어는 빌드하지 않았습니다**(AGENTS.md 규칙). 실기 확인도 하지 않았습니다.

## 사용자 실행
```
cd C:\Users\work\Desktop\ARD_v1\ARD_ESP-IDF\DriveMCU
.\build.ps1 build
.\build.ps1 flash -Port COMx
```
- 새 Kconfig 항목은 빌드할 때 기본값으로 `sdkconfig`에 추가됩니다.
- 실기에서는 `df134`가 거부되는지(60.3°), `df133`은 통과하는지, `dr2000`(회전)은 제한 없이 움직이는지 확인해 주세요. 조그로 기울였을 때 약 59°에서 멈추는지도 봐 주세요.

## 남은 한계
- 원점 오차 자체는 개루프 스텝 수로만 추적합니다. 탈조가 나면 펌웨어의 위치와 실제 위치가 달라지고, 그만큼 ±60° 한계도 실제 각도와 어긋납니다. 근본 대책은 리밋 스위치나 엔코더로 원점을 다시 잡는 것입니다.
