khw1566/ARD/results/261024_병합_및_저장소정리.md

# 원격 병합 및 저장소 정리

작성일: 2026-10-24 (KST)

## 원격 변경 반영

- 저장소: `https://github.com/khw1566/ARD`
- 대상 브랜치: `ard-v1`
- 로컬 시작점 `871f776`에서 원격 `fad1566`까지 3개 커밋을 fast-forward로 반영했다.
- 원격의 공통 Wi-Fi 성공 기록 16개, 웹 검색, Setup QR, PC 대시보드 개선을 유지했다.
- 로컬의 JC1060 V2 패널 초기화, 전체 화면 동기 갱신, 밝기 저장, Display/Network 설정 탭, `esp_mm` 의존성 보완과 문제 분석 보고서를 통합했다.

## 충돌 해결

`ard_network.c`, `ard_network_http.c`, `ui.cpp`의 겹친 내용을 해결했다.

- Setup QR는 System 탭에 유지하고, 밝기는 Settings → Display로 통합했다.
- 웹 설정의 검색·기록 기능과 터치 설정의 실시간 연결 기능을 모두 유지했다.
- 공통 코드와 터치 UI가 서로 다른 `ard_wifi_ap_t` 구조를 정의하던 충돌을 제거했다. 터치 전용 구조는 `ard_network_ap_t`다.
- JC1060의 자동 연결·웹 검색·터치 검색/연결을 같은 작업 게이트로 직렬화했다.
- 터치 연결 전에 공통 작업 코드의 활성 프로필을 갱신하여, 새 연결 성공을 이전 SSID의 성공으로 잘못 기록하지 않도록 했다.
- 수동 연결 실패 시 실제로 활성화됐던 이전 프로필로 복구를 시도한다. 자동 기록 선택은 기존처럼 검색에 보이는 SSID만 사용하고, 터치의 직접 입력은 숨김 SSID도 시도할 수 있다.
- 새 체크아웃에서도 정상 동작 설정을 재현하도록 V2 + 전체 화면 동기 갱신을 기본 설정에 반영했다. 기존 `sdkconfig`의 명시적 선택은 변경하지 않았다.

## OldVersions 정리

- 정리 범위는 `C:/Users/work/Desktop/ARD_v1` 내부다. 외부 폴더로 연결되는 링크는 따라가지 않았다.
- 37개 폴더, 239개 파일을 삭제했다. 파일 논리 크기 합계는 136,271,192 bytes(약 130 MiB)다.
- 작업 전부터 `OldVersions`는 Git 추적 파일이 0개였고, 원격 `ard-v1`에도 없었다. 따라서 이번에는 로컬 백업을 제거하고 Git 제외 상태를 유지했다.
- CAD 원본 조립품·부품 파일은 정리 대상에 넣지 않았다.
- 폴더별 개수와 크기는 `261024_저장소정리_목록.json`에 기록했다.

## 구형 펌웨어 분리

- 원래 위치: `C:/Users/work/Desktop/ARD_v1/ARD_software`
- 이동 위치: `C:/Users/work/Desktop/ETC/ARD_software`
- 8,323개 파일, 3,597,308,922 bytes(약 3.35 GiB)를 이동했다.
- 폴더의 `.git`, 빌드 결과, 기존 미커밋 PC 소스를 포함해 보존했다.
- 숨김 폴더 이동 오류로 일부만 옮겨진 단계가 있어, Robocopy로 이동을 이어 마친 뒤 전체 파일 수·크기를 대조했다. Git HEAD/index 및 미커밋 소스 두 파일의 SHA-256도 이동 전과 일치했다.
- 원래 위치에 `ARD_software`가 남지 않은 것을 확인했다.
- 기존 `run_pc.bat - 바로 가기.lnk`의 실행 경로와 작업 폴더도 새 위치로 수정했다. 바로가기는 Git 제외 파일이다.
- `ARD_software`는 기존부터 `ard-v1`에서 추적하지 않았고, 제외 규칙을 유지했다.
- 사용자가 선택한 대로 GitHub `main` 브랜치는 보존한다. 기존 브랜치와 과거 Git 이력을 삭제하거나 재작성하지 않았다.

같은 C: 드라이브 내 이동이므로 구형 펌웨어 이동 자체로 디스크 여유가 늘지는 않는다. 프로젝트 폴더에서 분리한 것이며, 삭제한 OldVersions와는 구분한다.

## 검증

| 검사 | 결과 |
|---|---|
| 공통 Wi-Fi 실제 C 코드의 호스트 단위 시험 | 11개 통과: 기존 8개 및 수동 연결 성공·복구·빈 설정 복귀 3개 |
| PC Python 회귀 검사 | 29개 통과 |
| 웹 Wi-Fi 설정 JavaScript | 통과 |
| Drive 시뮬레이션 JavaScript | 통과 |
| Sorting 대시보드 JavaScript | 통과 |
| JC1060 소스 등록·SDK 메타데이터 | 확인, 타깃 컴파일은 미실행 |
| 정리 후 OldVersions 및 ARD_software Git 추적 | 0개 |

Wi-Fi 호스트 시험은 설치된 Clang 16과 Windows CRT, 저장소의 가짜 SDK를 사용해 `shared/ard_wifi.c`와 테스트 C 소스를 직접 컴파일·실행했다. ESP32 펌웨어나 QEMU 화면을 실행한 결과는 아니다. 임시 호스트 실행 파일과 빌드 도구용 파일은 `tmp/github-merge-20261024/host-wifi-tests`에 두고 Git에서 제외했다.

PC 테스트의 localhost UDP 왕복은 기본 샌드박스에서 시간 초과가 있었고, 로컬 소켓 접근을 허용한 환경에서 전체 29개가 통과했다. 테스트를 수정해 실패를 숨기지는 않았다.

병합 후 타깃 펌웨어 재빌드·업로드·실물 재시험은 별도다. 병합 전 JC1060 정상 동작 확인과 이번 호스트 검증을 구분한다.

## 보존 및 커밋 범위

- JC1060 및 공통 Wi-Fi 통합, 해당 회귀 시험, 기본 설정, Git 제외 규칙 설명, 분석·정리 보고서만 커밋한다.
- 기존 PC 백엔드 로컬 사본 2개와 별도 작업 중인 ImageSender 소스 3개는 이번 커밋에서 제외한다.
- 병합 전 소스 ZIP·패치·해시 목록과 정리 전 인벤토리는 `tmp/github-merge-20261024`에 보관한다. 이 백업과 빌드 산출물은 푸시하지 않는다.
