khw1566/ARD/results/261022_GitHub_누락점검.md

# GitHub 저장소 누락 점검

점검일: 2026-10-22 (KST)

- 원격 저장소: https://github.com/khw1566/ARD
- GitHub `ard-v1`: `871f7765c52c63030560217e86b444dc1999c6f0`
- GitHub `main`: `11c41835179a4d8c7c3db6e131866e593a78d55f`
- 바깥 작업 폴더의 HEAD는 원격 ard-v1과 같음.
- 내부 `ARD` 저장소의 HEAD는 원격 main과 같고, 추적 파일 변경 및 미추적 파일이 없음.
- 원격 커밋은 git ls-remote로 실시간 확인. 추적 파일 비교 기준은 해당 커밋의 로컬 Git 객체.
- 파일 복원, 병합, 커밋, 업로드는 하지 않음.

## 결과

- 바깥 ard-v1 추적 파일 중 경로에서 사라진 파일: 40개.
- 그중 내부 ARD 최신 main에 내용이 같은 추적 사본이 있는 파일: 26개.
- 내부 ARD에서 동일 내용의 추적 사본을 찾지 못한 파일: 14개.
- main의 pc_center를 ARD_MAIN 경로에 대응시켜 비교: 누락 36개, 내용 차이 4개, 동일 14개. 서버 잠금 파일 2개는 이 대응 비교에서 제외.
- `ARD_MAIN/backend/app.py`는 GitHub main에 있으나, 바깥 ard-v1 커밋 자체에 없고 현재 파일도 없음.
- `ARD_MAIN/run_pc.bat`는 backend/requirements.txt와 backend/app.py를 사용하므로 현재 폴더 구성으로는 정상 실행 불가. 내부 ARD/pc_center에는 두 파일이 있음.
- ESP-IDF와 main의 Arduino/PlatformIO 프로젝트는 구조와 구현이 다르므로 파일 이름 차이만으로 기능 누락을 단정하지 않음. 빌드 및 기능 테스트는 이번 파일 점검 범위에 포함하지 않음.

## ard-v1에서 사라진 파일과 main 내 동일 내용 사본

| 누락 경로 | 동일 내용 사본 |
|---|---|
| `ARD_MAIN/backend/ai/llm_manager.py` | `ARD/pc_center/backend/ai/llm_manager.py` |
| `ARD_MAIN/backend/ai_persona.txt` | ARD/main 추적 파일에서 찾지 못함 |
| `ARD_MAIN/backend/api/audio_routes.py` | `ARD/pc_center/backend/api/audio_routes.py` |
| `ARD_MAIN/backend/api/system_routes.py` | `ARD/pc_center/backend/api/system_routes.py` |
| `ARD_MAIN/backend/audio/music_player.py` | `ARD/pc_center/backend/audio/music_player.py` |
| `ARD_MAIN/backend/audio/stt_engine.py` | `ARD/pc_center/backend/audio/stt_engine.py` |
| `ARD_MAIN/backend/audio/voice_queue.py` | `ARD/pc_center/backend/audio/voice_queue.py` |
| `ARD_MAIN/backend/core/hardware_monitor.py` | `ARD/pc_center/backend/core/hardware_monitor.py` |
| `ARD_MAIN/backend/core/state_manager.py` | `ARD/pc_center/backend/core/state_manager.py` |
| `ARD_MAIN/backend/core/stats_manager.py` | `ARD/pc_center/backend/core/stats_manager.py` |
| `ARD_MAIN/backend/core/terminal_manager.py` | `ARD/pc_center/backend/core/terminal_manager.py` |
| `ARD_MAIN/backend/network/tcp_client.py` | `ARD/pc_center/backend/network/tcp_client.py` |
| `ARD_MAIN/backend/requirements.txt` | `ARD/pc_center/backend/requirements.txt` |
| `ARD_MAIN/frontend/static/app_icon.ico` | `ARD/pc_center/app_icon.ico`<br>`ARD/pc_center/frontend/static/app_icon.ico` |
| `ARD_MAIN/frontend/static/audio/yt_download.webm` | `ARD/pc_center/frontend/static/audio/yt_download.webm` |
| `ARD_MAIN/frontend/static/audio/yt_download_1779153039.webm` | `ARD/pc_center/frontend/static/audio/yt_download_1779153039.webm` |
| `ARD_MAIN/frontend/static/css/style.css` | ARD/main 추적 파일에서 찾지 못함 |
| `ARD_MAIN/frontend/static/js/audio-voice-controller.js` | ARD/main 추적 파일에서 찾지 못함 |
| `ARD_MAIN/frontend/static/js/main.js` | ARD/main 추적 파일에서 찾지 못함 |
| `ARD_MAIN/frontend/static/js/simulation-drive.js` | `ARD/pc_center/frontend/static/js/simulation-drive.js` |
| `ARD_MAIN/frontend/static/js/stats-monitor.js` | `ARD/pc_center/frontend/static/js/stats-monitor.js` |
| `ARD_MAIN/frontend/static/js/terminal-controller.js` | `ARD/pc_center/frontend/static/js/terminal-controller.js` |
| `ARD_MAIN/frontend/static/js/theme-manager.js` | `ARD/pc_center/frontend/static/js/theme-manager.js` |
| `ARD_MAIN/frontend/static/js/translations.js` | `ARD/pc_center/frontend/static/js/translations.js` |
| `ARD_MAIN/frontend/templates/components/header.html` | ARD/main 추적 파일에서 찾지 못함 |
| `ARD_MAIN/frontend/templates/components/voice_media.html` | `ARD/pc_center/frontend/templates/components/voice_media.html` |
| `ARD_MAIN/frontend/templates/index.html` | ARD/main 추적 파일에서 찾지 못함 |
| `ARD_MAIN/frontend/templates/terminal.html` | ARD/main 추적 파일에서 찾지 못함 |
| `ARD_MAIN/frontend/templates/test_bench.html` | ARD/main 추적 파일에서 찾지 못함 |
| `ARD_MAIN/setup_firewall.ps1` | `ARD/pc_center/setup_firewall.ps1` |
| `ARD_MAIN/status.md` | `ARD/pc_center/status.md` |
| `ARD_MAIN/tests/test_drive_simulation.cjs` | `ARD/pc_center/tests/test_drive_simulation.cjs` |
| `ARD_MAIN/tests/test_drive_state.py` | `ARD/pc_center/tests/test_drive_state.py` |
| `ARD_MAIN/tests/test_image_protocol.py` | ARD/main 추적 파일에서 찾지 못함 |
| `ARD_MAIN/tests/test_sorting_integration.py` | ARD/main 추적 파일에서 찾지 못함 |
| `ARD_MAIN/tests/test_sorting_pipeline.py` | `ARD/pc_center/tests/test_sorting_pipeline.py` |
| `ARD_hardware/ARD_Model_v1/1/a/설계 1/설계 1.cfdes` | ARD/main 추적 파일에서 찾지 못함 |
| `ARD_hardware/ARD_Model_v1/1/a/설계 1/설계 1.tsl` | ARD/main 추적 파일에서 찾지 못함 |
| `ARD_hardware/TRCR_Project/TRCRv1/disk_v4/dick2_v3.stl` | ARD/main 추적 파일에서 찾지 못함 |
| `results/261016_이미지전송손실분석.md` | ARD/main 추적 파일에서 찾지 못함 |

## main pc_center 대비 ARD_MAIN 누락 파일

- `ARD_MAIN/backend/ai/llm_manager.py`
- `ARD_MAIN/backend/ai_persona.txt`
- `ARD_MAIN/backend/api/audio_routes.py`
- `ARD_MAIN/backend/api/system_routes.py`
- `ARD_MAIN/backend/app.py`
- `ARD_MAIN/backend/audio/music_player.py`
- `ARD_MAIN/backend/audio/stt_engine.py`
- `ARD_MAIN/backend/audio/voice_queue.py`
- `ARD_MAIN/backend/core/hardware_monitor.py`
- `ARD_MAIN/backend/core/state_manager.py`
- `ARD_MAIN/backend/core/stats_manager.py`
- `ARD_MAIN/backend/core/terminal_manager.py`
- `ARD_MAIN/backend/network/tcp_client.py`
- `ARD_MAIN/backend/requirements.txt`
- `ARD_MAIN/frontend/static/app_icon.ico`
- `ARD_MAIN/frontend/static/audio/yt_download.webm`
- `ARD_MAIN/frontend/static/audio/yt_download_1779153039.webm`
- `ARD_MAIN/frontend/static/css/style.css`
- `ARD_MAIN/frontend/static/js/audio-voice-controller.js`
- `ARD_MAIN/frontend/static/js/main.js`
- `ARD_MAIN/frontend/static/js/simulation-drive.js`
- `ARD_MAIN/frontend/static/js/stats-monitor.js`
- `ARD_MAIN/frontend/static/js/terminal-controller.js`
- `ARD_MAIN/frontend/static/js/theme-manager.js`
- `ARD_MAIN/frontend/static/js/translations.js`
- `ARD_MAIN/frontend/templates/components/header.html`
- `ARD_MAIN/frontend/templates/components/voice_media.html`
- `ARD_MAIN/frontend/templates/index.html`
- `ARD_MAIN/frontend/templates/terminal.html`
- `ARD_MAIN/frontend/templates/test_bench.html`
- `ARD_MAIN/setup_firewall.ps1`
- `ARD_MAIN/status.md`
- `ARD_MAIN/tests/test_drive_simulation.cjs`
- `ARD_MAIN/tests/test_drive_state.py`
- `ARD_MAIN/tests/test_sorting_integration.py`
- `ARD_MAIN/tests/test_sorting_pipeline.py`

## main pc_center 대비 ARD_MAIN 내용 차이

- `ARD_MAIN/backend/config/config_manager.py`
- `ARD_MAIN/frontend/static/js/media-controller.js`
- `ARD_MAIN/frontend/templates/components/sidebar.html`
- `ARD_MAIN/frontend/templates/settings.html`

## 바깥 저장소의 수정 파일 (미커밋)

- `ARD_ESP-IDF/ControlMCU/components/ard_net/CMakeLists.txt`
- `ARD_ESP-IDF/ControlMCU/components/ard_net/ard_network.c`
- `ARD_ESP-IDF/ControlMCU/components/ard_net/ard_network_http.c`
- `ARD_ESP-IDF/ControlMCU/components/ard_net/include/portal_page.h`
- `ARD_ESP-IDF/DriveMCU/main/CMakeLists.txt`
- `ARD_ESP-IDF/DriveMCU/main/net/ard_network.cpp`
- `ARD_ESP-IDF/DriveMCU/main/net/ard_network_http.cpp`
- `ARD_ESP-IDF/DriveMCU/main/net/portal_page.h`
- `ARD_ESP-IDF/HMI_MCU/.gitignore`
- `ARD_ESP-IDF/HMI_MCU/README.md`
- `ARD_ESP-IDF/HMI_MCU/build.ps1`
- `ARD_ESP-IDF/HMI_MCU/components/ard_net/CMakeLists.txt`
- `ARD_ESP-IDF/HMI_MCU/components/ard_net/ard_network.c`
- `ARD_ESP-IDF/HMI_MCU/components/ard_net/ard_network_http.c`
- `ARD_ESP-IDF/HMI_MCU/components/ard_net/include/portal_page.h`
- `ARD_ESP-IDF/HMI_MCU/main/CMakeLists.txt`
- `ARD_ESP-IDF/HMI_MCU/main/main.c`
- `ARD_ESP-IDF/ImageSenderMCU/components/ard_net/CMakeLists.txt`
- `ARD_ESP-IDF/ImageSenderMCU/components/ard_net/ard_network.c`
- `ARD_ESP-IDF/ImageSenderMCU/components/ard_net/ard_network_http.c`
- `ARD_ESP-IDF/ImageSenderMCU/components/ard_net/include/portal_page.h`
- `ARD_ESP-IDF/JC1060P470C/components/ard_net/CMakeLists.txt`
- `ARD_ESP-IDF/JC1060P470C/components/ard_net/ard_network.c`
- `ARD_ESP-IDF/JC1060P470C/components/ard_net/ard_network_http.c`
- `ARD_ESP-IDF/JC1060P470C/components/ard_net/include/portal_page.h`
- `ARD_ESP-IDF/JC1060P470C/main/ui.cpp`

## 바깥 저장소의 미추적 항목 (보고서 생성 전)

- `ARD/`
- `ARD_ESP-IDF/HMI_MCU/main/hmi_setup.c`
- `ARD_ESP-IDF/HMI_MCU/main/hmi_setup.h`
- `ARD_ESP-IDF/HMI_MCU/test/sim/CMakeLists.txt`
- `ARD_ESP-IDF/HMI_MCU/test/sim/components/wifi_worker/CMakeLists.txt`
- `ARD_ESP-IDF/HMI_MCU/test/sim/components/wifi_worker/fake_sdk/esp_err.h`
- `ARD_ESP-IDF/HMI_MCU/test/sim/components/wifi_worker/fake_sdk/esp_event.h`
- `ARD_ESP-IDF/HMI_MCU/test/sim/components/wifi_worker/fake_sdk/esp_log.h`
- `ARD_ESP-IDF/HMI_MCU/test/sim/components/wifi_worker/fake_sdk/esp_timer.h`
- `ARD_ESP-IDF/HMI_MCU/test/sim/components/wifi_worker/fake_sdk/esp_wifi.h`
- `ARD_ESP-IDF/HMI_MCU/test/sim/components/wifi_worker/fake_sdk/freertos/FreeRTOS.h`
- `ARD_ESP-IDF/HMI_MCU/test/sim/components/wifi_worker/fake_sdk/freertos/task.h`
- `ARD_ESP-IDF/HMI_MCU/test/sim/components/wifi_worker/fake_sdk/nvs.h`
- `ARD_ESP-IDF/HMI_MCU/test/sim/components/wifi_worker/worker_tests.c`
- `ARD_ESP-IDF/HMI_MCU/test/sim/main/CMakeLists.txt`
- `ARD_ESP-IDF/HMI_MCU/test/sim/main/sim_main.c`
- `ARD_ESP-IDF/HMI_MCU/test/sim/run_sim.py`
- `ARD_ESP-IDF/HMI_MCU/test/sim/sdkconfig.defaults`
- `ARD_ESP-IDF/JC1060P470C/components/ard_net/include/ard_network(1).h`
- `ARD_ESP-IDF/shared/README.md`
- `ARD_ESP-IDF/shared/ard_setup_qr.c`
- `ARD_ESP-IDF/shared/ard_setup_qr.h`
- `ARD_ESP-IDF/shared/ard_wifi.c`
- `ARD_ESP-IDF/shared/ard_wifi.h`
- `ARD_ESP-IDF/shared/ard_wifi_http.h`
- `ARD_ESP-IDF/shared/portal_page.h`
- `ARD_ESP-IDF/shared/test/run_tests.py`
- `ARD_ESP-IDF/shared/test/test_portal.js`
- `ARD_ESP-IDF/shared/test/test_wifi.c`
- `ARD_ESP-IDF/shared/test/wifi_test_sdk.h`
- `ARD_ESP-IDF/shared/third_party/qrcodegen.c`
- `ARD_ESP-IDF/shared/third_party/qrcodegen.h`
- `ARD_ESP-IDF/shared/wifi_profiles.h`
- `ARD_MAIN/backend/config/config_manager.py`
- `results/261022_HMI_sim/drive.png`
- `results/261022_HMI_sim/network.png`
- `results/261022_HMI_sim/preview.png`
- `results/261022_HMI_sim/returned.png`
- `results/261022_HMI_sim/web-qr.png`
- `results/261022_HMI_sim/wifi-qr.png`
- `results/261022_HMI빌드_시뮬레이션.md`
- `results/261022_SoftAP편의성개선.md`
- `대한기계학술회 보고서/AGENTS.md`
- `대한기계학술회 보고서/보완할점 리스크.MD`

## 해석

- 내부 ARD는 최신 main의 파일을 보유하지만, 바깥 ARD_MAIN과 자동으로 연결되지 않음.
- 바깥 ESP-IDF 작업의 수정 파일과 미추적 파일은 현재 원격 ard-v1에 반영되지 않은 로컬 작업임.
- 사본을 찾지 못한 파일은 원격 ard-v1 커밋에 존재하므로 그 커밋에서 복구할 수 있음. 의도적인 삭제인지 별도 확인이 필요함.
