khw1566/ARD/results/261022_HMI빌드_시뮬레이션.md

작성일: 2026-10-22
작성자: Codex

# 결과

- 대상: `ARD_ESP-IDF/HMI_MCU`, ESP32-2432S028, ILI9341 240×320.
- SDK: ESP-IDF 5.5.5. 컴파일러: Xtensa GCC 14.2.0, `esp-14.2.0_20260121`.
- 실제 HMI 펌웨어 컴파일·링크·파티션 크기 검사 통과.
- 앱 크기: 1,182,800 bytes (`0x120c50`). 앱 파티션: 1,536,000 bytes (`0x177000`). 여유: 353,200 bytes, 23%.
- 산출물: `ARD_ESP-IDF/HMI_MCU/build-codex-check/ard_hmi_mcu.bin`, `ard_hmi_mcu.elf`, 부트로더 및 파티션 테이블.

# 환경 복구 및 변경

- 이전 PC 경로가 고정된 `build.ps1`을 수정했습니다. SDK의 도구 버전을 읽고 설치된 Python·컴파일러·CMake·Ninja 경로를 사용합니다.
- 기본 SDK 활성화 스크립트에서 발생한 도구 탐지 실패를 피하도록 필요한 환경을 직접 구성합니다. SDK·컴파일러 버전은 변경하지 않았습니다.
- 필수 파일이 누락된 mDNS 디렉터리는 `tmp/hmi-mdns-incomplete-20261022`에 보관하고 의존성 관리자에서 기존 잠금 버전 1.14.0을 다시 받았습니다.
- 기존 `build` 폴더를 지우지 않고 `build-codex-check`에서 검증했습니다.
- 누락된 루트 `.gitignore`를 원격 커밋과 같은 내용으로 복원했습니다. HMI의 별도 빌드 폴더도 Git 제외 항목에 추가했습니다.

# 시뮬레이션

Espressif QEMU 9.2.2 (`esp_develop_9.2.2_20260417`)에서 ESP32 검증용 펌웨어를 실행했습니다.
화면을 다시 그린 JavaScript 모형이 아니라 실제 펌웨어의 `gfx.c`, `hmi_ui.c`, `hmi_setup.c`, QR 생성 코드를 컴파일해서 실행했습니다.
장치 통신에는 고정된 시험 데이터를 공급하며, 연결 관리 코드는 가짜 Wi-Fi/NVS 이벤트로 구동합니다.

연결 관리 테스트 7개가 모두 통과했습니다.

- 성공 기록 16개 제한 및 가장 오래된 성공 항목 교체, 같은 SSID 비밀번호 갱신.
- 검색에 나타난 저장 SSID만 연결, 중복 SSID 제거, 성공 후 기록 갱신 및 재연결 전 새 검색.
- 실패한 새 자격 증명을 성공 기록에 저장하지 않음.
- 같은 SSID의 새 비밀번호 실패 시 이전 성공 비밀번호 재시도.
- 연결 시간 초과 후 다른 검색된 후보로 진행.
- 스캔 실패 시 연결·저장하지 않음.
- NVS 저장 실패 시 연결을 유지하며 저장 재시도.

화면 검증도 통과했습니다.

- 네트워크 화면에서 다음 페이지 입력으로 화면이 바뀜.
- Wi-Fi QR과 웹 QR을 실제 화면 버퍼에서 캡처.
- 캡처한 QR 두 개를 jsQR 1.4.0으로 판독하고 기대 내용과 완전히 일치함을 확인.
- Wi-Fi QR: `WIFI:T:WPA;S:ard-hmi-123456;P:ARD-123456!;;`.
- 웹 QR: `http://192.168.4.1/network`.
- QR 화면을 닫고 원래 페이지를 다시 그린 결과가 기존 페이지 버퍼와 완전히 일치함.

시뮬레이터의 전체 화면 캡처 버퍼는 ESP32의 정적 메모리 한도와 여러 힙 영역을 고려해 작은 밴드로 나눠 할당했습니다. 실제 HMI 펌웨어의 메모리 배치는 변경하지 않았습니다.

# 재현 명령 및 증거

HMI 프로젝트 폴더에서 실행합니다.

```powershell
.\build.ps1 -BuildDir build-codex-check
.\build.ps1 -ProjectDir .\test\sim -BuildDir build
```

두 빌드 모두 종료 코드 0입니다. 저장소 루트에서 실행합니다.

```powershell
python -u ARD_ESP-IDF/HMI_MCU/test/sim/run_sim.py
```

시뮬레이션·화면 판독 스크립트 종료 코드 0입니다. QEMU는 시험 완료 마커를 출력한 뒤 스크립트에서 종료합니다.

- 실제 빌드 로그: `261022_HMI_build.log`.
- 시뮬레이터 빌드 로그: `261022_HMI_sim_build.log`.
- 시뮬레이터 출력: `261022_HMI_sim/qemu.log`.
- 화면: `261022_HMI_sim/preview.png`, `network.png`, `drive.png`, `wifi-qr.png`, `web-qr.png`, `returned.png`.

# 남은 실물 확인

보드에 업로드하지 않았습니다. 실제 무선 검색·공유기 인증·NVS 플래시 쓰기, LCD SPI 출력, 터치 컨트롤러와 길게 누르기 동작은 실물에서 확인해야 합니다. QEMU의 연결 테스트는 상태 처리와 저장 정책을 검증하며 RF 동작을 대체하지 않습니다.
