khw1566/ARD/results/261016_이미지전송손실분석.md

- 작성일: 2026-10-16
- 작성자: Claude
- 대상: ImageSenderMCU (ESP32-S3) UDP 이미지 전송, PC 수신부 (pc_center/backend/app.py)
- 상태: 원인 분석, 프로토콜 재설계, ESP-IDF 펌웨어와 PC 수신부 작성, 손실 시뮬레이션 테스트와 펌웨어 빌드 통과. 실기기 검증 전.

# 이미지 전송 데이터 손실 원인 분석 및 프로토콜 v2
## 1. 결론
데이터 손실의 주원인은 커스텀 패킷 프로토콜이 맞다. 기존 형식은 패킷 앞에 0/1/2(시작/중간/끝) 1바이트만 붙였기 때문에 PC가 청크 누락·중복·순서 뒤바뀜을 알 수 없었고, 손실이 생기면 그대로 이어 붙인 깨진 JPEG를 정상 프레임으로 분석에 넘겼다. 송신 측에는 실패한 청크를 건너뛰고 계속 보내는 버그도 있었다.

## 2. 확인한 원인 (코드 근거)
| # | 위치 | 문제 | 결과 |
|---|---|---|---|
| 1 | ImageSenderMCU/src/main.cpp 441-470 | `endPacket()` 5회 실패 시 `break`가 재전송 루프만 빠져나오고 `offset += toSend`로 다음 청크를 계속 보냄. 마지막 로그는 `offset >= size`라서 "Success" 출력 | Wi-Fi TX 큐가 차는 순간(Error 12) 청크가 조용히 사라지고 성공으로 기록 |
| 2 | main.cpp 433-437, app.py udp_receive_thread | 시퀀스 번호·전체 길이·CRC 없음 | 공중에서 잃은 중간 청크를 PC가 감지 불가, 깨진 JPEG 전달 |
| 3 | 동일 | ACK·재전송 없음, `endPacket()` 성공은 lwIP 큐 진입일 뿐 | 실제 손실 시 복구 수단 없음 |
| 4 | 동일 | 시작 패킷 손실 시 프레임 전체 폐기, 끝 패킷 손실 시 다음 시작 패킷까지 대기 후 폐기 | 프레임 단위 누락 |
| 5 | main.cpp 433-437 | 이미지가 1436바이트 이하이면 시작 패킷만 보내고 끝 패킷이 없음 | PC가 영원히 완료하지 못함 (P4 펌웨어는 보완, S3는 미보완) |
| 6 | app.py process_udp_frame | `Image.open()`은 헤더만 읽으므로 잘린 JPEG도 통과 | 손상 이미지가 Gemini 분석과 선별 동작으로 이어짐 |
| 7 | app.py udp_receive_thread | Windows에서 `SO_REUSEADDR`는 다른 프로세스가 같은 UDP 포트를 중복 바인드하게 허용 | 이전 실행 인스턴스가 남아 있으면 패킷이 나뉘어 들어갈 수 있음 |
| 8 | main.cpp 160-165 | `CAMERA_GRAB_LATEST` + 버퍼 2개에서 첫 `fb_get`이 명령 이전 프레임일 수 있음 | 선별용 사진이 촬영 명령 직전 장면 (손실은 아니나 정확도 문제) |
| 9 | app.py 촬영 명령 | TCP 5003 직접 명령이 `CONFIG["imagesendermcu"]["ip"]`를 쓰는데 이 값은 어디서도 저장되지 않음 (IP는 `imagesendermcu_ip`에 저장). 펌웨어의 5003 서버도 비활성 | 촬영이 항상 3초 폴링에 의존 |

## 3. 프로토콜 v2 설계
- 헤더(20바이트, 리틀엔디언): magic `AI`, 버전 2, 타입(DATA/POLL/STATUS), frame_id, chunk_idx, chunk_count, payload_len, total_len, 프레임 CRC32
- 청크 1400바이트 고정. 헤더 포함 UDP 1420바이트, IP 포함 1448바이트로 MTU 1500 이내. 최대 2048청크(약 2.8MB)
- 무결성: UDP 체크섬이 패킷 단위를, 프레임 CRC32(zlib 호환)가 재조립 결과 전체를 검증
- 신뢰성: ESP32가 32청크를 보낸 뒤 POLL, PC가 수신 비트맵을 담은 STATUS로 응답, ESP32는 빠진 청크만 재전송(선택적 재전송). 완성 후 CRC가 맞으면 PC가 COMPLETE를 먼저 보냄
- 흐름제어: 응답 없이 보낼 수 있는 양을 32청크(약 45KB)로 제한. ESP32 TX 큐가 가득 차면(ENOMEM) 같은 청크를 대기 후 다시 보내며 절대 건너뛰지 않음
- 중복·지연 패킷: PC는 최근 완료 프레임 16개를 (frame_id, 크기, CRC)로 기억해 늦게 온 중복을 무시하고 POLL에는 COMPLETE를 다시 답함
- 실패 처리: STATUS가 8번 연속 오지 않거나 시간 제한(3초 + 100KB당 1초)을 넘으면 실패로 기록하고 PC 로그에 이유를 남김
- 하위 호환: 첫 2바이트가 `AI`가 아니면 구형 형식으로 처리. 단 JPEG 시작·끝 마커가 없는 프레임은 폐기

## 4. 구현 위치
- 펌웨어: `ARD_ESP-IDF/ImageSenderMCU` (ESP-IDF 5.5.5, 모듈 인덱스는 README.md)
- PC: `ARD_MAIN` (pc_center 복사본, build·dist·MusicData 제외)
- `ARD_MAIN/backend/network/image_protocol.py`: 소켓과 분리된 수신 상태 머신
- `ARD_MAIN/backend/app.py`: `udp_receive_thread`를 새 수신기로 교체, `SO_REUSEADDR` 제거, 수신 버퍼 4MB, `trigger_image_capture()` 추가(TCP 5003 우선, 실패 시 폴링)
- `ARD_MAIN/tests/test_image_protocol.py`: 펌웨어 송신 알고리즘을 그대로 옮긴 시뮬레이터로 수신기 검증

## 5. 함께 개선한 점
- 촬영 즉시성: TCP 5003 명령 서버 복구, PC는 한 요청당 한 경로만 사용해 중복 촬영 방지
- 새 프레임 보장: 촬영 전 오래된 버퍼 1장 폐기
- 무선 절전 끔(`WIFI_PS_NONE`), Wi-Fi TX 버퍼 16개에서 32개로 늘려 32청크 창과 맞춤, PSRAM에 Wi-Fi 버퍼 할당 허용
- 카메라 소유를 촬영 작업 하나로 통일. 설정 변경은 촬영 작업이 적용하므로 HTTP 처리 중 카메라 재초기화 충돌이 없음
- 하트비트 30초에서 10초로 단축 (PC 오프라인 판정 30초보다 짧게)
- 브라운아웃 보호는 SDK 기본값 유지, CPU 160MHz 유지 (261003 보고서 결과 반영)

## 6. 검증 결과
- 손실 시뮬레이션 8개 테스트 통과: 손실 없음, 경계 크기(1, 1400, 1401바이트 등), 15% 손실+5% 중복+10% 순서 뒤바뀜에서 250KB 프레임 20회, CRC 오류 후 전체 재전송, 연속 10프레임, 잘못된 헤더 거부, 실제 UDP 소켓 왕복
- 같은 조건에서 구형 형식은 중간 청크가 빠져도 프레임을 정상으로 넘김을 테스트로 재현
- 기존 선별 파이프라인 테스트 12개 통과
- `idf.py build` 성공 (ESP-IDF v5.5.5, esp32s3). 앱 크기 0x112520바이트, 앱 파티션 여유 27%. 경고 0건

## 7. 남은 확인 사항
- 실기기에서 SVGA·UXGA 프레임의 전송 시간과 재전송 비율 측정
- PC 방화벽에서 UDP 5001 수신 허용 확인 (ESP32는 STATUS를 받지 못하면 실패로 기록)
- 이 PC 프로그램(ARD_MAIN)과 구형 펌웨어는 함께 동작하지만, 구형 펌웨어의 손실 문제 자체는 남음
