khw1566/ARD/results/261022_HMI_sim/drive.png

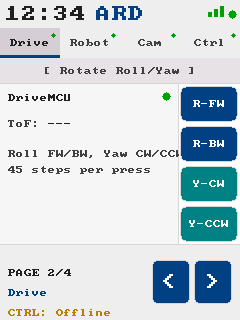
results/261022_HMI_sim/drive.png
