khw1566/ARD/results/261022_HMI_sim/network.png

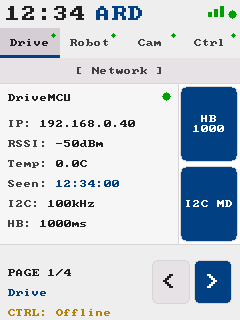
results/261022_HMI_sim/network.png
