khw1566/ARD/results/261022_HMI_sim/preview.png

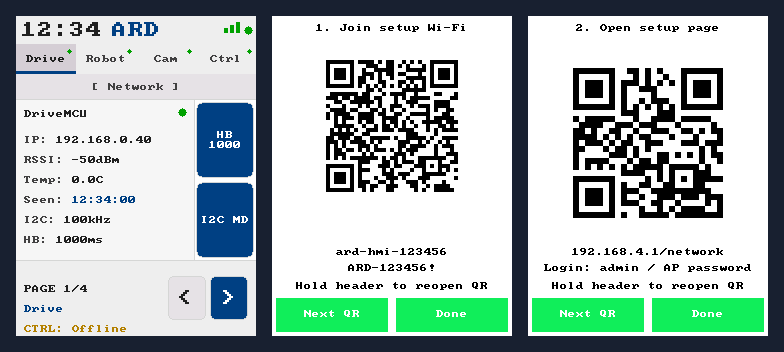
results/261022_HMI_sim/preview.png
