khw1566/ARD/results/261022_HMI_sim/web-qr.png

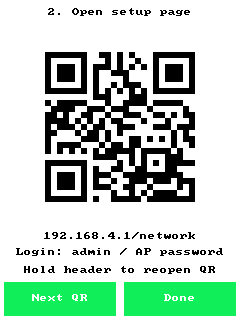
results/261022_HMI_sim/web-qr.png
