khw1566/ARD/results/261022_HMI_sim/wifi-qr.png

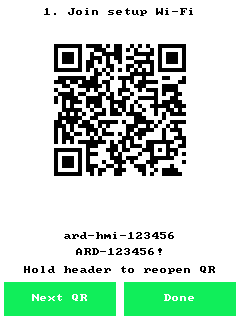
results/261022_HMI_sim/wifi-qr.png
