khw1566/ARD/results/261022_외부접속_로그인.png

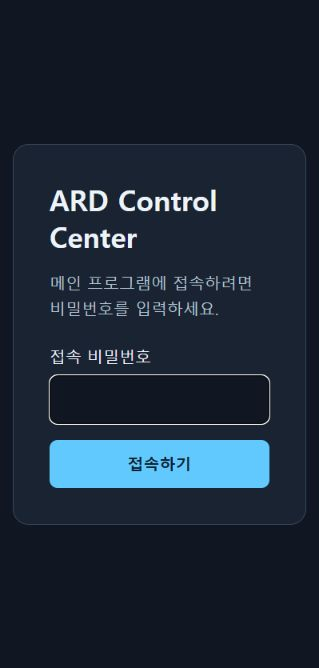
results/261022_외부접속_로그인.png
