khw1566/ARD/results/261025_Drive_3D_model/backward.png

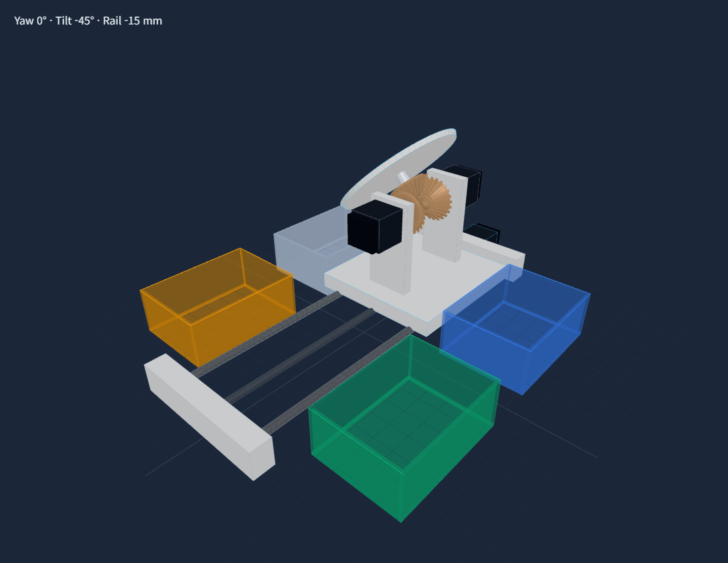
results/261025_Drive_3D_model/backward.png
