khw1566/ARD/results/261025_Drive_3D_model/forward.png

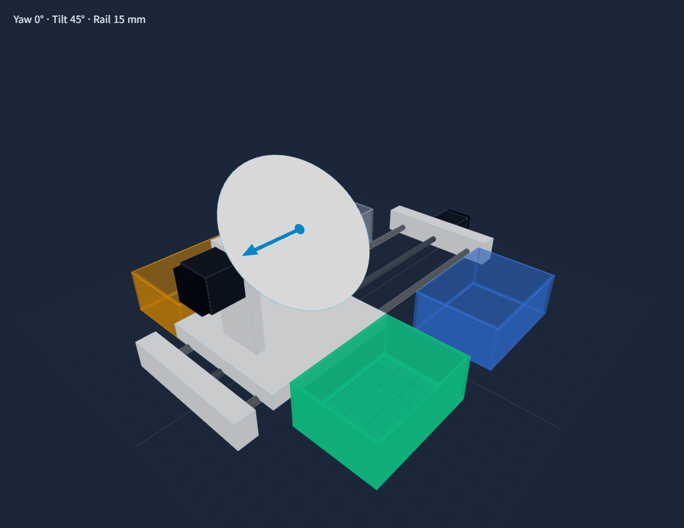
results/261025_Drive_3D_model/forward.png
