khw1566/ARD/results/261025_Drive_3D_model/gears.png

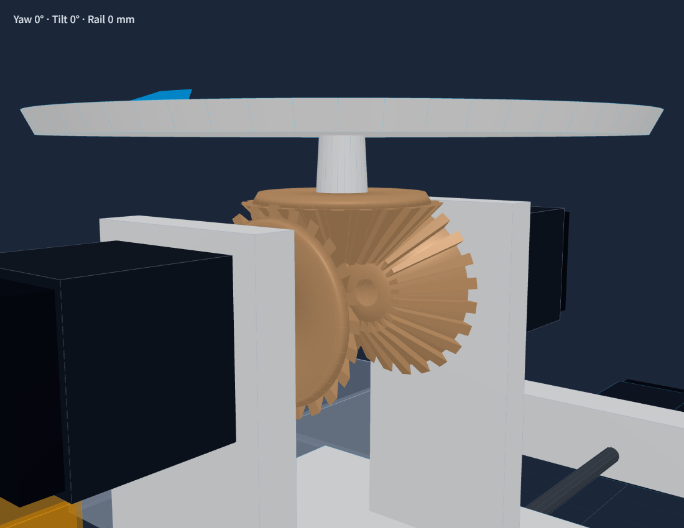
results/261025_Drive_3D_model/gears.png
