khw1566/ARD/ARD_hardware/PneumaticGripper_v2/PneumaticGripper_v1.pdf

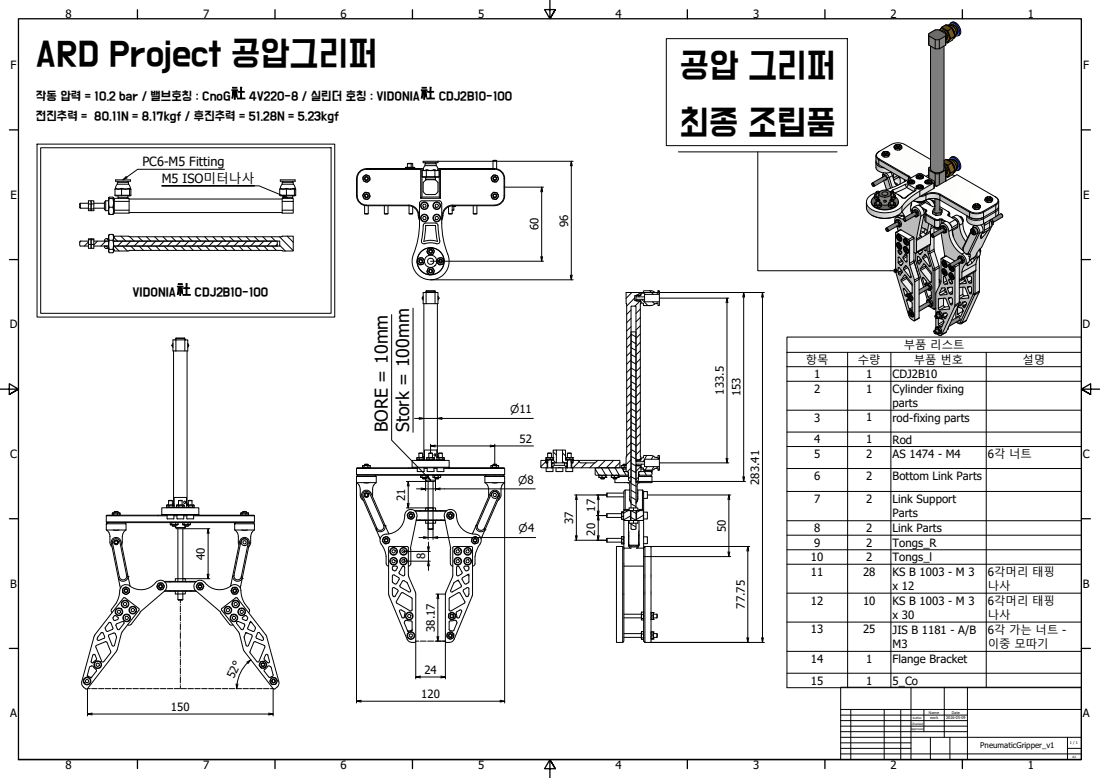
[picture p178: page 1]
부품 리스트; 전진추력 = 80.11N = 8.17kgf / 후진추력 = 51.28N = 5.23kgf; 공압 그리퍼; 최종 조립품; VIDONIA社 CDJ2B10-100; PC6-M5 Fitting M5 ISO미터나사

ARD Project 공압그리퍼

작동 압력 = 10.2 bar / 밸브호칭 : CnoG社 4V220-8 / 실린더 호칭 : VIDONIA社 CDJ2B10-100

항목 | 수량 | 부품 번호 | 설명
1 | 1 | CDJ2B10
2 | 1 | Cylinder fixing parts

3 | 1 | rod-fixing parts

4 | 1 | Rod
5 | 2 | AS 1474 - M4 | 6각 너트

6 | 2 | Bottom Link Parts

7 | 2 | Link Support Parts

8 | 2 | Link Parts
9 | 2 | Tongs_R
10 | 2 | Tongs_l
11 | 28 | KS B 1003 - M 3 x 12 | 6각머리 태핑 나사

12 | 10 | KS B 1003 - M 3 x 30 | 6각머리 태핑 나사

13 | 25 | JIS B 1181 - A/B M3 | 6각 가는 너트 -이중 모따기

14 | 1 | Flange Bracket

Name | Date

Author | work | 2026-05-09

Checked
Approved
