khw1566/ARD/output/kicad/ARD_2Sheet/ARD_2Sheet.pdf

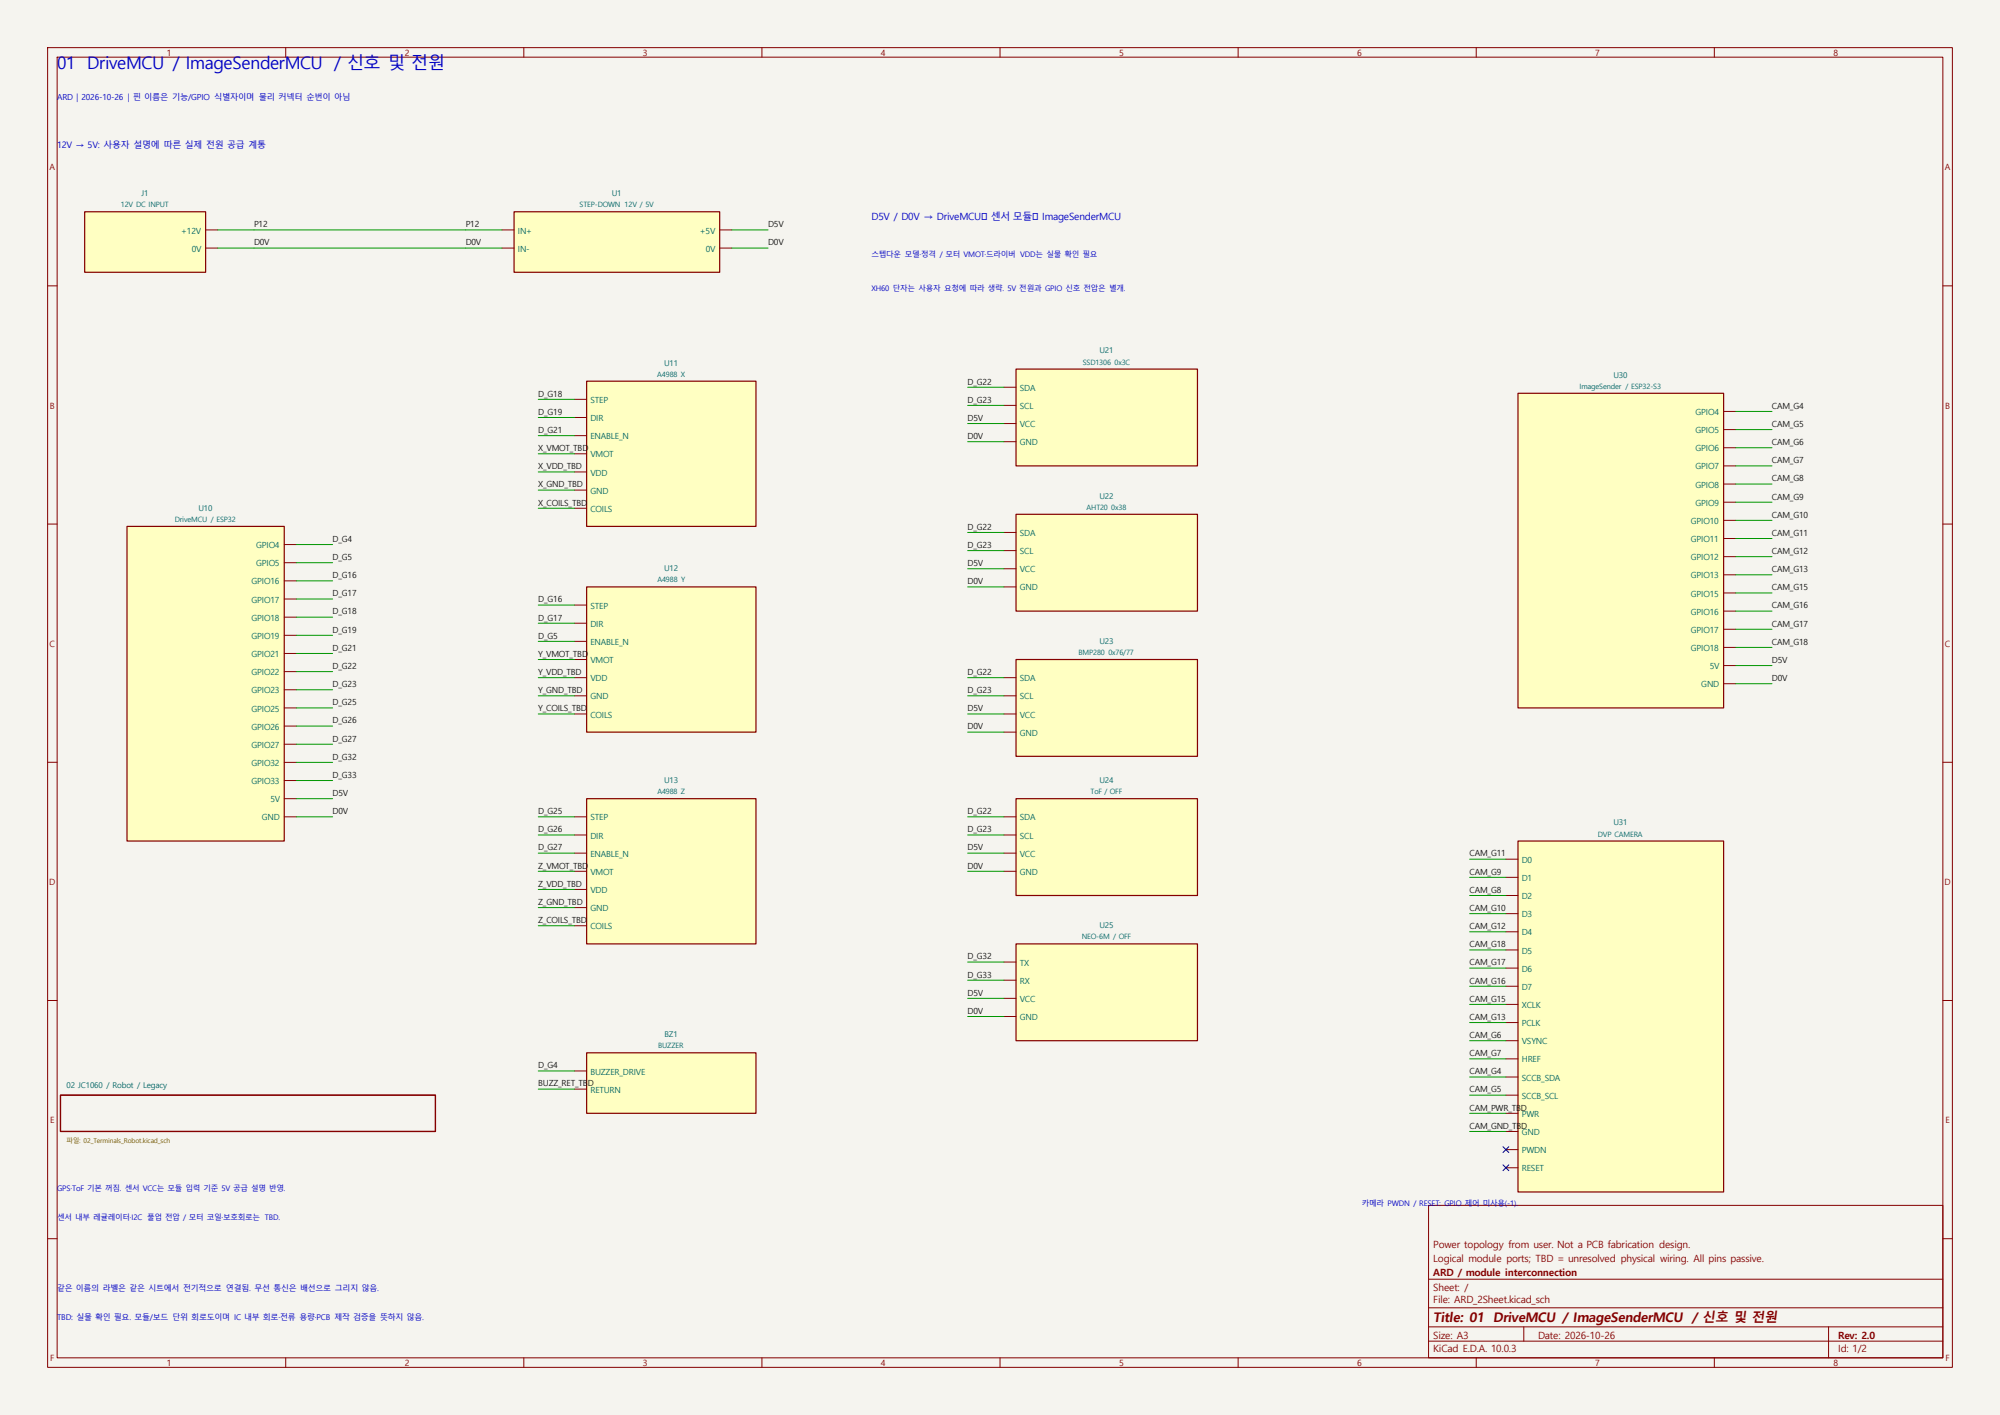
[picture p179: page 1]

XH60 단자는 사용자 요청에 따라 생략. 5V 전원과 GPIO 신호 전압은 별개. 01 DriveMCU / ImageSenderMCU / 신호 및 전원

ARD | 2026-10-26 | 핀 이름은 기능/GPIO 식별자이며 물리 커넥터 순번이 아님

12V → 5V: 사용자 설명에 따른 실제 전원 공급 계통

D5V / D0V → DriveMCU센서 모듈ImageSenderMCU

같은 이름의 라벨은 같은 시트에서 전기적으로 연결됨. 무선 통신은 배선으로 그리지 않음. 센서 내부 레귤레이터·I2C 풀업 전압 / 모터 코일·보호회로는 TBD. GPS·ToF 기본 꺼짐. 센서 VCC는 모듈 입력 기준 5V 공급 설명 반영. TBD: 실물 확인 필요. 모듈/보드 단위 회로도이며 IC 내부 회로·전류 용량·PCB 제작 검증을 뜻하지 않음.

카메라 PWDN / RESET: GPIO 제어 미사용(-1).

Sheet: / ARD / module interconnection

File: ARD_2Sheet.kicad_sch
Title: 01 DriveMCU / ImageSenderMCU / 신호 및 전원

Size: A3 | Rev: 2.0

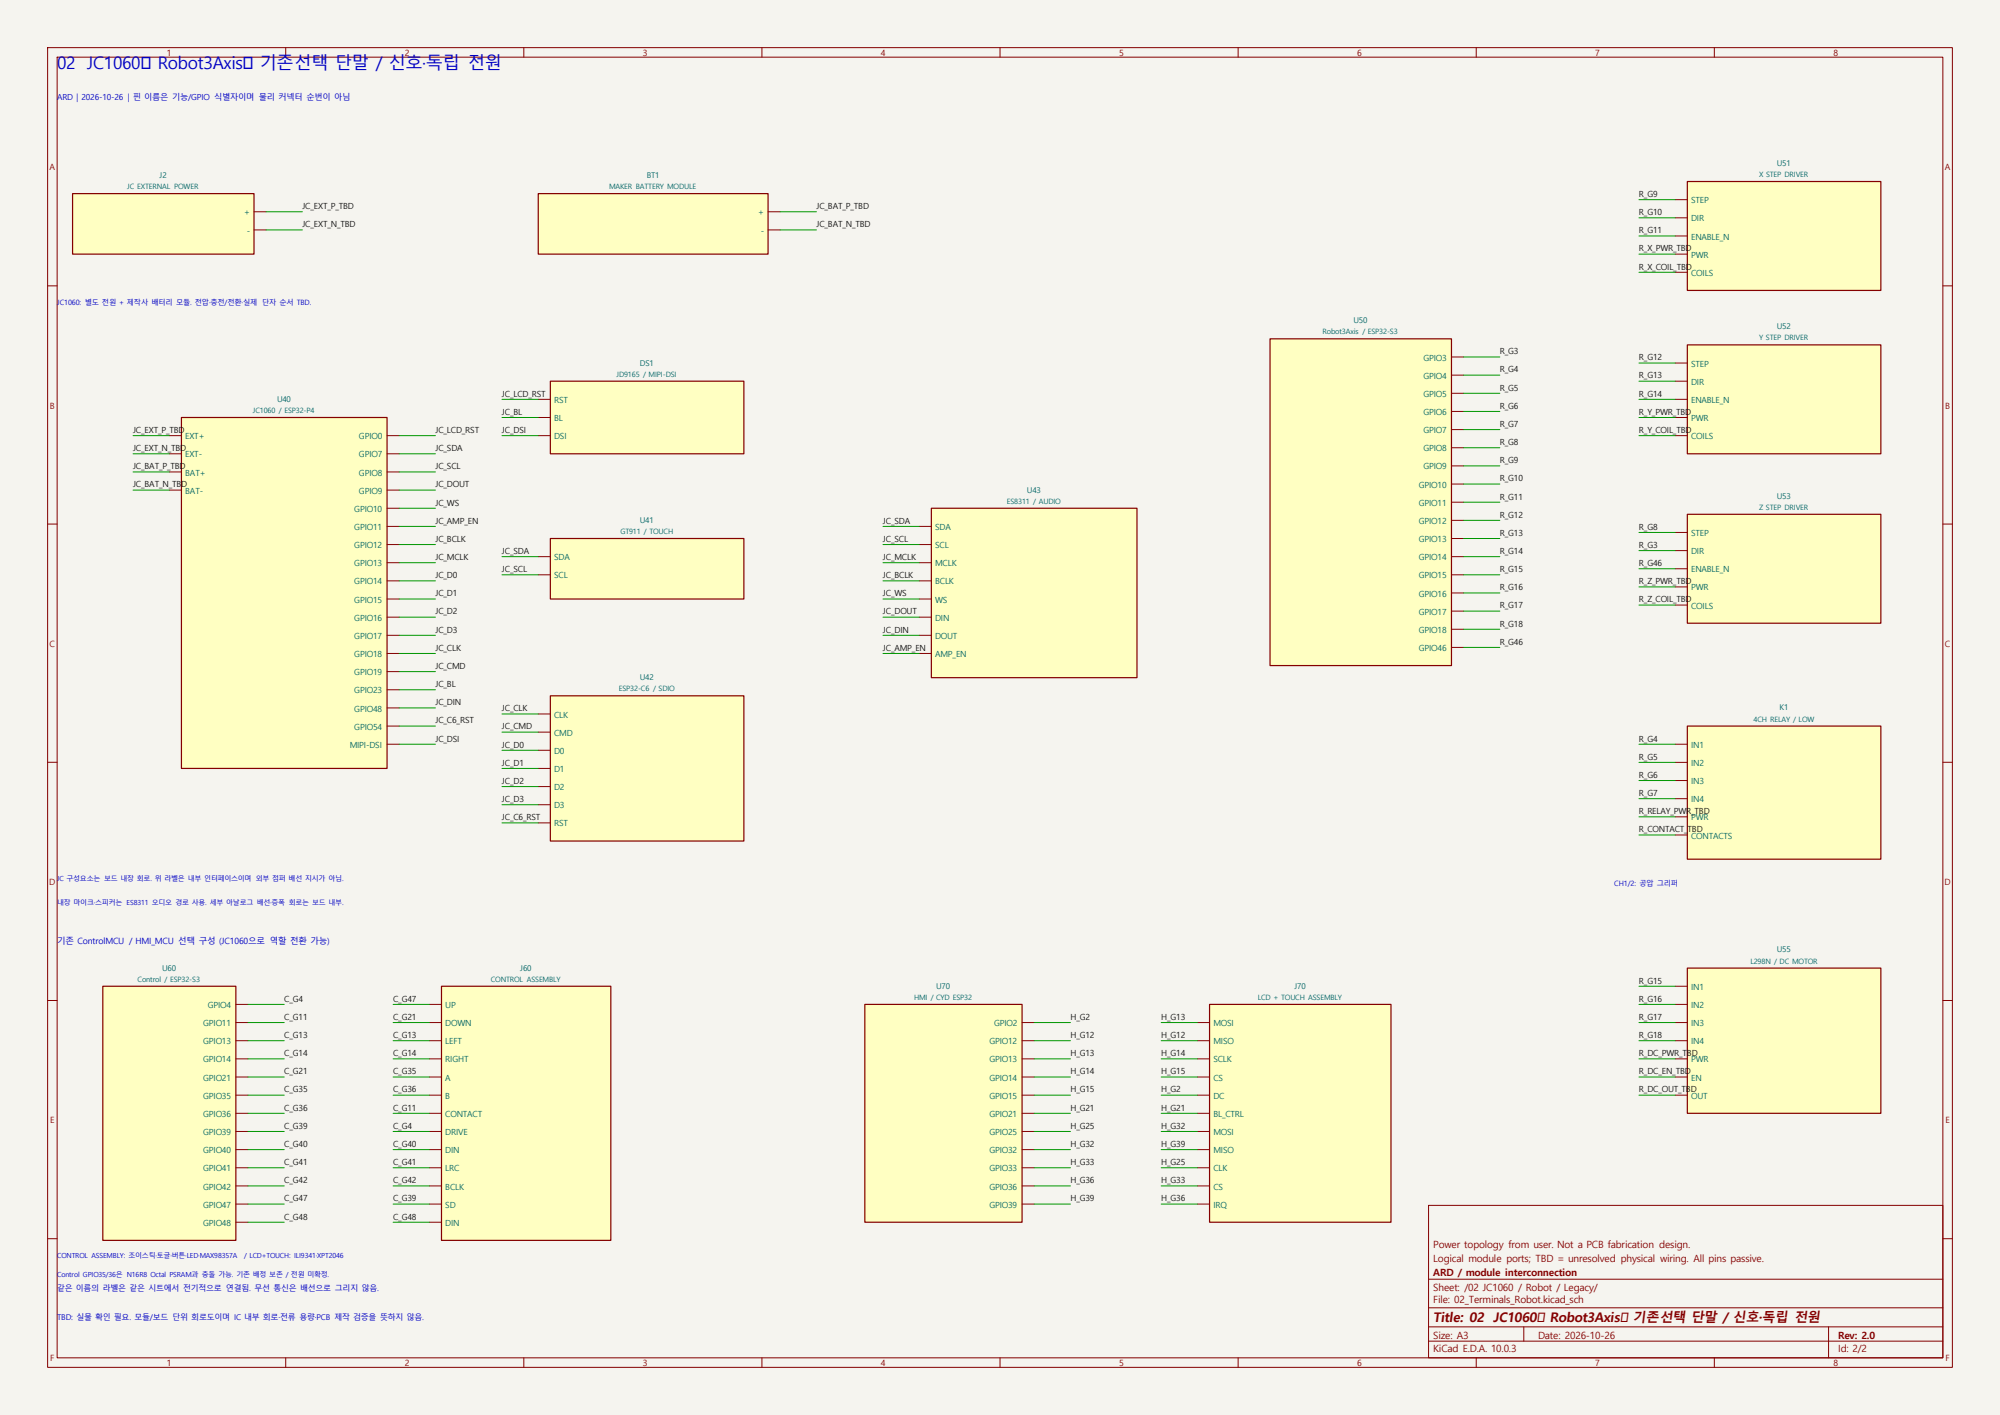
[picture p180: page 2]

02 JC1060Robot3Axis기존 선택 단말 / 신호·독립 전원

JC1060: 별도 전원 + 제작사 배터리 모듈. 전압·충전/전환·실제 단자 순서 TBD. 기존 ControlMCU / HMI_MCU 선택 구성 (JC1060으로 역할 전환 가능)

ARD | 2026-10-26 | 핀 이름은 기능/GPIO 식별자이며 물리 커넥터 순번이 아님

- BT1 MAKER BATTERY MODULE GPIO0 GPIO7 GPIO8 GPIO9 GPIO10 GPIO11 GPIO12 GPIO13 GPIO14 GPIO15 GPIO16 GPIO17 GPIO18 GPIO19 GPIO23 GPIO48 GPIO54 BAT+

BL_CTRL CSDCMISO MOSI SCLK CLK CS

TBD: 실물 확인 필요. 모듈/보드 단위 회로도이며 IC 내부 회로·전류 용량·PCB 제작 검증을 뜻하지 않음. 내장 마이크·스피커는 ES8311 오디오 경로 사용. 세부 아날로그 배선·증폭 회로는 보드 내부. 같은 이름의 라벨은 같은 시트에서 전기적으로 연결됨. 무선 통신은 배선으로 그리지 않음.

Logical module ports; TBD = unresolved physical wiring. All pins passive. Power topology from user. Not a PCB fabrication design.

CONTROL ASSEMBLY: 조이스틱·토글·버튼·LED·MAX98357A / LCD+TOUCH: ILI9341·XPT2046

Control GPIO35/36은 N16R8 Octal PSRAM과 충돌 가능. 기존 배정 보존 / 전원 미확정.

Sheet: /02 JC1060 / Robot / Legacy/ ARD / module interconnection

File: 02_Terminals_Robot.kicad_sch
Title: 02 JC1060Robot3Axis기존 선택 단말 / 신호·독립 전원

Size: A3 | Rev: 2.0 | F Date: 2026-10-26 KiCad E.D.A. 10.0.3
