khw1566/ARD/output/kicad/ARD_2Sheet/ARD_2Sheet_회로도.pdf

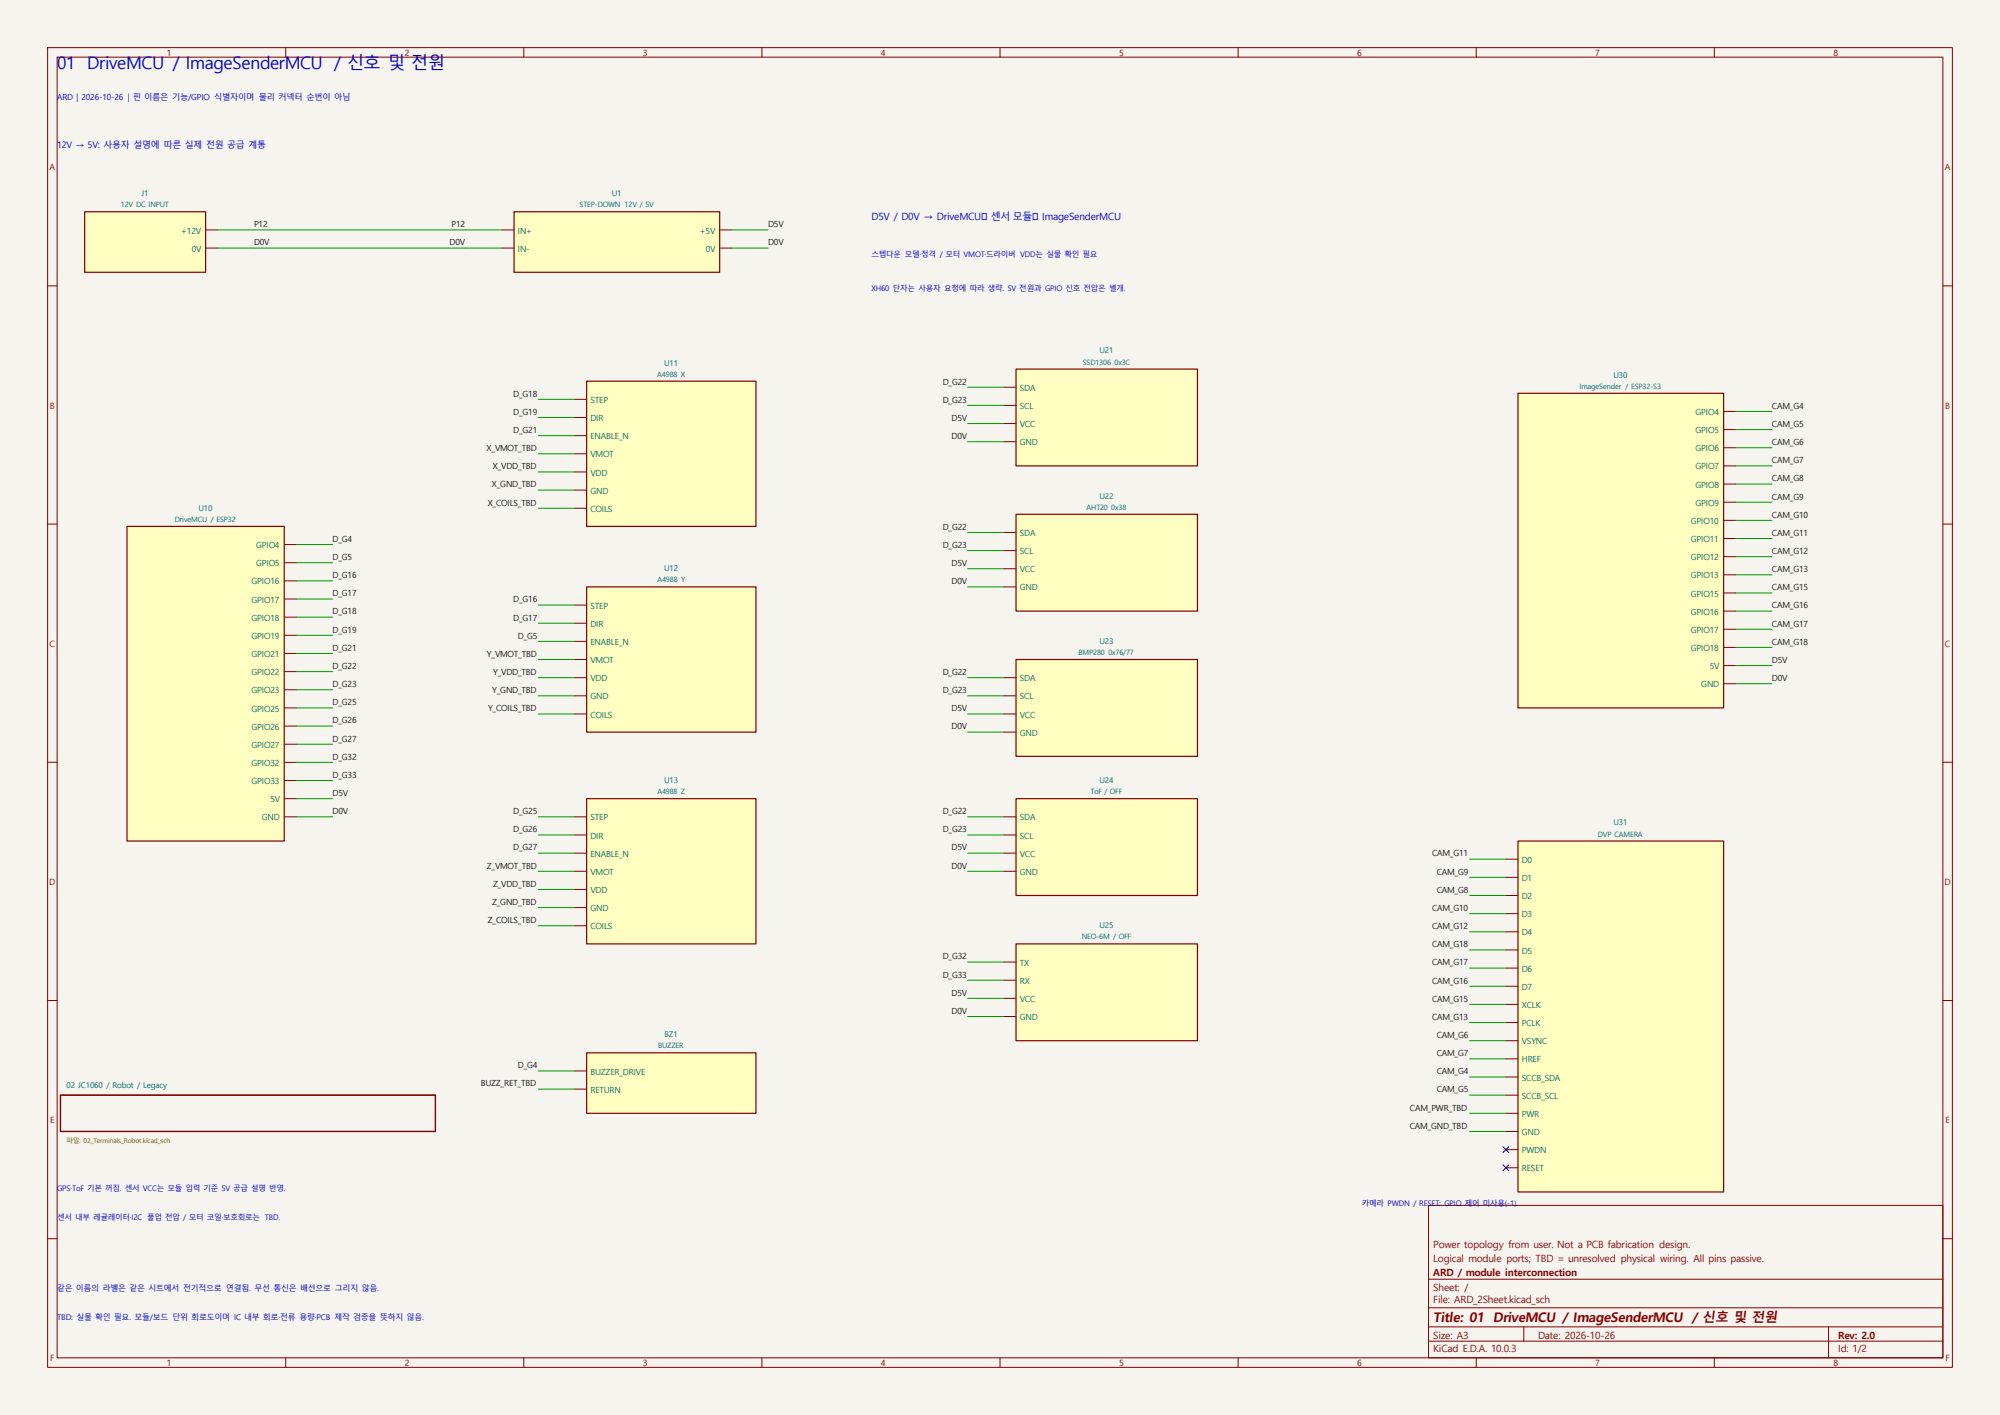
[picture p181: page 1]

01 DriveMCU / ImageSenderMCU / 신호 및 전원

ARD | 2026-10-26 | 핀 이름은 기능/GPIO 식별자이며 물리 커넥터 순번이 아님

12V → 5V: 사용자 설명에 따른 실제 전원 공급 계통

D5V / D0V → DriveMCU센서 모듈ImageSenderMCU

스텝다운 모델·정격 / 모터 VMOT·드라이버 VDD는 실물 확인 필요

XH60 단자는 사용자 요청에 따라 생략. 5V 전원과 GPIO 신호 전압은 별개.

Logical module ports; TBD = unresolved physical wiring. All pins passive. Power topology from user. Not a PCB fabrication design. 02 JC1060 / Robot / Legacy 파일: 02_Terminals_Robot.kicad_sch

같은 이름의 라벨은 같은 시트에서 전기적으로 연결됨. 무선 통신은 배선으로 그리지 않음. GPS·ToF 기본 꺼짐. 센서 VCC는 모듈 입력 기준 5V 공급 설명 반영.

Sheet: / ARD / module interconnection

File: ARD_2Sheet.kicad_sch
Title: 01 DriveMCU / ImageSenderMCU / 신호 및 전원

Size: A3 | Rev: 2.0

1 | 2 | 3 | 4 | 5 | 6 | 7 | 8
1 | 2 | 3 | 4 | 5 | 6 | 7 | 8

A

BCD

E

F

A

BCD

E

Size: A3 | Rev: 2.0 | F Date: 2026-10-26 KiCad E.D.A. 10.0.3
| Id: 2/2

## Title: 02 JC1060Robot3Axis기존 선택 단말 / 신호·독립 전원

File: 02_Terminals_Robot.kicad_sch

Sheet: /02 JC1060 / Robot / Legacy/ ARD / module interconnection

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

# COILS DIR

ENABLE_N

PWR

STEP | U51 X STEP DRIVER GPIO3 GPIO4 GPIO5 GPIO6 GPIO7 GPIO8 GPIO9 GPIO10 GPIO11 GPIO12 GPIO13 GPIO14 GPIO15 GPIO16 GPIO17 GPIO18 GPIO46 U50 Robot3Axis / ESP32-S3 SCL SDA | U41 GT911 / TOUCH DRIVE DIN

DOWN

# LEFT RIGHT UPA

# BCONTACT BCLK DIN

LRC

SD

J60 CONTROL ASSEMBLY | AMP_EN

# BCLK DIN

# DOUT MCLK

SCL SDA WS | U43 ES8311 + AMP / AUDIO

CLK CMD

D0D1D2D3 RST | U42 ESP32-C6 / SDIO

EN

IN1

IN2

IN3

IN4 OUT PWR | U55
L298N / DC MOTOR BL_CTRL CSDCMISO MOSI SCLK CLK CS
IRQMISO MOSI | J70
LCD + TOUCH ASSEMBLY GPIO2 GPIO12 GPIO13 GPIO14 GPIO15 GPIO21 GPIO25 GPIO32 GPIO33 GPIO36 GPIO39 U70 HMI / CYD ESP32 | CONTACTS

IN1

IN2

IN3

IN4 PWR

K1
4CH RELAY / LOW

# COILS DIR

ENABLE_N

PWR

STEP | U53

Z STEP DRIVER +

- BT1 MAKER BATTERY MODULE BLDSI RST | DS1

JD9165 / MIPI-DSI +

J2
JC EXTERNAL POWER | COILS DIR

ENABLE_N

PWR

STEP | U52 Y STEP DRIVER

GPIO4 GPIO11 GPIO13 GPIO14 GPIO21 GPIO35 GPIO36 GPIO39 GPIO40 GPIO41 GPIO42 GPIO47 GPIO48 U60 Control / ESP32-S3

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

BAT- | MIPI-DSI

EXT+

EXT- | U40 JC1060 / ESP32-P4

JC_AMP_EN

# R_G18 R_G46 R_G3 R_G4

# C_G14 C_G21 C_G35 C_G36 C_G39

# R_G5 R_G6 R_G7 R_G8 R_G9

# C_G40 C_G41 C_G42 C_G47 C_G48

# R_G10 R_G11 R_G12 R_G14 R_G15 R_G16 R_G17

JC_EXT_P_TBD

JC_EXT_N_TBD

R_G9 R_G10 R_G11 R_X_PWR_TBD

JC_EXT_P_TBD

JC_DOUT

JC_WS | R_G13 JC_BCLK
JC_MCLK | R_X_COIL_TBD

R_G12 R_G13 R_G14 R_Y_PWR_TBD

R_Y_COIL_TBD

JC_BAT_P_TBD

R_G8

JC_BAT_N_TBD

JC_LCD_RST

JC_SDA

JC_SCL

JC_DSI | R_G3
JC_LCD_RST | R_G46
JC_BL | R_Z_PWR_TBD

R_Z_COIL_TBD

JC_SDA

R_G4

JC_SCL

JC_SDA

JC_SCL

JC_MCLK

JC_BCLK

JC_WS

JC_DOUT

JC_D0 | R_G5

JC_D1

JC_D2 | R_G6 R_G7 R_RELAY_PWR_TBD

JC_D3

JC_CLK

JC_CMD

JC_BL

JC_DIN

JC_C6_RST

JC_DSI | JC_CLK
| JC_CMD

R_CONTACT_TBD

R_G15 R_G16

JC_D0 | R_G17
JC_D1 | R_G18
JC_D2 | R_DC_PWR_TBD
JC_D3 | R_DC_EN_TBD
JC_C6_RST | R_DC_OUT_TBD H_G2 H_G12 H_G13 H_G14 H_G21 | H_G12 H_G14 H_G15 H_G2

JC_EXT_N_TBD

H_G21

JC_BAT_P_TBD

JC_BAT_N_TBD | H_G13 H_G25 H_G32 H_G33 H_G36 C_G4 | H_G39 C_G11 C_G13 | C_G47 C_G21 C_G13 C_G14 C_G35 C_G36 | H_G32 H_G39 H_G25 H_G33 H_G36 C_G11 C_G4 C_G40 C_G41 C_G42 C_G39 C_G48 | H_G15

JC_DIN

JC_AMP_EN

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

# 02 JC1060Robot3Axis기존 선택 단말 / 신호·독립 전원

ARD | 2026-10-26 | 핀 이름은 기능/GPIO 식별자이며 물리 커넥터 순번이 아님

같은 이름의 라벨은 같은 시트에서 전기적으로 연결됨. 무선 통신은 배선으로 그리지 않음.

JC1060: 별도 전원 + 제작사 배터리 모듈. 전압·충전/전환·실제 단자 순서 TBD.

JC 구성요소는 보드 내장 회로. 위 라벨은 내부 인터페이스이며 외부 점퍼 배선 지시가 아님. 내장 마이크·스피커는 ES8311 오디오 경로 사용. 세부 아날로그 배선·증폭 회로는 보드 내부. 기존 ControlMCU / HMI_MCU 선택 구성 (JC1060으로 역할 전환 가능) | CH1/2: 공압 그리퍼

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
