khw1566/ARD/output/pdf/ard_system_2p/ARD_시스템_회로구성_2장.pdf

ARD / SYSTEM ENGINEERING

# 시스템 구성 및 제어 흐름

JC1060 통합 단말을 추가하고, 기존 구동·촬영·로봇 보드의 역할을 함께 정리했다.

2026.10.26

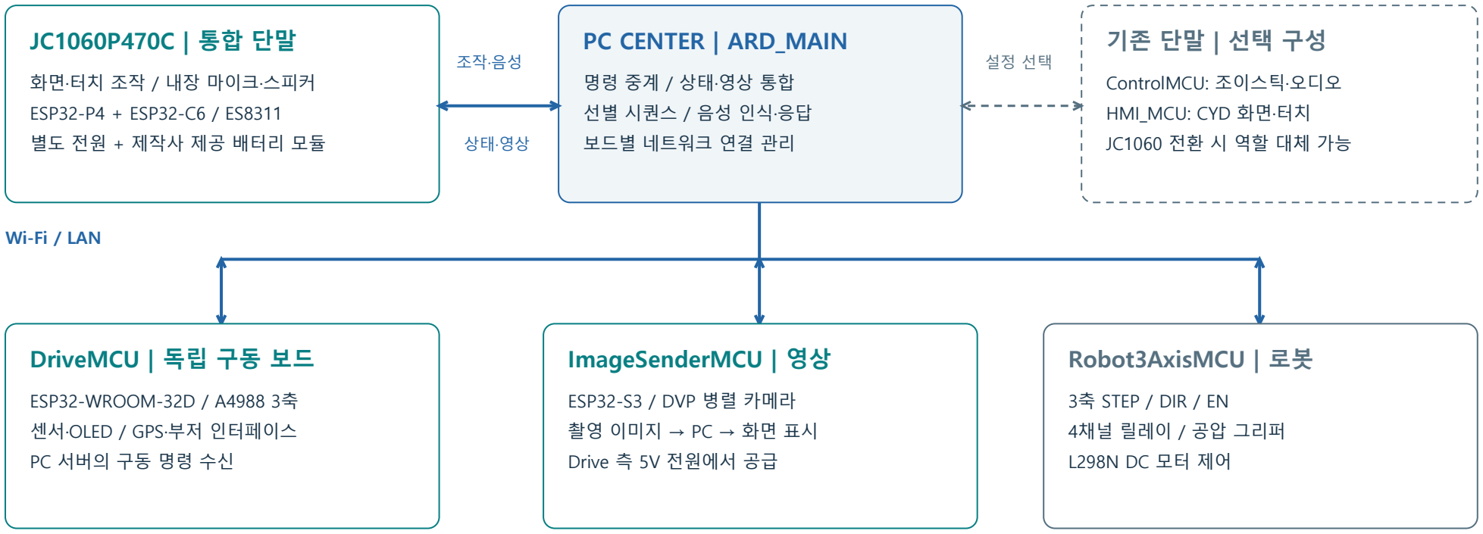
[picture p182: figure]
화면·터치 조작 / 내장 마이크·스피커; ESP32-P4 + ESP32-C6 / ES8311; 별도 전원 + 제작사 제공 배터리 모듈; PC CENTER | ARD_MAIN; 선별 시퀀스 / 음성 인식·응답; 보드별 네트워크 연결 관리; ControlMCU: 조이스틱·오디오; HMI_MCU: CYD 화면·터치; Wi-Fi / LAN; DriveMCU | 독립 구동 보드; ESP32-WROOM-32D / A4988 3축; 센서·OLED / GPS·부저 인터페이스; PC 서버의 구동 명령 수신; ImageSenderMCU | 영상; ESP32-S3 / DVP 병렬 카메라; 촬영 이미지 → PC → 화면 표시; Drive 측 5V 전원에서 공급; Robot3AxisMCU | 로봇; 3축 STEP / DIR / EN; 4채널 릴레이 / 공압 그리퍼

## JC1060이 추가되어도 구동은 DriveMCU가 담당

터치·음성 입력 → PC 서버 → DriveMCU / Robot3AxisMCU

카메라 영상 → PC 서버 → JC1060 화면
JC1060 내장 화면·터치·오디오를 사용하며 외부 모터·센서는 연결하지 않는다. 파란 선: 네트워크 데이터 흐름 / 회색 점선: 기존 단말의 선택 경로

## 전원 구성의 핵심 변경

12V → 스텝다운 → 5V

DriveMCU·센서·ImageSenderMCU 공급 JC1060은 별도 전원·배터리 계통
전원 및 주요 GPIO 연결은 다음 쪽 참조
발표용 연결 요약 | 실물 전원 정보 + 소스 기반 신호 | 전기적 정격·실배선 검증 별도 | 01 / 02

# 전원 계통 및 주요 신호 연결

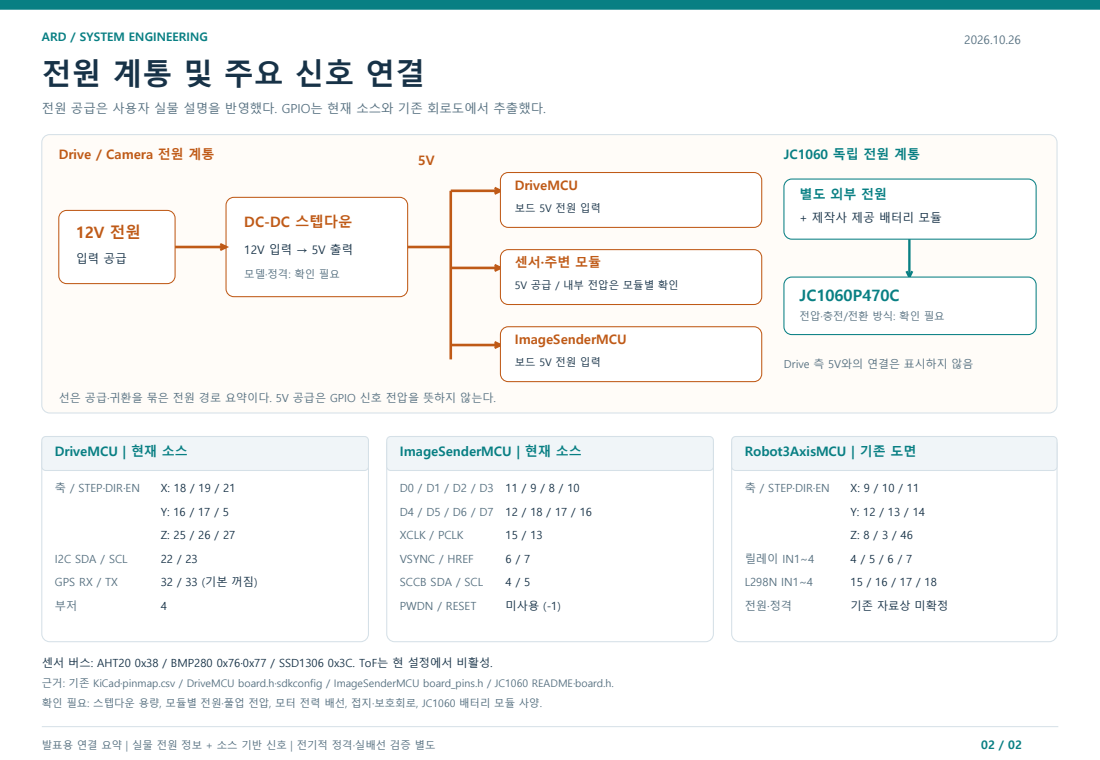
[picture p183: page 2]

전원 공급은 사용자 실물 설명을 반영했다. GPIO는 현재 소스와 기존 회로도에서 추출했다.

Drive / Camera 전원 계통

+ 제작사 제공 배터리 모듈

5V 공급 / 내부 전압은 모듈별 확인

Drive 측 5V와의 연결은 표시하지 않음

선은 공급·귀환을 묶은 전원 경로 요약이다. 5V 공급은 GPIO 신호 전압을 뜻하지 않는다.

센서 버스: AHT20 0x38 / BMP280 0x76·0x77 / SSD1306 0x3C. ToF는 현 설정에서 비활성.

근거: 기존 KiCad·pinmap.csv / DriveMCU board.h·sdkconfig / ImageSenderMCU board_pins.h / JC1060 README·board.h.
확인 필요: 스텝다운 용량, 모듈별 전원·풀업 전압, 모터 전력 배선, 접지·보호회로, JC1060 배터리 모듈 사양.
