khw1566/ARD/ARD_hardware/3축직교로봇.pdf

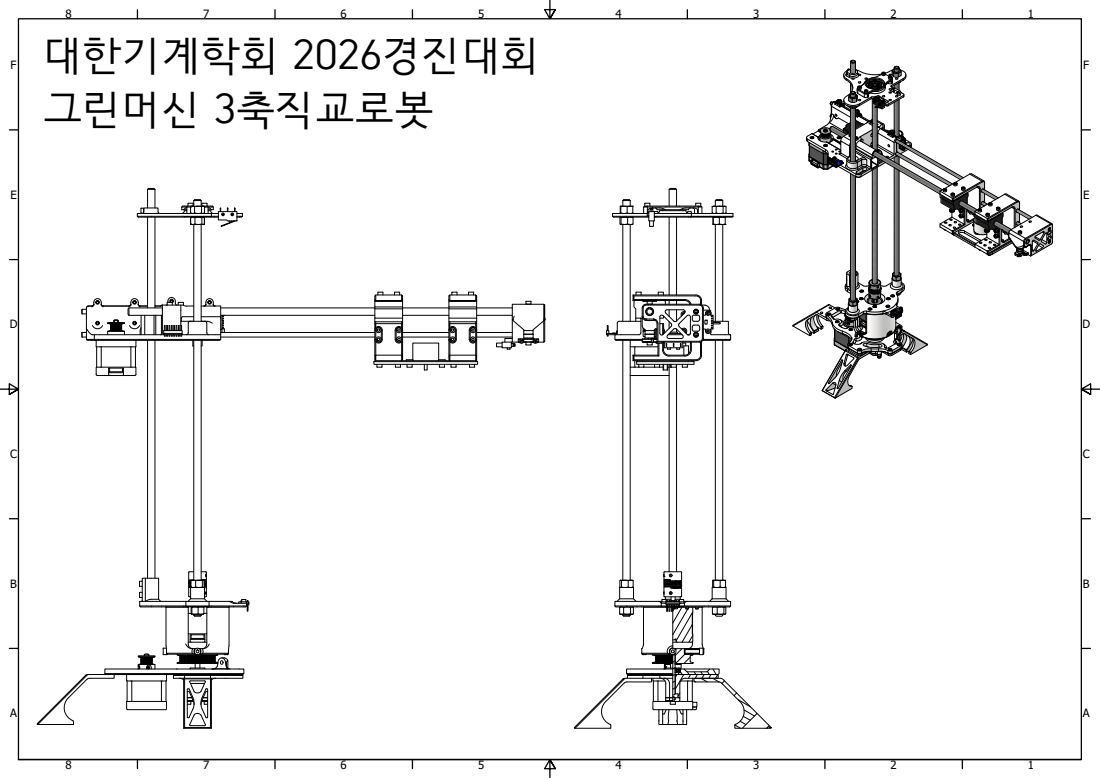
[picture p184: page 1]
대한기계학회 2026경진대회; 그린머신 3축직교로봇
