khw1566/ARD/ARD_hardware/분류구조.pdf

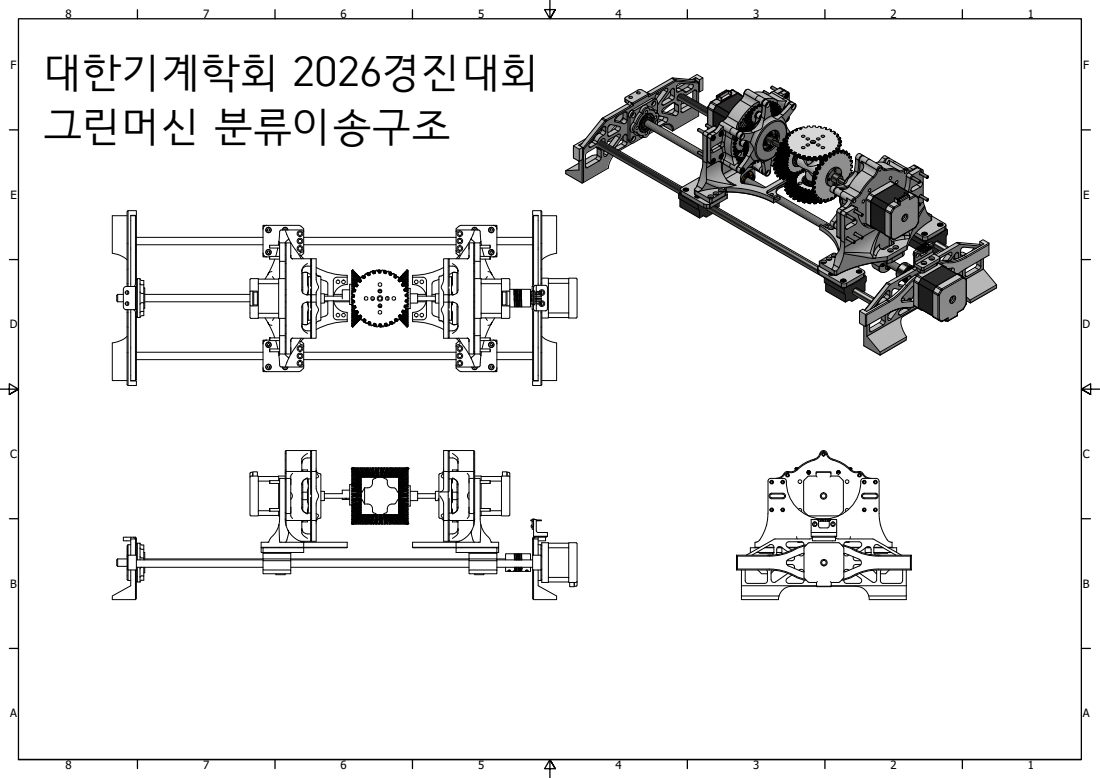
[picture p185: page 1]
대한기계학회; F 2026경진대회; 그린머신 분류이송구조
