khw1566/ARD/ARD_hardware/분류구조1.pdf

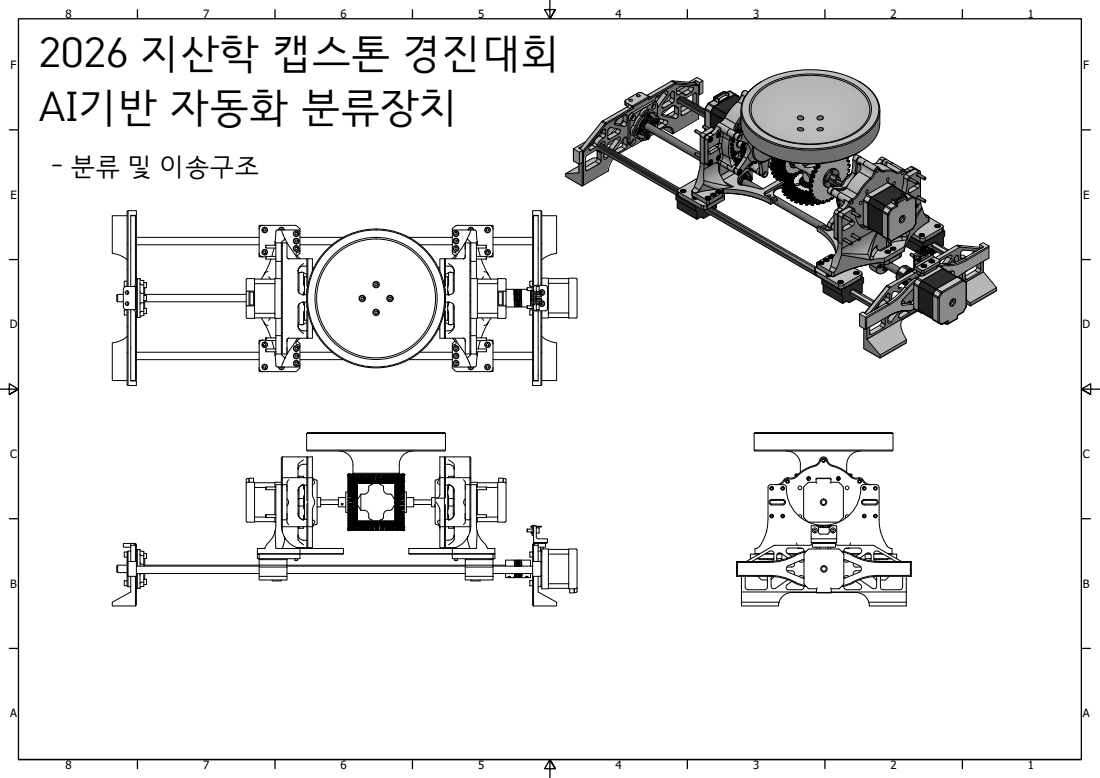
[picture p186: page 1]
2026 지산학 캡스톤 경진대회; - 분류 및 이송구조

AI기반 자동화 분류장치
