khw1566/ARD/ARD_hardware/ARD_Model_v1/0325.pdf

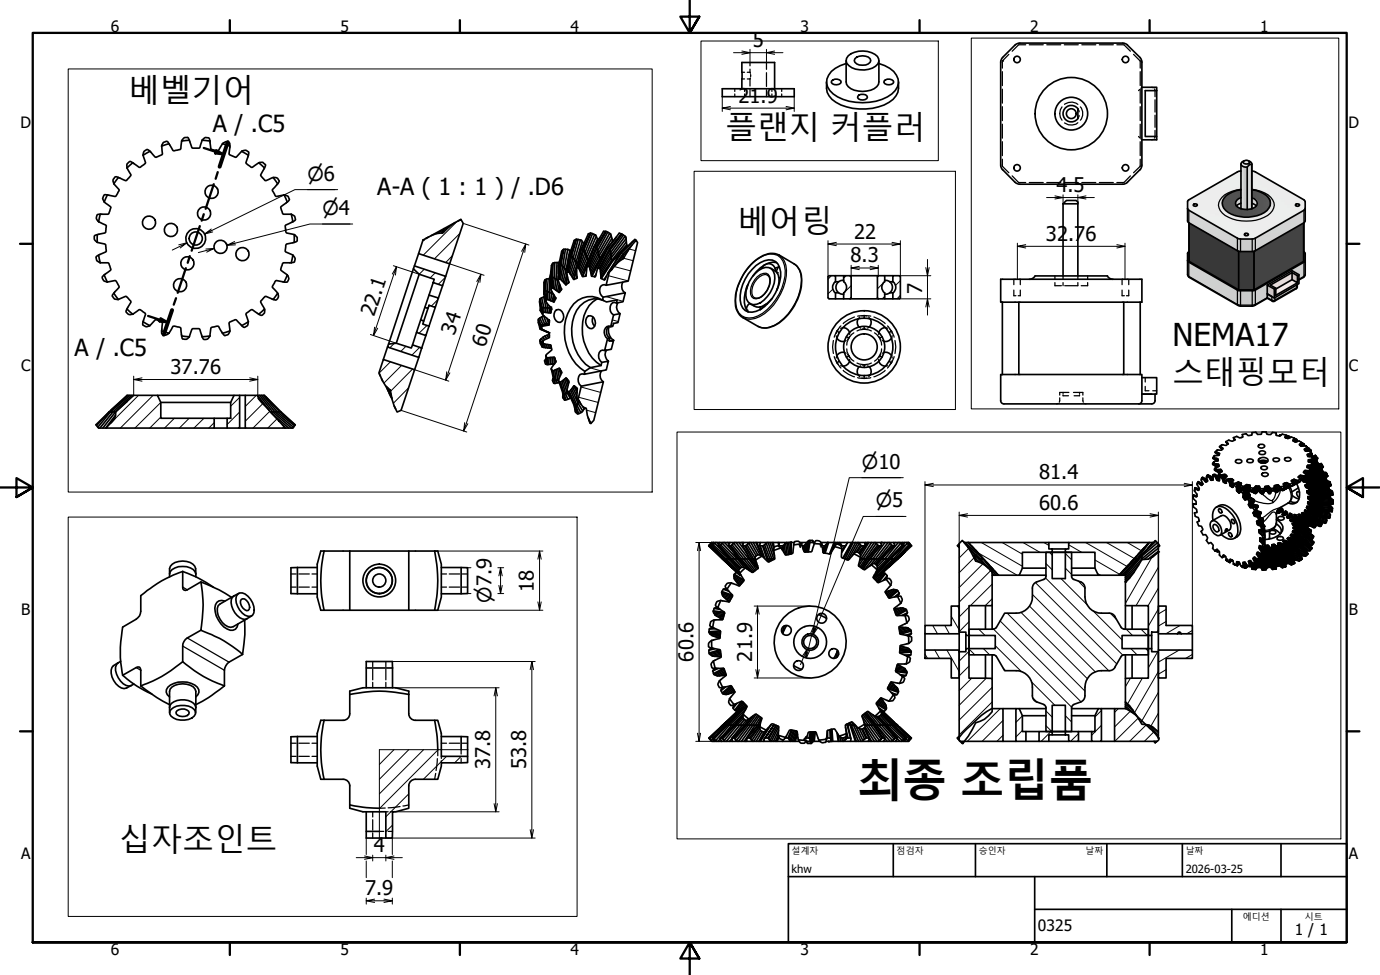
[picture p187: page 1]
최종 조립품; 플랜지 커플러
