khw1566/ARD/ARD_hardware/PL121248m2Drive_v2/pl_v2.pdf

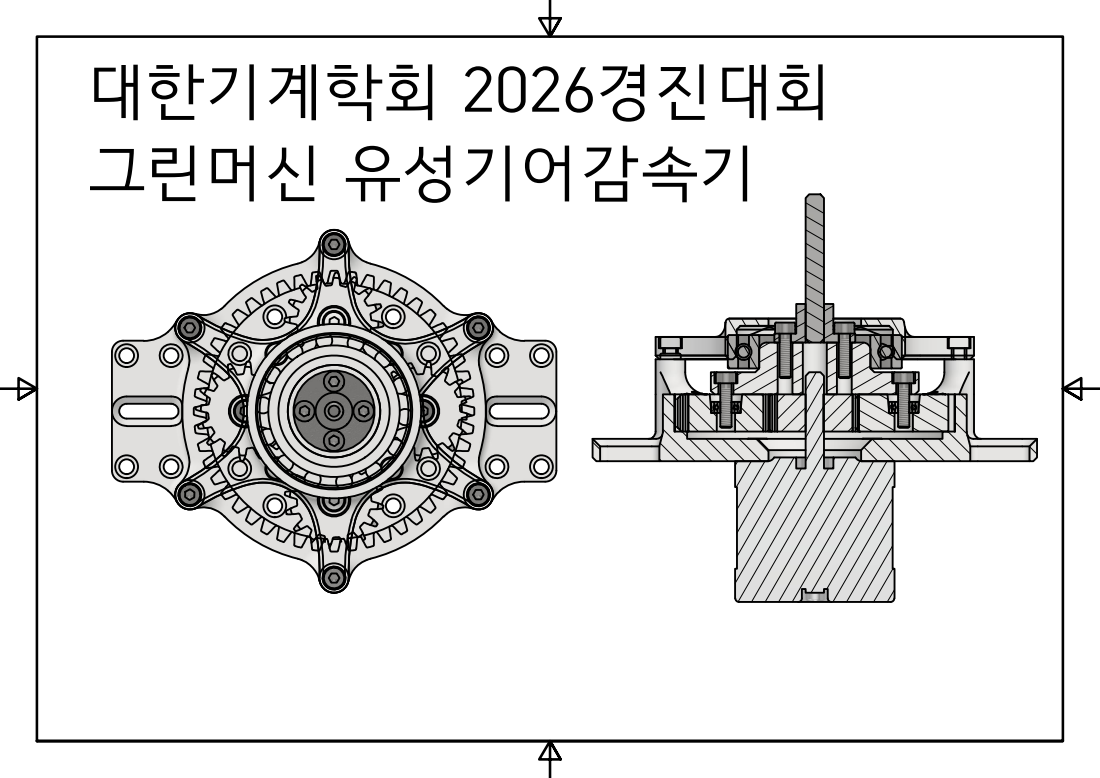
[picture p188: page 1]
대한기계학회 2026경진대회 그린머신 유성기어감속기
