khw1566/ARD/ARD_hardware/RA_Project/Head/RA_v1.pdf

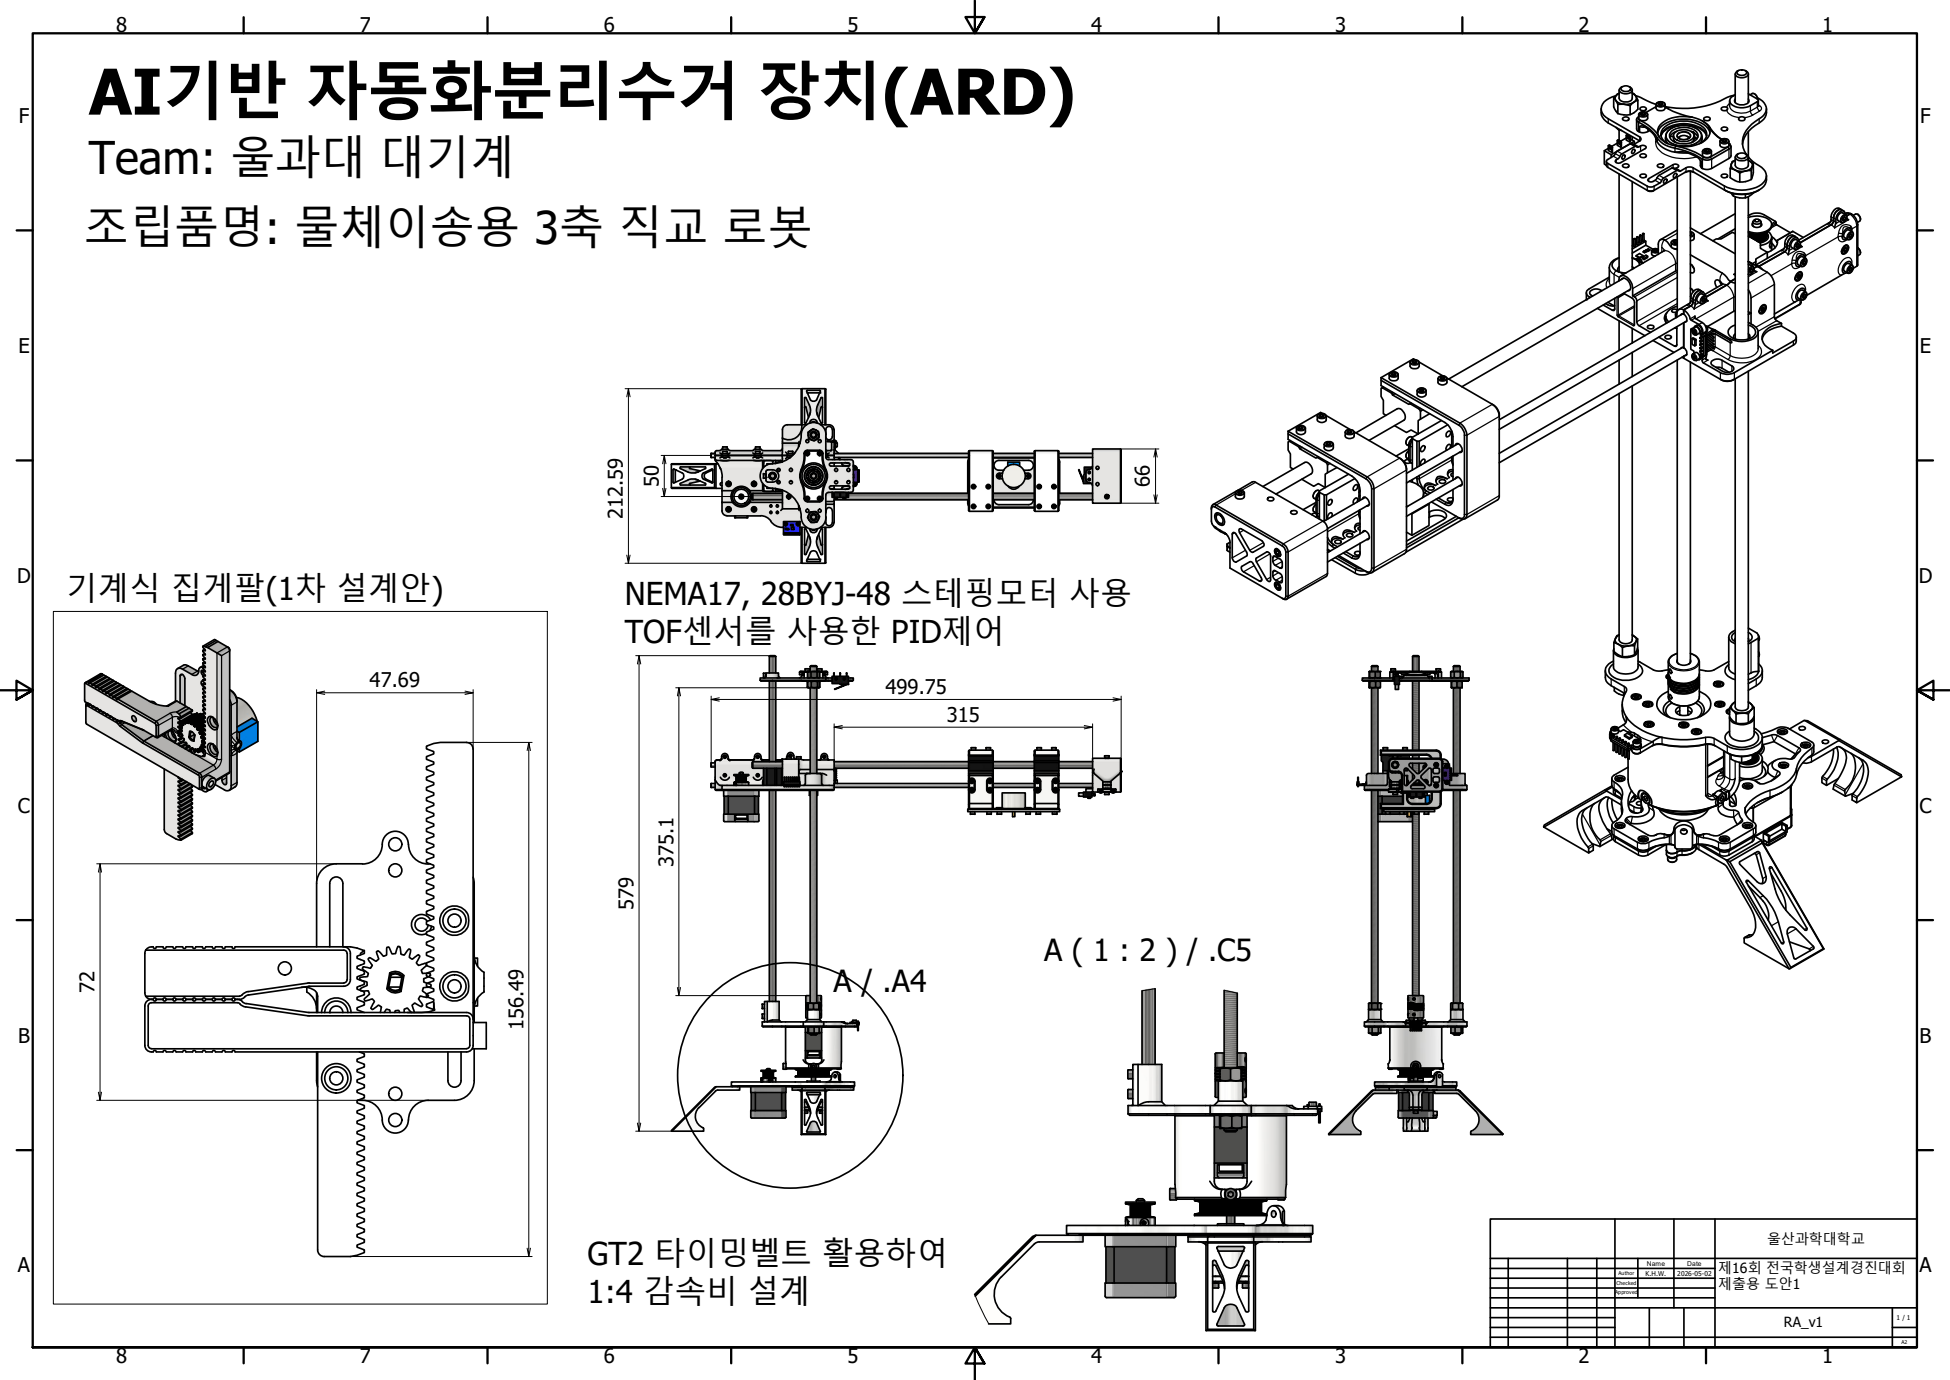
[picture p189: page 1]
제16회 전국학생설계경진대회 제출용 도안1; GT2 타이밍벨트 활용하여 1:4 감속비 설계

AI기반 자동화분리수거 장치(ARD)
Team: 울과대 대기계
조립품명: 물체이송용 3축 직교 로봇

기계식 집게팔(1차 설계안)

NEMA17, 28BYJ-48 스테핑모터 사용
TOF센서를 사용한 PID제어
