khw1566/ARD/ARD_hardware/PL121248m2Drive_v1/PL121248v1.pdf

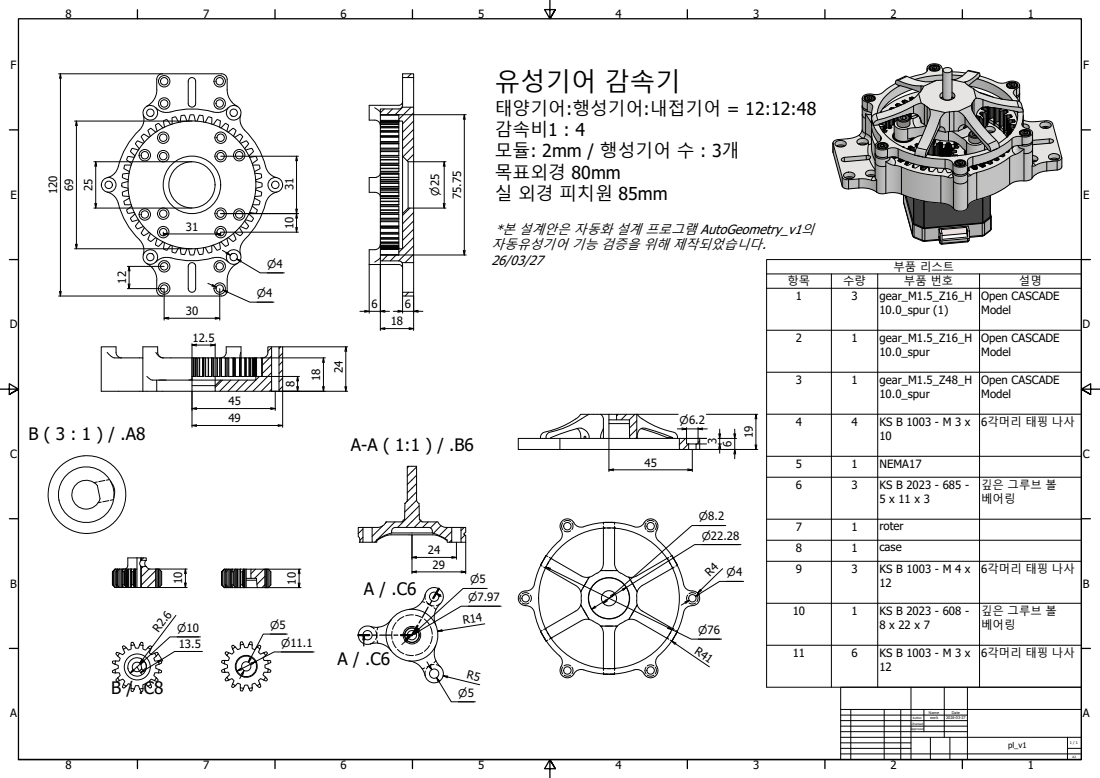
[picture p190: page 1]
부품 리스트

유성기어 감속기
태양기어:행성기어:내접기어 = 12:12:48
감속비1 : 4
모듈: 2mm / 행성기어 수 : 3개
목표외경 80mm
실 외경 피치원 85mm

*본 설계안은 자동화 설계 프로그램 AutoGeometry_v1의
자동유성기어 기능 검증을 위해 제작되었습니다.

항목 | 수량 | 부품 번호 | 설명
1 | 3 | gear_M1.5_Z16_H 10.0_spur (1) | Open CASCADE Model

2 | 1 | gear_M1.5_Z16_H 10.0_spur | Open CASCADE Model

3 | 1 | gear_M1.5_Z48_H 10.0_spur | Open CASCADE Model

4 | 4 | KS B 1003 - M 3 x 10 | 6각머리 태핑 나사

5 | 1 | NEMA17
6 | 3 | KS B 2023 - 685 -5 x 11 x 3 | 깊은 그루브 볼 베어링

7 | 1 | roter
8 | 1 | case
9 | 3 | KS B 1003 - M 4 x 12 | 6각머리 태핑 나사

10 | 1 | KS B 2023 - 608 -8 x 22 x 7 | 깊은 그루브 볼 베어링

11 | 6 | KS B 1003 - M 3 x 12 | 6각머리 태핑 나사

Name | Date

Author | work | 2026-03-27

Checked
Approved
