khw1566/ARD/ARD_hardware/PneumaticGripper_v1/PneumaticGripper_v1.1.pdf

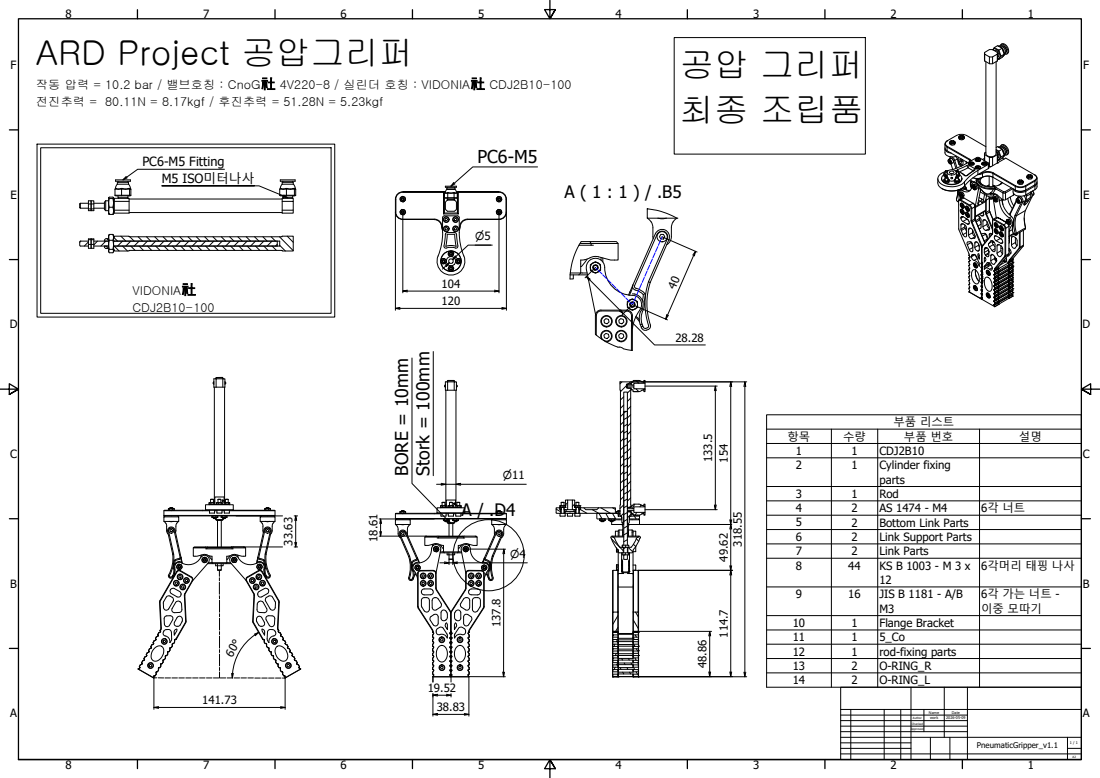
[picture p191: page 1]
부품 리스트; Cylinder fixing; Bottom Link Parts; Link Support Parts; Link Parts; KS B 1003 - M 3 x 6각머리 태핑 나사; 6각 가는 너트 - 이중 모따기; JIS B 1181 - A/B; Flange Bracket; rod-fixing parts; 공압 그리퍼 최종 조립품; PC6-M5 Fitting M5 ISO미터나사

ARD Project 공압그리퍼

작동 압력 = 10.2 bar / 밸브호칭 : CnoG社 4V220-8 / 실린더 호칭 : VIDONIA社 CDJ2B10-100
전진추력 = 80.11N = 8.17kgf / 후진추력 = 51.28N = 5.23kgf
