khw1566/ARD/ARD_hardware/PneumaticGripper_v1/공압도.pdf

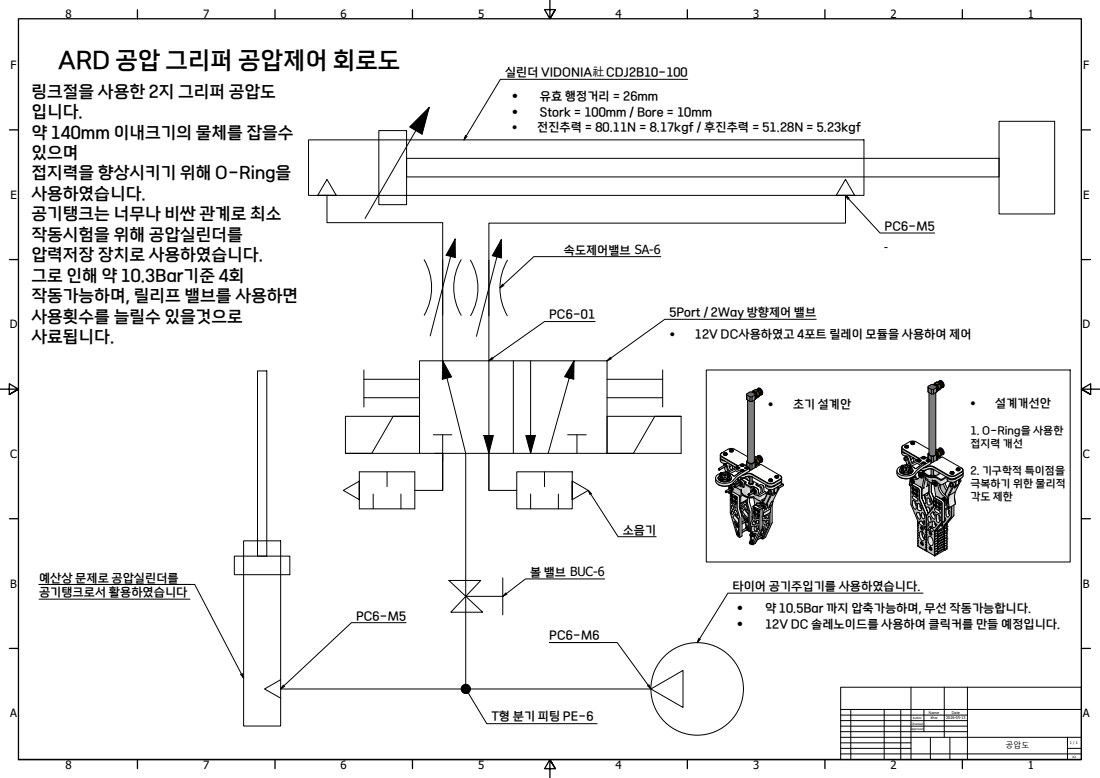
[picture p192: page 1]
볼 밸브 BUC-6; 속도제어밸브 SA-6; 실린더 VIDONIA社CDJ2B10-100; • 유효 행정거리 = 26mm • Stork = 100mm / Bore = 10mm • 전진추력 = 80.11N = 8.17kgf / 후진추력 = 51.28N = 5.23kgf; 초기 설계안; 설계개선안; 1. O-Ring을 사용한 접지력 개선

ARD 공압 그리퍼 공압제어 회로도

링크절을 사용한 2지 그리퍼 공압도
입니다.
약 140mm 이내크기의 물체를 잡을수
있으며
접지력을 향상시키기 위해 O-Ring을
사용하였습니다.
공기탱크는 너무나 비싼 관계로 최소
작동시험을 위해 공압실린더를
압력저장 장치로 사용하였습니다.
그로 인해 약 10.3Bar기준 4회
작동가능하며, 릴리프 밸브를 사용하면
사용횟수를 늘릴수 있을것으로
사료됩니다.

5Port / 2Way 방향제어 밸브
• 12V DC사용하였고 4포트 릴레이 모듈을 사용하여 제어

2. 기구학적 특이점을
극복하기 위한 물리적

예산상 문제로 공압실린더를
공기탱크로서 활용하였습니다

타이어 공기주입기를 사용하였습니다.
• 약 10.5Bar 까지 압축가능하며, 무선 작동가능합니다.
• 12V DC 솔레노이드를 사용하여 클릭커를 만들 예정입니다.

Name | Date

Author | khw | 2026-05-13

Checked
Approved
