khw1566/ARD/output/kicad/ARD_2Sheet/02_Terminals_Robot.kicad_sch

## KiCad design output/kicad/ARD_2Sheet/02_Terminals_Robot.kicad_sch (2026-10-26)

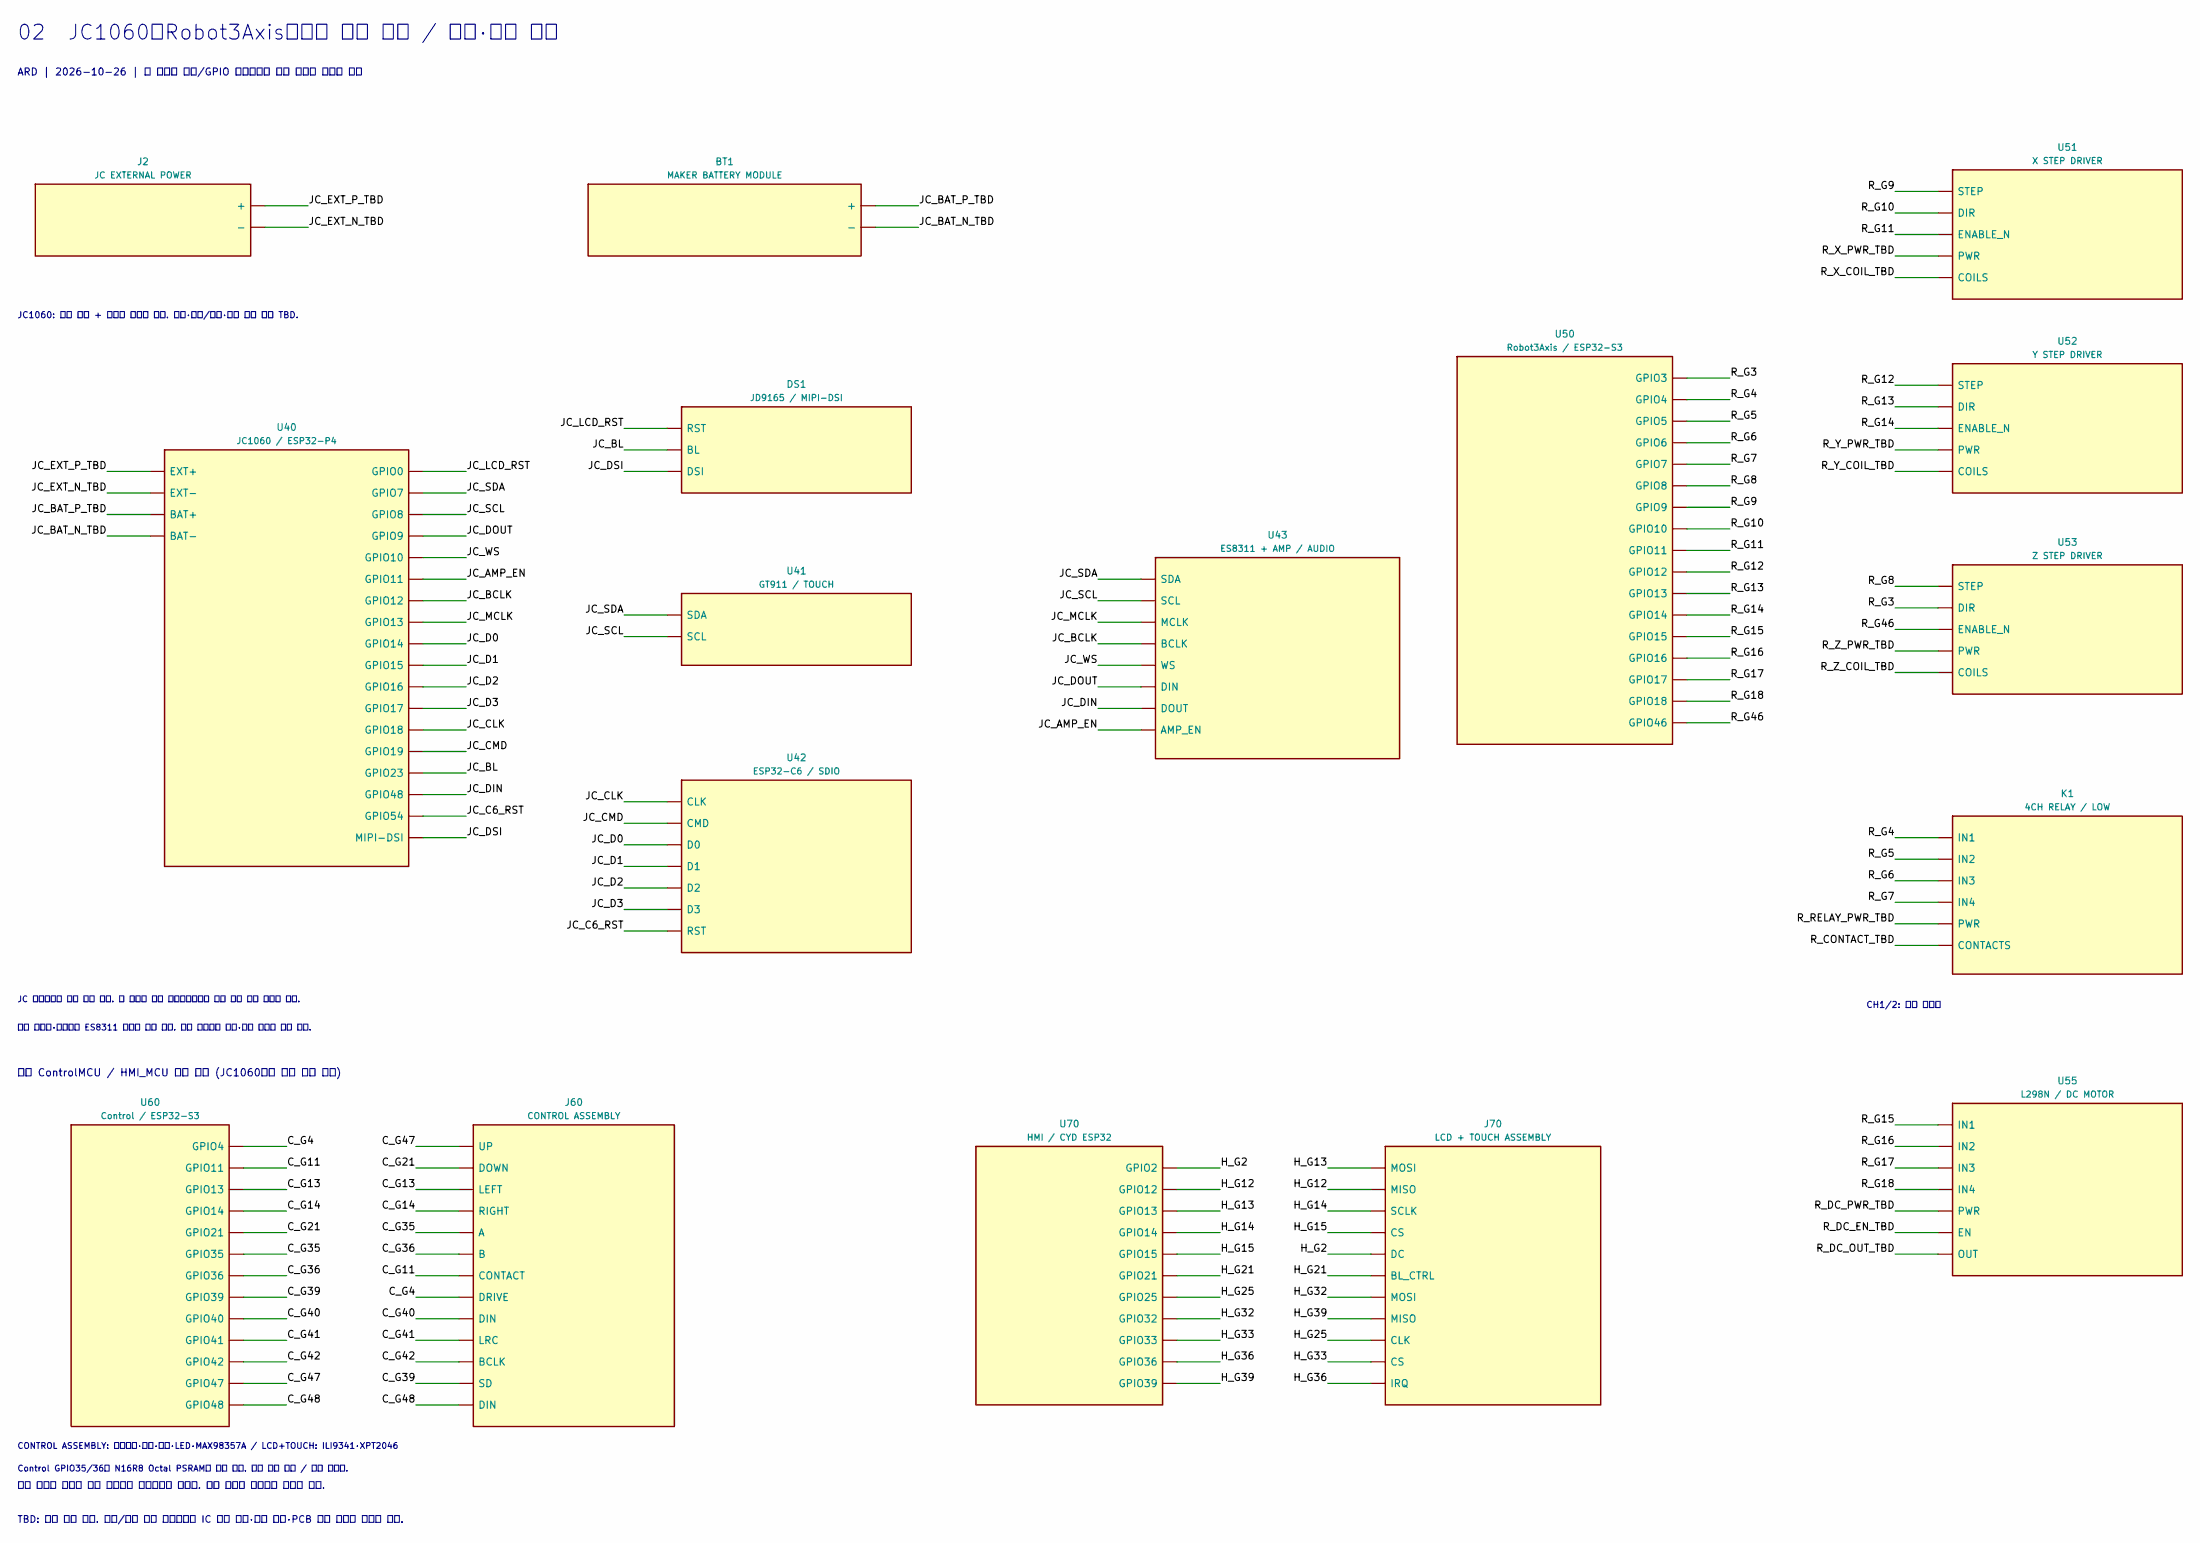
[picture p193: schematic 02_Terminals_Robot.kicad_sch]

Parts:
BT1: MAKER BATTERY MODULE
DS1: JD9165 / MIPI-DSI
J2: JC EXTERNAL POWER
J60: CONTROL ASSEMBLY
J70: LCD + TOUCH ASSEMBLY
K1: 4CH RELAY / LOW
U40: JC1060 / ESP32-P4
U41: GT911 / TOUCH
U42: ESP32-C6 / SDIO
U43: ES8311 + AMP / AUDIO
U50: Robot3Axis / ESP32-S3
U51: X STEP DRIVER
U52: Y STEP DRIVER
U53: Z STEP DRIVER
U55: L298N / DC MOTOR
U60: Control / ESP32-S3
U70: HMI / CYD ESP32

Connections:
C_G4: J60.D201_DRIVE (DRIVE), U60.4 (GPIO4)
C_G11: J60.SW203_CONTACT (CONTACT), U60.11 (GPIO11)
C_G13: J60.SW201_LEFT (LEFT), U60.13 (GPIO13)
C_G14: J60.SW201_RIGHT (RIGHT), U60.14 (GPIO14)
C_G21: J60.SW201_DOWN (DOWN), U60.21 (GPIO21)
C_G35: J60.SW202_A (A), U60.35 (GPIO35)
C_G36: J60.SW202_B (B), U60.36 (GPIO36)
C_G39: J60.U201_SD (SD), U60.39 (GPIO39)
C_G40: J60.U201_DIN (DIN), U60.40 (GPIO40)
C_G41: J60.U201_LRC (LRC), U60.41 (GPIO41)
C_G42: J60.U201_BCLK (BCLK), U60.42 (GPIO42)
C_G47: J60.SW201_UP (UP), U60.47 (GPIO47)
C_G48: J60.D202_DIN (DIN), U60.48 (GPIO48)
H_G2: J70.U701_DC (DC), U70.2 (GPIO2)
H_G12: J70.U701_MISO (MISO), U70.12 (GPIO12)
H_G13: J70.U701_MOSI (MOSI), U70.13 (GPIO13)
H_G14: J70.U701_SCLK (SCLK), U70.14 (GPIO14)
H_G15: J70.U701_CS (CS), U70.15 (GPIO15)
H_G21: J70.U701_BL_CTRL (BL_CTRL), U70.21 (GPIO21)
H_G25: J70.U702_CLK (CLK), U70.25 (GPIO25)
H_G32: J70.U702_MOSI (MOSI), U70.32 (GPIO32)
H_G33: J70.U702_CS (CS), U70.33 (GPIO33)
H_G36: J70.U702_IRQ (IRQ), U70.36 (GPIO36)
H_G39: J70.U702_MISO (MISO), U70.39 (GPIO39)
JC_AMP_EN: U40.11 (GPIO11), U43.AMP_EN
JC_BAT_N_TBD: BT1.-, U40.BAT-
JC_BAT_P_TBD: BT1.+, U40.BAT+
JC_BCLK: U40.12 (GPIO12), U43.BCLK
JC_BL: DS1.BL, U40.23 (GPIO23)
JC_C6_RST: U40.54 (GPIO54), U42.RST
JC_CLK: U40.18 (GPIO18), U42.CLK
JC_CMD: U40.19 (GPIO19), U42.CMD
JC_D0: U40.14 (GPIO14), U42.D0
JC_D1: U40.15 (GPIO15), U42.D1
JC_D2: U40.16 (GPIO16), U42.D2
JC_D3: U40.17 (GPIO17), U42.D3
JC_DIN: U40.48 (GPIO48), U43.DOUT
JC_DOUT: U40.9 (GPIO9), U43.DIN
JC_DSI: DS1.DSI, U40.DSI (MIPI-DSI)
JC_EXT_N_TBD: J2.-, U40.EXT-
JC_EXT_P_TBD: J2.+, U40.EXT+
JC_LCD_RST: DS1.RST, U40.0 (GPIO0)
JC_MCLK: U40.13 (GPIO13), U43.MCLK
JC_SCL: U40.8 (GPIO8), U41.SCL, U43.SCL
JC_SDA: U40.7 (GPIO7), U41.SDA, U43.SDA
JC_WS: U40.10 (GPIO10), U43.WS
R_CONTACT_TBD: K1.CONTACTS
R_DC_EN_TBD: U55.EN
R_DC_OUT_TBD: U55.OUT
R_DC_PWR_TBD: U55.PWR
R_G3: U50.3 (GPIO3), U53.DIR
R_G4: K1.IN1, U50.4 (GPIO4)
R_G5: K1.IN2, U50.5 (GPIO5)
R_G6: K1.IN3, U50.6 (GPIO6)
R_G7: K1.IN4, U50.7 (GPIO7)
R_G8: U50.8 (GPIO8), U53.STEP
R_G9: U50.9 (GPIO9), U51.STEP
R_G10: U50.10 (GPIO10), U51.DIR
R_G11: U50.11 (GPIO11), U51.ENABLE_N
R_G12: U50.12 (GPIO12), U52.STEP
R_G13: U50.13 (GPIO13), U52.DIR
R_G14: U50.14 (GPIO14), U52.ENABLE_N
R_G15: U50.15 (GPIO15), U55.IN1
R_G16: U50.16 (GPIO16), U55.IN2
R_G17: U50.17 (GPIO17), U55.IN3
R_G18: U50.18 (GPIO18), U55.IN4
R_G46: U50.46 (GPIO46), U53.ENABLE_N
R_RELAY_PWR_TBD: K1.PWR
R_X_COIL_TBD: U51.COILS
R_X_PWR_TBD: U51.PWR
R_Y_COIL_TBD: U52.COILS
R_Y_PWR_TBD: U52.PWR
R_Z_COIL_TBD: U53.COILS
R_Z_PWR_TBD: U53.PWR

Notes on the sheet:
02 JC1060・Robot3Axis・기존 선택 단말 / 신호·독립 전원
ARD | 2026-10-26 | 핀 이름은 기능/GPIO 식별자이며 물리 커넥터 순번이 아님
같은 이름의 라벨은 같은 시트에서 전기적으로 연결됨. 무선 통신은 배선으로 그리지 않음.
TBD: 실물 확인 필요. 모듈/보드 단위 회로도이며 IC 내부 회로·전류 용량·PCB 제작 검증을 뜻하지 않음.
JC1060: 별도 전원 + 제작사 배터리 모듈. 전압·충전/전환·실제 단자 순서 TBD.
JC 구성요소는 보드 내장 회로. 위 라벨은 내부 인터페이스이며 외부 점퍼 배선 지시가 아님.
내장 마이크·스피커는 ES8311 오디오 경로 사용. 세부 아날로그 배선·증폭 회로는 보드 내부.
CH1/2: 공압 그리퍼
기존 ControlMCU / HMI_MCU 선택 구성 (JC1060으로 역할 전환 가능)
CONTROL ASSEMBLY: 조이스틱·토글·버튼·LED·MAX98357A / LCD+TOUCH: ILI9341·XPT2046
Control GPIO35/36은 N16R8 Octal PSRAM과 충돌 가능. 기존 배정 보존 / 전원 미확정.
