khw1566/ARD/output/kicad/ARD_2Sheet/ARD_2Sheet.kicad_sch

## KiCad design output/kicad/ARD_2Sheet/ARD_2Sheet.kicad_sch (2026-10-26)

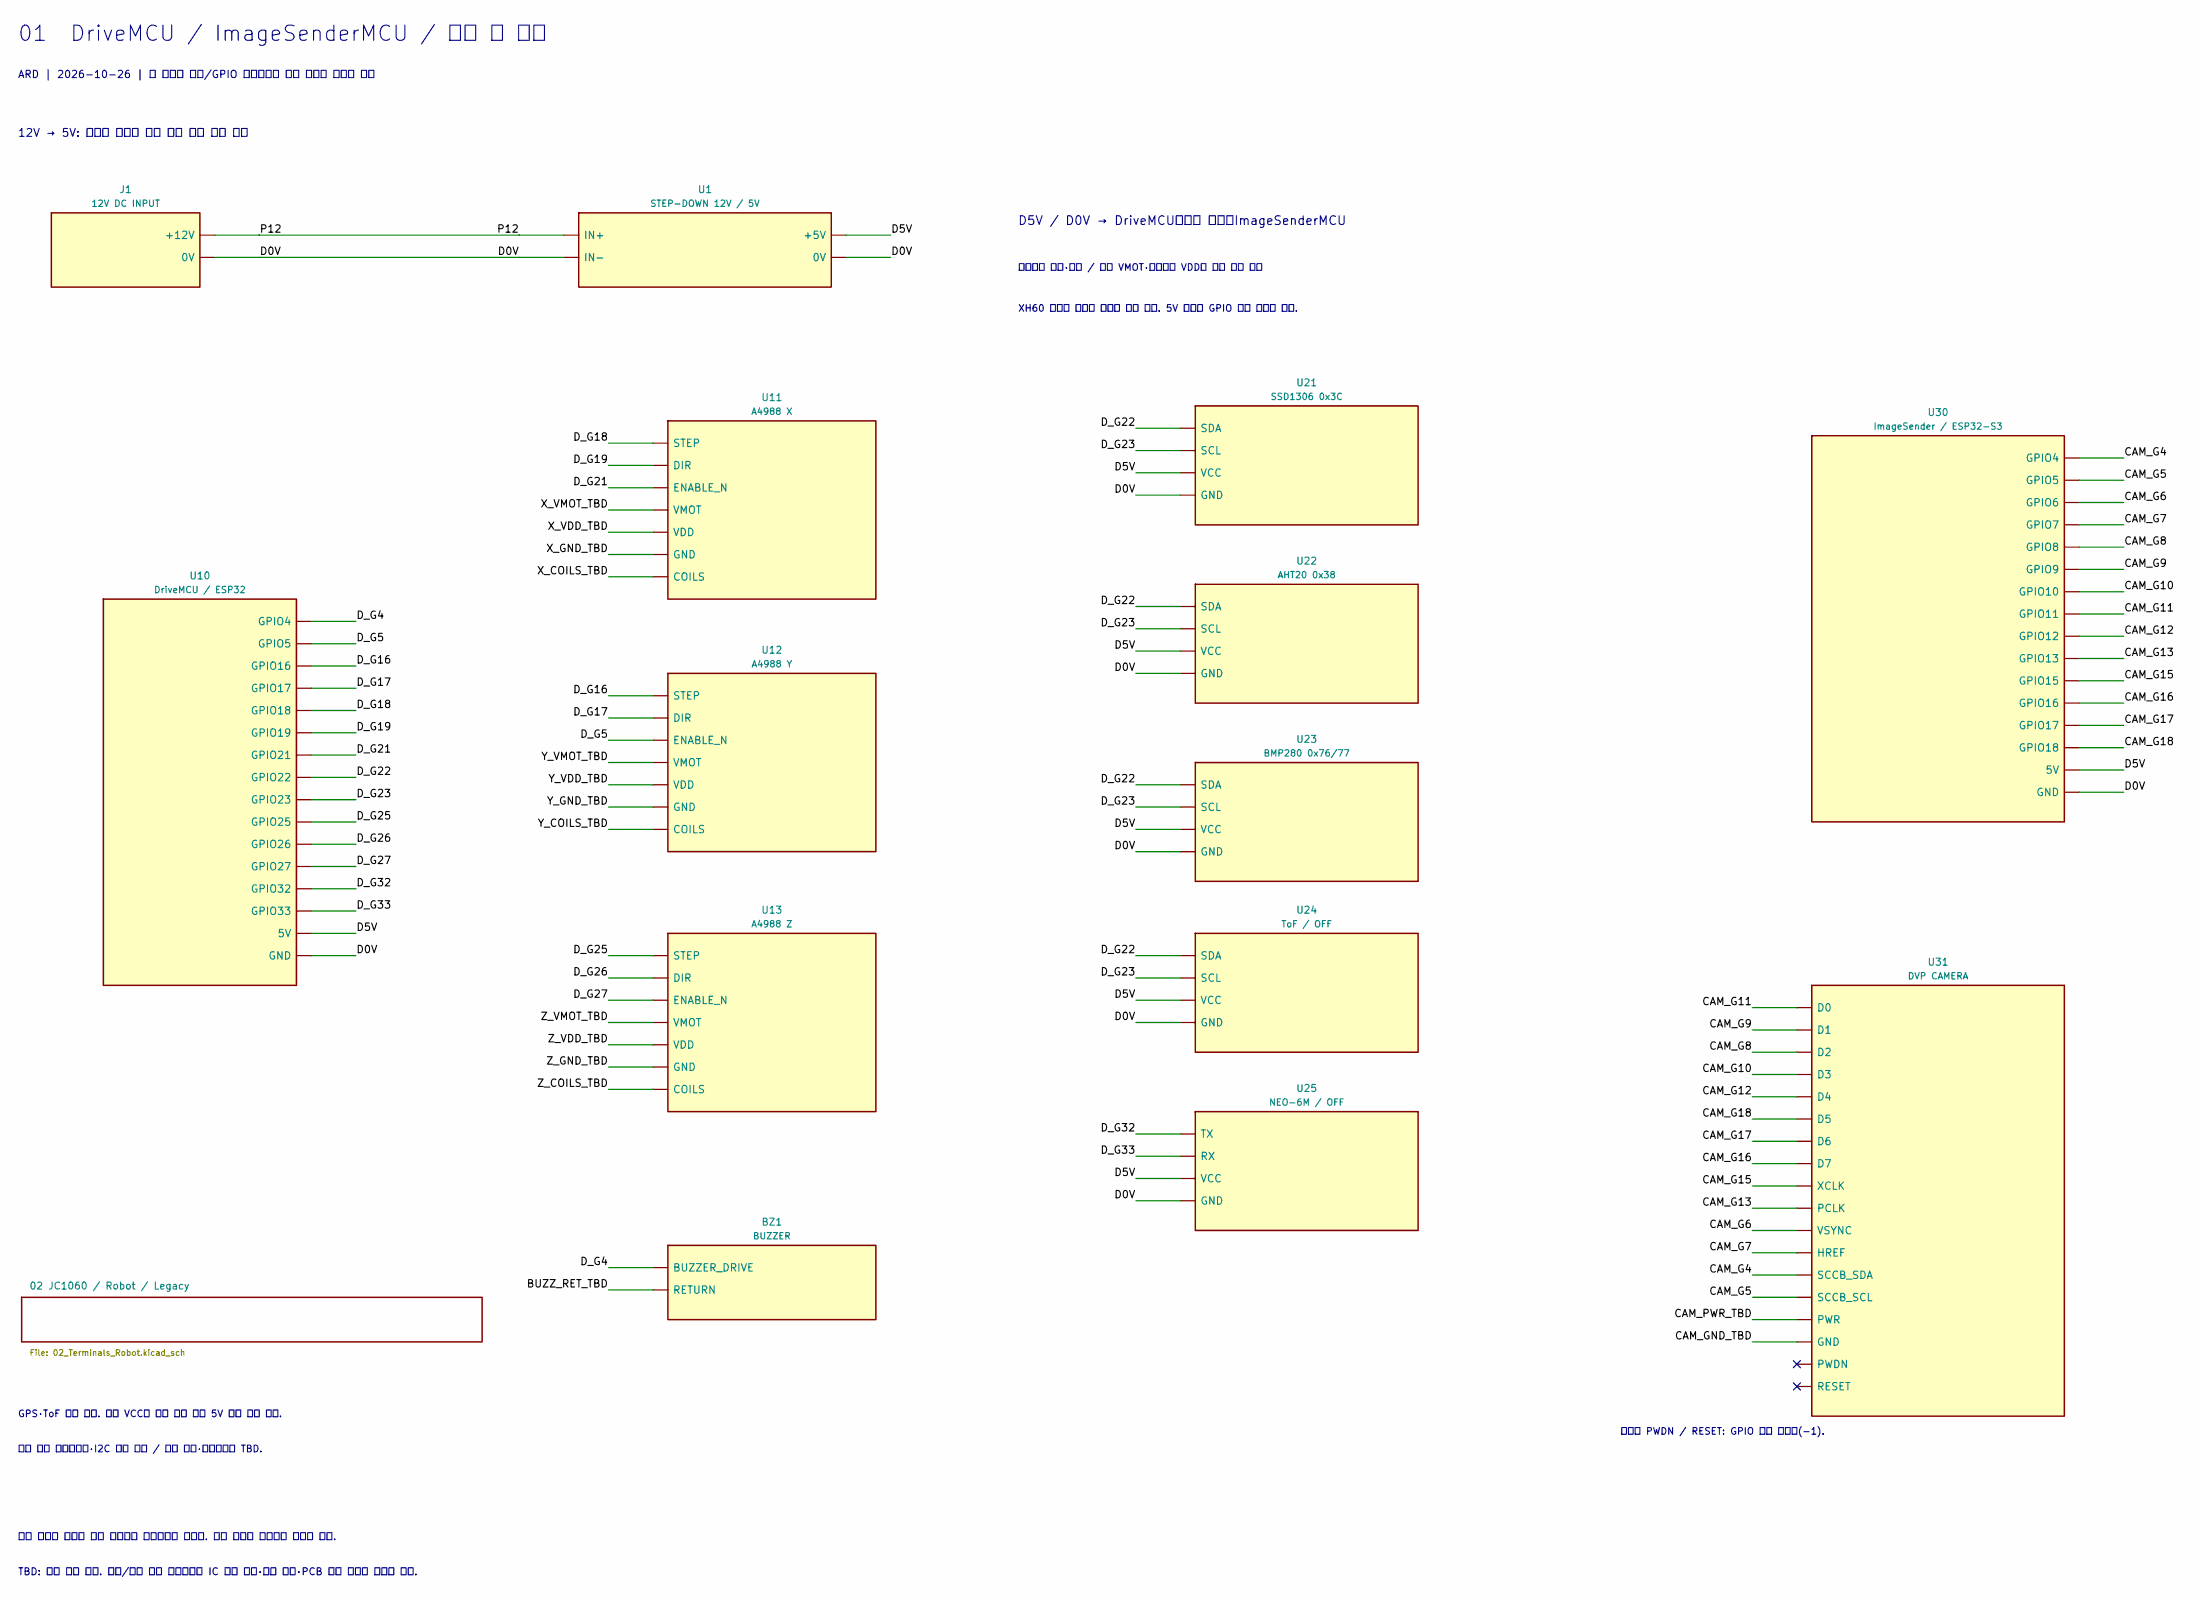
[picture p194: schematic ARD_2Sheet.kicad_sch]

Parts:
BZ1: BUZZER
J1: 12V DC INPUT
U1: STEP-DOWN 12V / 5V
U10: DriveMCU / ESP32
U11: A4988 X
U12: A4988 Y
U13: A4988 Z
U21: SSD1306 0x3C
U22: AHT20 0x38
U23: BMP280 0x76/77
U24: ToF / OFF
U25: NEO-6M / OFF
U30: ImageSender / ESP32-S3
U31: DVP CAMERA

Connections:
BUZZ_RET_TBD: BZ1.RETURN
CAM_G4: U30.4 (GPIO4), U31.SCCB_SDA
CAM_G5: U30.5 (GPIO5), U31.SCCB_SCL
CAM_G6: U30.6 (GPIO6), U31.VSYNC
CAM_G7: U30.7 (GPIO7), U31.HREF
CAM_G8: U30.8 (GPIO8), U31.D2
CAM_G9: U30.9 (GPIO9), U31.D1
CAM_G10: U30.10 (GPIO10), U31.D3
CAM_G11: U30.11 (GPIO11), U31.D0
CAM_G12: U30.12 (GPIO12), U31.D4
CAM_G13: U30.13 (GPIO13), U31.PCLK
CAM_G15: U30.15 (GPIO15), U31.XCLK
CAM_G16: U30.16 (GPIO16), U31.D7
CAM_G17: U30.17 (GPIO17), U31.D6
CAM_G18: U30.18 (GPIO18), U31.D5
CAM_GND_TBD: U31.GND
CAM_PWR_TBD: U31.PWR
D0V: J1.- (0V), U1.IN-, U1.OUT- (0V), U10.GND, U21.GND, U22.GND, U23.GND, U24.GND, U25.GND, U30.GND
D5V: U1.OUT+ (+5V), U10.5V, U21.VCC, U22.VCC, U23.VCC, U24.VCC, U25.VCC, U30.5V
D_G4: BZ1.BUZZER_DRIVE, U10.4 (GPIO4)
D_G5: U10.5 (GPIO5), U12.ENABLE_N
D_G16: U10.16 (GPIO16), U12.STEP
D_G17: U10.17 (GPIO17), U12.DIR
D_G18: U10.18 (GPIO18), U11.STEP
D_G19: U10.19 (GPIO19), U11.DIR
D_G21: U10.21 (GPIO21), U11.ENABLE_N
D_G22: U10.22 (GPIO22), U21.SDA, U22.SDA, U23.SDA, U24.SDA
D_G23: U10.23 (GPIO23), U21.SCL, U22.SCL, U23.SCL, U24.SCL
D_G25: U10.25 (GPIO25), U13.STEP
D_G26: U10.26 (GPIO26), U13.DIR
D_G27: U10.27 (GPIO27), U13.ENABLE_N
D_G32: U10.32 (GPIO32), U25.TX
D_G33: U10.33 (GPIO33), U25.RX
P12: J1.+ (+12V), U1.IN+
X_COILS_TBD: U11.COILS
X_GND_TBD: U11.GND
X_VDD_TBD: U11.VDD
X_VMOT_TBD: U11.VMOT
Y_COILS_TBD: U12.COILS
Y_GND_TBD: U12.GND
Y_VDD_TBD: U12.VDD
Y_VMOT_TBD: U12.VMOT
Z_COILS_TBD: U13.COILS
Z_GND_TBD: U13.GND
Z_VDD_TBD: U13.VDD
Z_VMOT_TBD: U13.VMOT

Notes on the sheet:
01 DriveMCU / ImageSenderMCU / 신호 및 전원
ARD | 2026-10-26 | 핀 이름은 기능/GPIO 식별자이며 물리 커넥터 순번이 아님
같은 이름의 라벨은 같은 시트에서 전기적으로 연결됨. 무선 통신은 배선으로 그리지 않음.
TBD: 실물 확인 필요. 모듈/보드 단위 회로도이며 IC 내부 회로·전류 용량·PCB 제작 검증을 뜻하지 않음.
12V → 5V: 사용자 설명에 따른 실제 전원 공급 계통
D5V / D0V → DriveMCU・센서 모듈・ImageSenderMCU
스텝다운 모델·정격 / 모터 VMOT·드라이버 VDD는 실물 확인 필요
XH60 단자는 사용자 요청에 따라 생략. 5V 전원과 GPIO 신호 전압은 별개.
카메라 PWDN / RESET: GPIO 제어 미사용(-1).
GPS·ToF 기본 꺼짐. 센서 VCC는 모듈 입력 기준 5V 공급 설명 반영.
센서 내부 레귤레이터·I2C 풀업 전압 / 모터 코일·보호회로는 TBD.
