khw1566/ARD/ARD_ESP-IDF/JC1060P470C/main/board.h

#pragma once
// GUITION JC1060P470C (ESP32-P4 + ESP32-C6-MINI-1U, 7" 1024x600 JD9165 MIPI-DSI, GT911).
// Replaces the old HMI/control terminal. DriveMCU stays an independent network board.
//
// Fixed on-board wiring (sources in README):
//   I2C SDA 7 / SCL 8      GT911 (0x5D or 0x14), ES8311, RTC.
//   C6 SDIO CLK 18, CMD 19, D0..D3 14..17, C6 reset 54 (same as ImageSenderMCU_P4).
//   Backlight GPIO23, LCD reset GPIO0 (Kconfig, unverified), speaker amp enable GPIO11.
// Legacy expansion pin constants below are retained for source compatibility;
// the HMI build does not initialize external motors, sensors, buzzer or GPS.
#include "driver/gpio.h"
#include "sdkconfig.h"

#ifdef CONFIG_ARD_ENABLE_TOF
#define ARD_TOF_ENABLED 1
#else
#define ARD_TOF_ENABLED 0
#endif

#define LCD_H_RES 1024
#define LCD_V_RES 600

#define PIN_I2C_SDA GPIO_NUM_7
#define PIN_I2C_SCL GPIO_NUM_8
#define PIN_SPK_AMP_EN GPIO_NUM_11
#define PIN_AUDIO_MCLK ((gpio_num_t)CONFIG_ARD_VOICE_MCLK)
#define PIN_AUDIO_BCLK ((gpio_num_t)CONFIG_ARD_VOICE_BCLK)
#define PIN_AUDIO_WS   ((gpio_num_t)CONFIG_ARD_VOICE_WS)
#define PIN_AUDIO_DOUT ((gpio_num_t)CONFIG_ARD_VOICE_DOUT)
#define PIN_AUDIO_DIN  ((gpio_num_t)CONFIG_ARD_VOICE_DIN)

#define PIN_LCD_RST   ((gpio_num_t)CONFIG_ARD_PIN_LCD_RST)
#define PIN_BACKLIGHT ((gpio_num_t)CONFIG_ARD_PIN_BACKLIGHT)

// A4988 drivers. EN is active LOW.
#define PIN_STEP_X ((gpio_num_t)CONFIG_ARD_PIN_STEP_X)
#define PIN_DIR_X  ((gpio_num_t)CONFIG_ARD_PIN_DIR_X)
#define PIN_STEP_Y ((gpio_num_t)CONFIG_ARD_PIN_STEP_Y)
#define PIN_DIR_Y  ((gpio_num_t)CONFIG_ARD_PIN_DIR_Y)
#define PIN_STEP_Z ((gpio_num_t)CONFIG_ARD_PIN_STEP_Z)
#define PIN_DIR_Z  ((gpio_num_t)CONFIG_ARD_PIN_DIR_Z)
#define PIN_EN_X   ((gpio_num_t)CONFIG_ARD_PIN_EN_X)
#define PIN_EN_Y   ((gpio_num_t)CONFIG_ARD_PIN_EN_Y)
#define PIN_EN_Z   ((gpio_num_t)CONFIG_ARD_PIN_EN_Z)

#define PIN_BUZZER ((gpio_num_t)CONFIG_ARD_PIN_BUZZER)
#define PIN_GPS_RX ((gpio_num_t)CONFIG_ARD_PIN_GPS_RX)
#define PIN_GPS_TX ((gpio_num_t)CONFIG_ARD_PIN_GPS_TX)
#define GPS_BAUD   9600

#define ARD_TCP_COMMAND_PORT 5002
#define ARD_PC_HTTP_PORT     5000
