khw1566/ARD/ARD_ESP-IDF/ImageSenderMCU/main/board_pins.h

#pragma once
// ESP32-S3 N16R8 camera pin map verified on the Arduino firmware
// (ARD_software/ImageSenderMCU/src/main.cpp).
#define CAM_PIN_PWDN -1
#define CAM_PIN_RESET -1
#define CAM_PIN_XCLK 15
#define CAM_PIN_SIOD 4
#define CAM_PIN_SIOC 5

#define CAM_PIN_D7 16
#define CAM_PIN_D6 17
#define CAM_PIN_D5 18
#define CAM_PIN_D4 12
#define CAM_PIN_D3 10
#define CAM_PIN_D2 8
#define CAM_PIN_D1 9
#define CAM_PIN_D0 11
#define CAM_PIN_VSYNC 6
#define CAM_PIN_HREF 7
#define CAM_PIN_PCLK 13

// OV3660's driver has an explicit 16 MHz PLL path. Avoid the previous 18 MHz
// setting while validating capture integrity with Wi-Fi enabled.
#define CAM_XCLK_HZ 16000000
