khw1566/ARD/ARD_ESP-IDF/JC1060P470C/main/sensors.h

#pragma once
// Sensor task: the only user of the external sensors (AHT20, BMP280, VL53L0X) on the shared I2C bus.
// Other tasks read cached snapshots, never the bus.
#include <stdint.h>
#include "esp_err.h"
#include "driver/i2c_master.h"

struct EnvironmentSample {
    float temperature = 0, humidity = 0, pressure = 0;
    bool ahtValid = false, bmpValid = false;
};

esp_err_t sensors_start(i2c_master_bus_handle_t bus);
EnvironmentSample sensors_environment();
bool sensors_tof_ready();
bool sensors_tof(float *mm, uint32_t *ageMs); // false until a valid sample exists
float sensors_tof_last();                     // filtered distance, 0 before the first sample
const char *sensors_tof_status();
void sensors_request_i2c_clock(uint32_t hz);
