khw1566/ARD/ARD_ESP-IDF/JC1060P470C/main/pc_link.cpp

#include "pc_link.h"
#include <stdio.h>
#include <string.h>
#include <time.h>
#include <algorithm>
#include <atomic>
#include <math.h>
#include <cmath>
#include "ard_network.h"
#include "board.h"
#include "onboard_audio.h"
#include "clock_sync.h"
#include "cJSON.h"
#include "driver/jpeg_decode.h"
#include "esp_heap_caps.h"
#include "esp_http_client.h"
#include "esp_log.h"
#include "esp_timer.h"
#include "freertos/FreeRTOS.h"
#include "freertos/queue.h"
#include "freertos/semphr.h"
#include "freertos/task.h"
#include "lwip/inet.h"

static const char *TAG = "pc_link";

namespace {

constexpr uint32_t kPollMs = 3000;       // same cadence as HMI_MCU
constexpr uint32_t kHeartbeatMs = 3000;
// /api/hmi/updates: sorting progress, new camera frames and the live preview.
// It also carries the DriveMCU ToF/rail state, so the idle rate is 2 Hz.
constexpr uint32_t kUpdatesIdleMs = 500, kUpdatesActiveMs = 300;
constexpr size_t kStatusMax = 16384;
constexpr size_t kJpegMax = 512 * 1024;  // HMI_MCU capped at 40 KB; PSRAM allows full frames

struct Outgoing {
    enum Kind : uint8_t { COMMAND, APPROVAL, GUIDANCE, SORTING, RAIL, RESET } kind;
    PcBoard board;
    bool approve;
    char text[96];
    uint32_t queuedMs = 0;
    int value = 0;
};

const char *const kBoardKeys[PC_BOARDS] = {"drivemcu", "robot3axismcu", "imagesendermcu", "controlmcu"};
const char *const kCommandPaths[PC_BOARDS] = {"/api/drivemcu/command", "/api/robot3axis/command",
                                              "/api/imagesendermcu/command", "/api/controlmcu/command"};

SemaphoreHandle_t statusLock, imageLock;
PcStatus status = {};
QueueHandle_t outgoing;
std::atomic<bool> imageRequested{false};
std::atomic<uint32_t> imageSeqSeen{0};
std::atomic<bool> updatesRequested{false}; // poll /api/hmi/updates now (sorting start/stop answered)
PcRequestResult railResult = {};
PcRequestResult sortingResult = {};   // guarded by driveLock (short critical sections)
TaskHandle_t worker;
portMUX_TYPE driveLock = portMUX_INITIALIZER_UNLOCKED;
bool driveArmRequested, driveStopRequested, driveDisarmRequested;
bool driveArmed, driveActive, driveNeutralRequested;
float driveAxes[3] = {};
int driveSpeedPct = 100;
int driveDeadzonePct = 20;
uint32_t driveInputAt, driveGeneration;

jpeg_decoder_handle_t jpeg;
uint8_t *jpegBuffer;            // compressed stream
uint8_t *pixels;                // decoded RGB565
size_t pixelsSize;
PcImage image = {};

uint32_t nowMs() { return (uint32_t)(esp_timer_get_time() / 1000); }

void makeUrl(char *out, size_t size, const char *path) {
    char host[65];
    ard_network_server(host, sizeof(host));
    snprintf(out, size, "http://%s:%d%s", host, ARD_PC_HTTP_PORT, path);
}

// GET/POST helper; reads at most `max` bytes of the body into `body` (NUL-terminated for text).
int http(const char *path, esp_http_client_method_t method, const char *json, int timeoutMs,
         uint8_t *body = nullptr, size_t max = 0, size_t *length = nullptr) {
    if (!ard_network_connected()) return -1;
    char target[128];
    makeUrl(target, sizeof(target), path);
    esp_http_client_config_t config = {};
    config.url = target;
    config.method = method;
    config.timeout_ms = timeoutMs;
    config.disable_auto_redirect = true;
    config.buffer_size = 2048;
    esp_http_client_handle_t client = esp_http_client_init(&config);
    if (!client) return -ESP_ERR_NO_MEM;
    const int sendLength = json ? (int)strlen(json) : 0;
    if (json) esp_http_client_set_header(client, "Content-Type", "application/json");
    int result;
    esp_err_t err = esp_http_client_open(client, sendLength);
    if (err == ESP_OK && sendLength && esp_http_client_write(client, json, sendLength) != sendLength) err = ESP_FAIL;
    if (err == ESP_OK && esp_http_client_fetch_headers(client) < 0) err = ESP_FAIL;
    if (err == ESP_OK) {
        result = esp_http_client_get_status_code(client);
        size_t total = 0;
        if (body && max) {
            for (;;) {
                const int n = esp_http_client_read(client, (char *)body + total, max - 1 - total);
                if (n <= 0) break;
                total += n;
                if (total >= max - 1) { result = -ESP_ERR_INVALID_SIZE; break; }
            }
            body[total] = 0;
        }
        if (length) *length = total;
    } else {
        result = -err;
    }
    esp_http_client_close(client);
    esp_http_client_cleanup(client);
    return result;
}

const char *str(const cJSON *object, const char *key, const char *fallback = "---") {
    const cJSON *item = cJSON_GetObjectItem(object, key);
    return cJSON_IsString(item) ? item->valuestring : fallback;
}

double num(const cJSON *object, const char *key, double fallback = 0) {
    const cJSON *item = cJSON_GetObjectItem(object, key);
    return cJSON_IsNumber(item) ? item->valuedouble : fallback;
}

void wallClock(char *out, size_t size) {
    time_t now = time(nullptr);
    struct tm local;
    localtime_r(&now, &local);
    if (local.tm_year < 120) { strlcpy(out, "--:--:--", size); return; }
    strftime(out, size, "%H:%M:%S", &local);
}

// Same keys HMI_MCU read (HMI_MCU/src/main.cpp TaskNetwork).
void parseStatus(const char *text) {
    cJSON *doc = cJSON_Parse(text);
    if (!doc) return;
    PcStatus next;
    xSemaphoreTake(statusLock, portMAX_DELAY);
    next = status;
    xSemaphoreGive(statusLock);
    char seen[9];
    wallClock(seen, sizeof(seen));
    for (int i = 0; i < PC_BOARDS; ++i) {
        const cJSON *b = cJSON_GetObjectItem(doc, kBoardKeys[i]);
        PcBoardState &s = next.board[i];
        s.online = !strcmp(str(b, "state", ""), "Online");
        s.rssi = (int)num(b, "rssi");
        s.temp = (float)num(b, "temp");
        strlcpy(s.ip, str(b, "ip"), sizeof(s.ip));
        if (s.online) strlcpy(s.lastSeen, seen, sizeof(s.lastSeen));
    }
    const cJSON *robot = cJSON_GetObjectItem(cJSON_GetObjectItem(doc, "robot3axismcu"), "state_data");
    const cJSON *drive = cJSON_GetObjectItem(doc, "drivemcu");
    const cJSON *estimate = cJSON_GetObjectItem(drive, "command_estimate");
    next.driveX = (int32_t)num(estimate, "mx_steps");
    next.driveY = (int32_t)num(estimate, "my_steps");
    next.driveZ = (int32_t)num(estimate, "mz_steps");
    next.drivePid = cJSON_IsTrue(cJSON_GetObjectItem(cJSON_GetObjectItem(doc, "drive_settings"), "pid_mode"));
    next.driveTemp = (float)num(drive, "env_temp", NAN);
    next.driveHumidity = (float)num(drive, "env_humid", NAN);
    next.drivePressure = (float)num(drive, "env_press", NAN);
    next.driveTof = (float)num(drive, "tof_dist");
    next.driveLat = num(drive, "gps_lat");
    next.driveLng = num(drive, "gps_lng");
    next.robotX = (float)num(robot, "x_deg");
    next.robotY = (float)num(robot, "y_mm");
    next.robotZ = (float)num(robot, "z_mm");
    strlcpy(next.robotGrab, str(robot, "grab_state"), sizeof(next.robotGrab));
    next.robotSpeed[0] = (int)num(robot, "x_speed", 100);
    next.robotSpeed[1] = (int)num(robot, "y_speed", 700);
    next.robotSpeed[2] = (int)num(robot, "z_speed", 1000);

    const cJSON *cam = cJSON_GetObjectItem(doc, "imagesendermcu");
    const cJSON *cfg = cJSON_GetObjectItem(cam, "config");
    strlcpy(next.camSensor, str(cfg, "camera_model"), sizeof(next.camSensor));
    strlcpy(next.camRes, str(cfg, "resolution"), sizeof(next.camRes));
    next.camQuality = (int)num(cfg, "jpeg_quality");
    const cJSON *analysis = cJSON_GetObjectItem(cam, "last_analysis");
    strlcpy(next.aiObject, str(analysis, "object", "None"), sizeof(next.aiObject));
    strlcpy(next.aiCategory, str(analysis, "category", "None"), sizeof(next.aiCategory));
    strlcpy(next.aiModel, str(cam, "model_name"), sizeof(next.aiModel));

    // SoundMCU was removed; voice I/O lives on the ESP32-S3 ControlMCU (ARD_MAIN app.py get_status()).
    const cJSON *voice = cJSON_GetObjectItem(doc, "controlmcu");
    strlcpy(next.soundMode, str(voice, "voice_mode"), sizeof(next.soundMode));
    strlcpy(next.soundStatus, str(voice, "status"), sizeof(next.soundStatus));
    strlcpy(next.controlMode, str(voice, "mode"), sizeof(next.controlMode));
    const cJSON *localBoard = cJSON_GetObjectItem(doc, "jc1060");
    const cJSON *localVoice = cJSON_GetObjectItem(localBoard, "voice");
    char localIp[16], configuredServer[65];
    ard_network_local_ip(localIp, sizeof(localIp));
    ard_network_server(configuredServer, sizeof(configuredServer));
    const uint32_t configuredAddress = inet_addr(configuredServer);
    const char *peer = configuredAddress != INADDR_NONE && configuredAddress != INADDR_ANY
        ? configuredServer : str(doc, "server_ip", "");
    const bool thisBoard = localIp[0] && !strcmp(str(localBoard, "ip", ""), localIp);
    onboard_audio_pc_state(thisBoard && cJSON_IsTrue(cJSON_GetObjectItem(localVoice, "selected")),
        strcmp(str(localVoice, "mode", "VAD"), "PTT") != 0,
        cJSON_IsTrue(cJSON_GetObjectItem(localVoice, "busy")),
        (uint32_t)num(localVoice, "completed_job_id"), (uint32_t)num(localVoice, "session"),
        (int)num(localVoice, "volume", 12), (int)num(localVoice, "sensitivity", 2000), peer);

    const cJSON *pending = cJSON_GetObjectItem(cJSON_GetObjectItem(doc, "hmi_mcu"), "pending_action");
    next.approvalPending = cJSON_IsObject(pending);
    if (next.approvalPending) {
        const cJSON *id = cJSON_GetObjectItem(pending, "id");
        if (cJSON_IsNumber(id)) snprintf(next.approvalId, sizeof(next.approvalId), "%.0f", id->valuedouble);
        else strlcpy(next.approvalId, str(pending, "id", ""), sizeof(next.approvalId));
        strlcpy(next.approvalDesc, str(pending, "desc", ""), sizeof(next.approvalDesc));
    }
    next.reachable = true;
    next.updatedMs = nowMs();
    cJSON_Delete(doc);
    xSemaphoreTake(statusLock, portMAX_DELAY);
    status = next;
    xSemaphoreGive(statusLock);
}

void poll(char *buffer) {
    const int code = http("/api/status", HTTP_METHOD_GET, nullptr, 1000, (uint8_t *)buffer, kStatusMax);
    if (code == 200) { parseStatus(buffer); return; }
    xSemaphoreTake(statusLock, portMAX_DELAY);
    status.reachable = false;
    xSemaphoreGive(statusLock);
}

// The panel fonts are ASCII Montserrat; replace other bytes so names never render as boxes.
void asciiCopy(char *out, size_t size, const char *text) {
    size_t n = 0;
    for (; *text && n + 1 < size; ++text) {
        const unsigned char c = (unsigned char)*text;
        if (c >= 0x80 && (c & 0xC0) == 0x80) continue; // UTF-8 continuation byte
        out[n++] = c >= 32 && c < 127 ? (char)c : '?';
    }
    out[n] = 0;
}

// Reuses the status poll's PSRAM buffer (same task) to keep the 6 KB stack free.
// Returns true while something changes quickly (sorting or live preview).
bool pollUpdates(char *buffer) {
    PcSorting next = {};
    cJSON *doc = nullptr;
    int code = http("/api/hmi/updates", HTTP_METHOD_GET, nullptr, 1000, (uint8_t *)buffer, kStatusMax);
    // A PC program from before /api/hmi/updates still reports sorting progress.
    if (code == 404) code = http("/api/sorting/status", HTTP_METHOD_GET, nullptr, 1000, (uint8_t *)buffer, kStatusMax);
    if (code == 200) doc = cJSON_Parse(buffer);
    const cJSON *epoch = cJSON_GetObjectItem(doc, "unix_time");
    if (cJSON_IsNumber(epoch)) clock_sync_from_pc(epoch->valuedouble);
    // A new frame on the PC (capture, sorting, live preview) is fetched right away.
    const cJSON *seq = cJSON_GetObjectItem(doc, "image_seq");
    if (cJSON_IsNumber(seq) && seq->valuedouble > 0) {
        const uint32_t value = (uint32_t)seq->valuedouble;
        if (value != imageSeqSeen.exchange(value)) imageRequested = true;
    }
    const bool streaming = cJSON_IsTrue(cJSON_GetObjectItem(doc, "stream"));
    // A PC program from before the "drive" object leaves the /api/status values in place.
    const cJSON *drive = cJSON_GetObjectItem(doc, "drive");
    const bool driveLive = cJSON_IsTrue(cJSON_GetObjectItem(drive, "live"));
    const cJSON *s = cJSON_GetObjectItem(doc, "sorting");
    if (cJSON_IsObject(s)) {
        next.valid = true;
        next.running = cJSON_IsTrue(cJSON_GetObjectItem(s, "is_running"));
        const cJSON *retry = cJSON_GetObjectItem(s, "retry_ready");
        next.needsReset = !strcmp(str(s, "step", ""), "error") && cJSON_IsBool(retry) && !cJSON_IsTrue(retry);
        next.stepNum = (int)num(s, "step_num");
        next.progress = (int)num(s, "progress");
        strlcpy(next.step, str(s, "step", "idle"), sizeof(next.step));
        strlcpy(next.phase, str(s, "phase", ""), sizeof(next.phase));
        asciiCopy(next.object, sizeof(next.object), str(s, "detected_object", "-"));
        strlcpy(next.material, str(s, "detected_material", "-"), sizeof(next.material));
        strlcpy(next.updated, str(s, "last_updated", ""), sizeof(next.updated));
        next.targetYaw = (float)num(s, "target_yaw");
        next.currentYaw = (float)num(s, "current_yaw");
        next.dumpRoll = (float)num(s, "dump_roll");
        next.currentRoll = (float)num(s, "current_roll");
        next.targetRail = (float)num(s, "target_rail_z");
        next.currentRail = (float)num(s, "current_rail_z");
    }
    char tofStatus[16];
    strlcpy(tofStatus, str(drive, "tof_status", ""), sizeof(tofStatus));
    const cJSON *tof = cJSON_GetObjectItem(drive, "tof_mm");
    const cJSON *pid = cJSON_GetObjectItem(drive, "pid");
    const cJSON *target = cJSON_GetObjectItem(drive, "rail_target");
    const bool settled = cJSON_IsTrue(cJSON_GetObjectItem(drive, "rail_settled"));
    xSemaphoreTake(statusLock, portMAX_DELAY);
    status.sorting = next;
    status.cameraStream = streaming;
    status.driveLive = driveLive;
    status.driveTofOk = driveLive && cJSON_IsTrue(cJSON_GetObjectItem(drive, "tof_ok"));
    status.driveBusy = cJSON_IsTrue(cJSON_GetObjectItem(drive, "busy"));
    const cJSON *rail = cJSON_GetObjectItem(doc, "rail");
    status.railConfigValid = cJSON_IsString(cJSON_GetObjectItem(rail, "mode"));
    if (status.railConfigValid) {
        status.railPidMode = !strcmp(str(rail, "mode", ""), "pid");
        status.railCenter = (int)lround(num(rail, "center_mm", 95));
        status.railPlus = (int)lround(num(rail, "plus_mm", 70));
        status.railMinus = (int)lround(num(rail, "minus_mm", 120));
        status.railCapture = (int)lround(num(rail, "capture_mm", 120));
        status.railCapture = (int)lround(num(rail, "home_mm", status.railCapture)); // sequence origin
        // PID targets stay inside the Z safety limits (ToF mm, default 70..120).
        status.railMin = (int)lround(num(rail, "rail_min_mm", 70));
        status.railMax = (int)lround(num(rail, "rail_max_mm", 120));
        if (status.railMax - status.railMin < 10) { status.railMin = 70; status.railMax = 120; }
    }
    const cJSON *destinations = cJSON_GetObjectItem(rail, "destinations");
    status.destValid = cJSON_IsObject(destinations);
    if (status.destValid) {
        static const char *const kCategories[5] = {"Metal", "Glass", "Others", "Paper", "Plastic"};
        for (int i = 0; i < 5; ++i) {
            const cJSON *d = cJSON_GetObjectItem(destinations, kCategories[i]);
            const char *slot = str(d, "rail", "center");
            status.destRail[i] = !strcmp(slot, "plus") ? 1 : !strcmp(slot, "minus") ? -1 : 0;
            status.destTilt[i] = !strcmp(str(d, "tilt", "forward"), "backward") ? -1 : 1;
        }
    }
    status.railGainsValid = driveLive && cJSON_IsNumber(cJSON_GetObjectItem(drive, "pid_p")) &&
        cJSON_IsNumber(cJSON_GetObjectItem(drive, "pid_i")) && cJSON_IsNumber(cJSON_GetObjectItem(drive, "pid_d"));
    if (status.railGainsValid) {
        status.railP = (float)num(drive, "pid_p");
        status.railI = (float)num(drive, "pid_i");
        status.railD = (float)num(drive, "pid_d");
    }
    if (driveLive) {
        if (cJSON_IsNumber(tof)) status.driveTof = (float)tof->valuedouble;
        if (cJSON_IsBool(pid)) status.drivePid = cJSON_IsTrue(pid);
        if (cJSON_IsNumber(target)) status.driveRailTarget = (int)lround(target->valuedouble);
        status.driveRailSettled = settled;
        strlcpy(status.driveTofStatus, tofStatus, sizeof(status.driveTofStatus));
    }
    xSemaphoreGive(statusLock);
    cJSON_Delete(doc);
    return (next.valid && next.running) || streaming;
}

void heartbeat() {
    char ip[16], body[256];
    ard_network_local_ip(ip, sizeof(ip));
    const auto audio = onboard_audio_status();
    snprintf(body, sizeof(body), "{\"source\":\"HMI_MCU\",\"rssi\":%d,\"ip\":\"%s\",\"board\":\"JC1060P470C\","
             "\"audio_ready\":%s,\"mic_ready\":%s,\"audio_packets\":%lu,\"mic_peak\":%d,\"guidance\":%s}",
             ard_network_rssi(), ip, audio.ready ? "true" : "false", audio.ready ? "true" : "false",
             (unsigned long)audio.rxPackets, audio.peak, audio.guidance ? "true" : "false");
    http("/api/heartbeat", HTTP_METHOD_POST, body, 500);
}

void send(const Outgoing &item) {
    // Do not replay stale motor clicks after a JPEG fetch or network outage.
    if ((item.kind == Outgoing::COMMAND || item.kind == Outgoing::RAIL) && item.board == PC_DRIVE && nowMs() - item.queuedMs > 500) {
        if (item.kind == Outgoing::RAIL) {
            portENTER_CRITICAL(&driveLock);
            railResult.code = 408; ++railResult.sequence;
            portEXIT_CRITICAL(&driveLock);
        }
        return;
    }
    cJSON *doc = cJSON_CreateObject();
    const char *path;
    if (item.kind == Outgoing::APPROVAL) {
        cJSON_AddStringToObject(doc, "id", item.text);
        cJSON_AddBoolToObject(doc, "approve", item.approve);
        path = "/api/hmi/approve";
    } else if (item.kind == Outgoing::GUIDANCE) {
        cJSON_AddStringToObject(doc, "cue", item.text);
        path = "/api/jc1060/guidance";
    } else if (item.kind == Outgoing::RAIL) {
        path = "/api/jc1060/rail";
        const bool mode = !strcmp(item.text, "pid") || !strcmp(item.text, "open_loop");
        cJSON_AddStringToObject(doc, "op", mode ? "mode" : item.text);
        if (mode) cJSON_AddStringToObject(doc, "mode", item.text);
        else if (!strcmp(item.text, "target")) cJSON_AddNumberToObject(doc, "mm", item.value);
        else if (!strcmp(item.text, "step")) cJSON_AddNumberToObject(doc, "steps", item.value);
    } else if (item.kind == Outgoing::RESET) {
        path = "/api/sorting/reset";
    } else if (item.kind == Outgoing::SORTING) {
        path = item.approve ? "/api/sorting/start" : "/api/sorting/cancel"; // gear ratios: PC settings
    } else {
        cJSON_AddStringToObject(doc, "command", item.text);
        path = kCommandPaths[item.board];
    }
    char *json = cJSON_PrintUnformatted(doc);
    cJSON_Delete(doc);
    if (!json) return;
    const int code = http(path, HTTP_METHOD_POST, json,
        (item.kind == Outgoing::COMMAND || item.kind == Outgoing::RAIL) && item.board == PC_DRIVE ? 6500 : item.kind == Outgoing::SORTING ? 3000 : 1000);
    if (code != 200 && code != 202) ESP_LOGW(TAG, "POST %s -> %d", path, code);
    if (item.kind == Outgoing::SORTING || item.kind == Outgoing::RESET) {
        portENTER_CRITICAL(&driveLock);
        sortingResult.code = code;
        sortingResult.start = item.approve;
        sortingResult.reset = item.kind == Outgoing::RESET;
        ++sortingResult.sequence;
        portEXIT_CRITICAL(&driveLock);
        updatesRequested = true; // show the PC's new state without waiting for the idle poll
    }
    if (item.kind == Outgoing::RAIL) {
        portENTER_CRITICAL(&driveLock);
        railResult.code = code; ++railResult.sequence;
        portEXIT_CRITICAL(&driveLock);
        updatesRequested = true;
    }
    cJSON_free(json);
}

void setImageError(const char *message) {
    xSemaphoreTake(imageLock, portMAX_DELAY);
    strlcpy(image.error, message, sizeof(image.error));
    image.sequence++;
    xSemaphoreGive(imageLock);
}

// /api/hmi/last_image -> hardware JPEG decoder (ESP32-P4) -> RGB565 for the Cam tab.
void fetchImage() {
    size_t length = 0;
    // 640x448 for this screen; the legacy 240x320 HMI keeps the small default.
    const int code = http("/api/hmi/last_image?size=large", HTTP_METHOD_GET, nullptr, 3000, jpegBuffer, kJpegMax, &length);
    char message[40];
    if (code != 200 || !length) { snprintf(message, sizeof(message), "HTTP error %d", code); setImageError(message); return; }
    jpeg_decode_picture_info_t info;
    if (jpeg_decoder_get_info(jpegBuffer, length, &info) != ESP_OK) { setImageError("Not a JPEG"); return; }
    // The decoder writes whole 16x16 MCUs.
    const uint32_t width = (info.width + 15) & ~15u, height = (info.height + 15) & ~15u;
    const size_t needed = width * height * 2;
    xSemaphoreTake(imageLock, portMAX_DELAY);
    if (needed > pixelsSize) {
        if (pixels) heap_caps_free(pixels);
        jpeg_decode_memory_alloc_cfg_t memory = {};
        memory.buffer_direction = JPEG_DEC_ALLOC_OUTPUT_BUFFER;
        size_t allocated = 0;
        pixels = (uint8_t *)jpeg_alloc_decoder_mem(needed, &memory, &allocated);
        pixelsSize = pixels ? allocated : 0;
    }
    esp_err_t err = ESP_ERR_NO_MEM;
    uint32_t out = 0;
    if (pixels) {
        jpeg_decode_cfg_t cfg = {};
        cfg.output_format = JPEG_DECODE_OUT_FORMAT_RGB565;
        cfg.rgb_order = JPEG_DEC_RGB_ELEMENT_ORDER_BGR; // little-endian RGB565, as LVGL expects
        err = jpeg_decoder_process(jpeg, &cfg, jpegBuffer, length, pixels, pixelsSize, &out);
    }
    if (err == ESP_OK) {
        image.pixels = pixels;
        image.width = (uint16_t)info.width;   // show the picture, not the MCU padding
        image.height = (uint16_t)info.height;
        image.stride = (uint16_t)width;
        image.error[0] = 0;
    } else {
        image.pixels = nullptr;
        snprintf(image.error, sizeof(image.error), "Decode error: %s", esp_err_to_name(err));
    }
    image.sequence++;
    xSemaphoreGive(imageLock);
    ESP_LOGI(TAG, "Image %ux%u (%u bytes JPEG): %s", (unsigned)info.width, (unsigned)info.height,
             (unsigned)length, esp_err_to_name(err));
}

void linkTask(void *) {
    char *buffer = (char *)heap_caps_malloc(kStatusMax, MALLOC_CAP_SPIRAM);
    uint32_t lastPoll = 0, lastHeartbeat = 0, lastUpdates = 0;
    bool fast = false;
    for (;;) {
        Outgoing item;
        // Commands and approvals first: they are what the operator is waiting on.
        for (unsigned burst = 0; burst < 4 && xQueueReceive(outgoing, &item, 0) == pdTRUE; ++burst) send(item);
        if (imageRequested.exchange(false)) fetchImage();
        const uint32_t now = nowMs();
        if (ard_network_connected()) {
            if (buffer && now - lastPoll >= kPollMs) { lastPoll = now; poll(buffer); }
            if (now - lastHeartbeat >= kHeartbeatMs) { lastHeartbeat = now; heartbeat(); }
            // Small endpoint; poll fast while sorting or the live preview runs.
            if (buffer && (updatesRequested.exchange(false) ||
                           now - lastUpdates >= (fast ? kUpdatesActiveMs : kUpdatesIdleMs))) {
                lastUpdates = now;
                fast = pollUpdates(buffer);
            }
        }
        if (xQueuePeek(outgoing, &item, pdMS_TO_TICKS(50)) == pdTRUE) vTaskDelay(1);
    }
}

// Stop and arm have their own path, independent of the general command queue,
// JPEG downloads and status polling.
void driveTask(void *) {
    uint32_t lastPulse = 0, lastAutoArm = 0;
    for (;;) {
        vTaskDelay(pdMS_TO_TICKS(25));
        bool arm, stop, disarm, neutral, pulse;
        float axes[3];
        int speed, deadzone;
        uint32_t generation;
        portENTER_CRITICAL(&driveLock);
        arm = driveArmRequested; stop = driveStopRequested;
        disarm = driveDisarmRequested;
        driveArmRequested = driveStopRequested = driveDisarmRequested = false;
        // No event updates for 250 ms: cease new pulses and send neutral.
        if (driveActive && nowMs() - driveInputAt >= 250) {
            driveActive = false;
            driveNeutralRequested = true;
        }
        neutral = driveNeutralRequested;
        driveNeutralRequested = false;
        // Touching the stick re-arms on its own (also after E-STOP); a refused arm retries once a second.
        if (!driveArmed && driveActive && !arm && !stop && !disarm && nowMs() - lastAutoArm >= 1000) {
            arm = true;
            lastAutoArm = nowMs();
        }
        pulse = driveArmed && driveActive && nowMs() - lastPulse >= 100;
        memcpy(axes, driveAxes, sizeof(axes));
        speed = driveSpeedPct;
        deadzone = driveDeadzonePct;
        generation = driveGeneration;
        portEXIT_CRITICAL(&driveLock);
        if (!stop && !disarm && !arm && !neutral && !pulse) continue;
        const auto pc = pc_status();
        if (pulse && (!pc.reachable || nowMs() - pc.updatedMs > 6000 ||
                      !pc.board[PC_DRIVE].online || pc.sorting.running ||
                      !ard_network_connected())) {
            pc_drive_disarm();
            continue;
        }
        char body[160];
        if (stop) snprintf(body, sizeof(body), "{\"op\":\"stop\"}");
        else if (disarm) snprintf(body, sizeof(body), "{\"op\":\"disarm\"}");
        else if (arm) snprintf(body, sizeof(body), "{\"op\":\"arm\"}");
        else if (neutral) snprintf(body, sizeof(body), "{\"op\":\"pulse\",\"x\":0,\"y\":0,\"z\":0}");
        else {
            lastPulse = nowMs();
            // speed_pct scales the DriveMCU jog velocity. interval_ms is the same
            // setting for a PC that still paces finite pulses.
            const int interval = std::min(1000, std::max(100, (10000 + speed / 2) / speed));
            snprintf(body, sizeof(body), "{\"op\":\"joystick\",\"x\":%.3f,\"y\":%.3f,\"z\":%.3f,\"speed_pct\":%d,\"interval_ms\":%d,\"deadzone_pct\":%d}",
                     axes[0], axes[1], axes[2], speed, interval, deadzone);
        }
        char reply[128];
        const int code = http("/api/jc1060/drive", HTTP_METHOD_POST, body, 500, (uint8_t *)reply, sizeof(reply));
        cJSON *result = (code == 200 || code == 202) ? cJSON_Parse(reply) : nullptr;
        const bool armed = arm && !stop && !disarm && !strcmp(str(result, "status", ""), "armed");
        cJSON_Delete(result);
        portENTER_CRITICAL(&driveLock);
        if (generation == driveGeneration) {
            if (arm) driveArmed = armed;
            if (stop || disarm || (code != 200 && code != 202)) {
                driveArmed = false;
                driveActive = false;
                driveNeutralRequested = false;
                // A failed in-flight pulse may have been accepted. Ask to stop
                // once on the independent path; never replay the pulse.
                if (pulse && !stop && !disarm && !arm && !neutral) driveDisarmRequested = true;
            }
        }
        portEXIT_CRITICAL(&driveLock);
        if (code != 200 && code != 202) ESP_LOGW(TAG, "Drive control -> %d (disarmed)", code);
    }
}

} // namespace

esp_err_t pc_link_start() {
    statusLock = xSemaphoreCreateMutex();
    imageLock = xSemaphoreCreateMutex();
    outgoing = xQueueCreate(8, sizeof(Outgoing));
    jpeg_decode_memory_alloc_cfg_t input = {};
    input.buffer_direction = JPEG_DEC_ALLOC_INPUT_BUFFER; // DMA-aligned, as the decoder requires
    size_t allocated = 0;
    jpegBuffer = (uint8_t *)jpeg_alloc_decoder_mem(kJpegMax, &input, &allocated);
    if (!statusLock || !imageLock || !outgoing || !jpegBuffer) return ESP_ERR_NO_MEM;
    strlcpy(image.error, "No image yet", sizeof(image.error));
    jpeg_decode_engine_cfg_t engine = {};
    engine.timeout_ms = 200;
    esp_err_t err = jpeg_new_decoder_engine(&engine, &jpeg);
    if (err != ESP_OK) return err;
    if (xTaskCreatePinnedToCore(driveTask, "drive_control", 6144, nullptr, 4, nullptr, 0) != pdPASS) return ESP_ERR_NO_MEM;
    return xTaskCreatePinnedToCore(linkTask, "pc_link", 6144, nullptr, 3, &worker, 0) == pdPASS ? ESP_OK : ESP_ERR_NO_MEM;
}

PcStatus pc_status() {
    PcStatus copy = {};
    if (statusLock && xSemaphoreTake(statusLock, pdMS_TO_TICKS(20)) == pdTRUE) {
        copy = status;
        xSemaphoreGive(statusLock);
    }
    return copy;
}

bool pc_send_command(PcBoard board, const char *command) {
    if (board == PC_DRIVE) {
        // Ordinary touch clicks hand over to the PC route. Do not race a late
        // stop request against that newly issued move. E-stop has its own path
        // even if the general command queue is full.
        const bool stop = !strcmp(command, "x") || !strcmp(command, "stop") ||
                          !strcmp(command, "d") || !strcmp(command, "disable");
        if (stop) pc_drive_stop();
        else {
            portENTER_CRITICAL(&driveLock);
            ++driveGeneration;
            driveArmed = driveActive = driveNeutralRequested = false;
            driveArmRequested = false;
            portEXIT_CRITICAL(&driveLock);
        }
    }
    Outgoing item = {Outgoing::COMMAND, board, false, {}};
    item.queuedMs = nowMs();
    strlcpy(item.text, command, sizeof(item.text));
    return outgoing && xQueueSend(outgoing, &item, 0) == pdTRUE;
}

void pc_drive_arm() {
    portENTER_CRITICAL(&driveLock);
    ++driveGeneration;
    driveArmed = driveActive = false;
    driveArmRequested = true;
    portEXIT_CRITICAL(&driveLock);
}

void pc_drive_stop() {
    portENTER_CRITICAL(&driveLock);
    ++driveGeneration;
    driveArmed = driveActive = driveNeutralRequested = false;
    driveArmRequested = false;
    driveDisarmRequested = false;
    driveStopRequested = true;
    portEXIT_CRITICAL(&driveLock);
}

void pc_drive_disarm() {
    portENTER_CRITICAL(&driveLock);
    ++driveGeneration;
    driveArmed = driveActive = driveNeutralRequested = false;
    driveArmRequested = false;
    driveDisarmRequested = true;
    portEXIT_CRITICAL(&driveLock);
}

bool pc_drive_is_armed() {
    portENTER_CRITICAL(&driveLock);
    const bool armed = driveArmed;
    portEXIT_CRITICAL(&driveLock);
    return armed;
}

bool pc_drive_joystick(float x, float y, float z, int speedPct, int deadzonePct) {
    if (!std::isfinite(x) || !std::isfinite(y) || !std::isfinite(z) || fabsf(x) > 1 || fabsf(y) > 1 ||
        fabsf(z) > 1 || speedPct < 10 || speedPct > 100 || deadzonePct < 5 || deadzonePct > 30) return false;
    if (std::hypot(x, y) <= deadzonePct / 100.0f) x = y = 0;
    portENTER_CRITICAL(&driveLock);
    const bool armed = driveArmed;
    // Input is kept while disarmed: the drive task arms first, then streams it.
    driveAxes[0] = x; driveAxes[1] = y; driveAxes[2] = z;
    driveSpeedPct = speedPct;
    driveDeadzonePct = deadzonePct;
    driveInputAt = nowMs();
    if (armed && driveActive && x == 0 && y == 0 && z == 0) driveNeutralRequested = true;
    driveActive = x != 0 || y != 0 || z != 0;
    portEXIT_CRITICAL(&driveLock);
    return armed;
}

void pc_drive_neutral() {
    portENTER_CRITICAL(&driveLock);
    if (driveActive) driveNeutralRequested = true;
    driveActive = false;
    memset(driveAxes, 0, sizeof(driveAxes));
    portEXIT_CRITICAL(&driveLock);
}

bool pc_send_guidance(const char *cue) {
    Outgoing item = {Outgoing::GUIDANCE, PC_SOUND, false, {}};
    strlcpy(item.text, cue, sizeof(item.text));
    if (!outgoing) return false;
    return (!strcmp(cue, "emergency") ? xQueueSendToFront(outgoing, &item, 0)
                                      : xQueueSend(outgoing, &item, 0)) == pdTRUE;
}

void pc_send_approval(const char *id, bool approve) {
    Outgoing item = {Outgoing::APPROVAL, PC_DRIVE, approve, {}};
    strlcpy(item.text, id, sizeof(item.text));
    if (outgoing) xQueueSend(outgoing, &item, 0);
    xSemaphoreTake(statusLock, portMAX_DELAY);
    status.approvalPending = false; // hide the popup until the next poll says otherwise
    xSemaphoreGive(statusLock);
}

void pc_request_image() { imageRequested = true; }

bool pc_sorting_request(bool start) {
    Outgoing item = {Outgoing::SORTING, PC_DRIVE, start, {}};
    // Cancel goes first so it is not stuck behind queued commands.
    return outgoing && (start ? xQueueSend(outgoing, &item, 0) : xQueueSendToFront(outgoing, &item, 0)) == pdTRUE;
}

PcRequestResult pc_sorting_result() {
    portENTER_CRITICAL(&driveLock);
    const PcRequestResult result = sortingResult;
    portEXIT_CRITICAL(&driveLock);
    return result;
}

bool pc_sorting_reset() {
    if (!outgoing || !pc_status().reachable) return false;
    Outgoing item = {Outgoing::RESET, PC_DRIVE, false, {}};
    item.queuedMs = nowMs();
    return xQueueSend(outgoing, &item, 0) == pdTRUE;
}

bool pc_image_lock(PcImage *out, uint32_t timeoutMs) {
    if (!imageLock || xSemaphoreTake(imageLock, pdMS_TO_TICKS(timeoutMs)) != pdTRUE) return false;
    *out = image;
    return true;
}

void pc_image_unlock() { xSemaphoreGive(imageLock); }

bool pc_rail_request(const char *op, int value) {
    const auto pc = pc_status();
    if (!op || !outgoing || !pc.reachable || !pc.board[PC_DRIVE].online || !pc.driveLive || !pc.railConfigValid || pc.sorting.running) return false;
    if (strcmp(op, "pid") && strcmp(op, "open_loop") && strcmp(op, "target") && strcmp(op, "step") && strcmp(op, "stop")) return false;
    // Invalidate manual gesture input locally before giving the PC ownership.
    // Do not enqueue a late disarm/stop that could cancel the new PID move.
    portENTER_CRITICAL(&driveLock);
    ++driveGeneration;
    driveArmed = driveActive = driveNeutralRequested = driveArmRequested = driveDisarmRequested = false;
    portEXIT_CRITICAL(&driveLock);
    Outgoing item = {Outgoing::RAIL, PC_DRIVE, false, {}};
    strlcpy(item.text, op, sizeof(item.text));
    item.value = value;
    item.queuedMs = nowMs();
    return xQueueSend(outgoing, &item, 0) == pdTRUE;
}

PcRequestResult pc_rail_result() {
    portENTER_CRITICAL(&driveLock);
    const PcRequestResult result = railResult;
    portEXIT_CRITICAL(&driveLock);
    return result;
}
