khw1566/ARD/ARD_ESP-IDF/JC1060P470C/main/panel_init.c

// JD9165 init tables for the two JC1060P470C panel revisions (C file: compound literals).
#include "panel_init.h"
#include "board.h"
#include "esp_lcd_panel_commands.h"

// ---- Panel init tables -------------------------------------------------------------------
// Taken from ESPHome esphome/components/mipi_dsi/models/guition.py (JC1060P470 / -V2), which
// cites Guition's JC1060P470C_I_W_Y reference driver. Not verified on our board.
// ESPHome appends COLMOD and INVOFF outside the vendor table. The JD9165 2.0.2
// component does not set COLMOD from dev.bits_per_pixel, so send them explicitly
// on page 0 after SLPOUT, before DISPON, to match our RGB565 DSI stream.
#define C(cmd, ...) {cmd, (const uint8_t[]){__VA_ARGS__}, sizeof((const uint8_t[]){__VA_ARGS__}), 0}
#define CD(cmd, ms, ...) {cmd, (const uint8_t[]){__VA_ARGS__}, sizeof((const uint8_t[]){__VA_ARGS__}), ms}

#if CONFIG_ARD_PANEL_V2
// V2 timing: 52 MHz, HBP 136 / HS 24 / HFP 160, VBP 21 / VS 2 / VFP 12.
const esp_lcd_video_timing_t ard_panel_timing = {LCD_H_RES, LCD_V_RES, 24, 136, 160, 2, 21, 12};
const float ard_panel_pclk_mhz = 52;
const jd9165_lcd_init_cmd_t ard_panel_init[] = {
    C(0x30, 0x00), C(0xF7, 0x49, 0x61, 0x02, 0x00), C(0x30, 0x01), C(0x04, 0x0C), C(0x05, 0x08), C(0x0B, 0x11),
    C(0x20, 0x04), C(0x1F, 0x05), C(0x23, 0x38), C(0x28, 0x18), C(0x29, 0x29), C(0x2A, 0x01), C(0x2B, 0x29),
    C(0x2C, 0x01), C(0x30, 0x02), C(0x00, 0x05), C(0x01, 0x22), C(0x02, 0x08), C(0x03, 0x12), C(0x04, 0x16),
    C(0x05, 0x64), C(0x06, 0x00), C(0x07, 0x00), C(0x08, 0x78), C(0x09, 0x00), C(0x0A, 0x04),
    C(0x0B, 0x16, 0x17, 0x0B, 0x0D, 0x0D, 0x0D, 0x11, 0x10, 0x07, 0x07, 0x09),
    C(0x0C, 0x09, 0x1E, 0x1E, 0x1C, 0x1C, 0x0D, 0x0D, 0x0D, 0x0D, 0x0D, 0x0D),
    C(0x0D, 0x0A, 0x05, 0x0B, 0x0D, 0x0D, 0x0D, 0x11, 0x10, 0x06, 0x06, 0x08),
    C(0x0E, 0x08, 0x1F, 0x1F, 0x1D, 0x1D, 0x0D, 0x0D, 0x0D, 0x0D, 0x0D, 0x0D),
    C(0x0F, 0x0A, 0x05, 0x0D, 0x0B, 0x0D, 0x0D, 0x11, 0x10, 0x1D, 0x1D, 0x1F),
    C(0x10, 0x1F, 0x08, 0x08, 0x06, 0x06, 0x0D, 0x0D, 0x0D, 0x0D, 0x0D, 0x0D),
    C(0x11, 0x16, 0x17, 0x0D, 0x0B, 0x0D, 0x0D, 0x11, 0x10, 0x1C, 0x1C, 0x1E),
    C(0x12, 0x1E, 0x09, 0x09, 0x07, 0x07, 0x0D, 0x0D, 0x0D, 0x0D, 0x0D, 0x0D),
    C(0x13, 0x00, 0x00, 0x00, 0x00), C(0x14, 0x00, 0x00, 0x41, 0x41), C(0x15, 0x00, 0x00, 0x00, 0x00),
    C(0x17, 0x00), C(0x18, 0x85), C(0x19, 0x06, 0x09), C(0x1A, 0x05, 0x08), C(0x1B, 0x0A, 0x04), C(0x26, 0x00),
    C(0x27, 0x00), C(0x30, 0x06),
    C(0x12, 0x3F, 0x25, 0x27, 0x35, 0x1D, 0x1B, 0x1B, 0x1A, 0x18, 0x0A, 0x2A, 0x21, 0x19, 0x30),
    C(0x13, 0x3F, 0x26, 0x27, 0x35, 0x1E, 0x1C, 0x1C, 0x1A, 0x18, 0x0B, 0x2A, 0x21, 0x19, 0x30),
    C(0x30, 0x0A), C(0x02, 0x4F), C(0x0B, 0x40), C(0x30, 0x0D), C(0x0D, 0x04), C(0x10, 0x05), C(0x11, 0x0C),
    C(0x12, 0x05), C(0x13, 0x0C), C(0x30, 0x00),
    {0x11, NULL, 0, 120}, // SLPOUT
    C(LCD_CMD_COLMOD, 0x55), // RGB565 (16-bit), matching LVGL and DPI
    {LCD_CMD_INVOFF, NULL, 0, 0},
    {0x29, NULL, 0, 20},  // DISPON
};
#else
// V1 timing: 54 MHz, HBP 160 / HS 40 / HFP 160, VBP 23 / VS 10 / VFP 12.
const esp_lcd_video_timing_t ard_panel_timing = {LCD_H_RES, LCD_V_RES, 40, 160, 160, 10, 23, 12};
const float ard_panel_pclk_mhz = 54;
const jd9165_lcd_init_cmd_t ard_panel_init[] = {
    C(0x30, 0x00), C(0xF7, 0x49, 0x61, 0x02, 0x00), C(0x30, 0x01), C(0x04, 0x0C), C(0x05, 0x00), C(0x06, 0x00),
    C(0x0B, 0x11), C(0x17, 0x00), C(0x20, 0x04), C(0x1F, 0x05), C(0x23, 0x00), C(0x25, 0x19), C(0x28, 0x18),
    C(0x29, 0x04), C(0x2A, 0x01), C(0x2B, 0x04), C(0x2C, 0x01), C(0x30, 0x02), C(0x01, 0x22), C(0x03, 0x12),
    C(0x04, 0x00), C(0x05, 0x64), C(0x0A, 0x08),
    C(0x0B, 0x0A, 0x1A, 0x0B, 0x0D, 0x0D, 0x11, 0x10, 0x06, 0x08, 0x1F, 0x1D),
    C(0x0C, 0x0D, 0x0D, 0x0D, 0x0D, 0x0D, 0x0D, 0x0D, 0x0D, 0x0D, 0x0D, 0x0D),
    C(0x0D, 0x16, 0x1B, 0x0B, 0x0D, 0x0D, 0x11, 0x10, 0x07, 0x09, 0x1E, 0x1C),
    C(0x0E, 0x0D, 0x0D, 0x0D, 0x0D, 0x0D, 0x0D, 0x0D, 0x0D, 0x0D, 0x0D, 0x0D),
    C(0x0F, 0x16, 0x1B, 0x0D, 0x0B, 0x0D, 0x11, 0x10, 0x1C, 0x1E, 0x09, 0x07),
    C(0x10, 0x0D, 0x0D, 0x0D, 0x0D, 0x0D, 0x0D, 0x0D, 0x0D, 0x0D, 0x0D, 0x0D),
    C(0x11, 0x0A, 0x1A, 0x0D, 0x0B, 0x0D, 0x11, 0x10, 0x1D, 0x1F, 0x08, 0x06),
    C(0x12, 0x0D, 0x0D, 0x0D, 0x0D, 0x0D, 0x0D, 0x0D, 0x0D, 0x0D, 0x0D, 0x0D),
    C(0x14, 0x00, 0x00, 0x11, 0x11), C(0x18, 0x99), C(0x30, 0x06),
    C(0x12, 0x36, 0x2C, 0x2E, 0x3C, 0x38, 0x35, 0x35, 0x32, 0x2E, 0x1D, 0x2B, 0x21, 0x16, 0x29),
    C(0x13, 0x36, 0x2C, 0x2E, 0x3C, 0x38, 0x35, 0x35, 0x32, 0x2E, 0x1D, 0x2B, 0x21, 0x16, 0x29),
    C(0x30, 0x0A), C(0x02, 0x4F), C(0x0B, 0x40), C(0x12, 0x3E), C(0x13, 0x78), C(0x30, 0x0D), C(0x0D, 0x04),
    C(0x10, 0x0C), C(0x11, 0x0C), C(0x12, 0x0C), C(0x13, 0x0C), C(0x30, 0x00),
    {0x11, NULL, 0, 120}, // SLPOUT
    C(LCD_CMD_COLMOD, 0x55), // RGB565 (16-bit), matching LVGL and DPI
    {LCD_CMD_INVOFF, NULL, 0, 0},
    {0x29, NULL, 0, 20},  // DISPON
};
#endif
const size_t ard_panel_init_count = sizeof(ard_panel_init) / sizeof(ard_panel_init[0]);
#if CONFIG_ARD_PANEL_V2
const char *const ard_panel_name = "V2";
#else
const char *const ard_panel_name = "V1";
#endif
