khw1566/ARD/(commit log)

2026-10-17 chore: add ARD_v1 workspace (ESP-IDF ports, ARD_MAIN, CAD)
    First snapshot of the ARD_v1 folder as of 2026-10-17: the ESP-IDF 5.5
    firmware ports (ControlMCU, DriveMCU, HMI_MCU, ImageSenderMCU,
    JC1060P470C), the ARD_MAIN PC server, Inventor CAD models and reports.
    The old PlatformIO code (ARD_software) stays on branch main.
    Left out: build output, managed_components, .env, media downloads,
    Inventor simulation caches (AIP) and OldVersions backups. ARD_MAIN
    backend/app.py and config/config_manager.py are held back because they
    contain hard-coded API keys.
2026-10-22 Restore PC server, preserve ESP-IDF provisioning work, and audit CAD completeness
2026-10-24 fix: correct dashboard layout and disk rotation visualization
    Remove the dashboard accuracy benchmark, keep disk spin independent of tilt and rail motion, and add rotation direction and angle indicators. Include responsive display assets and regression coverage.
2026-10-24 feat(jc1060): integrate display settings and shared Wi-Fi provisioning
    Keep the working V2 panel initialization, synchronous full-frame redraw,
    brightness persistence, and Display/Network settings UI. Preserve upstream QR
    setup and 16 successful Wi-Fi profiles while serializing live touch operations
    and tracking the correct active profile.
    Document OldVersions cleanup and relocation of the legacy checkout to ETC,
    preserving its Git metadata and local edits. Keep the existing main branch.
    Validation: 11 Wi-Fi C host fixtures, 29 PC Python tests, and 3 JavaScript
    regression suites passed. Target firmware rebuild and hardware retest after
    integration were not run.
2026-10-25 feat: integrate JC1060 terminal and ARD control improvements
    - Add selectable control/voice boards and optional three-axis robot visibility.
    - Port onboard JC1060 microphone, speaker and guidance; retain independent DriveMCU control from PC and HMI.
    - Add acknowledged DriveMCU command delivery and bounded remote gamepad input.
    - Add persistent drag resizing for the dashboard log and correct the 3D drive/bevel model.
    - Integrate shared Wi-Fi setup/recovery changes and camera capture/diagnostic improvements.
    - Record implementation reports, regression tests and simulated model captures.
    Validation: 91 Python tests, dashboard/delivery/simulation/sorting/portal JS
    checks, real Three.js geometry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
2026-10-25 feat(jc1060): fix Wi-Fi, add Korean UI, sorting controls and live camera
    Wi-Fi and co-processor
    - Run station-only; the setup AP (APSTA) blocked DHCP through ESP-Hosted.
    The AP starts only without a saved Wi-Fi or after 90 s offline, and the
    shared worker pauses station attempts while it runs.
    - Quick rescans after boot instead of waiting 15 s for the next scan.
    - Update an older ESP32-C6 to ESP-Hosted 2.12.2 over SDIO (embedded image).
    - PC server IP editable live (Settings > Server, serial server=<IP>).
    Display and UI
    - Remove the boot color-bar diagnostic; render into two DPI framebuffers
    swapped at frame end (no copy into the visible buffer).
    - Main tab replaces Robot: live sortin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
2026-10-25 feat(pc): faster startup, setup/run split, live camera and HMI updates
    - setup_pc.bat installs dependencies once; run_pc.bat starts the server and
    runs setup only when requirements.txt changes. netstat replaces the slow
    PowerShell port check and the fixed 2 s wait.
    - Whisper, Gemini, OpenAI, SciPy and yt_dlp import on first use and warm up
    in the background; the dashboard is ready in about 1.6 s on this PC.
    - Live camera stream driven by the PC (ImageSender only does single
    captures); stream frames skip the AI; analyze maps to capture.
    - JC1060 image (up to 640x448), image sequence and /api/hmi/updates.
    - Sorting publishes the motion phase for remote animation.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
2026-10-26 chore: preserve ARD work and add agent migration handoff
    Document CG requirements, kinematic assumptions, pending issues and portable preview setup. Preserve current JC1060, PC, CAD and reference media changes while excluding private settings, caches and regenerable CG output. Vendor the existing Three.js dependency with its license. Include latest JC1060 sources; retain exclusion of older build binaries.
2026-10-26 feat: sync ARD controls, JC1060 visitor mode and CG/CAD assets
2026-10-30 docs: introduce ARD with presentation, schematics and CAD models
